sparkfun/3D_Models/production_parts/modules/Teensy-3_2/Renderings/Teensy_3_1 v12.png

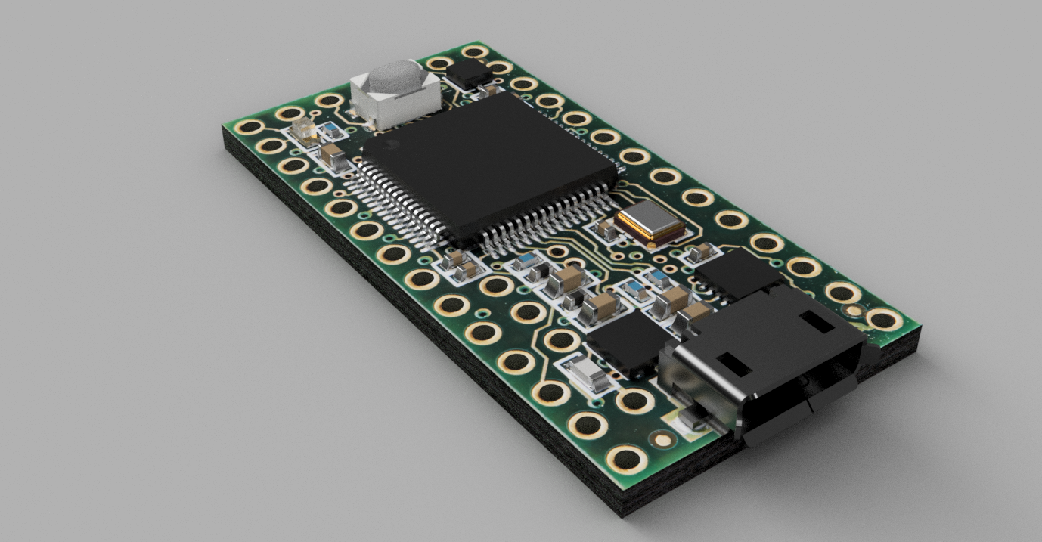
production_parts/modules/Teensy-3_2/Renderings/Teensy_3_1 v12.png
