sparkfun/3D_Models/production_parts/modules/Teensy-3_2/Teensy_3_1v13.png

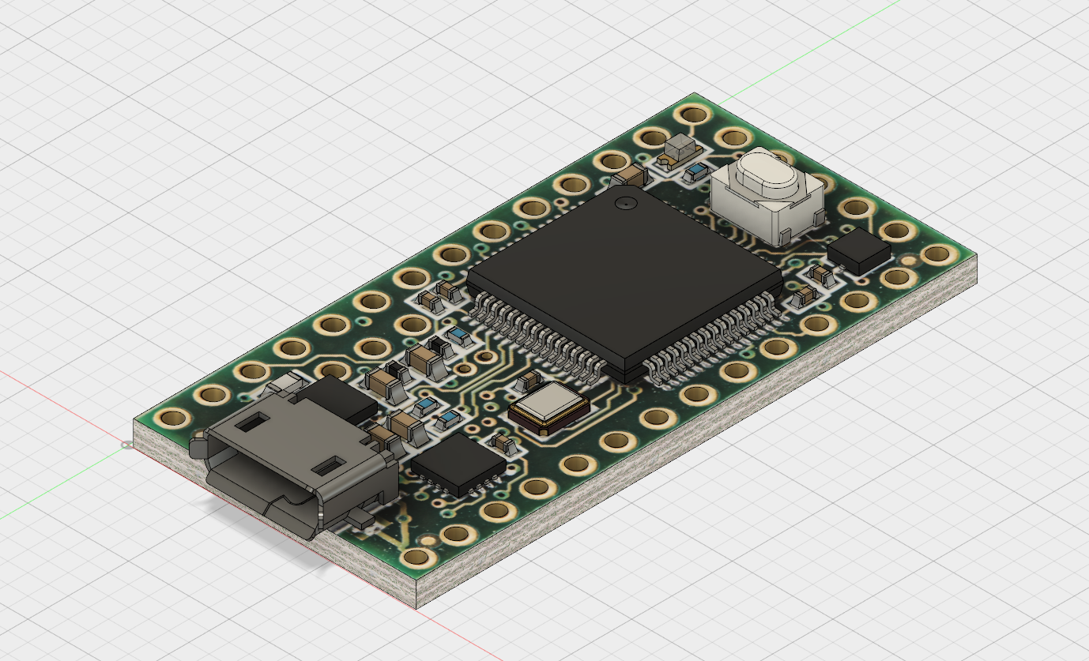
production_parts/modules/Teensy-3_2/Teensy_3_1v13.png
