sparkfun/3D_Models/products/8033/README.md

Models generated from [these file(s)](C:\Users\elizabeth.robert\Desktop\Button_Pad_Breakout-v05.brd) using EagleUp on 12/29/16 at 14:30:02 -07:00
