sparkfun/3D_Models/products/11231/README.md

Models generated from [these file(s)](C:\Users\elizabeth.robert\Documents\GitHub\3D_Models\products\11231\eagle_files\PowerCell-v13.brd) using EagleUp on 12/02/16 at 16:47:00 -07:00
