sparkfun/3D_Models/products/13907/README.md

Models generated from [these file(s)](https://raw.github.com/sparkfun/ESP32_Thing/ded18b5e48e4201424eeb1da74f5ced2d29fef45/Hardware/esp32-thing.brd) using EagleUp on 11/17/16 at 10:15:21 -07:00
