sparkfun/3D_Models/products/10217/README.md

Models generated from [these file(s)](https://raw.github.com/sparkfun/Lipo_Charger_Basic-microUSB/73710c1269a31963b9878e43a2877c6df5e5454a/Hardware/SparkFun_Lipo_Charger_Basic-microUSB.brd) using EagleUp on 03/23/16 at 19:31:33 -06:00
