sparkfun/3D_Models/products/10401/README.md

Models generated from [these file(s)](https://raw.github.com/sparkfun/Lipo_Charger_Basic-miniUSB/V_1.0/Hardware/SparkFun_LiPo-Charger-Basic-MiniUSB.brd) using EagleUp on 03/23/16 at 19:32:41 -06:00
