sparkfun/3D_Models/products/11113/README.md

Models generated from [these file(s)](http://raw.github.com/sparkfun/Arduino_Pro_Mini_328/365f073db730b88cd42f1180813b5a66018635e8/Hardware/Arduino-Pro-Mini.brd) using EagleUp on 03/23/16 at 19:43:11 -06:00
