sparkfun/3D_Models/products/11509/README.md

Models generated from [these file(s)](https://raw.github.com/sparkfun/Papilio_Button_LED_Wing/80d31db698f399345eacad574836a059138af1e3/Hardware/Papilio-Button_LED_Wing.brd) using EagleUp on 03/23/16 at 19:50:39 -06:00
