sparkfun/3D_Models/products/11520/README.md

Models generated from [these file(s)](https://raw.github.com/sparkfun/Fio_v3/9f33b3c5928f0053ad4ca1d304a4b5d24965248e/Hardware/Arduino-Fio.brd) using EagleUp on 03/23/16 at 19:52:38 -06:00
