sparkfun/3D_Models/products/12070/README.md

Models generated from [these file(s)](https://raw.github.com/sparkfun/Solder-able_Breadboard/30bd45b921a28740db06ccb94c362a1a8d5850fb/hardware/SIK-DIP-board.brd) using EagleUp on 03/23/16 at 20:11:49 -06:00
