sparkfun/3D_Models/products/13032/README.md

Models generated from [these file(s)](https://raw.github.com/sparkfun/Breadboard_Power_Supply_Stick_5V-3.3V/61db9993900f6341ecfdf4ad78172a0a0ff155b8/Hardware/SparkFun_Breadboard_Power_Supply-5v_3V_SMD.br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) using EagleUp on 03/23/16 at 20:48:52 -06:00
