sparkfun/3D_Models/products/13037/README.md

Models generated from [these file(s)](https://raw.github.com/sparkfun/Edison_Battery_Block/26c2c37ad96e5be5450ffc2b88f108fb3bff9484/Hardware/Battery_Block.brd) using EagleUp on 03/23/16 at 21:05:25 -06:00
