sparkfun/3D_Models/products/13157/README.md

Models generated from [these file(s)](https://raw.github.com/sparkfun/Breadboard_Power_Supply_Stick_3.3V-1.8V/e20de092731a95e48035bd819808cd0199bded37/Hardware/SparkFun_Breadboard_Power_Supply-3.3-1.8SMD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) using EagleUp on 03/23/16 at 21:53:40 -06:00
