sparkfun/3D_Models/products/258/geometry_edit_blender/Serial_20LCD_20Backpack_20v28_top_board.png

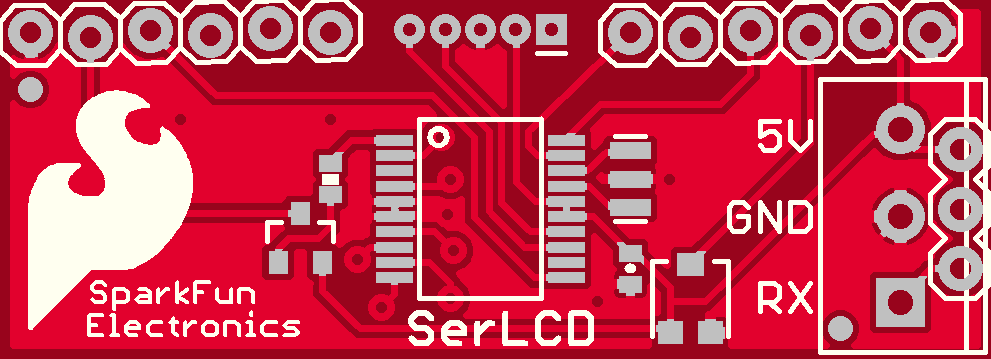
products/258/geometry_edit_blender/Serial_20LCD_20Backpack_20v28_top_board.png
