sparkfun/3D_Models/products/338/renderings/top2.png

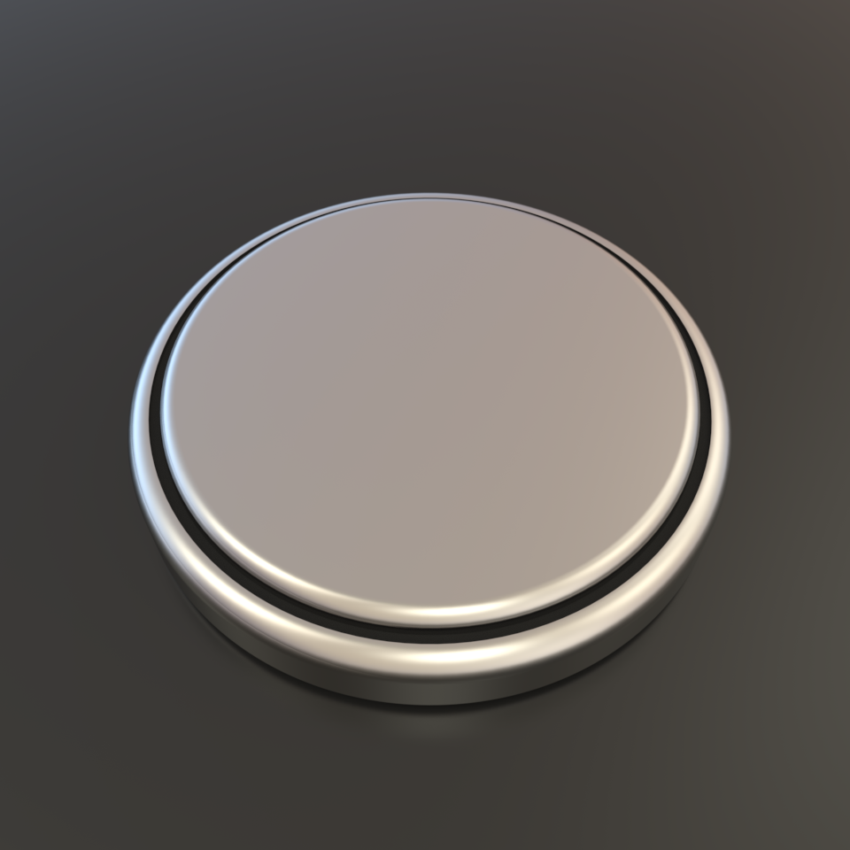
products/338/renderings/top2.png
