sparkfun/3D_Models/products/449/display/449_top.png

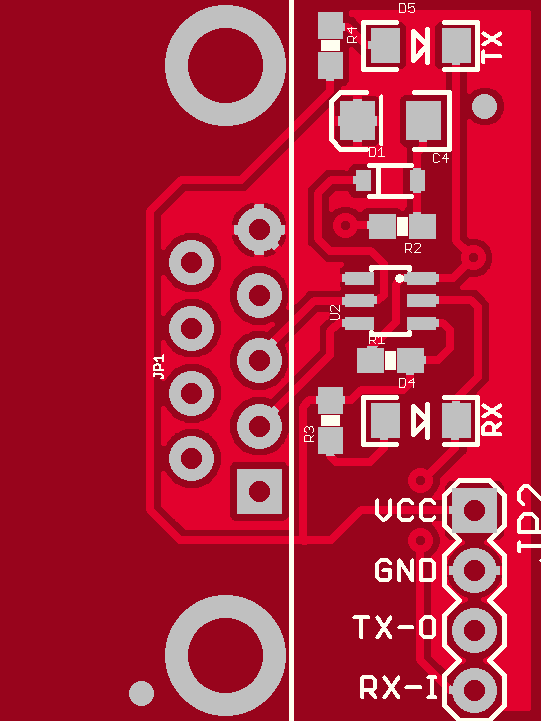
products/449/display/449_top.png
