sparkfun/3D_Models/products/449/display/Sparkfun_RS232_bottom_board.png

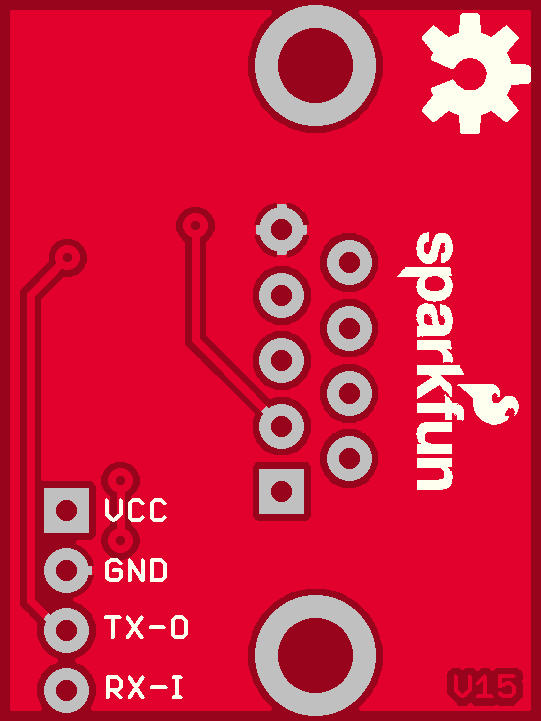
products/449/display/Sparkfun_RS232_bottom_board.png
