sparkfun/3D_Models/products/494/display/bottom.png

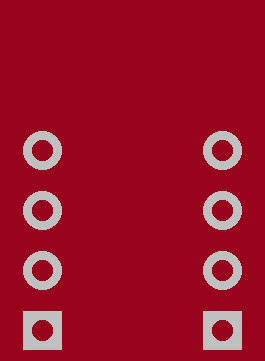
products/494/display/bottom.png
