sparkfun/3D_Models/products/494/display/top.png

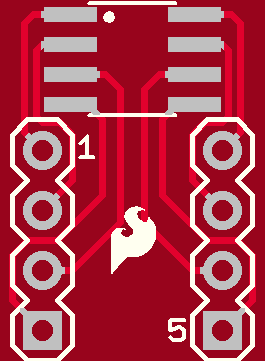
products/494/display/top.png
