sparkfun/3D_Models/products/495/display/top.png

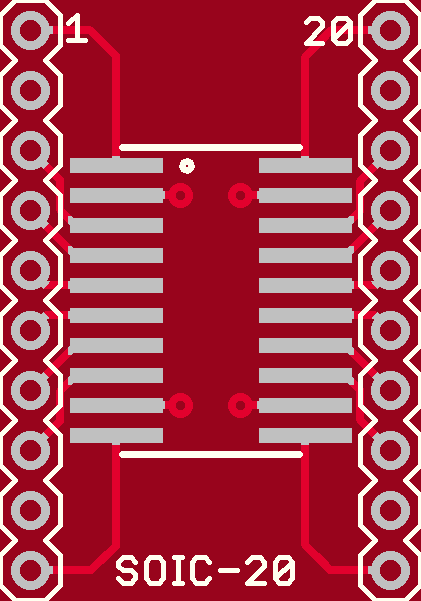
products/495/display/top.png
