sparkfun/3D_Models/products/496/geometry_edit_blender/bottom.png

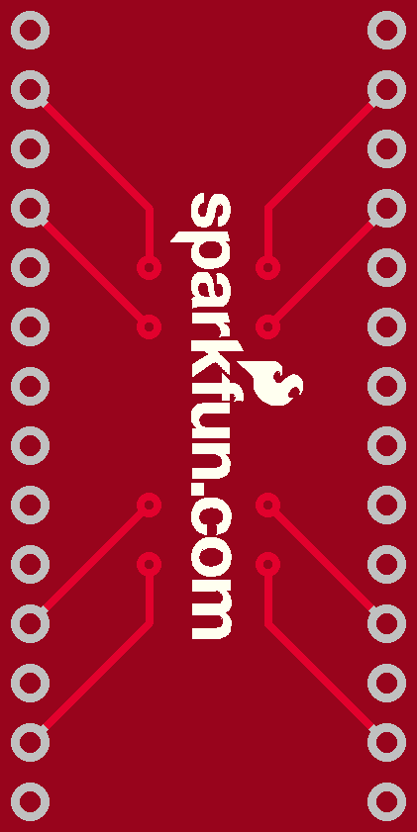
products/496/geometry_edit_blender/bottom.png
