sparkfun/3D_Models/products/497/display/bottom.png

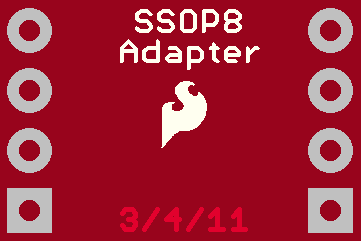
products/497/display/bottom.png
