sparkfun/3D_Models/products/497/display/top.png

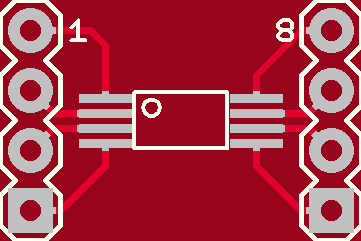
products/497/display/top.png
