sparkfun/3D_Models/products/498/display/SparkFun_SSOP16_Breakout_v10_top_board.png

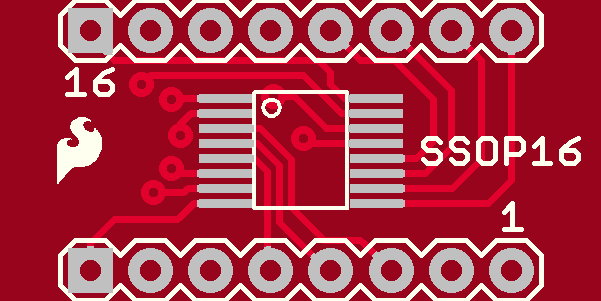
products/498/display/SparkFun_SSOP16_Breakout_v10_top_board.png
