sparkfun/3D_Models/products/498/geometry_edit_blender/SparkFun_SSOP16_Breakout_v10_bottom_board.png

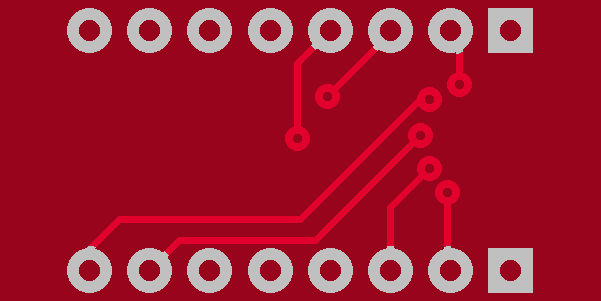
products/498/geometry_edit_blender/SparkFun_SSOP16_Breakout_v10_bottom_board.png
