sparkfun/3D_Models/products/499/display/SparkFun_Adapter_SSOP20_v10_bottom_board.png

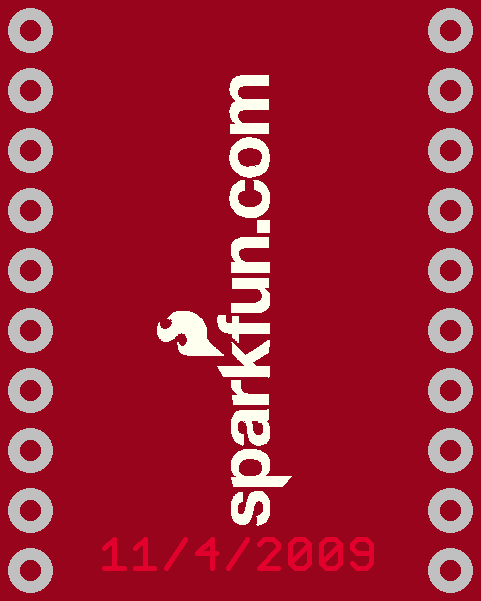
products/499/display/SparkFun_Adapter_SSOP20_v10_bottom_board.png
