sparkfun/3D_Models/products/500/display/SparkFun_SSOP28_DIP_Adapter_v12_bottom_board.png

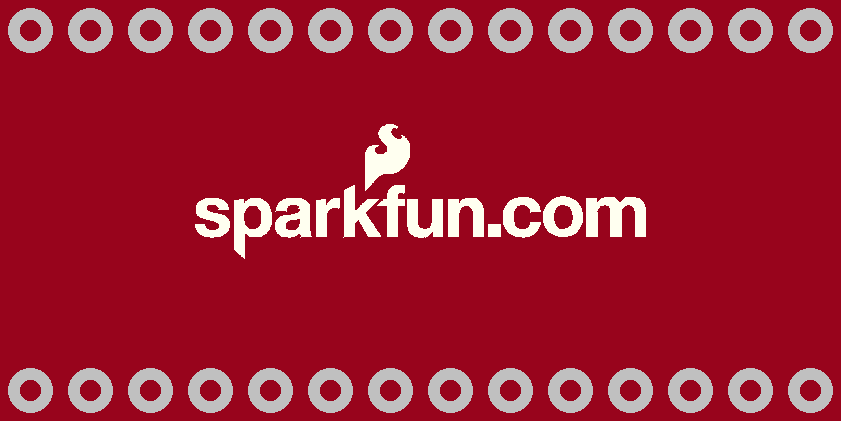
products/500/display/SparkFun_SSOP28_DIP_Adapter_v12_bottom_board.png
