sparkfun/3D_Models/products/544/display/SparkFun_microSD_Breakout_top_board.png

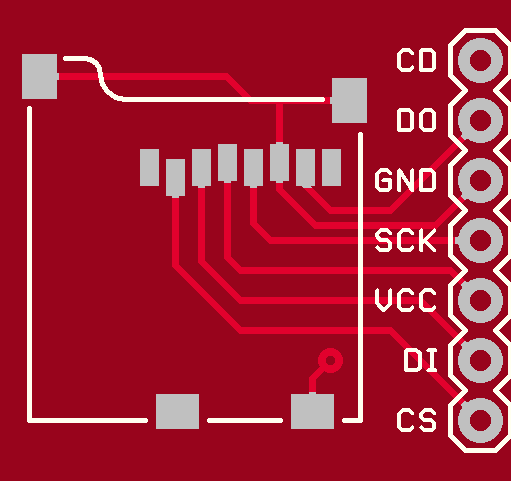
products/544/display/SparkFun_microSD_Breakout_top_board.png
