sparkfun/3D_Models/products/573/display/Sim_Breakout_bottom_board.png

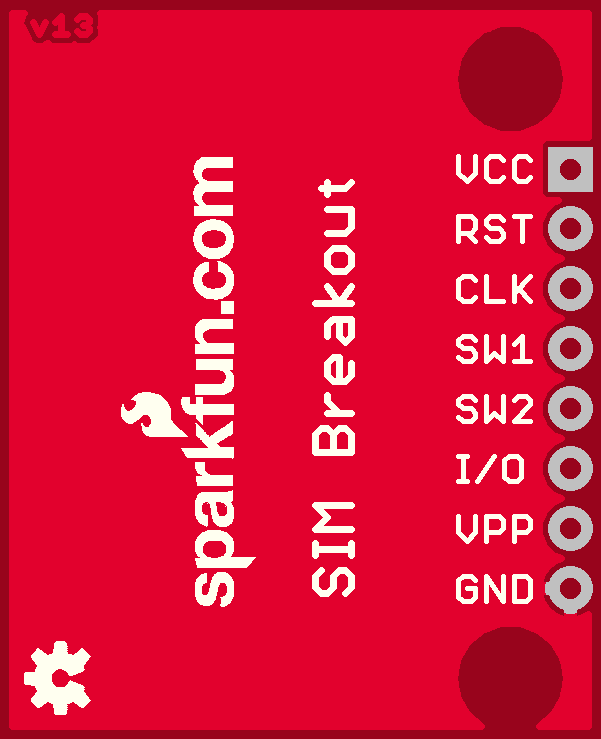
products/573/display/Sim_Breakout_bottom_board.png
