sparkfun/3D_Models/products/691/display/SparkFun_Tranceiver_Breakout_nRF24L01_bottom_board.png

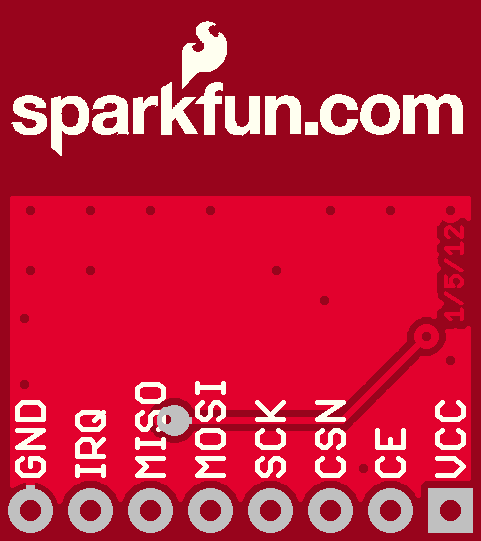
products/691/display/SparkFun_Tranceiver_Breakout_nRF24L01_bottom_board.png
