sparkfun/3D_Models/products/716/display/bottom.png

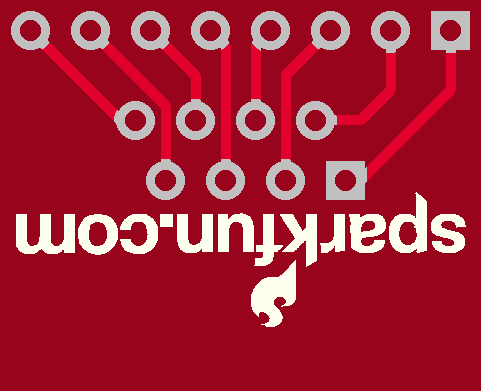
products/716/display/bottom.png
