sparkfun/3D_Models/products/717/display/SparkFun_SOT23_DIP_Adapter_v10_bottom_board.png

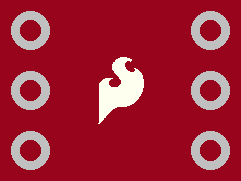
products/717/display/SparkFun_SOT23_DIP_Adapter_v10_bottom_board.png
