sparkfun/3D_Models/products/762/display/USB_Bit_Whacker_18F2553_top_board.png

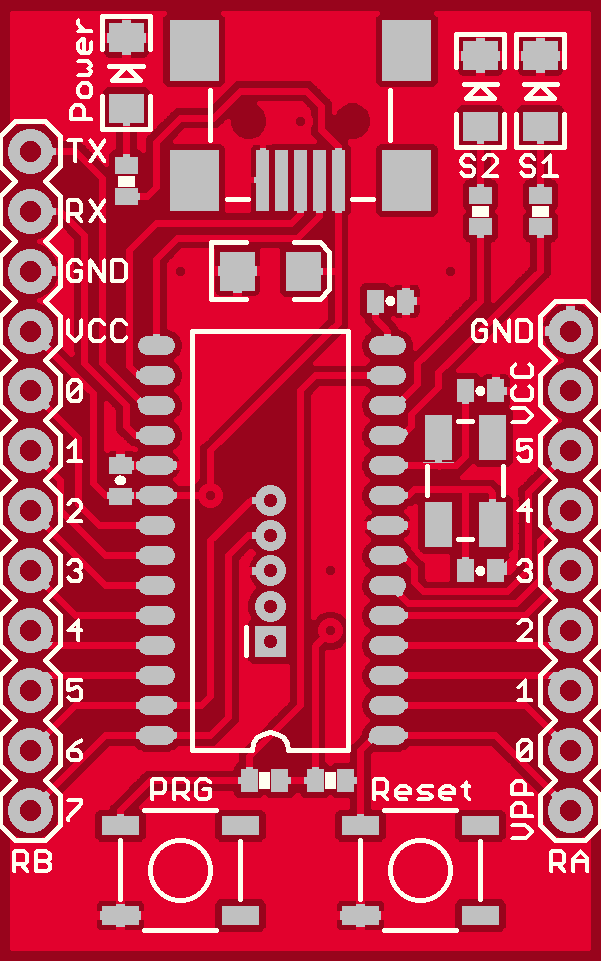
products/762/display/USB_Bit_Whacker_18F2553_top_board.png
