sparkfun/3D_Models/products/8467/display/SparkFun_LilyPad_Tricolor_LED_top_board.png

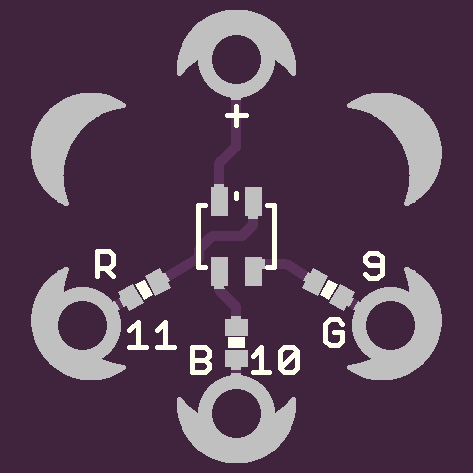
products/8467/display/SparkFun_LilyPad_Tricolor_LED_top_board.png
