sparkfun/3D_Models/products/8552/display/SparkFun_Serial_DB9_Breakout_v13_top_board.png

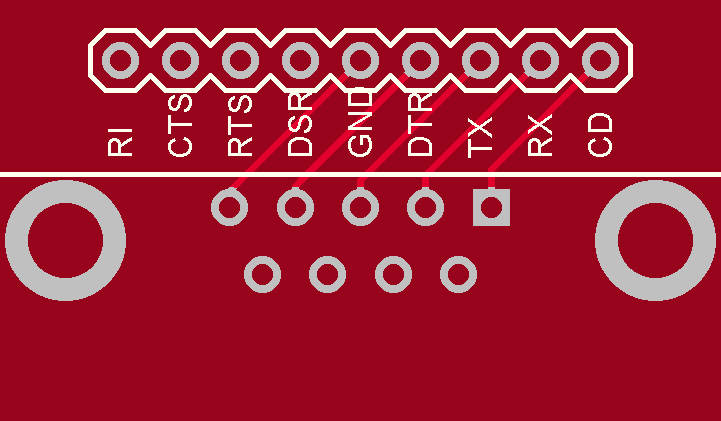
products/8552/display/SparkFun_Serial_DB9_Breakout_v13_top_board.png
