sparkfun/3D_Models/products/8552/geometry_edit_blender/SparkFun_Serial_DB9_Breakout_v13_bottom_board.png

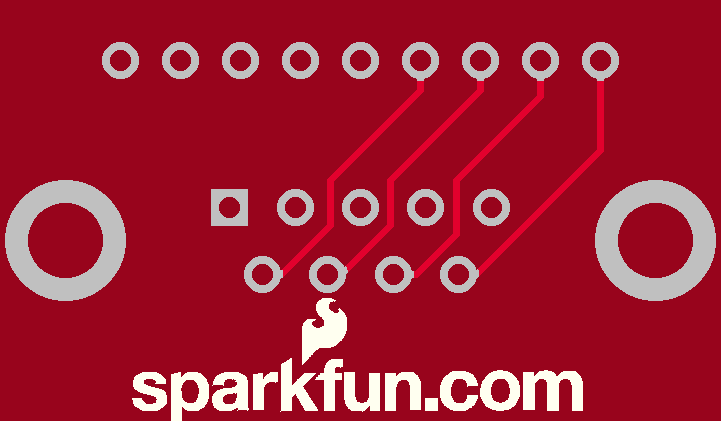
products/8552/geometry_edit_blender/SparkFun_Serial_DB9_Breakout_v13_bottom_board.png
