sparkfun/3D_Models/products/8688/display/SparkFun_TEMT6000_Breakout_v12_top_board.png

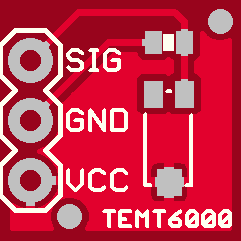
products/8688/display/SparkFun_TEMT6000_Breakout_v12_top_board.png
