sparkfun/3D_Models/products/8776/geometry_edit_blender/SparkFun_LilyPad_Button_bottom_board.png

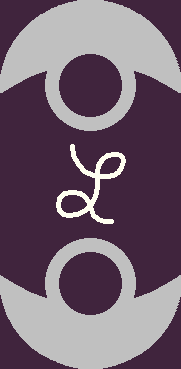
products/8776/geometry_edit_blender/SparkFun_LilyPad_Button_bottom_board.png
