sparkfun/3D_Models/products/8883/display/SparkFun_ACS712LowCurrentSensorBoard_bottom_board.png

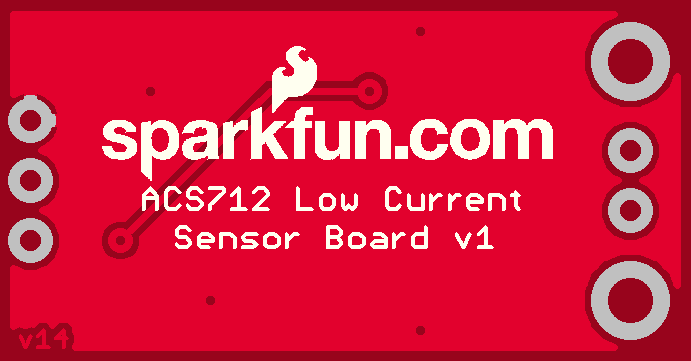
products/8883/display/SparkFun_ACS712LowCurrentSensorBoard_bottom_board.png
