sparkfun/3D_Models/products/8891/display/Gas_Sensor_Breakout_v12_top_board.png

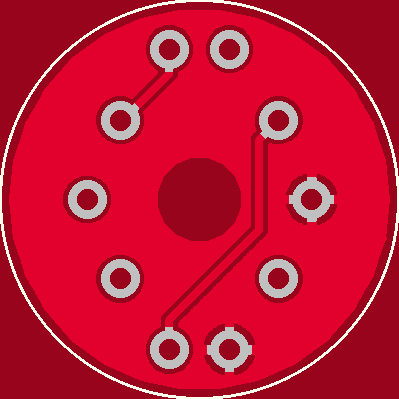
products/8891/display/Gas_Sensor_Breakout_v12_top_board.png
