sparkfun/3D_Models/products/8891/geometry_edit_blender/Gas_Sensor_Breakout_v12_bottom_board.png

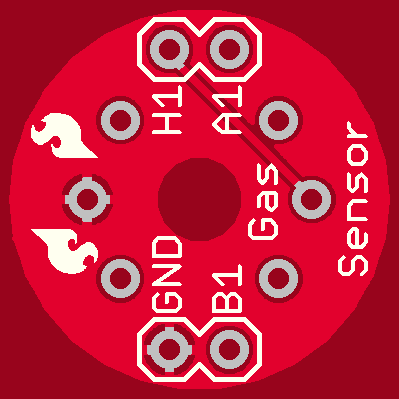
products/8891/geometry_edit_blender/Gas_Sensor_Breakout_v12_bottom_board.png
