sparkfun/3D_Models/products/9109/geometry_edit_blender/bottom.png

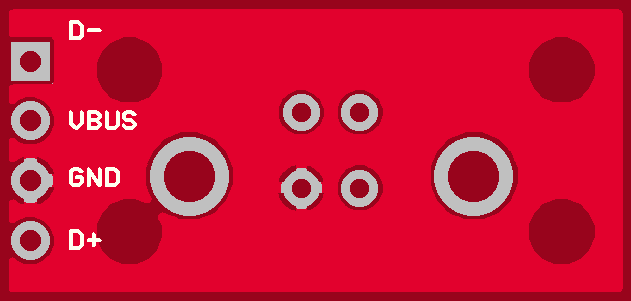
products/9109/geometry_edit_blender/bottom.png
