sparkfun/3D_Models/products/9118/geometry_edit_blender/top.png

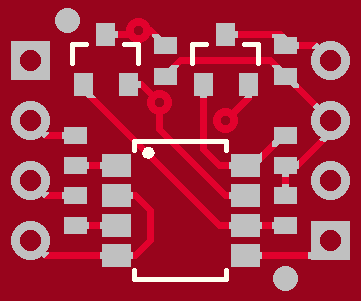
products/9118/geometry_edit_blender/top.png
