sparkfun/3D_Models/products/9269/display/board_bottom.png

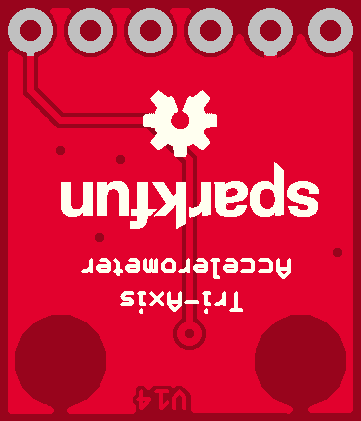
products/9269/display/board_bottom.png
