sparkfun/3D_Models/products/9269/geometry_edit_blender/board_top.png

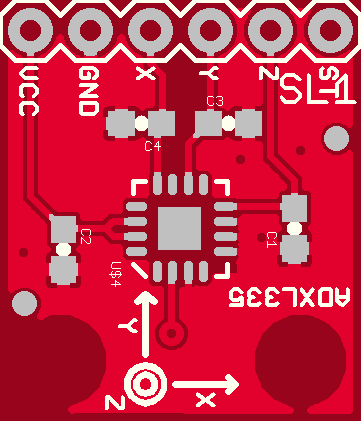
products/9269/geometry_edit_blender/board_top.png
