sparkfun/3D_Models/products/9277/geometry_edit_blender/M_2x2Button_Pad_Breakout_v01_bottom_board.png

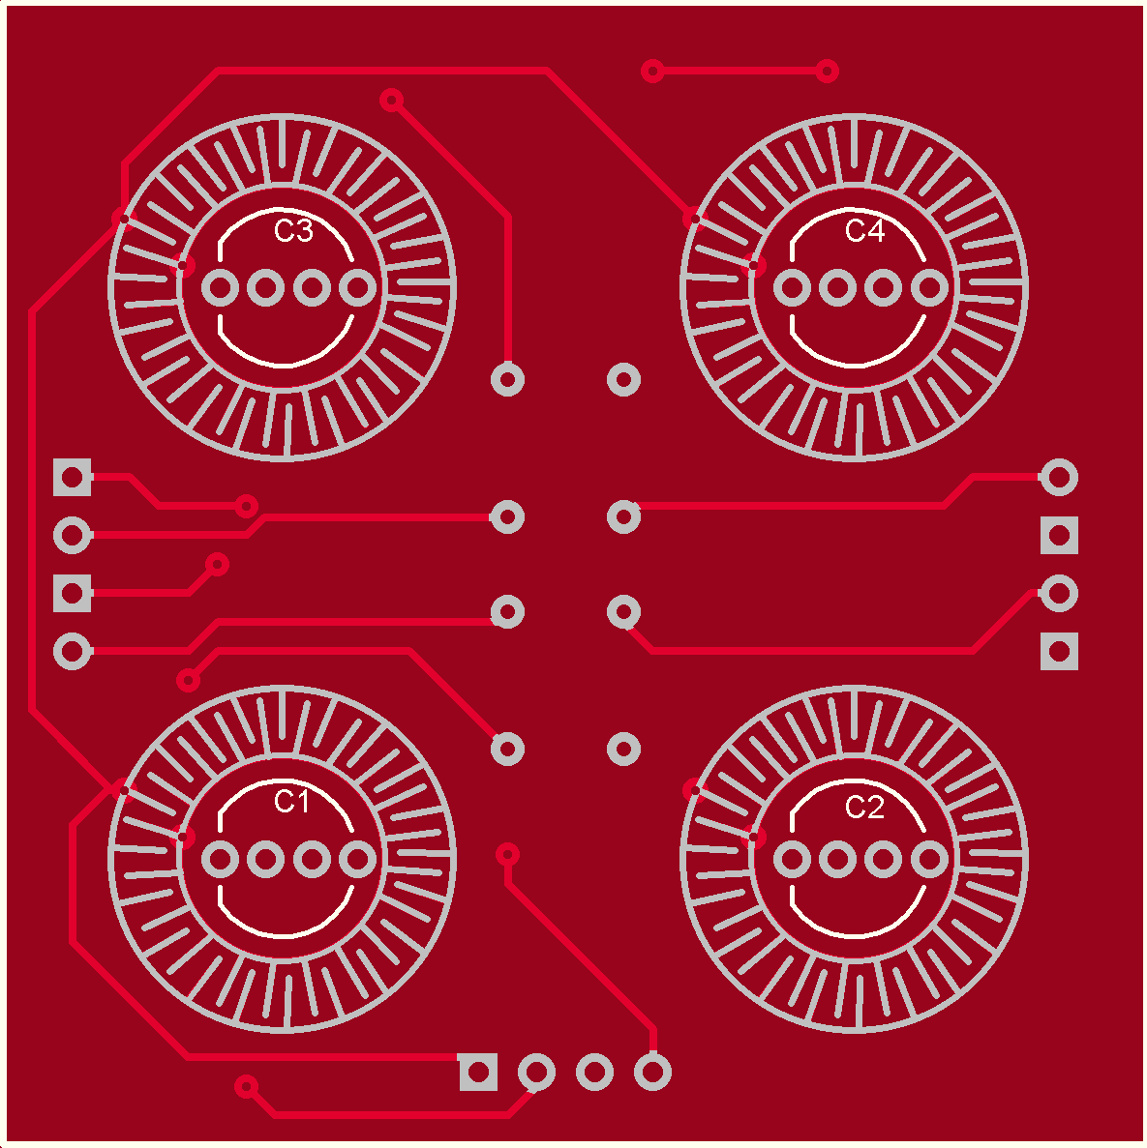
products/9277/geometry_edit_blender/M_2x2Button_Pad_Breakout_v01_bottom_board.png
