sparkfun/3D_Models/products/9322/display/PhotoInterrupter_Breakout_bottom_board.png

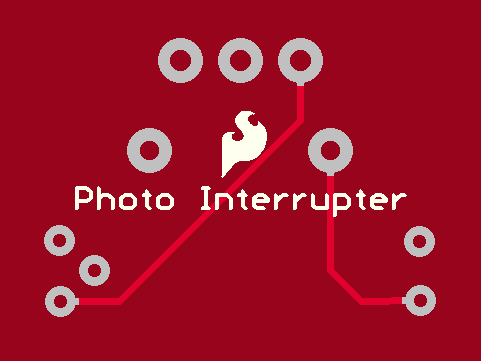
products/9322/display/PhotoInterrupter_Breakout_bottom_board.png
