sparkfun/3D_Models/products/9352/geometry_edit_blender/Graphic_20LCD_20Backpack_bottom_board.png

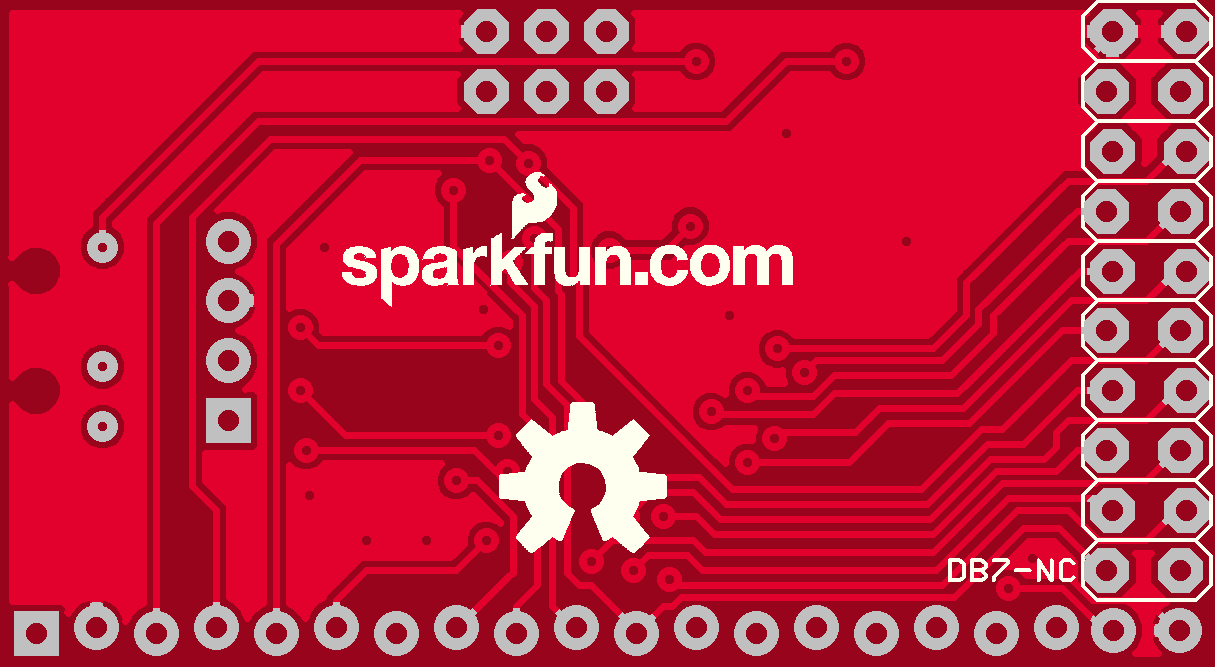
products/9352/geometry_edit_blender/Graphic_20LCD_20Backpack_bottom_board.png
