sparkfun/3D_Models/products/9457/geometry_edit_blender/SparkFun_Motor_Driver_TB6612FNG_top_board.png

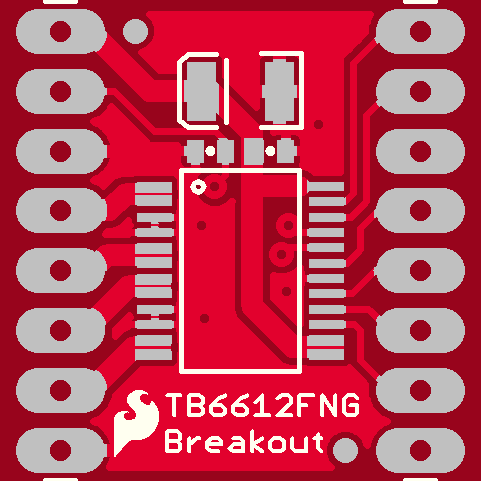
products/9457/geometry_edit_blender/SparkFun_Motor_Driver_TB6612FNG_top_board.png
