sparkfun/3D_Models/products/9530/display/OpenLog_bottom_board.png

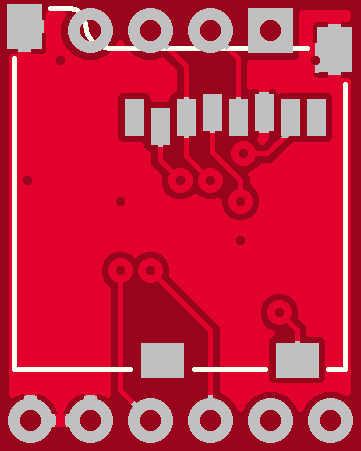
products/9530/display/OpenLog_bottom_board.png
