sparkfun/3D_Models/products/9530/display/OpenLog_top_board.png

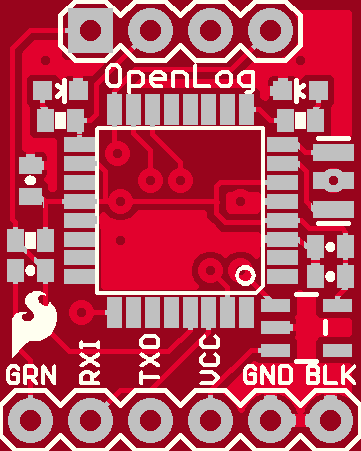
products/9530/display/OpenLog_top_board.png
