sparkfun/3D_Models/products/9540/display/bottom.png

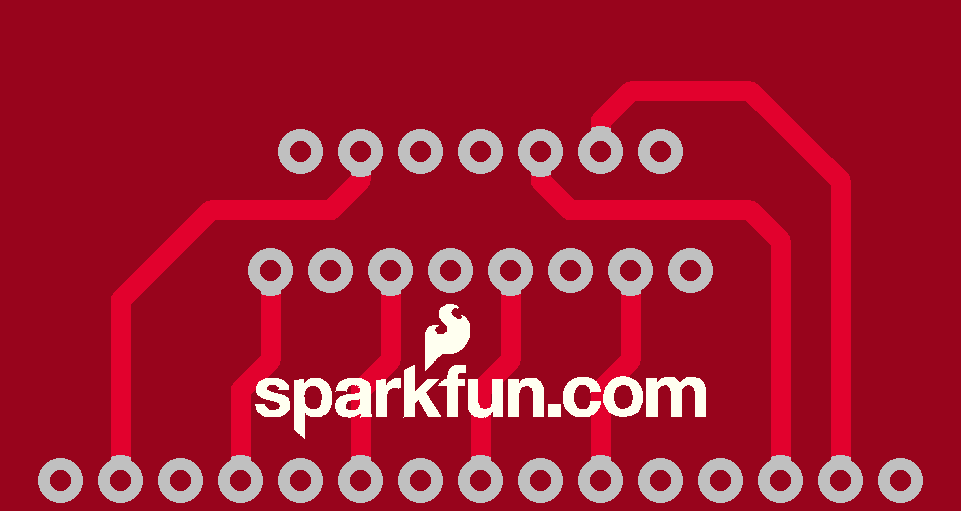
products/9540/display/bottom.png
