sparkfun/3D_Models/products/9544/display/BusPirate_v36_top_board.png

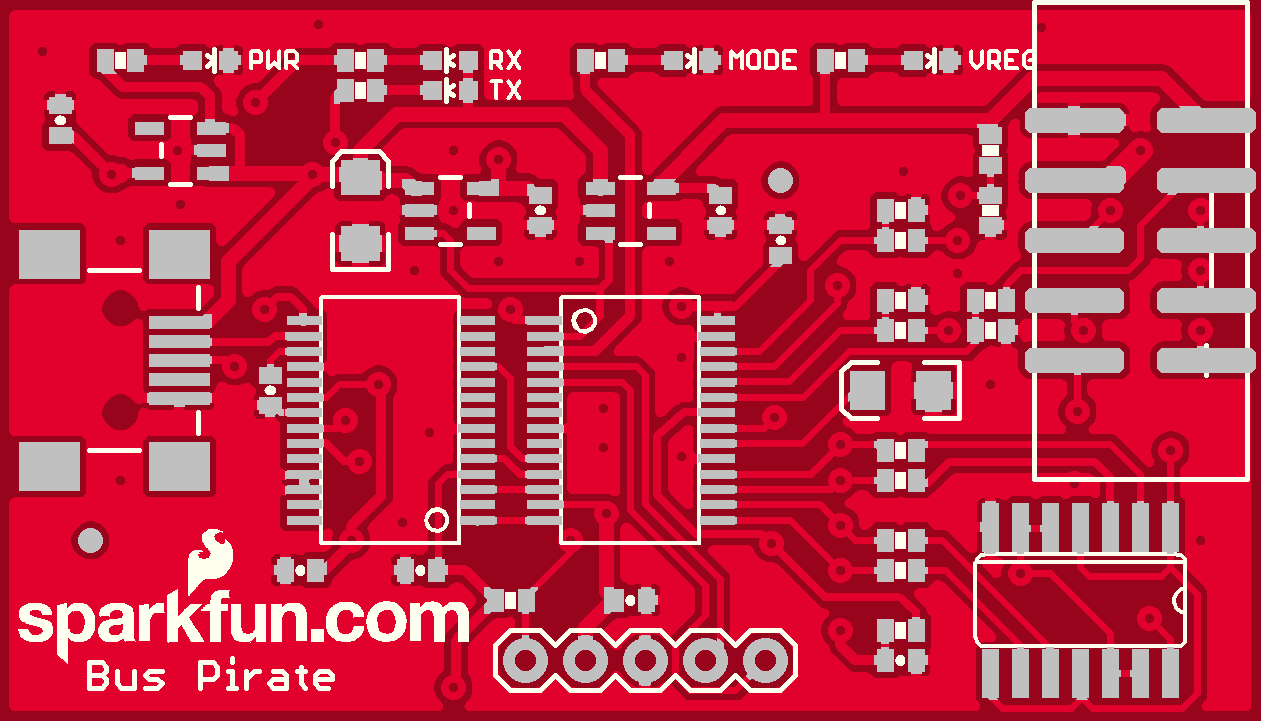
products/9544/display/BusPirate_v36_top_board.png
