sparkfun/3D_Models/products/9565/display/MPR121_Breakout_v13_bottom_board.png

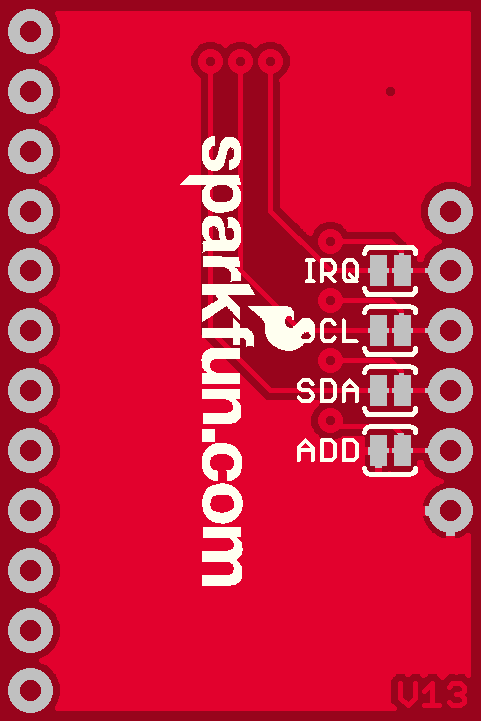
products/9565/display/MPR121_Breakout_v13_bottom_board.png
