sparkfun/3D_Models/products/9565/geometry_edit_blender/MPR121_Breakout_v13_top_board.png

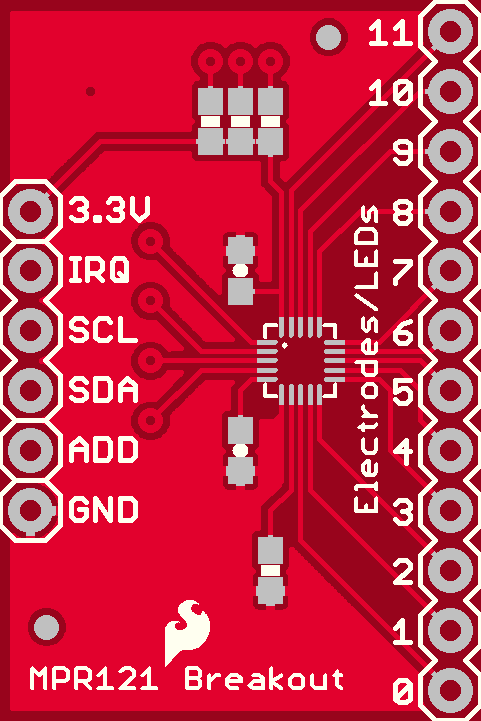
products/9565/geometry_edit_blender/MPR121_Breakout_v13_top_board.png
