sparkfun/3D_Models/products/9716/display/FTDI_20Basic_5V_bottom_board.png

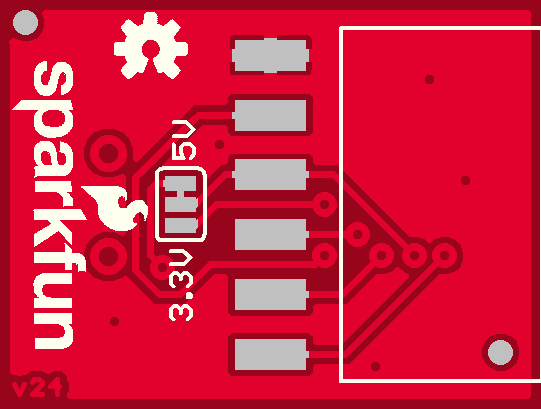
products/9716/display/FTDI_20Basic_5V_bottom_board.png
