sparkfun/3D_Models/products/9716/geometry_edit_blender/FTDI_20Basic_5V_top_board.png

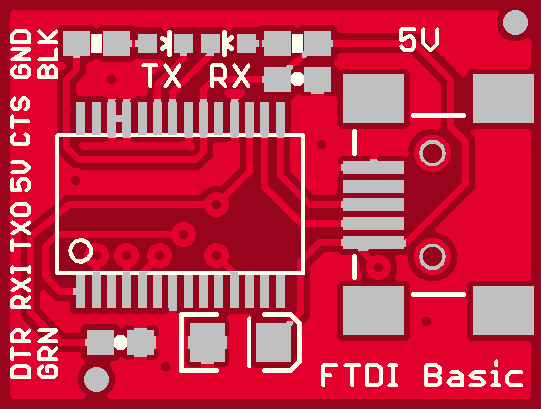
products/9716/geometry_edit_blender/FTDI_20Basic_5V_top_board.png
