sparkfun/3D_Models/products/9816/geometry_edit_blender/eagleUp_SparkFun_OpAmp_Breakout_LMV358_bottom_board.png

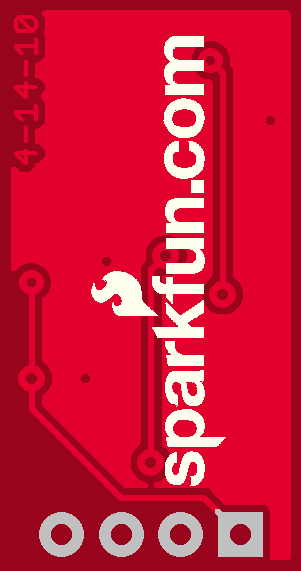
products/9816/geometry_edit_blender/eagleUp_SparkFun_OpAmp_Breakout_LMV358_bottom_board.png
