sparkfun/3D_Models/products/9825/display/AVR_Pocket_Programmer_bottom_board.png

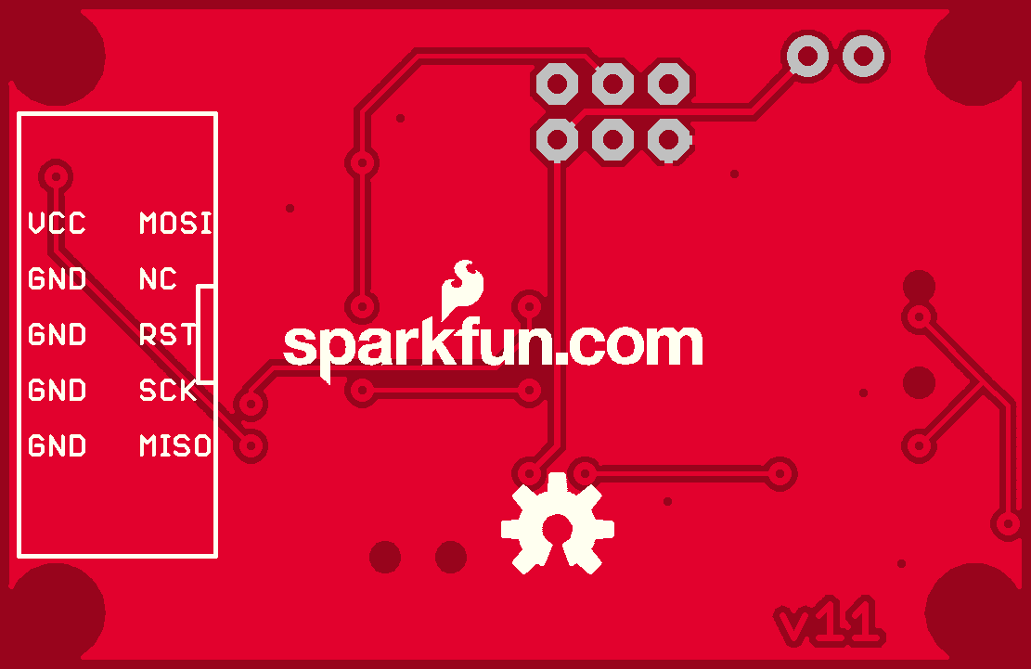
products/9825/display/AVR_Pocket_Programmer_bottom_board.png
