sparkfun/3D_Models/products/9966/display/SparkFun_miniUSB_Breakout_v13_top_board.png

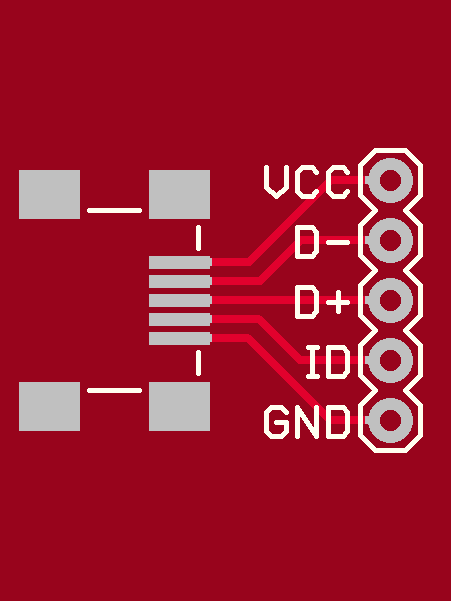
products/9966/display/SparkFun_miniUSB_Breakout_v13_top_board.png
