sparkfun/3D_Models/products/9966/geometry_edit_blender/SparkFun_miniUSB_Breakout_v13_bottom_board.png

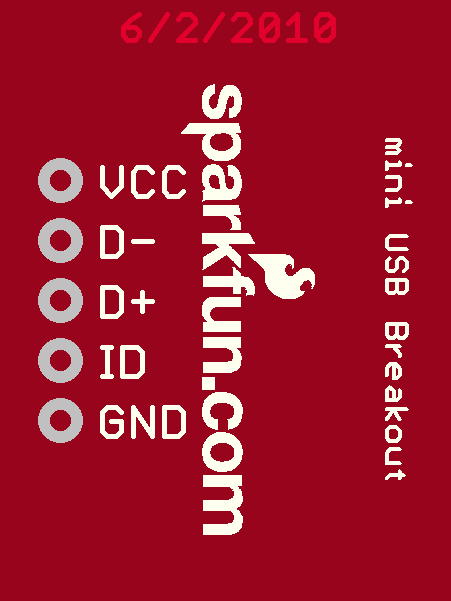
products/9966/geometry_edit_blender/SparkFun_miniUSB_Breakout_v13_bottom_board.png
