sparkfun/3D_Models/products/10124/display/RS485_Breakout_top_board.png

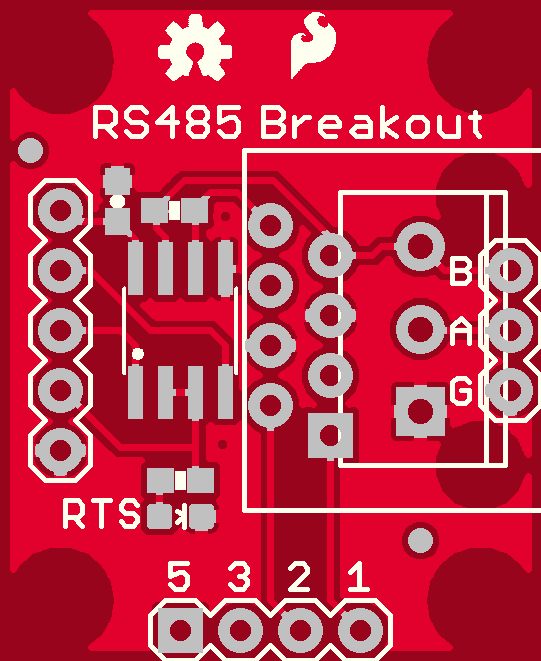
products/10124/display/RS485_Breakout_top_board.png
