sparkfun/3D_Models/products/10217/display/SparkFun_Lipo_Charger_Basic_microUSB_bottom_board.png

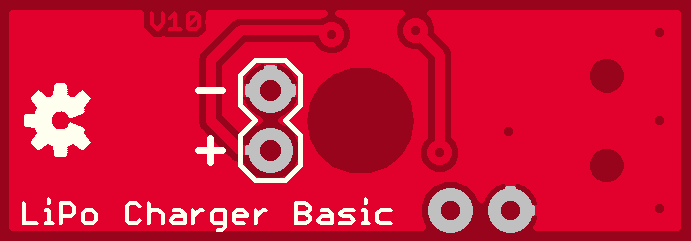
products/10217/display/SparkFun_Lipo_Charger_Basic_microUSB_bottom_board.png
