sparkfun/3D_Models/products/10401/display/SparkFun_LiPo_Charger_Basic_MiniUSB_top_board.png

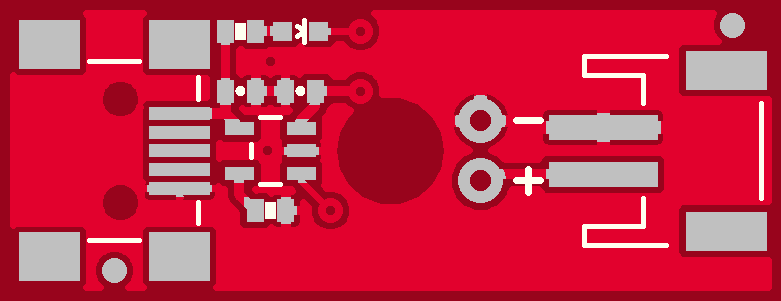
products/10401/display/SparkFun_LiPo_Charger_Basic_MiniUSB_top_board.png
