sparkfun/3D_Models/products/10419/display/xbee.jpg

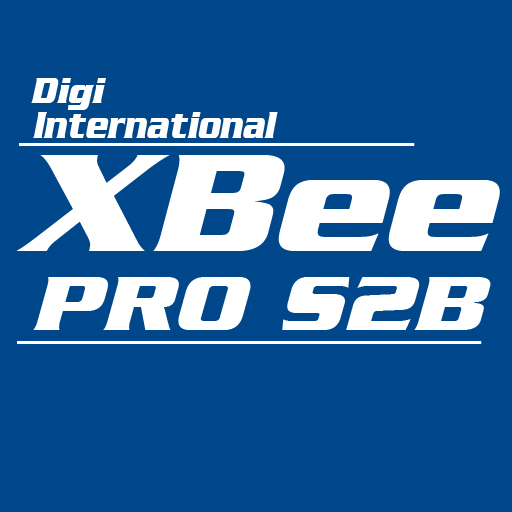
products/10419/display/xbee.jpg
