sparkfun/3D_Models/products/10467/display/bottom.png

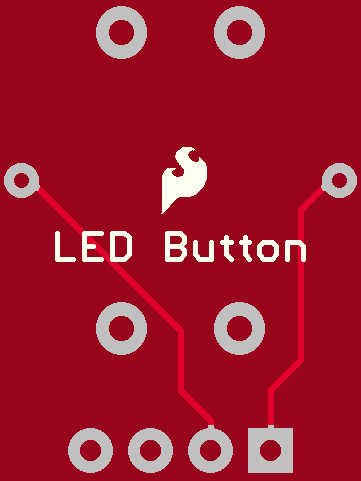
products/10467/display/bottom.png
