sparkfun/3D_Models/products/10467/geometry_edit_blender/top.png

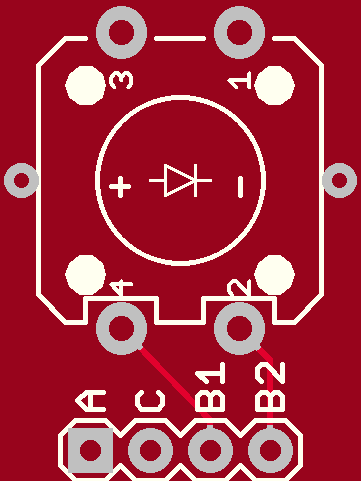
products/10467/geometry_edit_blender/top.png
