sparkfun/3D_Models/products/10495/geometry_edit_blender/top.png

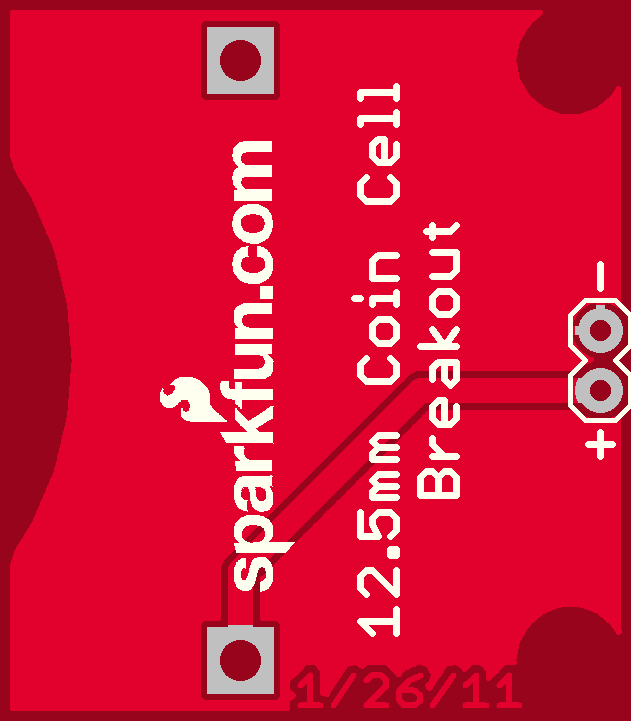
products/10495/geometry_edit_blender/top.png
