sparkfun/3D_Models/products/10680/geometry_edit_blender/top.png

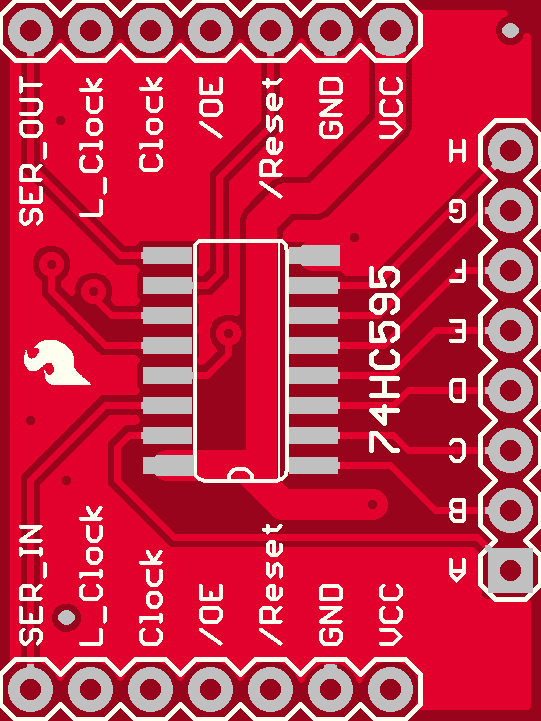
products/10680/geometry_edit_blender/top.png
