sparkfun/3D_Models/products/10736/geometry_edit_blender/M_9DOF_Razor_v23_top_board.png

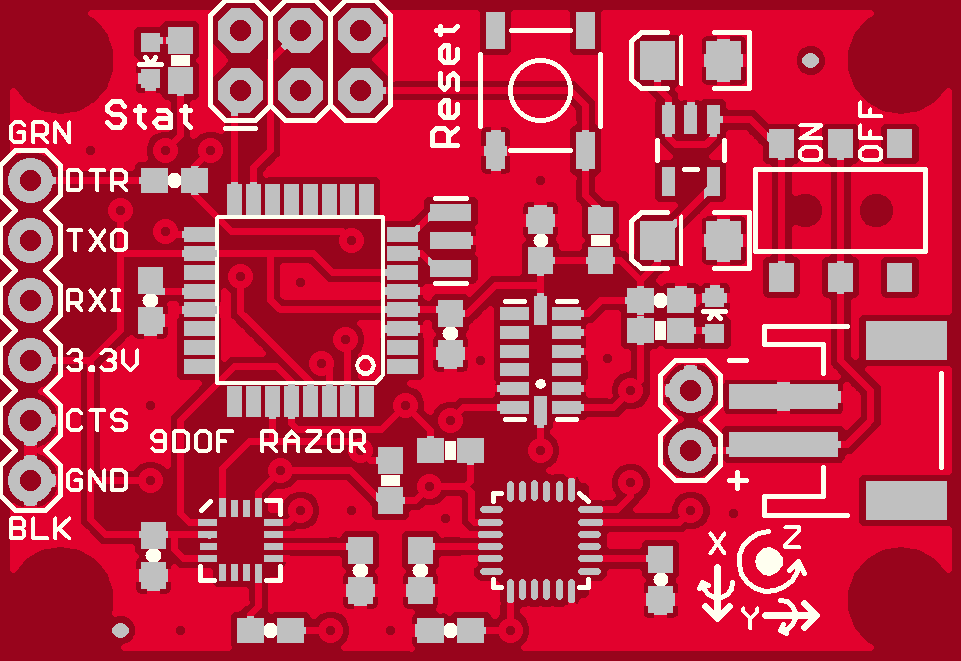
products/10736/geometry_edit_blender/M_9DOF_Razor_v23_top_board.png
