sparkfun/3D_Models/products/10804/geometry_edit_blender/BreadboardPowerSupply_SMDv13_top_board.png

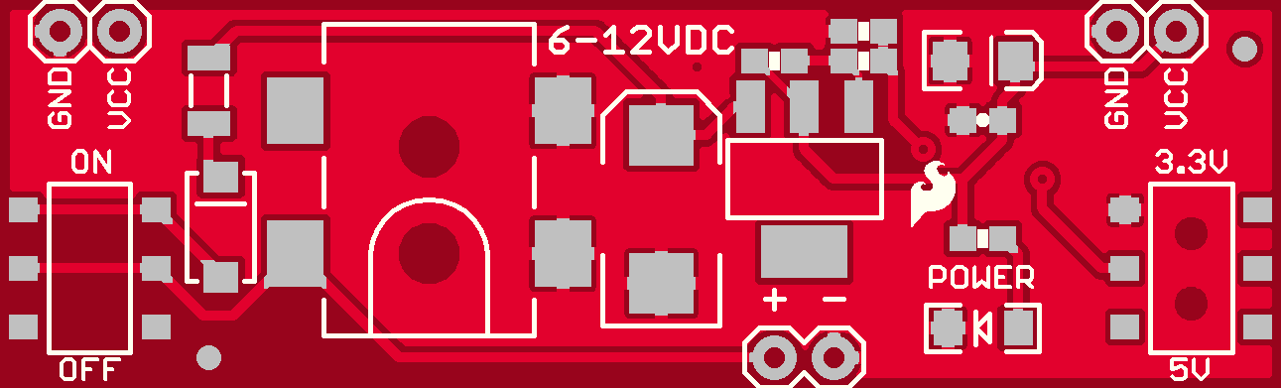
products/10804/geometry_edit_blender/BreadboardPowerSupply_SMDv13_top_board.png
