sparkfun/3D_Models/products/10899/geometry_edit_blender/LilyTiny_bottom_board.png

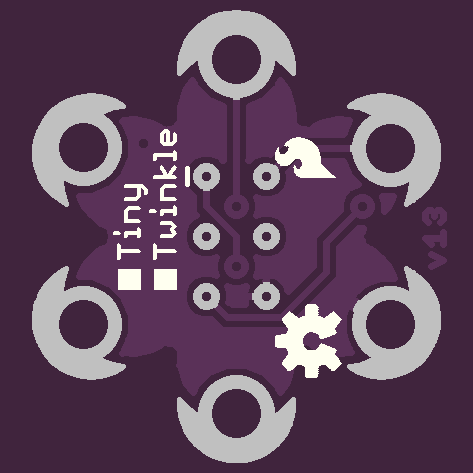
products/10899/geometry_edit_blender/LilyTiny_bottom_board.png
