sparkfun/3D_Models/products/10934/display/BreadboardPowerSupplyStick1_8V_v10ass_top_board.png

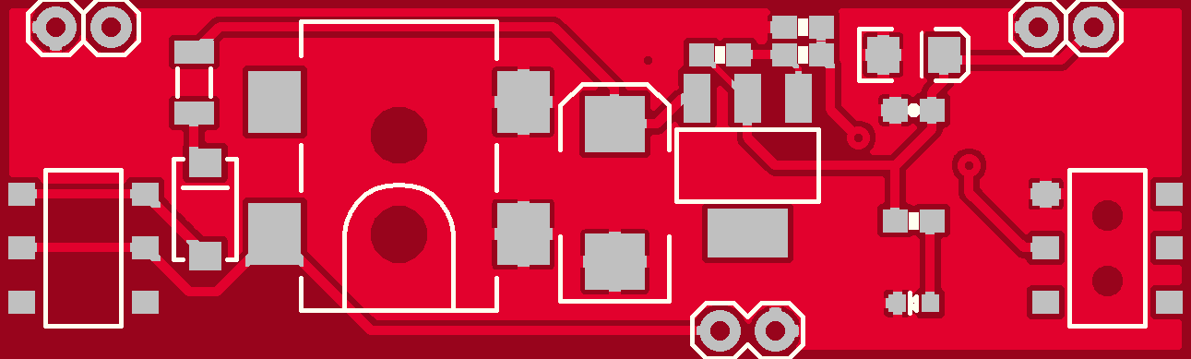
products/10934/display/BreadboardPowerSupplyStick1_8V_v10ass_top_board.png
