sparkfun/3D_Models/products/10934/geometry_edit_blender/BreadboardPowerSupplyStick1_8V_v10ass_bottom_board.png

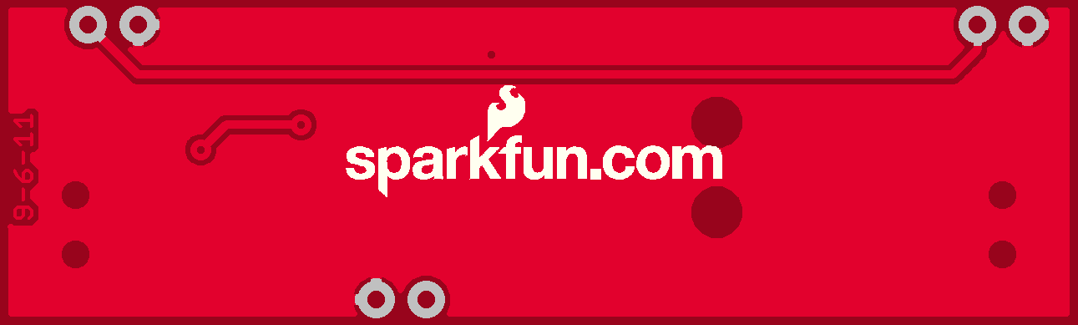
products/10934/geometry_edit_blender/BreadboardPowerSupplyStick1_8V_v10ass_bottom_board.png
