sparkfun/3D_Models/products/10938/geometry_edit_blender/BlueSMiRF_ChipAnt_top_board.png

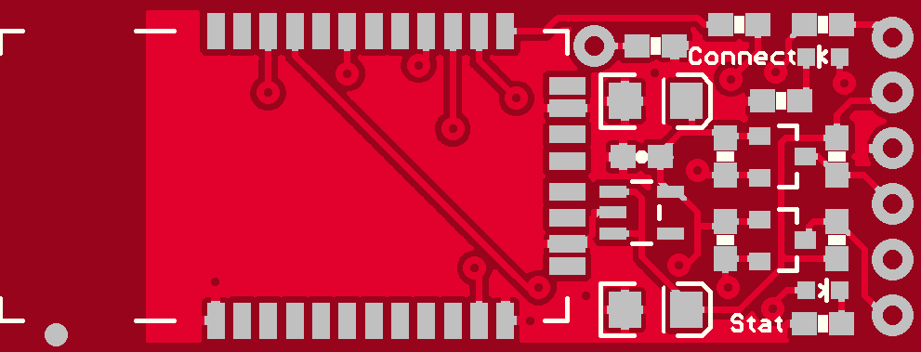
products/10938/geometry_edit_blender/BlueSMiRF_ChipAnt_top_board.png
