sparkfun/3D_Models/products/11028/display/Triple_Axis_Accelerometer___Gyro_Breakout___MPU_6050_top_board.png

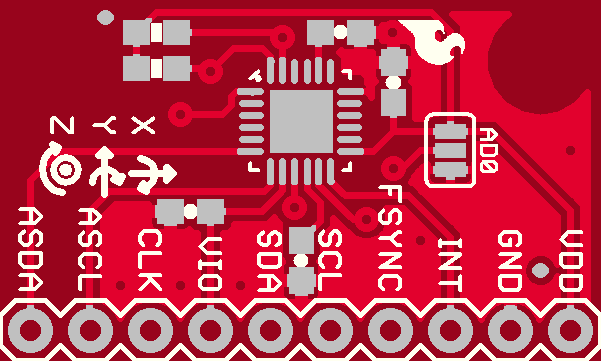
products/11028/display/Triple_Axis_Accelerometer___Gyro_Breakout___MPU_6050_top_board.png
