sparkfun/3D_Models/products/11028/geometry_edit_blender/Triple_Axis_Accelerometer___Gyro_Breakout___MPU_6050_bottom_board.png

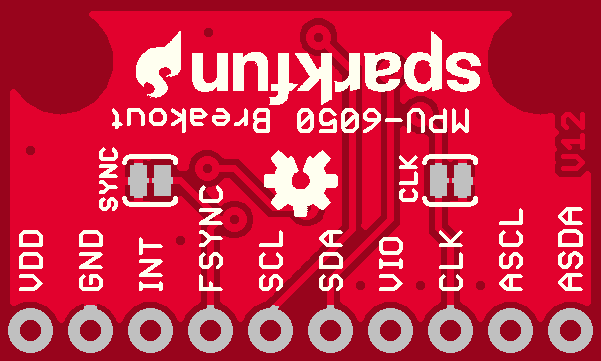
products/11028/geometry_edit_blender/Triple_Axis_Accelerometer___Gyro_Breakout___MPU_6050_bottom_board.png
