sparkfun/3D_Models/products/11114/geometry_edit_blender/Arduino_Pro_Mini_bottom_board.png

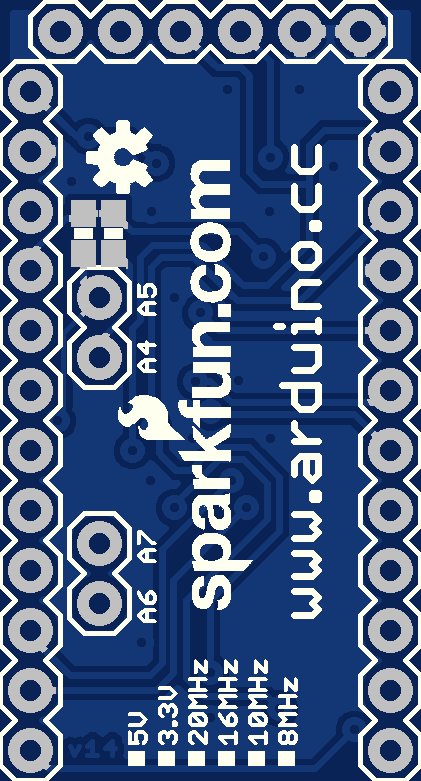
products/11114/geometry_edit_blender/Arduino_Pro_Mini_bottom_board.png
