sparkfun/3D_Models/products/11189/geometry_edit_blender/SparkFun_MAX3232_Breakout_bottom_board.png

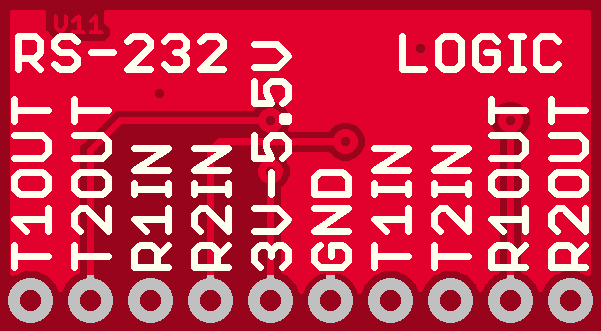
products/11189/geometry_edit_blender/SparkFun_MAX3232_Breakout_bottom_board.png
