sparkfun/3D_Models/products/11373/display/XBee_Regulated_bottom_board.png

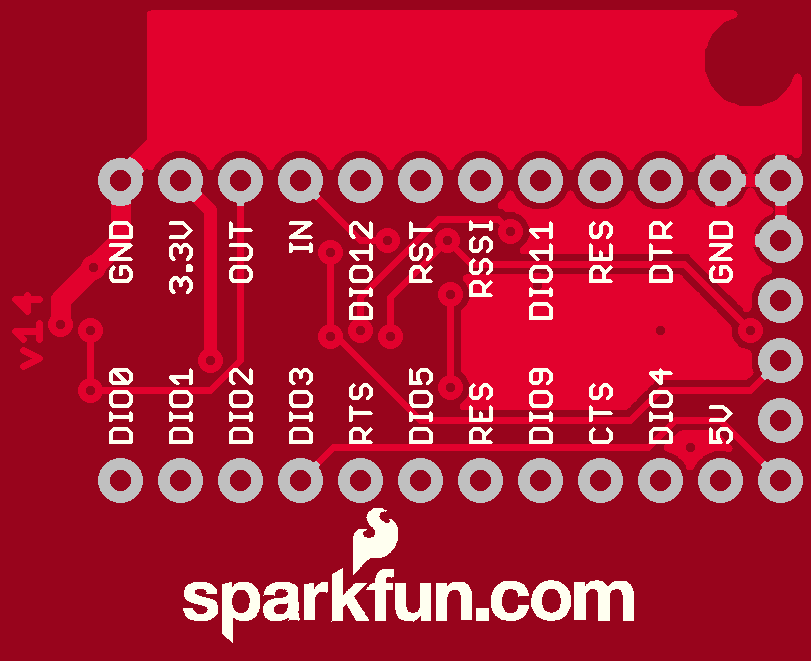
products/11373/display/XBee_Regulated_bottom_board.png
