sparkfun/3D_Models/products/11373/geometry_edit_blender/XBee_Regulated_top_board.png

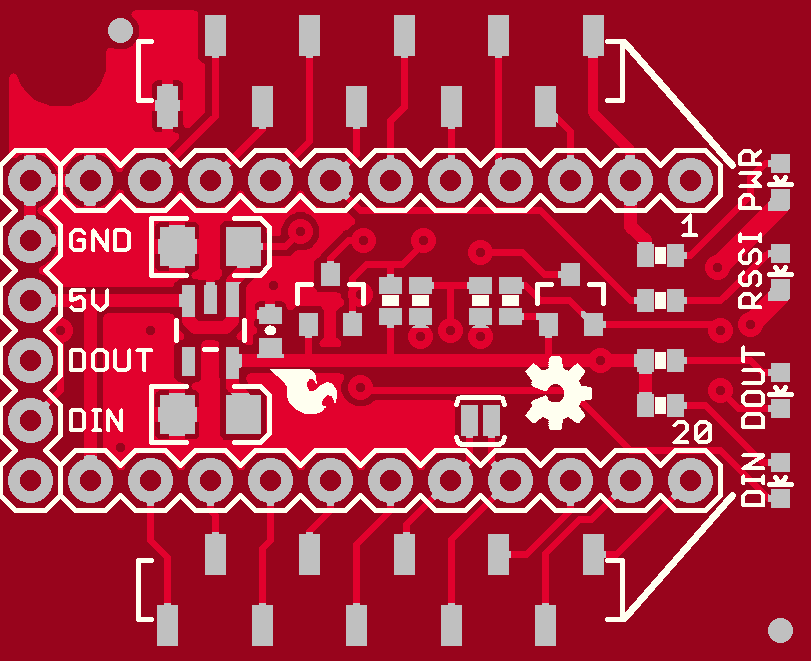
products/11373/geometry_edit_blender/XBee_Regulated_top_board.png
