sparkfun/3D_Models/products/11378/geometry_edit_blender/BT_Mate_MaKey_bottom_board.png

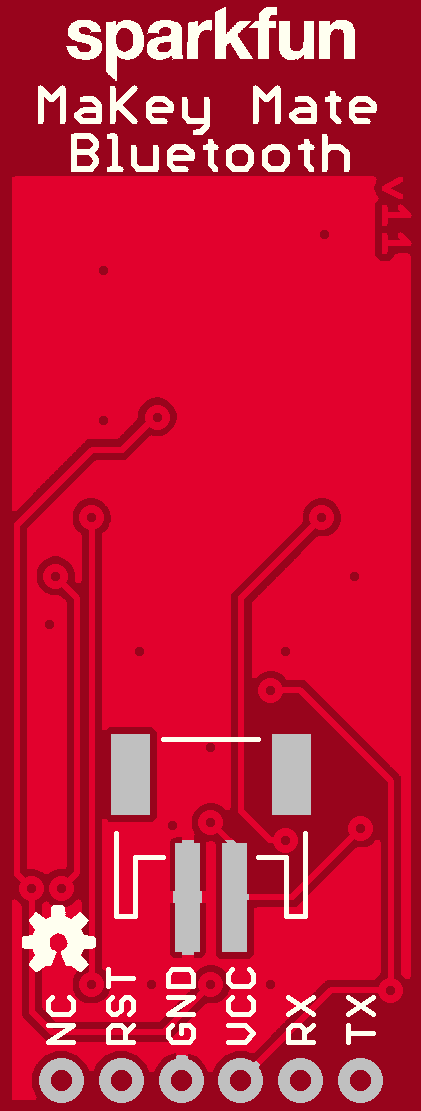
products/11378/geometry_edit_blender/BT_Mate_MaKey_bottom_board.png
