sparkfun/3D_Models/products/11440/display/Serial_7_Segment_Display_top_board.png

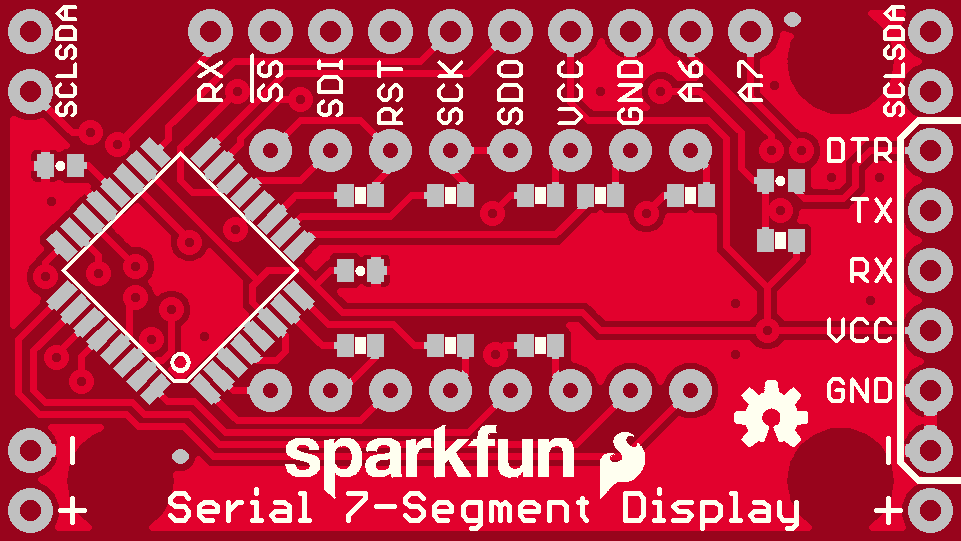
products/11440/display/Serial_7_Segment_Display_top_board.png
