sparkfun/3D_Models/products/11736/display/ft231x_breakout_bottom_board.png

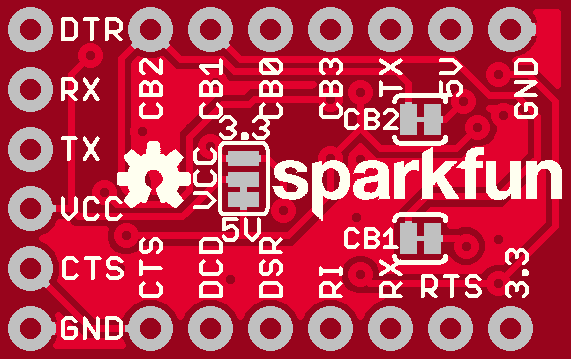
products/11736/display/ft231x_breakout_bottom_board.png
