sparkfun/3D_Models/products/11736/display/ft231x_breakout_top_board.png

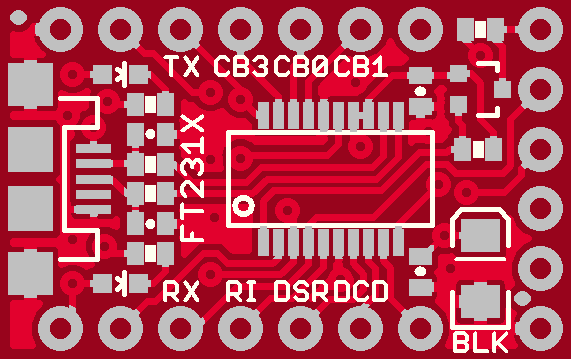
products/11736/display/ft231x_breakout_top_board.png
