sparkfun/3D_Models/products/11812/display/XBee_Explorer_bottom_board.png

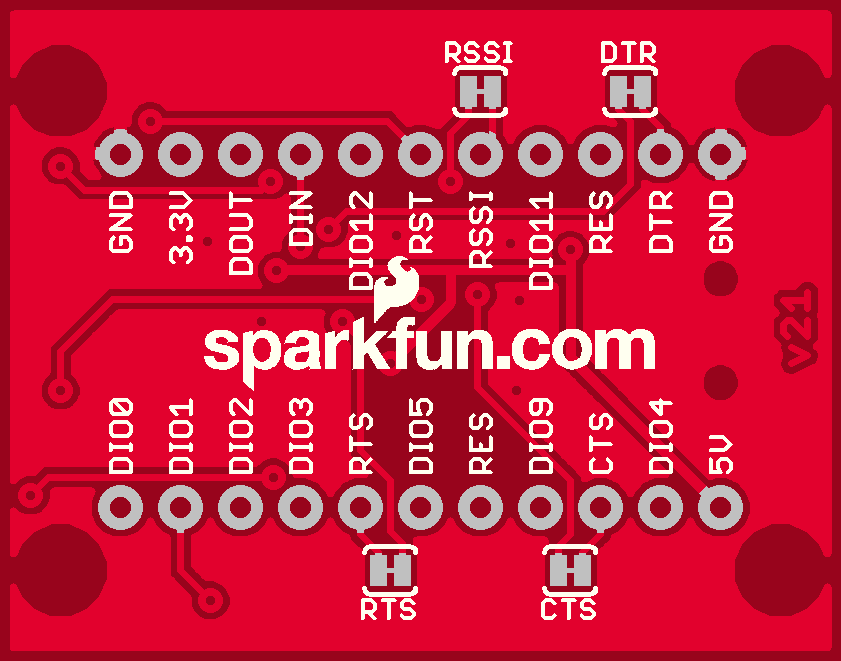
products/11812/display/XBee_Explorer_bottom_board.png
