sparkfun/3D_Models/products/11812/geometry_edit_blender/XBee_Explorer_top_board.png

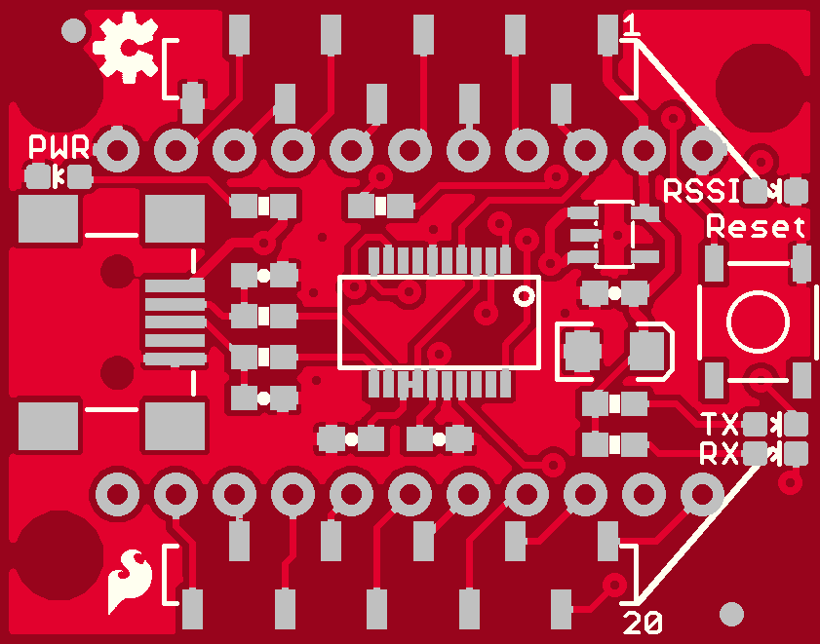
products/11812/geometry_edit_blender/XBee_Explorer_top_board.png
