sparkfun/3D_Models/products/11820/display/ws2812_Breakout_top_board.png

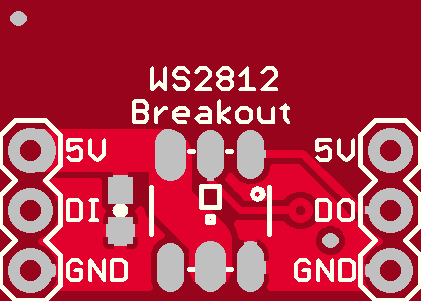
products/11820/display/ws2812_Breakout_top_board.png
