sparkfun/3D_Models/products/11824/display/BMP180breakout_bottom_board.png

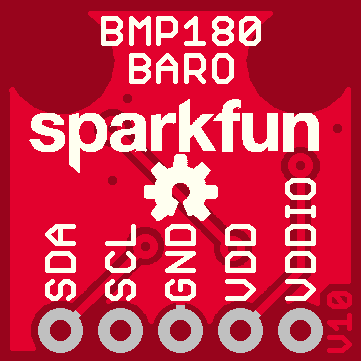
products/11824/display/BMP180breakout_bottom_board.png
