sparkfun/3D_Models/products/11824/geometry_edit_blender/BMP180_breakout_top_board.png

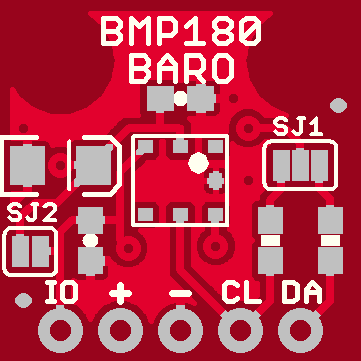
products/11824/geometry_edit_blender/BMP180_breakout_top_board.png
