sparkfun/3D_Models/products/11891/display/LilyPixel_top_board.png

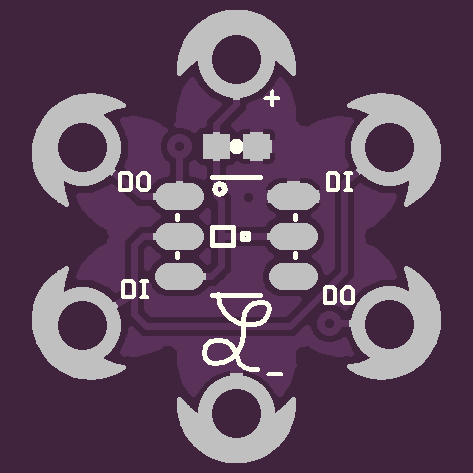
products/11891/display/LilyPixel_top_board.png
