sparkfun/3D_Models/products/11893/display/LilyPad_SimplePower_top_board.png

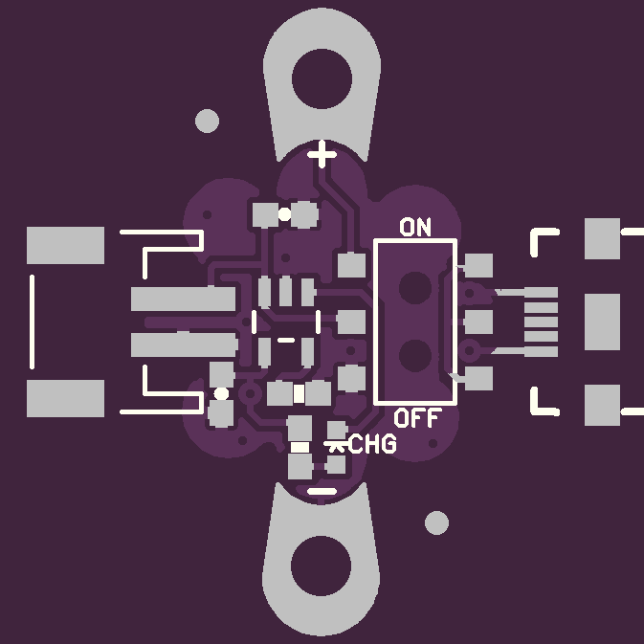
products/11893/display/LilyPad_SimplePower_top_board.png
