sparkfun/3D_Models/products/11893/display/LilyPadSimplePower_bottom_board.png

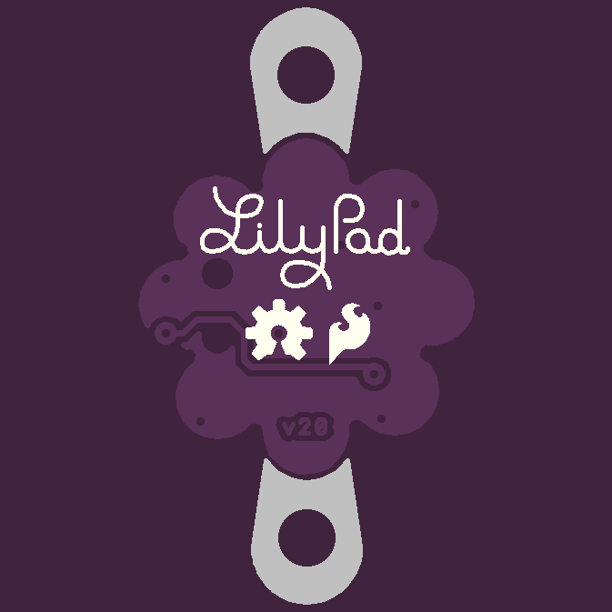
products/11893/display/LilyPadSimplePower_bottom_board.png
