sparkfun/3D_Models/products/11927/geometry_edit_blender/BC127_Breakout_top_board.png

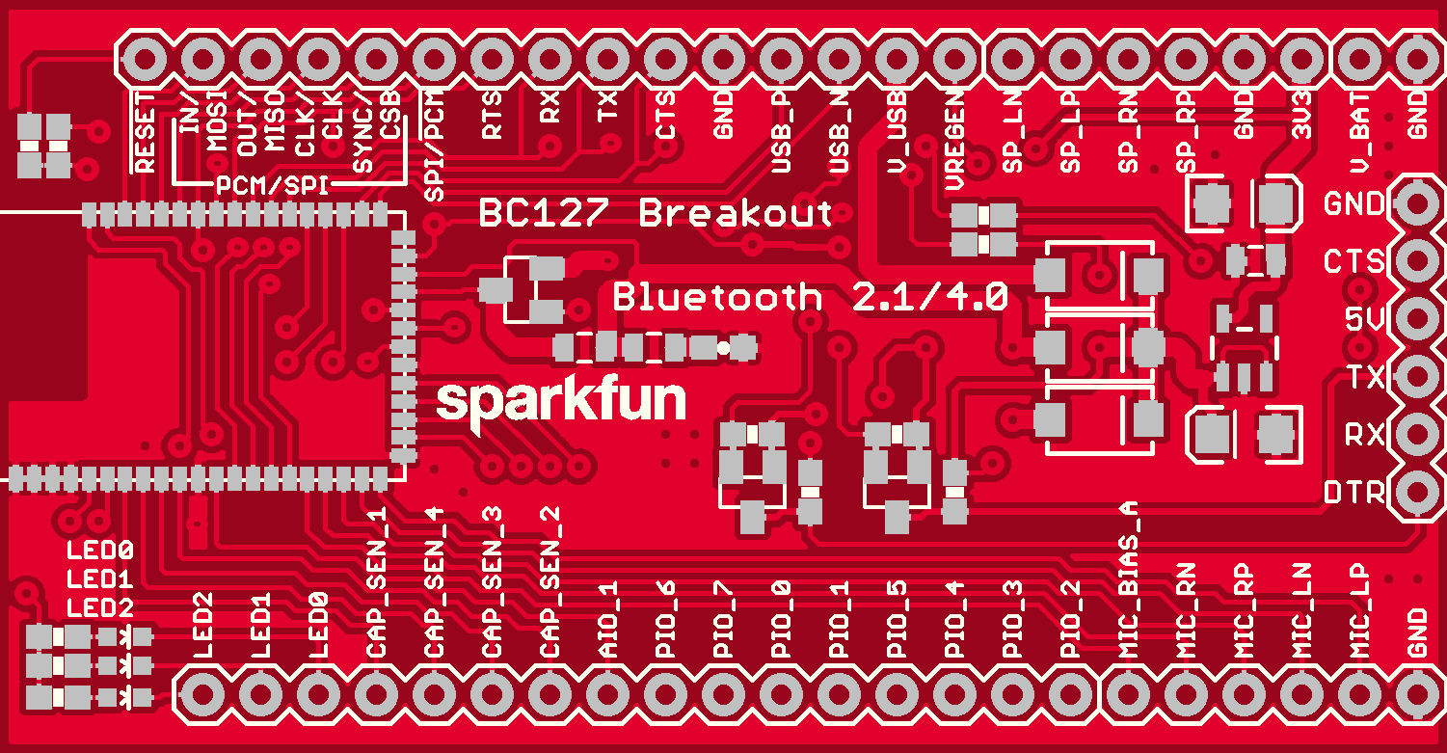
products/11927/geometry_edit_blender/BC127_Breakout_top_board.png
