sparkfun/3D_Models/products/11931/display/Digital_Temperature_Sensor_Breakout___TMP102_bottom_board.png

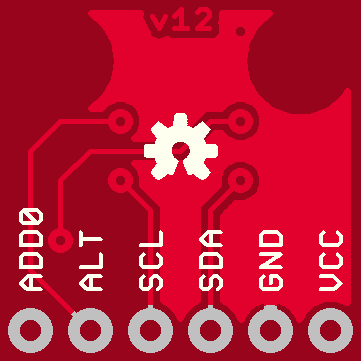
products/11931/display/Digital_Temperature_Sensor_Breakout___TMP102_bottom_board.png
