sparkfun/3D_Models/products/11977/display/Triple_axis_digital___output_gyro_ITG_3200_Breakout_bottom_board.png

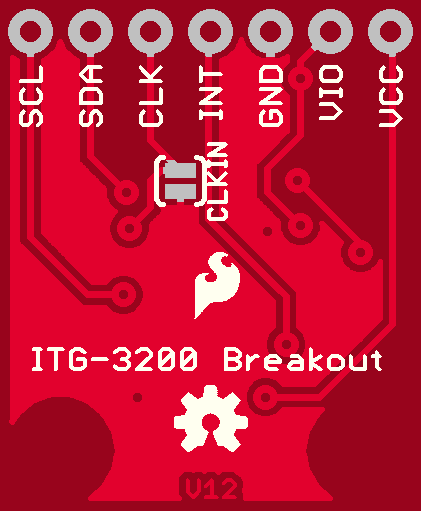
products/11977/display/Triple_axis_digital___output_gyro_ITG_3200_Breakout_bottom_board.png
