sparkfun/3D_Models/products/11977/geometry_edit_blender/Triple_axis_digital___output_gyro_ITG_3200_Breakout_top_board.png

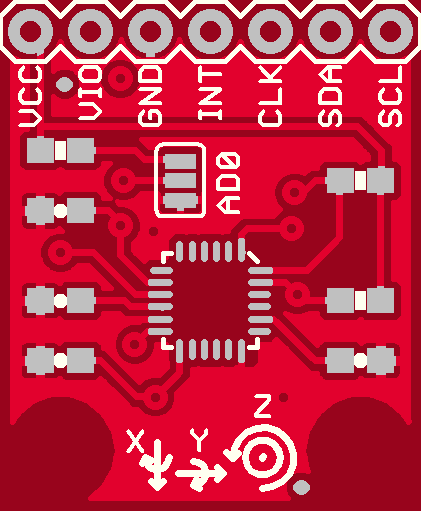
products/11977/geometry_edit_blender/Triple_axis_digital___output_gyro_ITG_3200_Breakout_top_board.png
