sparkfun/3D_Models/products/12009/display/Logic_Level_Bidirectional_bottom_board.png

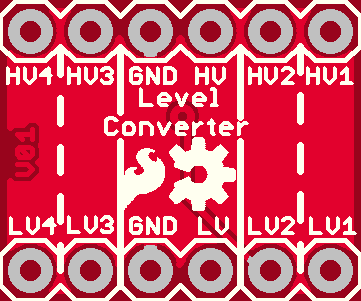
products/12009/display/Logic_Level_Bidirectional_bottom_board.png
