sparkfun/3D_Models/products/12035/display/Breakout_20Board_20for_20USB_20microB_bottom_board.png

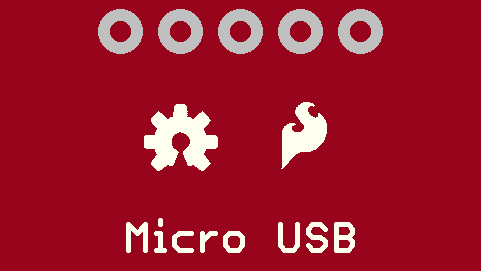
products/12035/display/Breakout_20Board_20for_20USB_20microB_bottom_board.png
