sparkfun/3D_Models/products/12055/display/TSL2561_Luminosity_Sensor_BOB_bottom_board.png

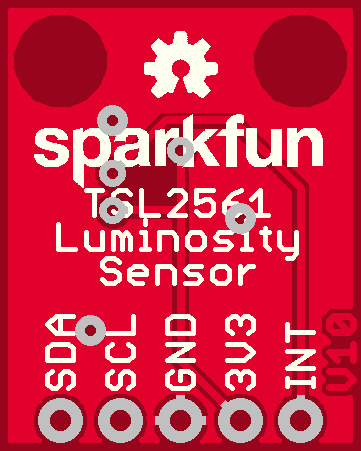
products/12055/display/TSL2561_Luminosity_Sensor_BOB_bottom_board.png
