sparkfun/3D_Models/products/12055/geometry_edit_blender/TSL2561LuminositySensorBOB_top_board.png

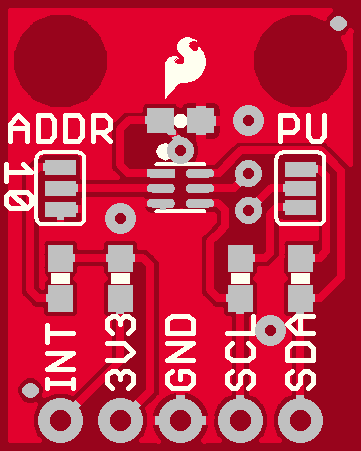
products/12055/geometry_edit_blender/TSL2561LuminositySensorBOB_top_board.png
