sparkfun/3D_Models/products/12125/images/exploded.jpg

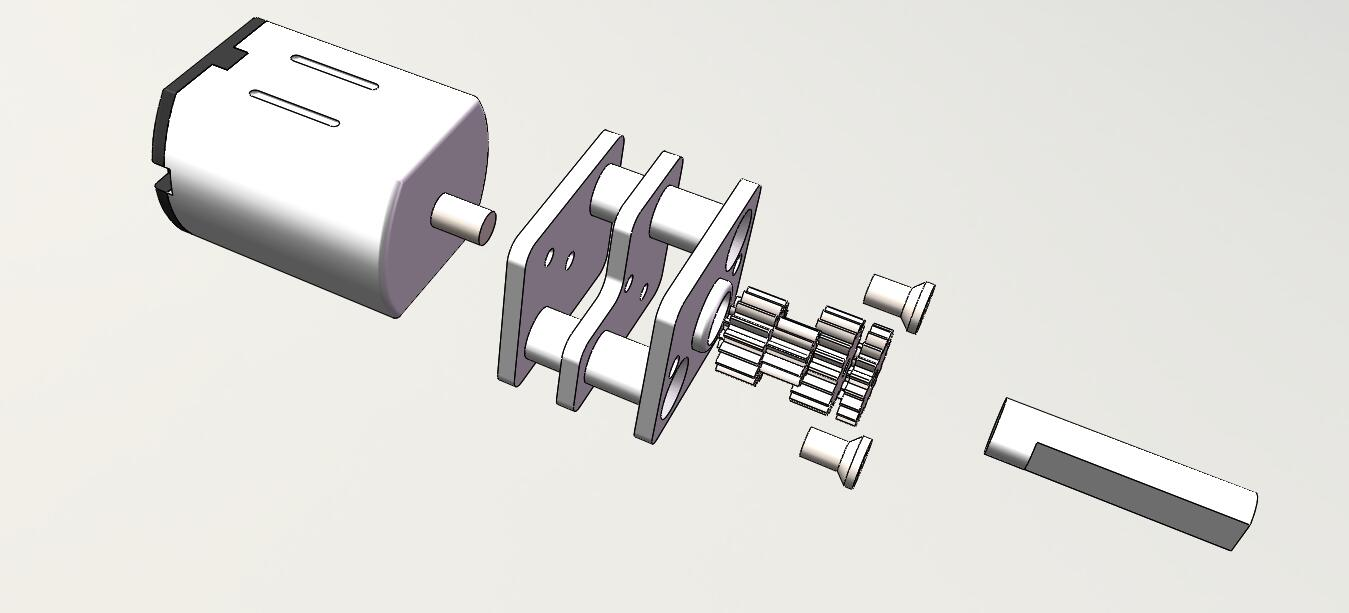
products/12125/images/exploded.jpg
