sparkfun/3D_Models/products/12576/geometry_edit_blender/BluetoothMate_top_board.png

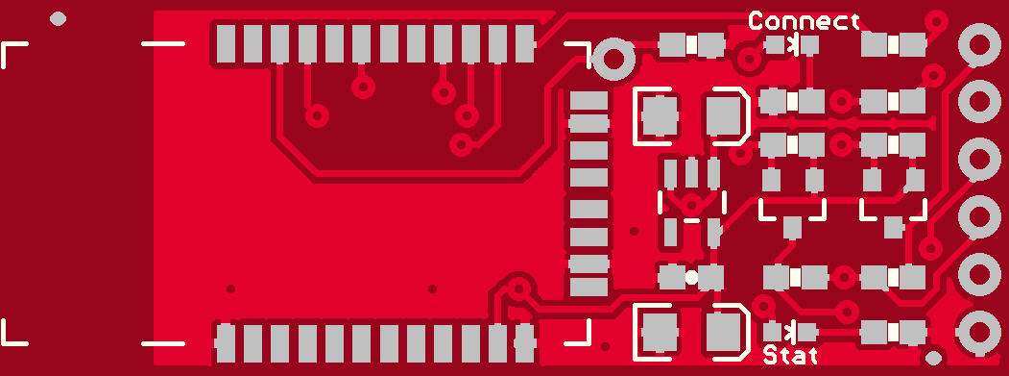
products/12576/geometry_edit_blender/BluetoothMate_top_board.png
