sparkfun/3D_Models/products/12579/display/RN41_v14_top_board.png

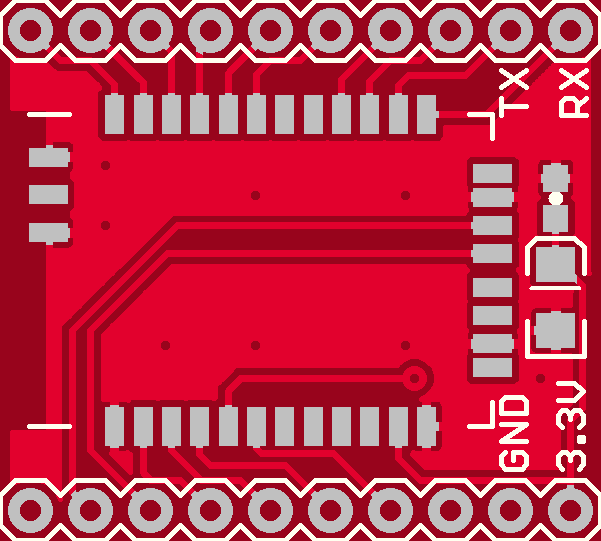
products/12579/display/RN41_v14_top_board.png
