sparkfun/3D_Models/products/12587/display/Pro_Micro_bottom_board.png

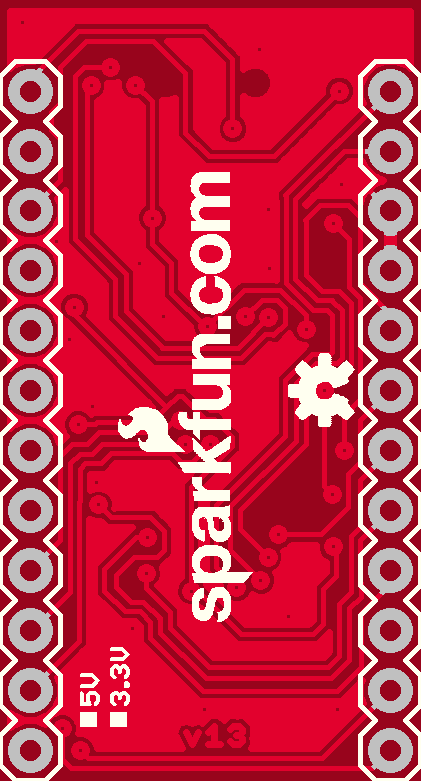
products/12587/display/Pro_Micro_bottom_board.png
