sparkfun/3D_Models/products/12633/display/IOIO_OTG_top_board.png

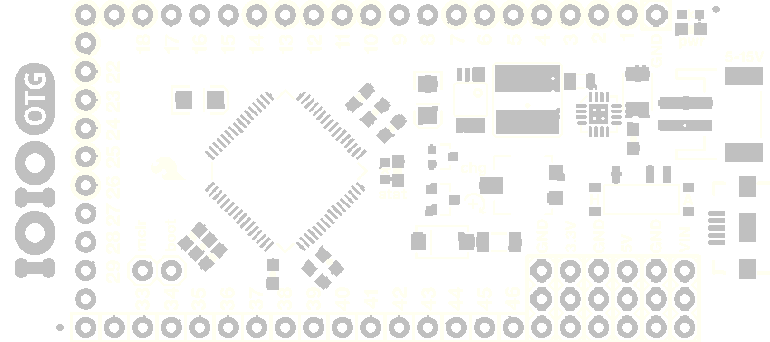
products/12633/display/IOIO_OTG_top_board.png
