sparkfun/3D_Models/products/12640/geometry_edit_blender/Pro_Micro_top_board.png

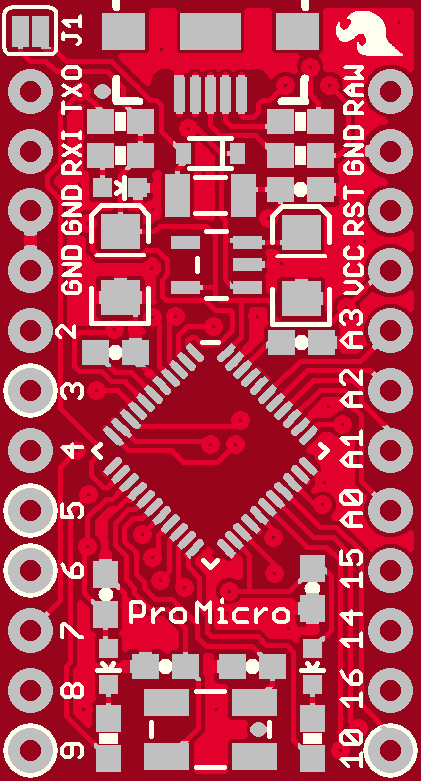
products/12640/geometry_edit_blender/Pro_Micro_top_board.png
