sparkfun/3D_Models/products/12642/geometry_edit_blender/sound_detector_top_board.png

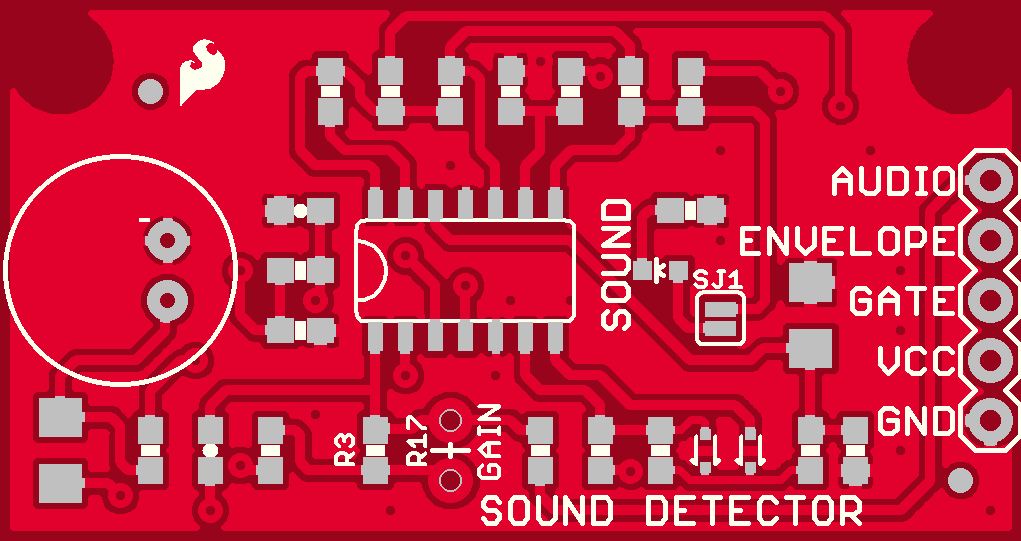
products/12642/geometry_edit_blender/sound_detector_top_board.png
