sparkfun/3D_Models/products/12699/geometry_edit_blender/top.png

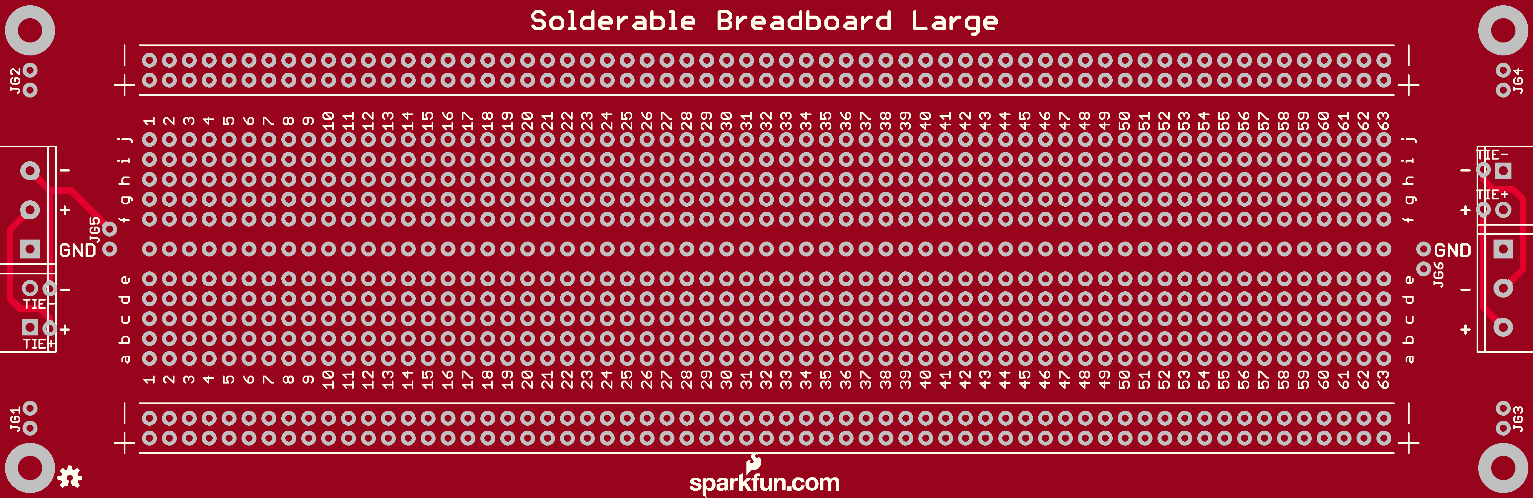
products/12699/geometry_edit_blender/top.png
