sparkfun/3D_Models/products/12705/geometry_edit_blender/ML8511_Breakout_top_board.png

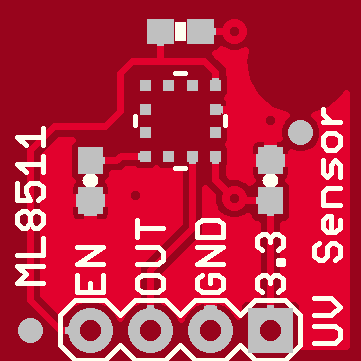
products/12705/geometry_edit_blender/ML8511_Breakout_top_board.png
