sparkfun/3D_Models/products/12711/display/SparkFun_USB_LiPolyCharger_SingleCell_bottom_board.png

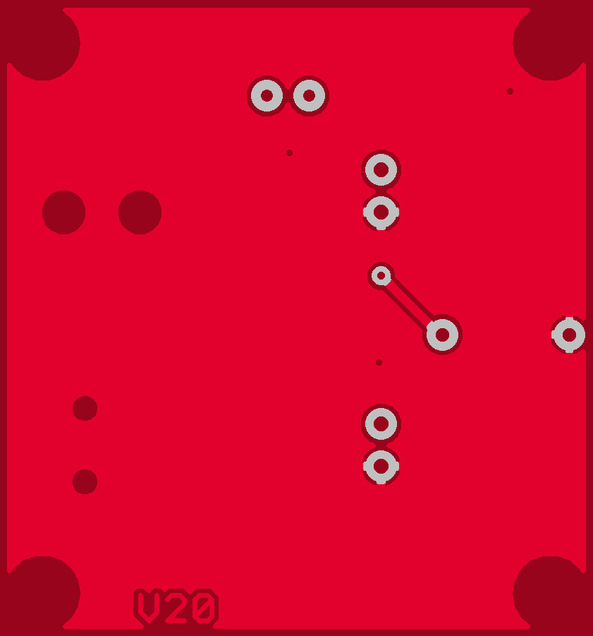
products/12711/display/SparkFun_USB_LiPolyCharger_SingleCell_bottom_board.png
