sparkfun/3D_Models/products/12711/geometry_edit_blender/SparkFun_USB_LiPolyCharger_SingleCell_top_board.png

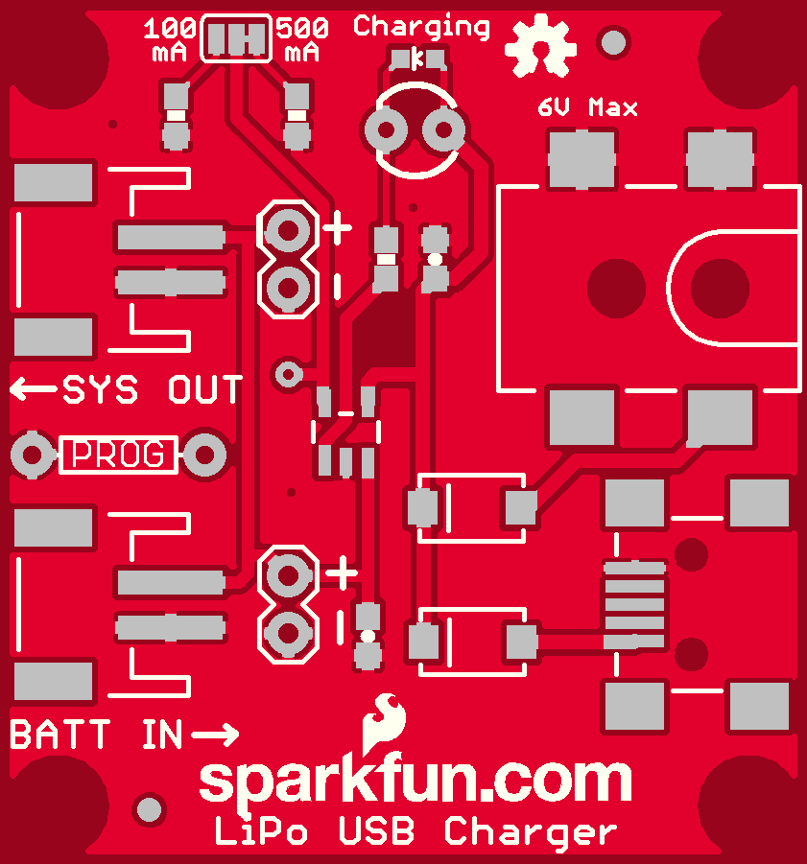
products/12711/geometry_edit_blender/SparkFun_USB_LiPolyCharger_SingleCell_top_board.png
