sparkfun/3D_Models/products/12731/geometry_edit_blender/FT232R_Breakout_bottom_board.png

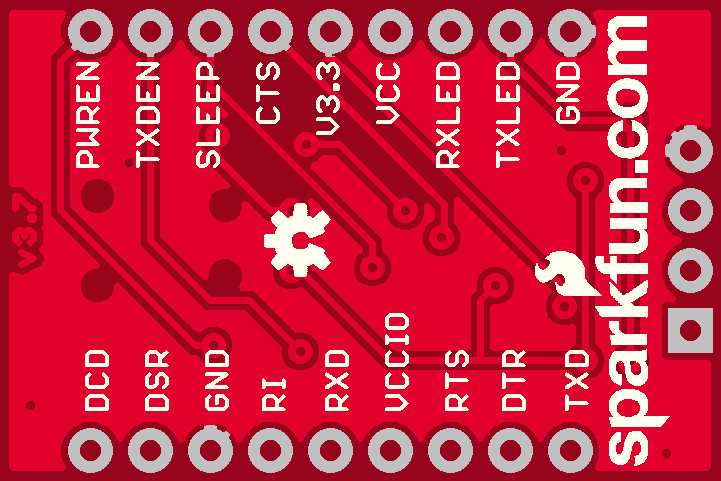
products/12731/geometry_edit_blender/FT232R_Breakout_bottom_board.png
