sparkfun/3D_Models/products/12757/geometry_edit_blender/RedBoard_bottom_board.png

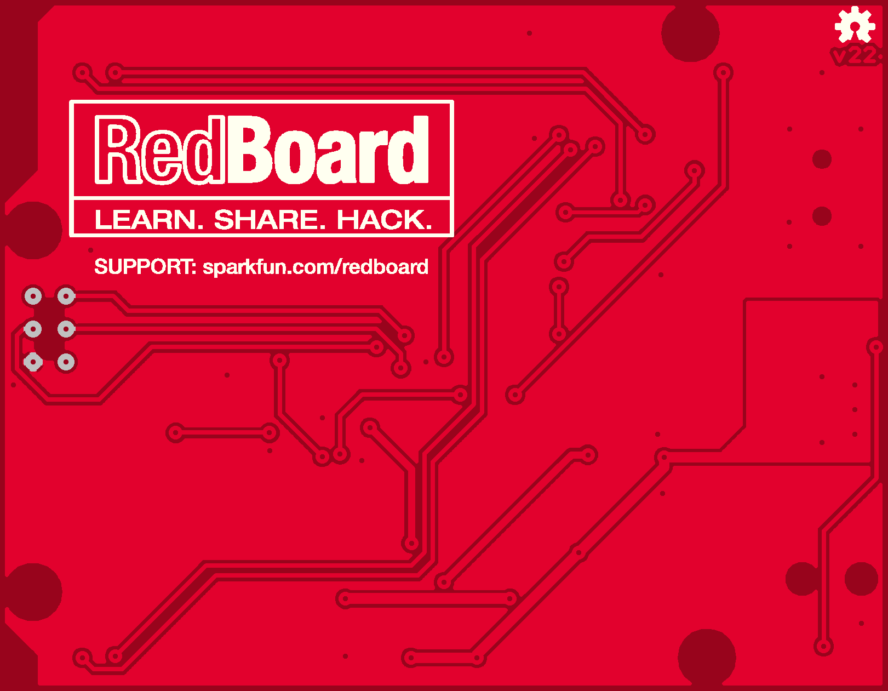
products/12757/geometry_edit_blender/RedBoard_bottom_board.png
