sparkfun/3D_Models/products/12758/geometry_edit_blender/Electret_Microphone_Breakout_bottom_board.png

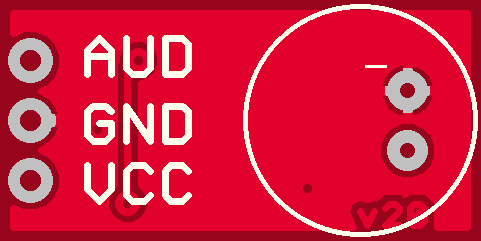
products/12758/geometry_edit_blender/Electret_Microphone_Breakout_bottom_board.png
