sparkfun/3D_Models/products/12758/geometry_edit_blender/Electret_Microphone_Breakout_top_board.png

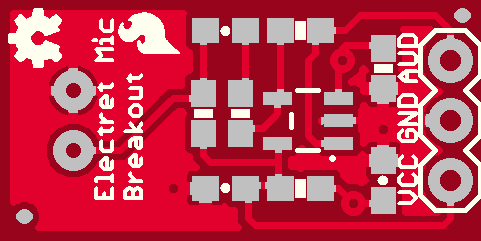
products/12758/geometry_edit_blender/Electret_Microphone_Breakout_top_board.png
