sparkfun/3D_Models/products/12779/display/EasyDriver_v45_bottom_board.png

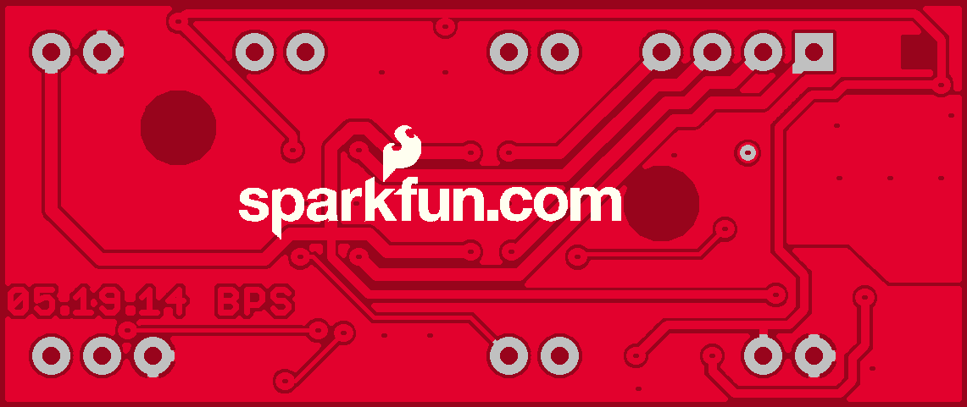
products/12779/display/EasyDriver_v45_bottom_board.png
