sparkfun/3D_Models/products/12779/geometry_edit_blender/EasyDriver_v45_top_board.png

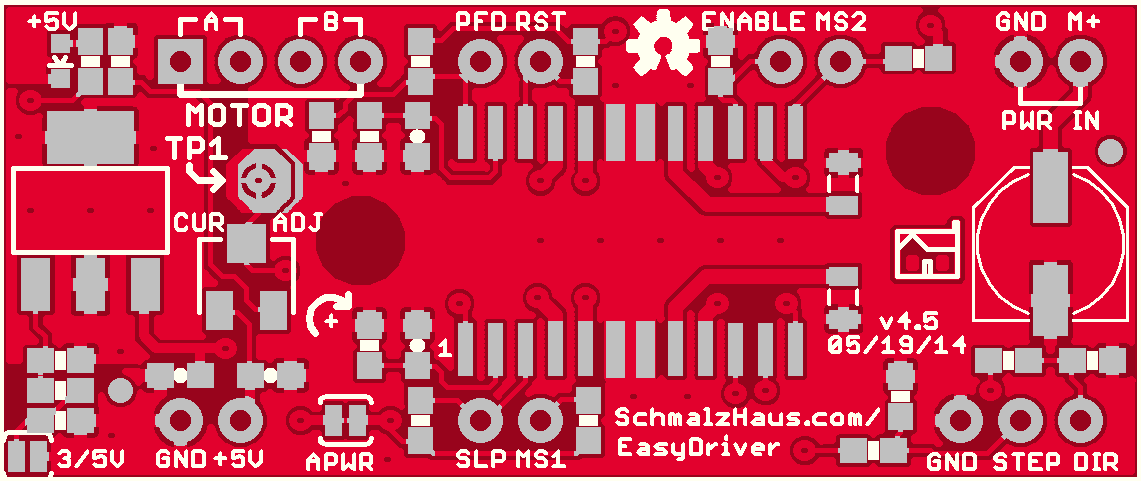
products/12779/geometry_edit_blender/EasyDriver_v45_top_board.png
