sparkfun/3D_Models/products/12781/display/EL_Sequencer_bottom_board.png

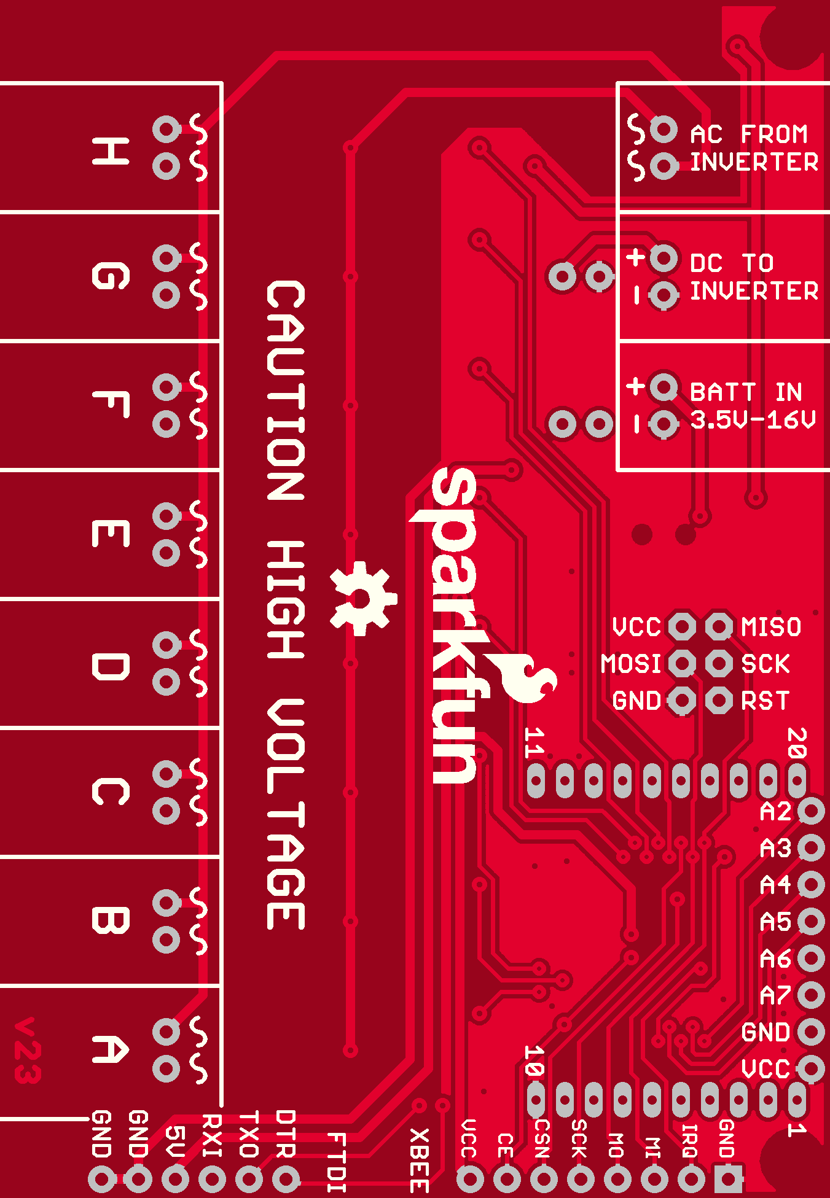
products/12781/display/EL_Sequencer_bottom_board.png
