sparkfun/3D_Models/products/12785/display/SparkFun_VL6180_Sensor_top_board.png

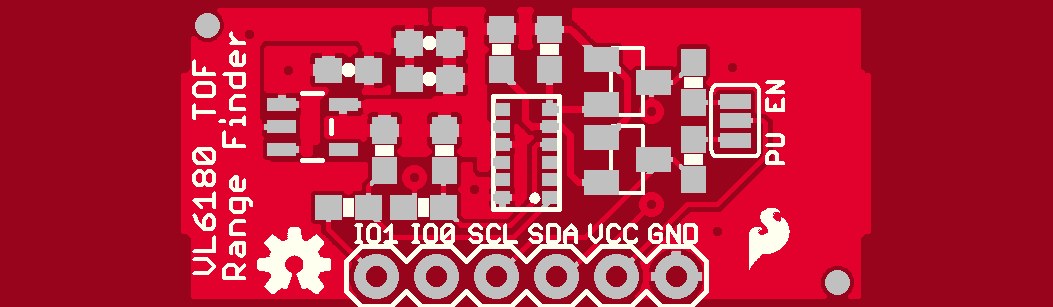
products/12785/display/SparkFun_VL6180_Sensor_top_board.png
