sparkfun/3D_Models/products/12785/geometry_edit_blender/SparkFun_VL6180_Sensor_bottom_board.png

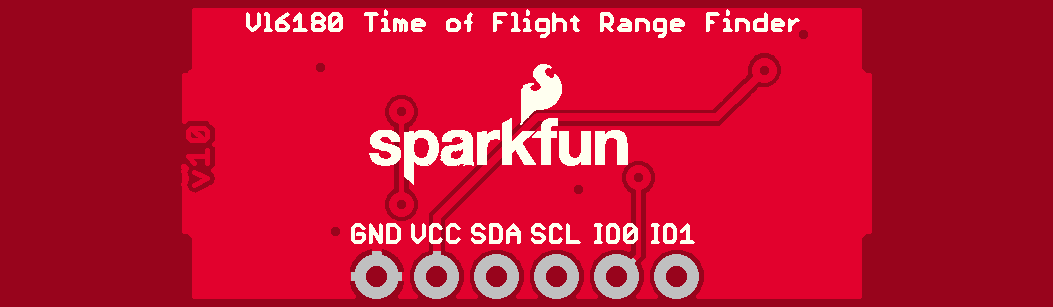
products/12785/geometry_edit_blender/SparkFun_VL6180_Sensor_bottom_board.png
