sparkfun/3D_Models/products/12787/display/SparkFun_APDS_9960_RGB_and_Gesture_Sensor_bottom_board.png

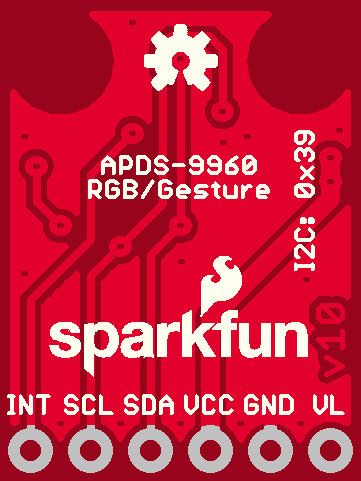
products/12787/display/SparkFun_APDS_9960_RGB_and_Gesture_Sensor_bottom_board.png
