sparkfun/3D_Models/products/12849/display/RN_52_20Breakout_bottom_board.png

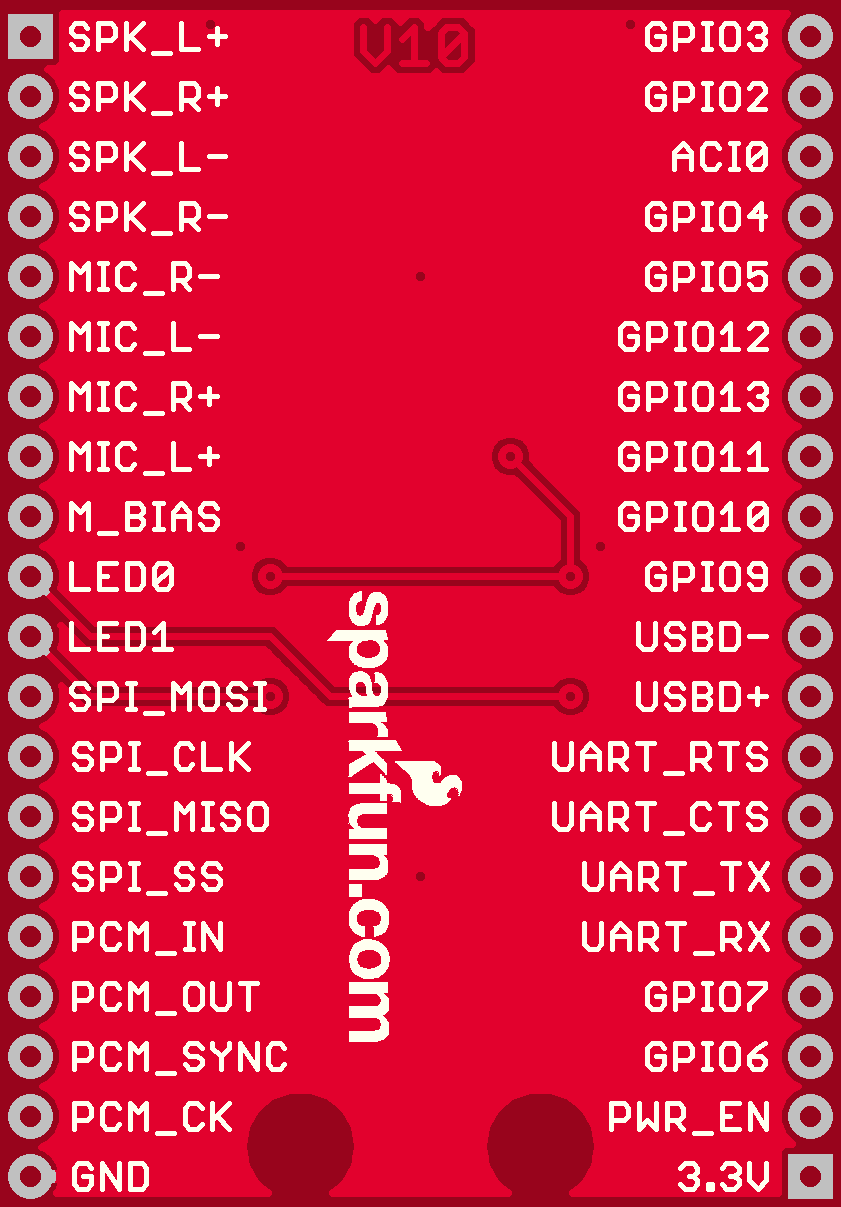
products/12849/display/RN_52_20Breakout_bottom_board.png
