sparkfun/3D_Models/products/12859/display/BigEasyDriver_top_board.png

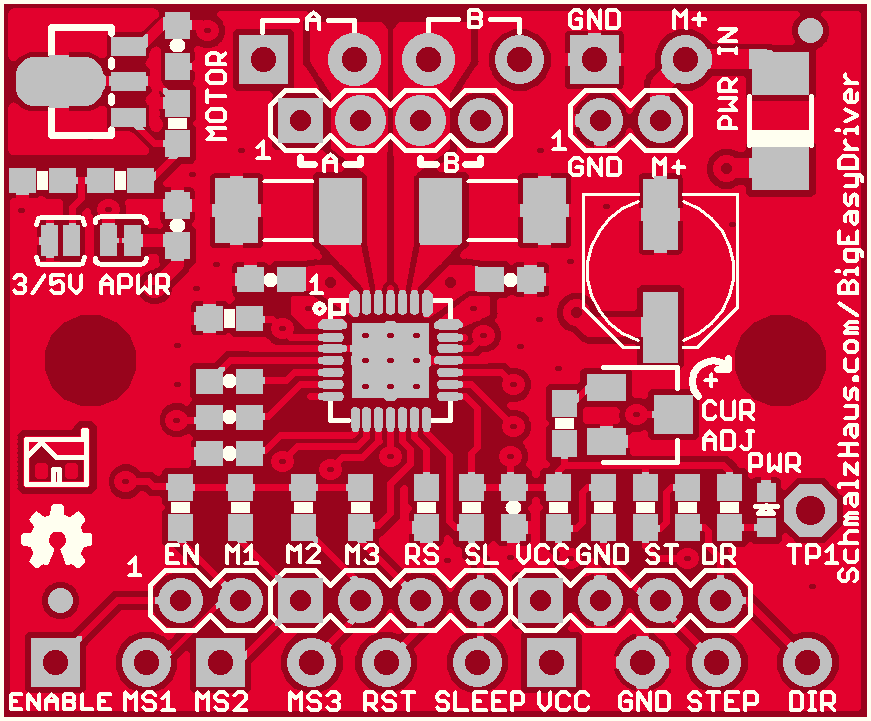
products/12859/display/BigEasyDriver_top_board.png
