sparkfun/3D_Models/products/12918/geometry_edit_blender/MCP4725_Breakout_top_board.png

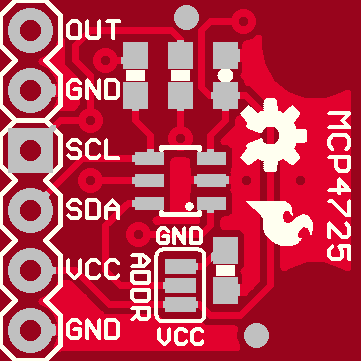
products/12918/geometry_edit_blender/MCP4725_Breakout_top_board.png
