sparkfun/3D_Models/products/12938/display/SparkFun_Si4703_Eval_bottom_board.png

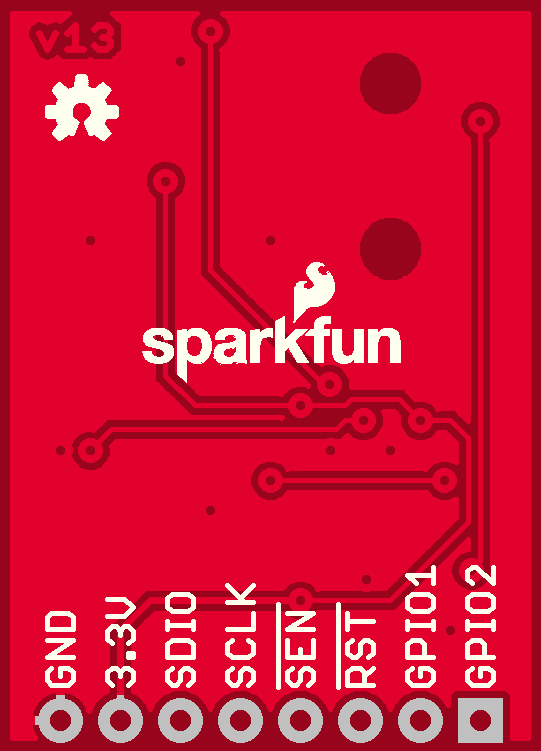
products/12938/display/SparkFun_Si4703_Eval_bottom_board.png
