sparkfun/3D_Models/products/12938/geometry_edit_blender/SparkFun_Si4703_Eval_top_board.png

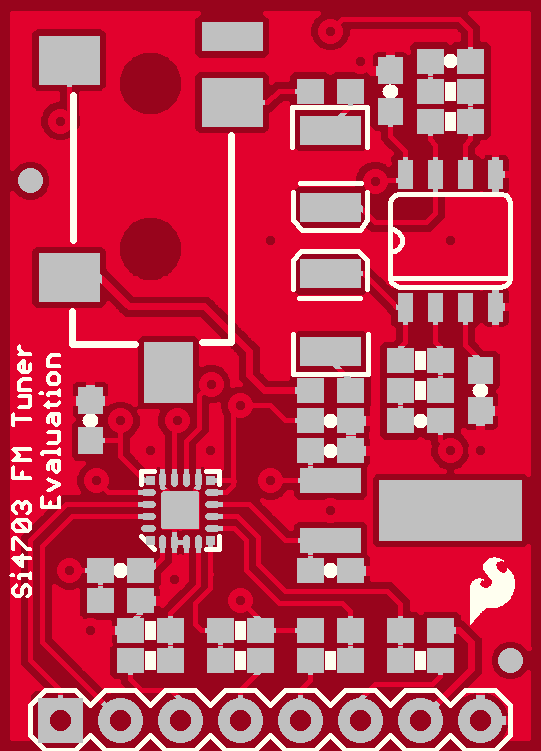
products/12938/geometry_edit_blender/SparkFun_Si4703_Eval_top_board.png
