sparkfun/3D_Models/products/12958/display/Electric_Imp_imp002_Breakout_top_board.png

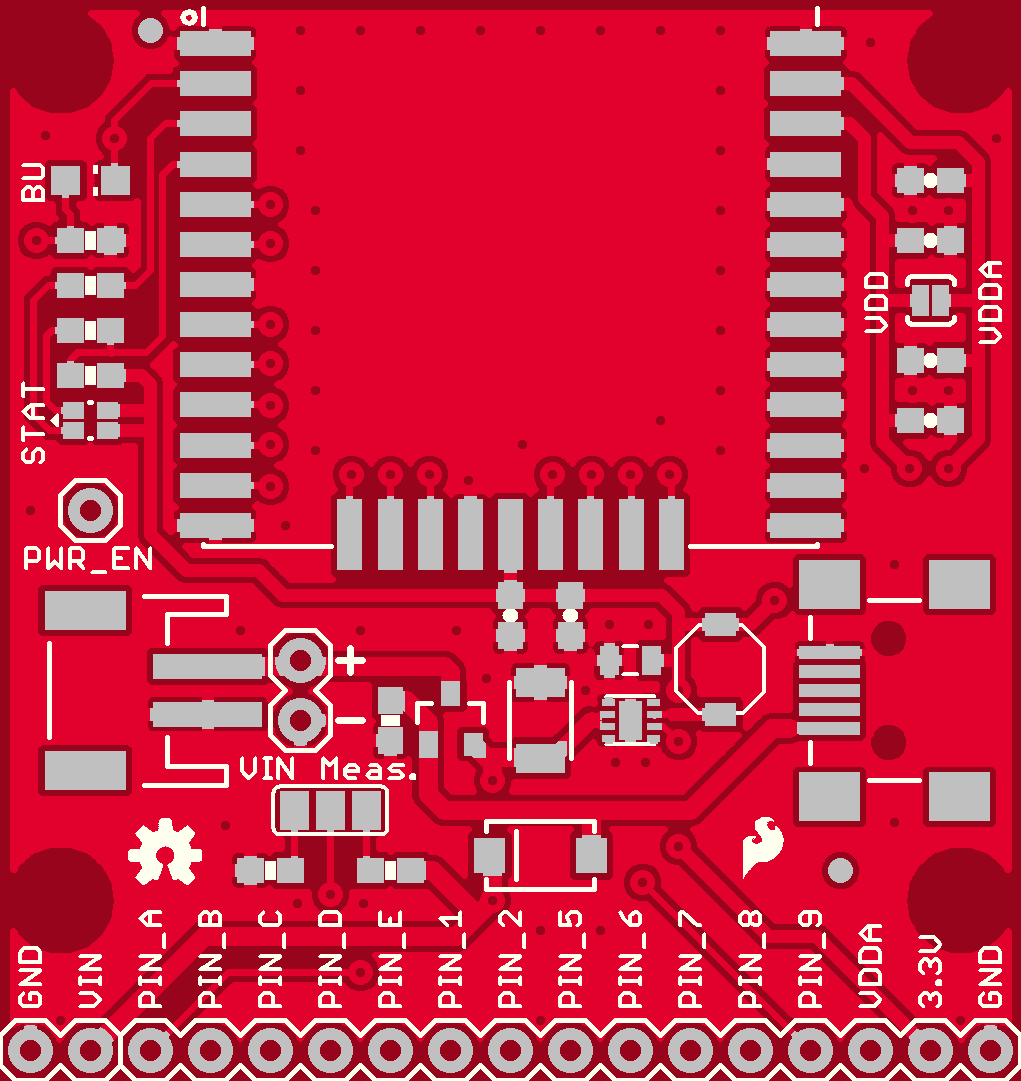
products/12958/display/Electric_Imp_imp002_Breakout_top_board.png
