sparkfun/3D_Models/products/12959/display/SparkFun_MOSFET_Power_Control_Kit_top_board.png

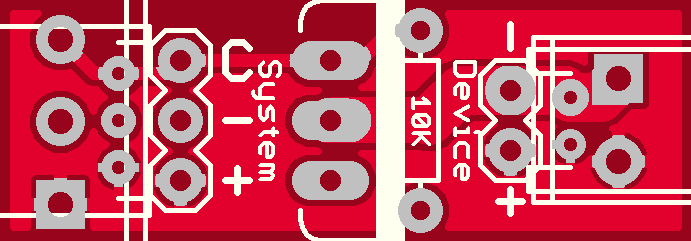
products/12959/display/SparkFun_MOSFET_Power_Control_Kit_top_board.png
