sparkfun/3D_Models/products/13019/geometry_edit_blender/SparkFun_BLEMate2_top_board.png

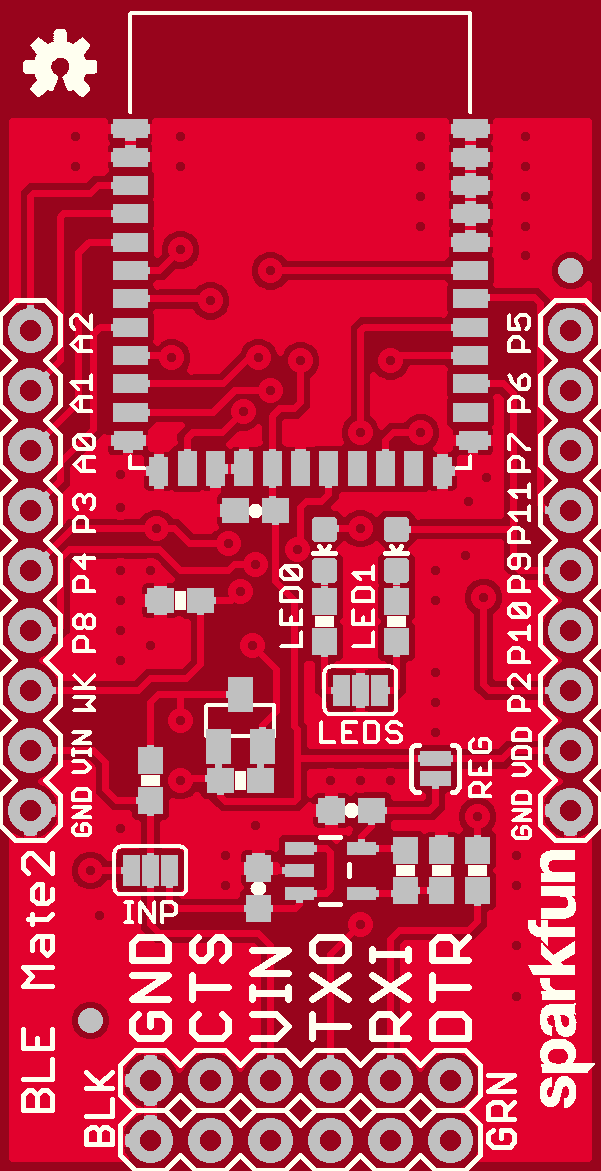
products/13019/geometry_edit_blender/SparkFun_BLEMate2_top_board.png
