sparkfun/3D_Models/products/13032/geometry_edit_blender/SparkFun_Breadboard_Power_Supply_5v_3V_SMD_top_board.png

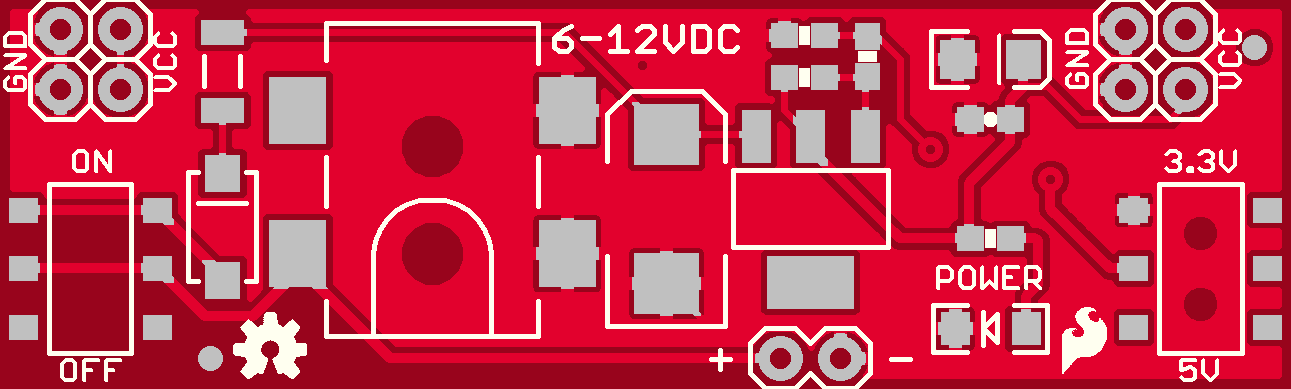
products/13032/geometry_edit_blender/SparkFun_Breadboard_Power_Supply_5v_3V_SMD_top_board.png
