sparkfun/3D_Models/products/13033/display/M_9dof_block_bottom_board.png

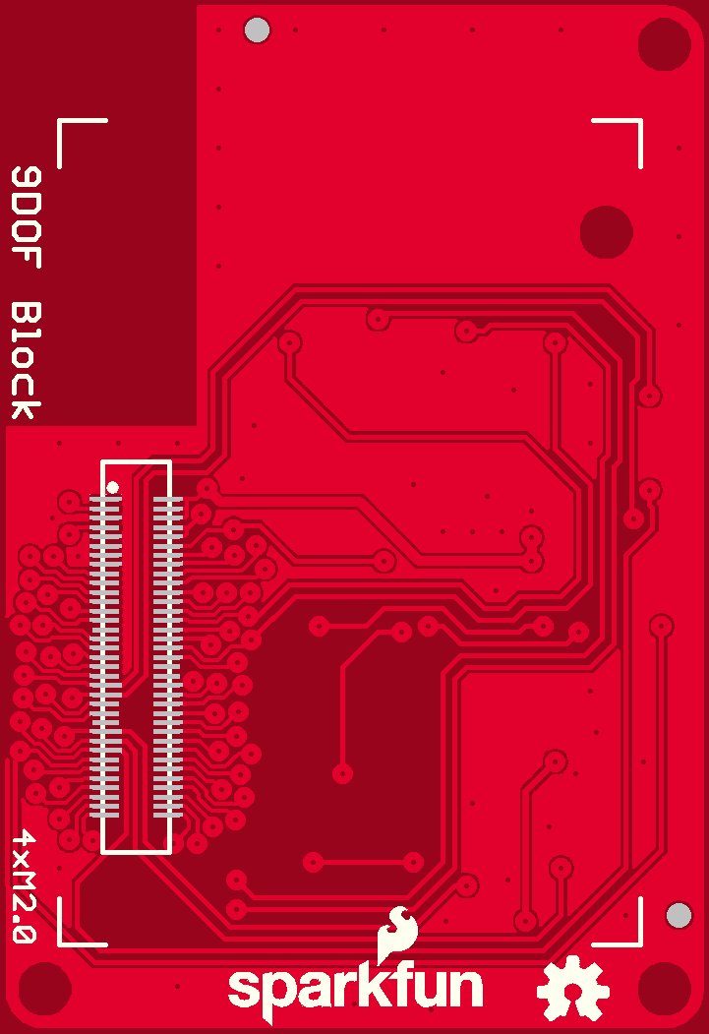
products/13033/display/M_9dof_block_bottom_board.png
