sparkfun/3D_Models/products/13037/display/Battery_Block_top_board.png

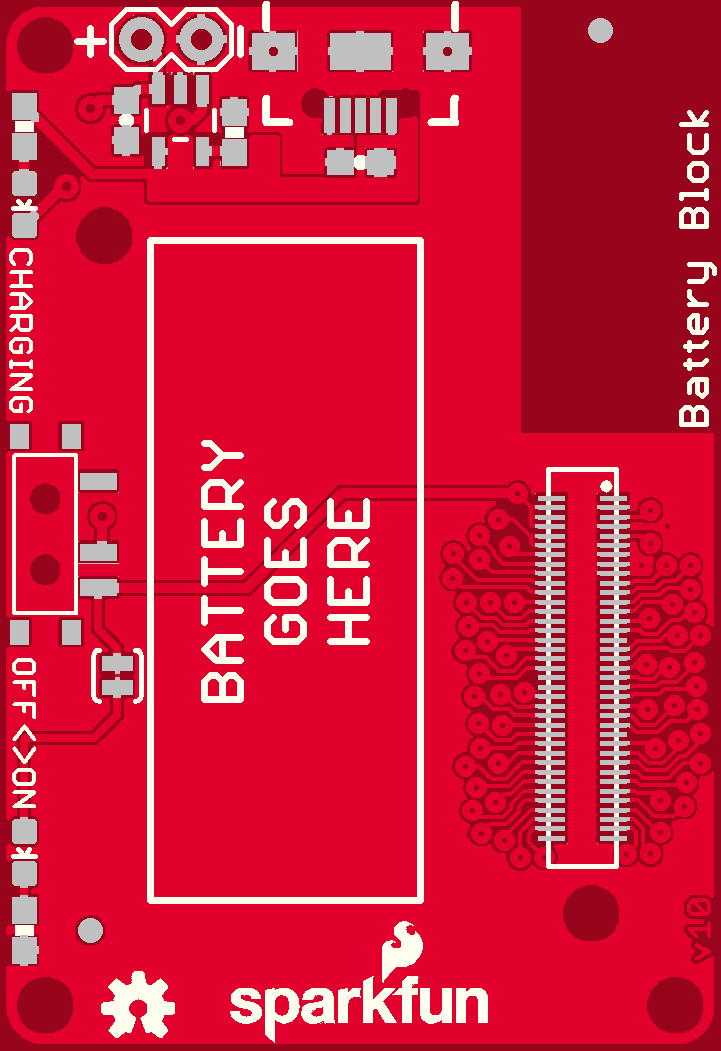
products/13037/display/Battery_Block_top_board.png
