sparkfun/3D_Models/products/13038/geometry_edit_blender/GPIO_Block_bottom_board.png

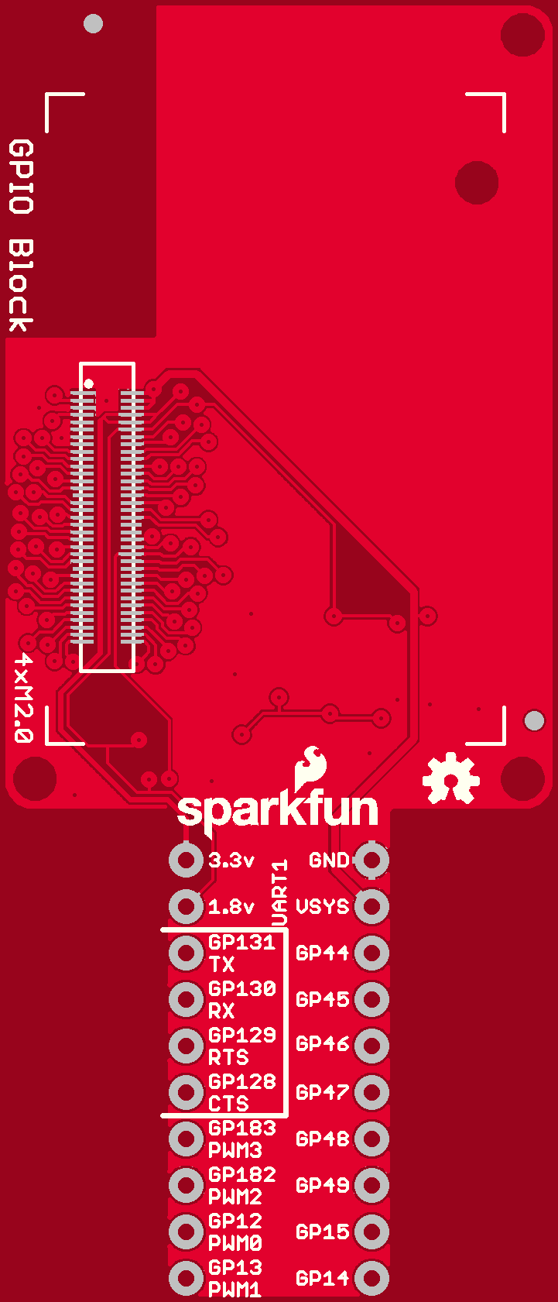
products/13038/geometry_edit_blender/GPIO_Block_bottom_board.png
