sparkfun/3D_Models/products/13058/geometry_edit_blender/Sparkfun_MiP_ProMini_Pack_top_board.png

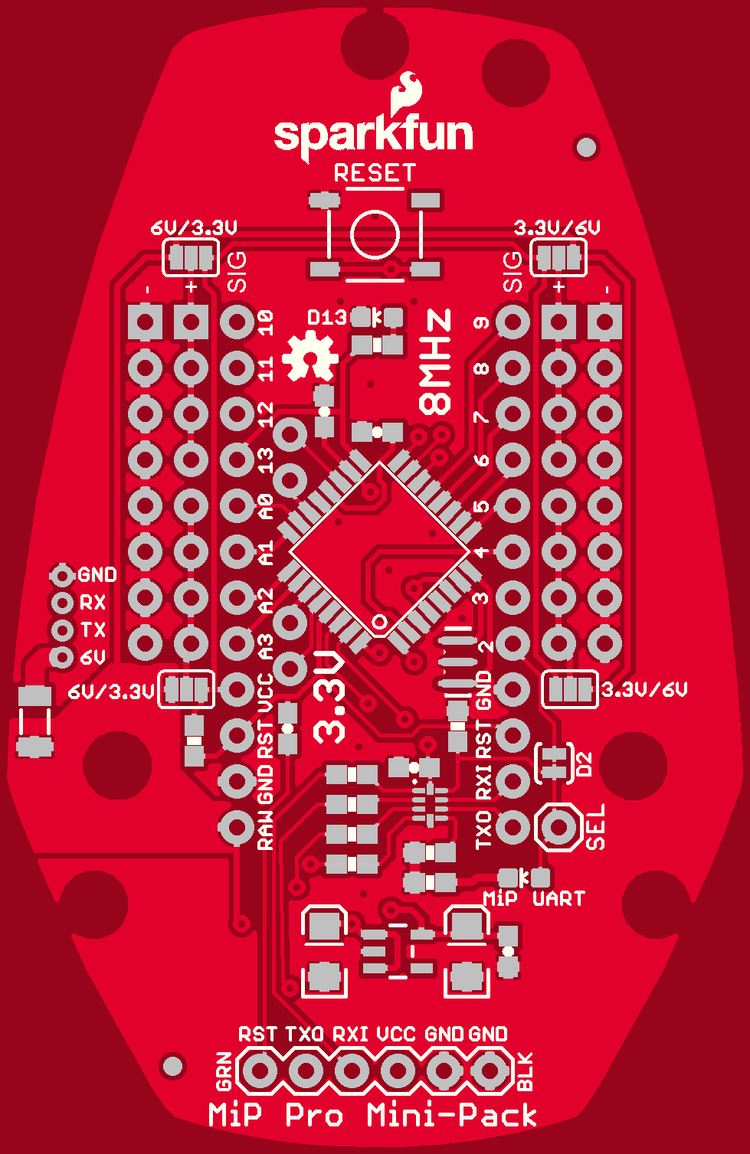
products/13058/geometry_edit_blender/Sparkfun_MiP_ProMini_Pack_top_board.png
