sparkfun/3D_Models/products/13066/display/MiP_Proto_Back_top_board.png

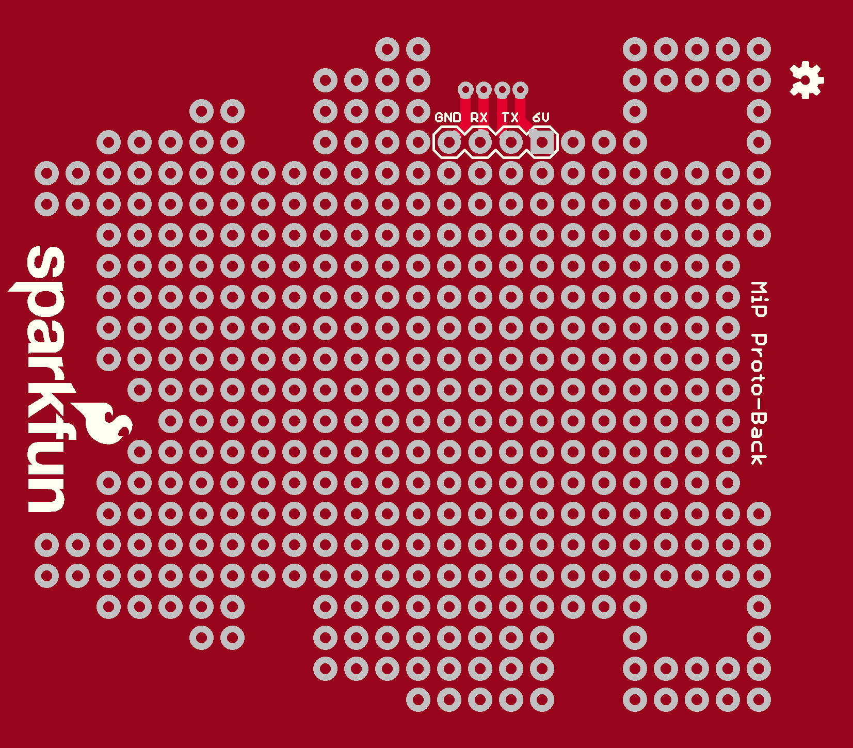
products/13066/display/MiP_Proto_Back_top_board.png
