sparkfun/3D_Models/products/13098/display/bottom.png

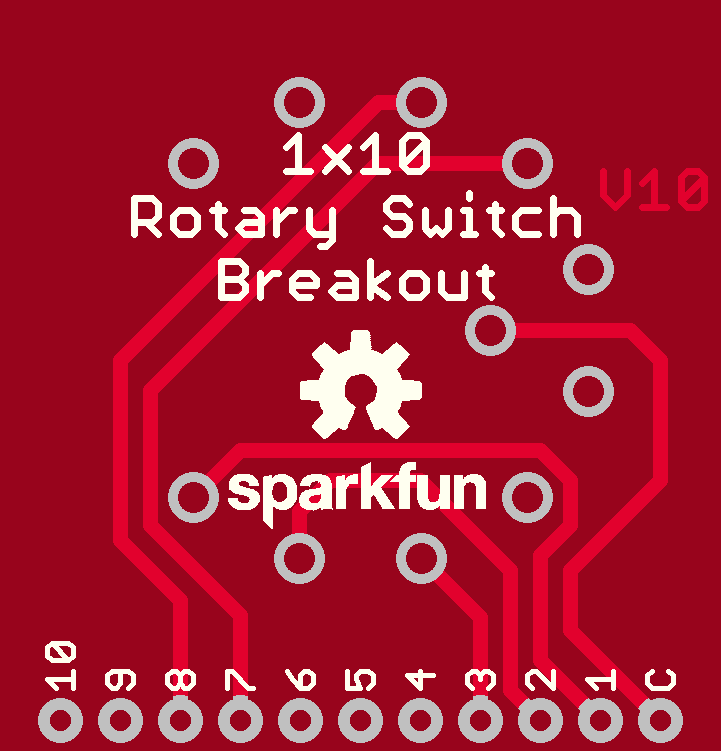
products/13098/display/bottom.png
