sparkfun/3D_Models/products/13098/geometry_edit_blender/top.png

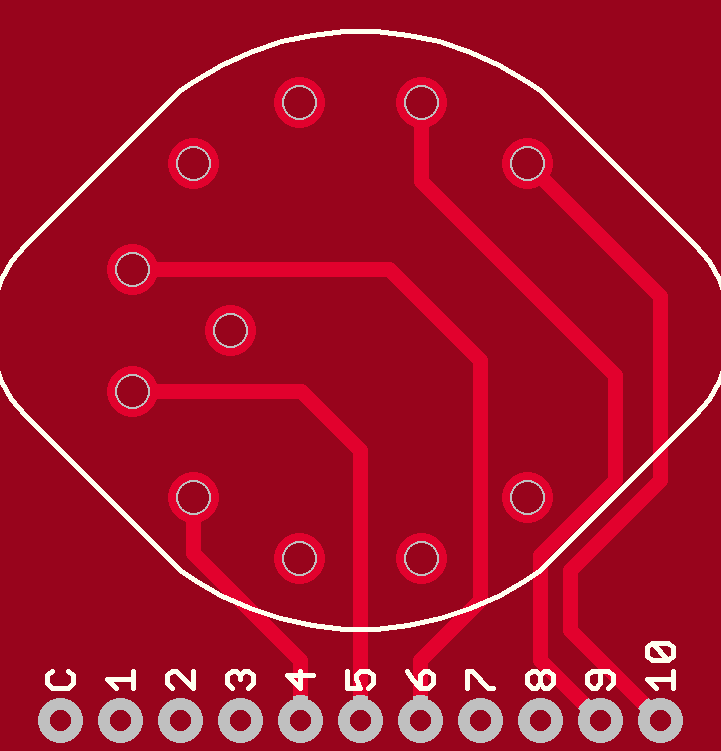
products/13098/geometry_edit_blender/top.png
