sparkfun/3D_Models/products/13099/display/Rotary_Switch_Potentiometer_bottom_board.png

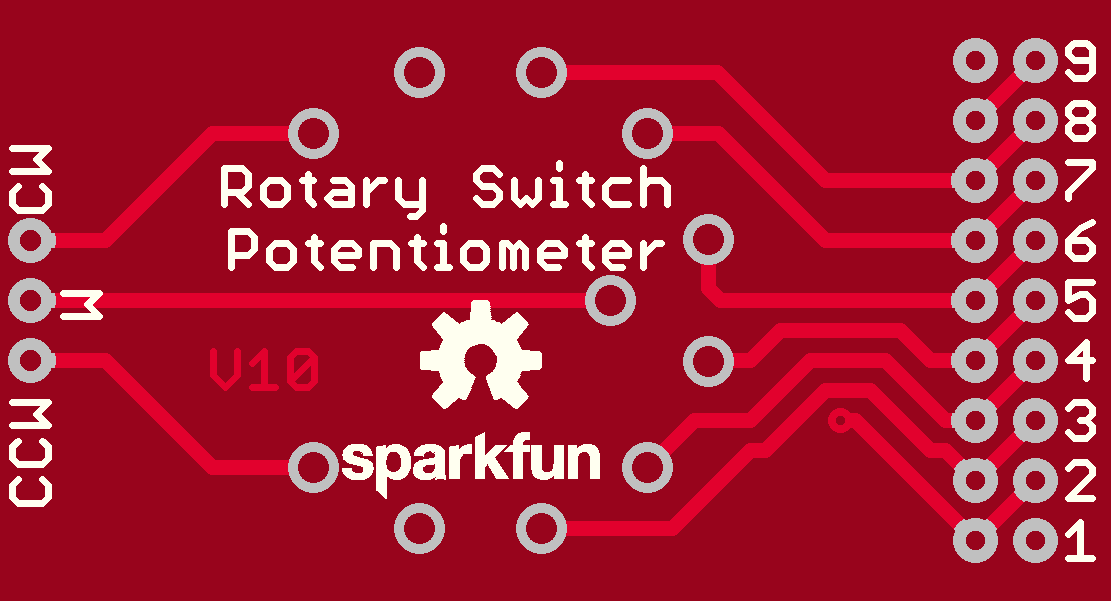
products/13099/display/Rotary_Switch_Potentiometer_bottom_board.png
