sparkfun/3D_Models/products/13099/geometry_edit_blender/Rotary_Switch_Potentiometer_top_board.png

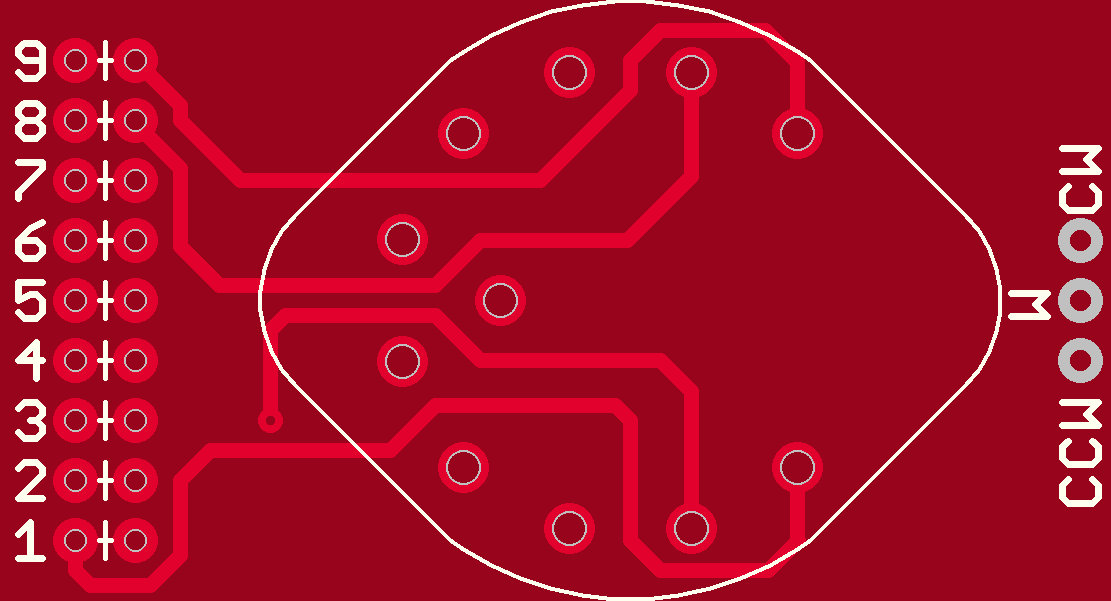
products/13099/geometry_edit_blender/Rotary_Switch_Potentiometer_top_board.png
