sparkfun/3D_Models/products/13116/display/Spectrum_Shield_bottom_board.png

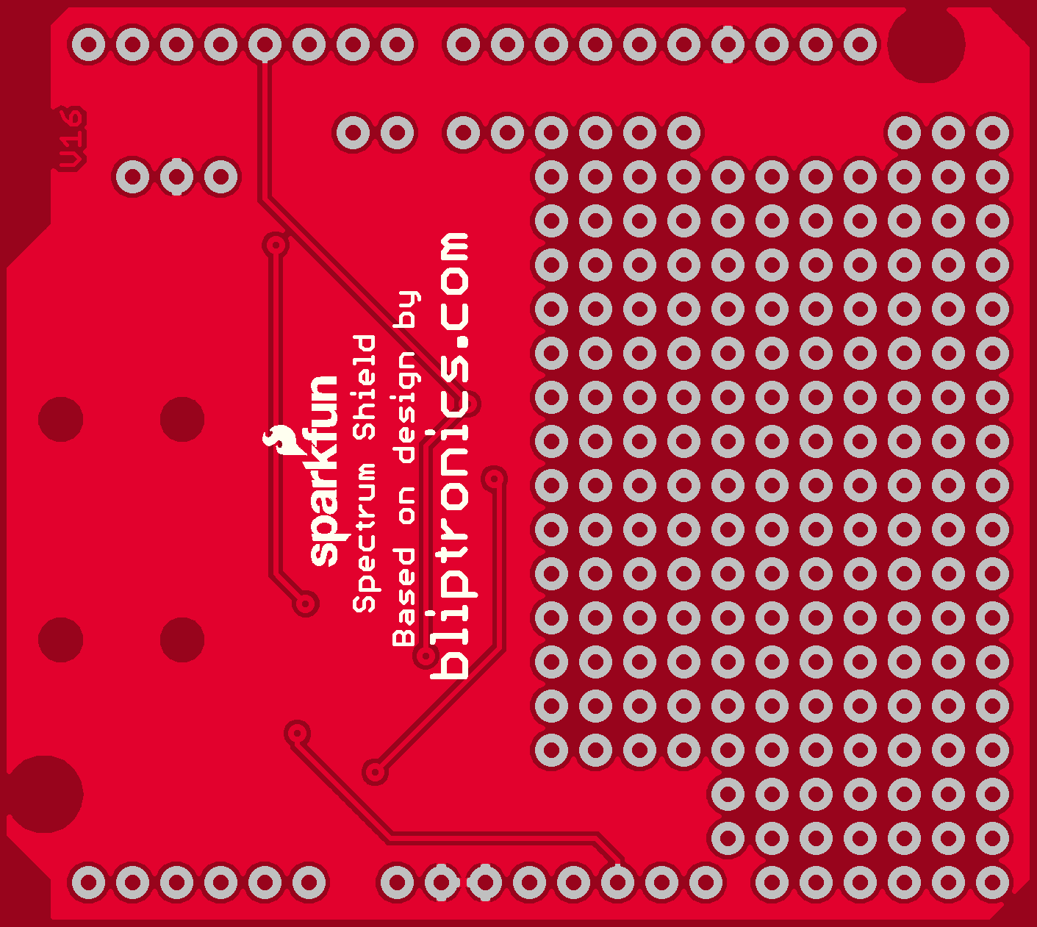
products/13116/display/Spectrum_Shield_bottom_board.png
