sparkfun/3D_Models/products/13120/geometry_edit_blender/MG2639_20Cellular_20Shield_top_board.png

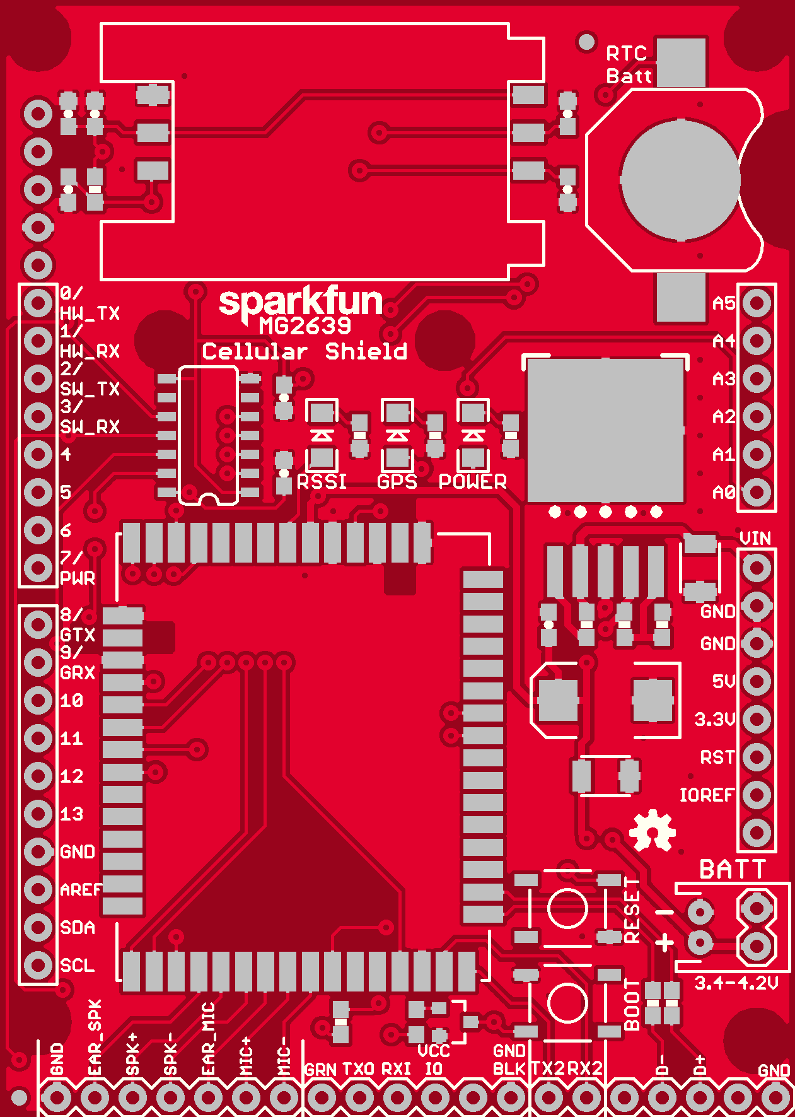
products/13120/geometry_edit_blender/MG2639_20Cellular_20Shield_top_board.png
