sparkfun/3D_Models/products/13124/geometry_edit_blender/Proto_Pedal_bottom_board.png

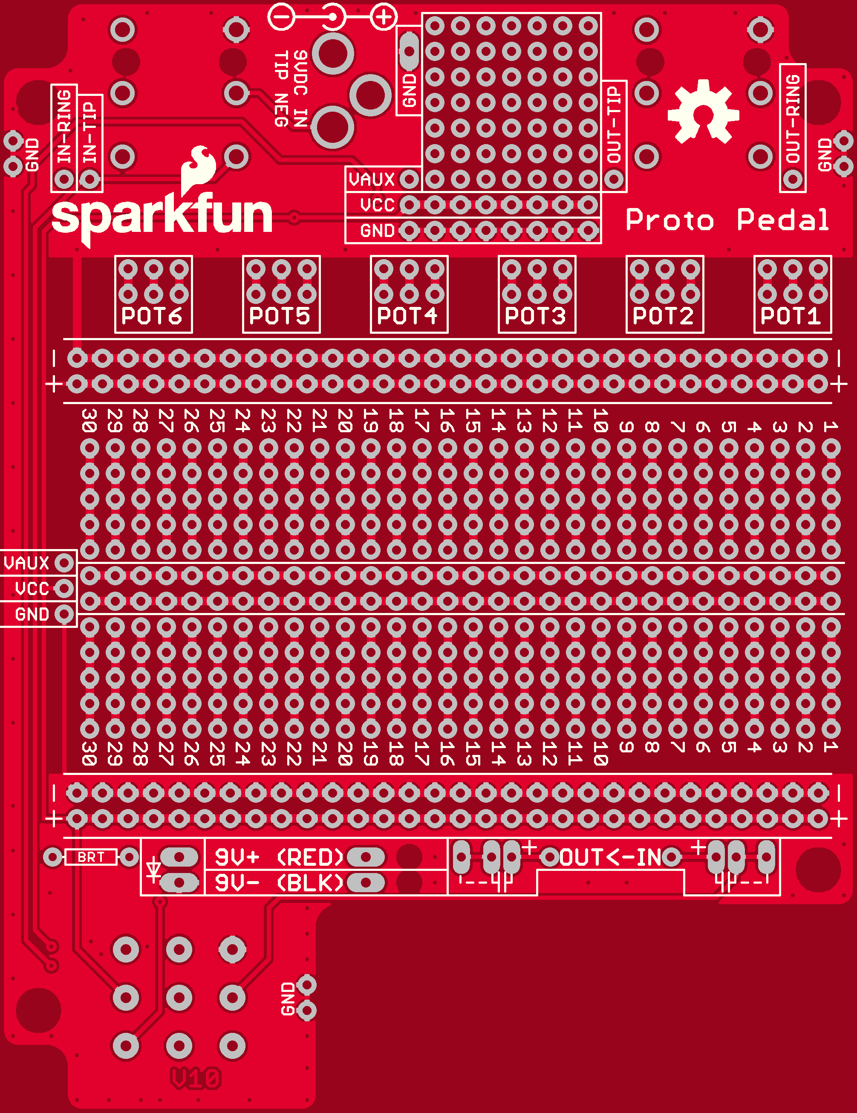
products/13124/geometry_edit_blender/Proto_Pedal_bottom_board.png
