sparkfun/3D_Models/products/13155/display/SparkFun_Stepoko_bottom_board.png

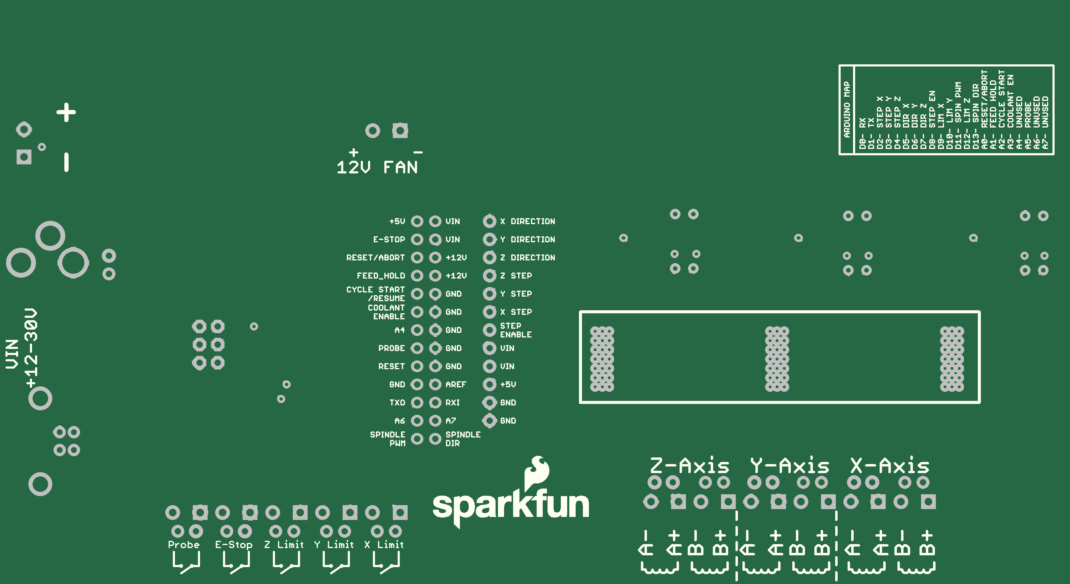
products/13155/display/SparkFun_Stepoko_bottom_board.png
