sparkfun/3D_Models/products/13157/geometry_edit_blender/SparkFun_Breadboard_Power_Supply_3_3_1_8SMD_bottom_board.png

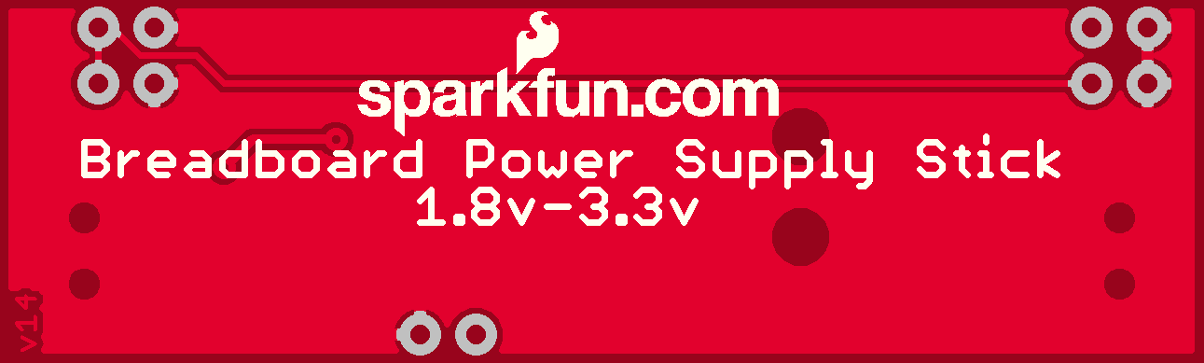
products/13157/geometry_edit_blender/SparkFun_Breadboard_Power_Supply_3_3_1_8SMD_bottom_board.png
