sparkfun/3D_Models/products/13190/display/Serial_7_Segment_Shield_top_board.png

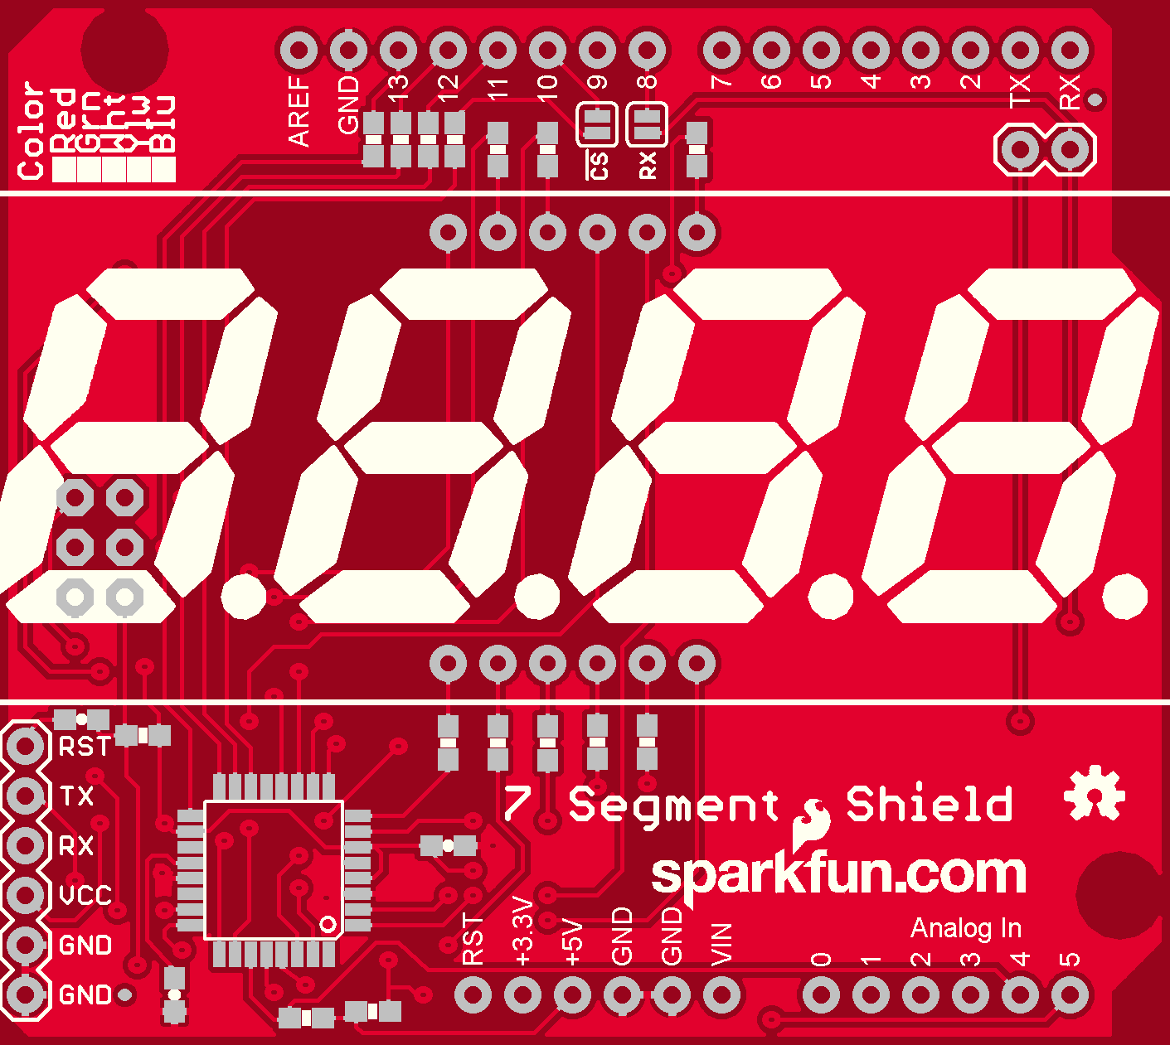
products/13190/display/Serial_7_Segment_Shield_top_board.png
