sparkfun/3D_Models/products/13229/geometry_edit_blender/SparkFun_FreeSoC2_top_board.png

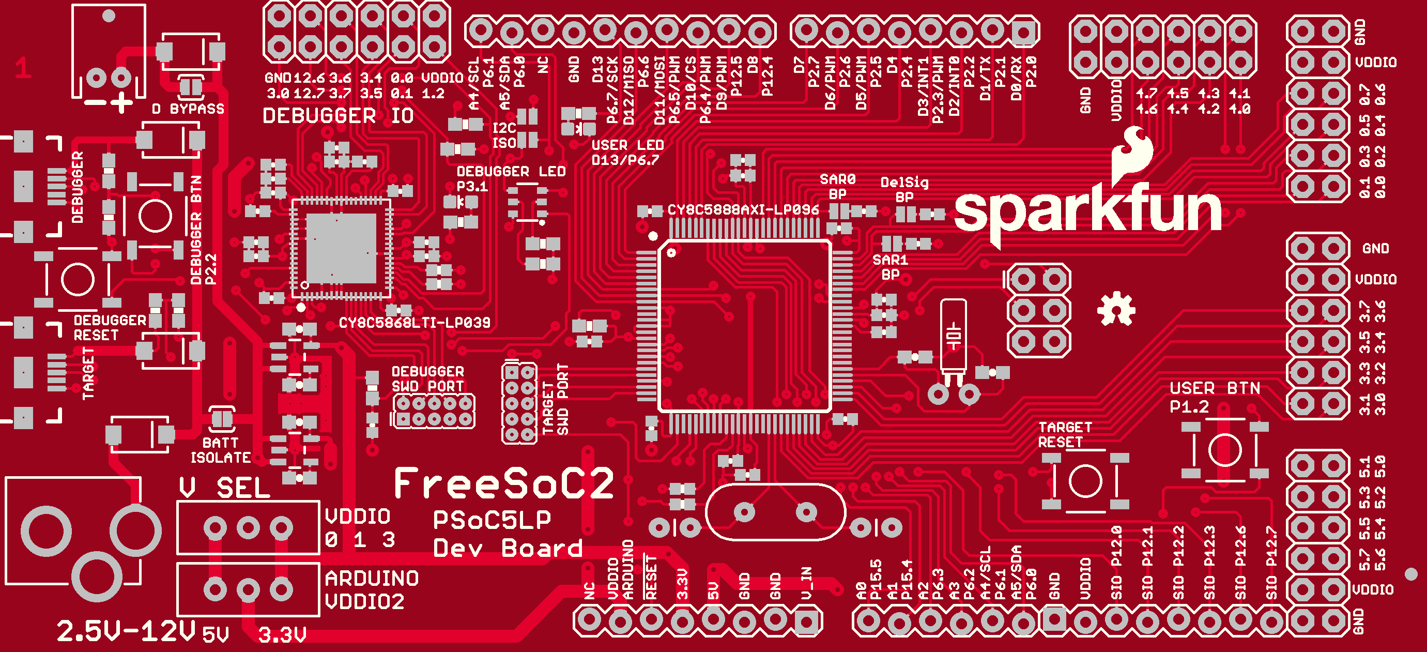
products/13229/geometry_edit_blender/SparkFun_FreeSoC2_top_board.png
