sparkfun/3D_Models/products/13230/display/SparkFun_20HX711_20Load_20Cell_bottom_board.png

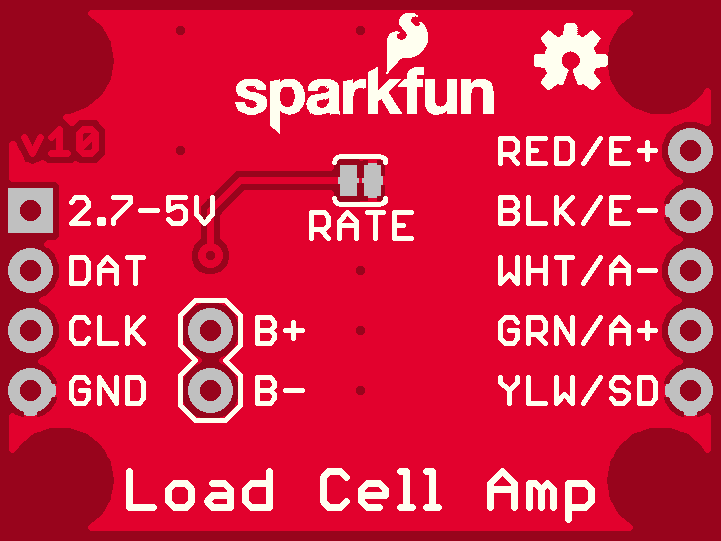
products/13230/display/SparkFun_20HX711_20Load_20Cell_bottom_board.png
