sparkfun/3D_Models/products/13231/display/SparkFun_ESP8266_Thing_top_board.png

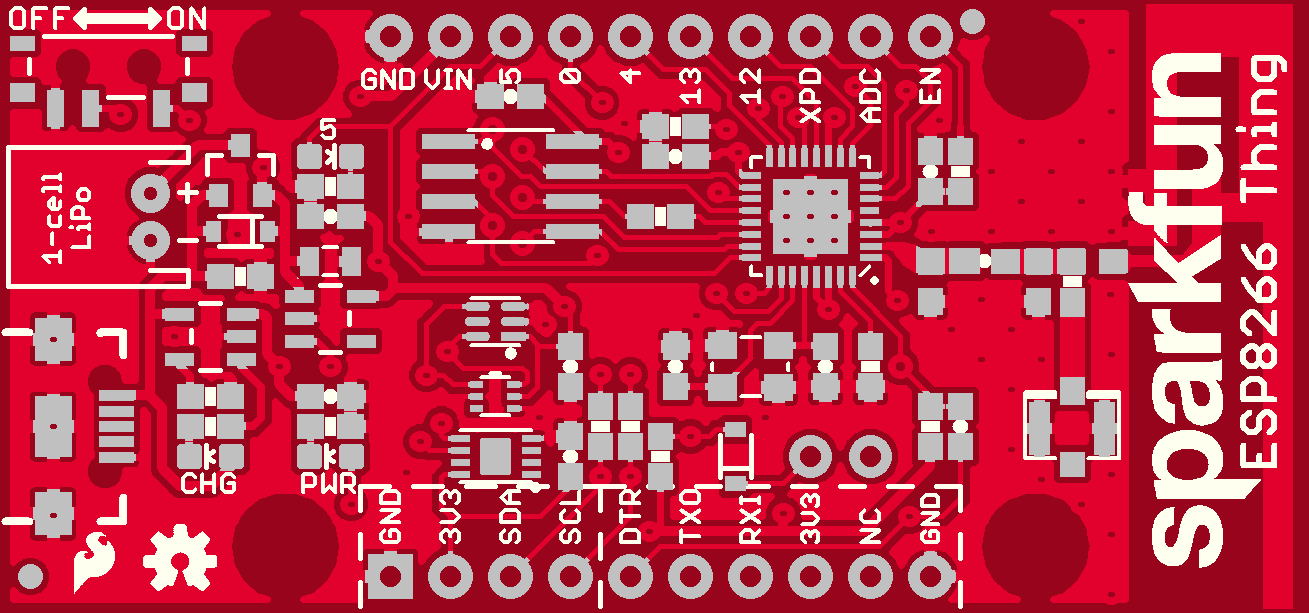
products/13231/display/SparkFun_ESP8266_Thing_top_board.png
