sparkfun/3D_Models/products/13266/display/SparkFun_Thermocouple_Breakout_bottom_board.png

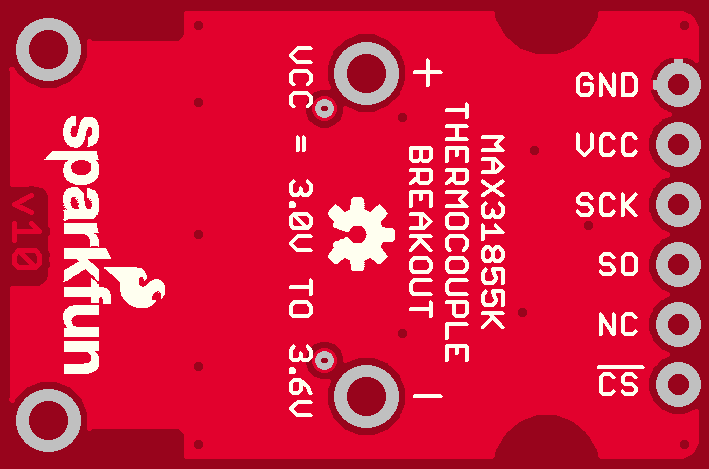
products/13266/display/SparkFun_Thermocouple_Breakout_bottom_board.png
