sparkfun/3D_Models/products/13266/geometry_edit_blender/SparkFun_Thermocouple_Breakout_top_board.png

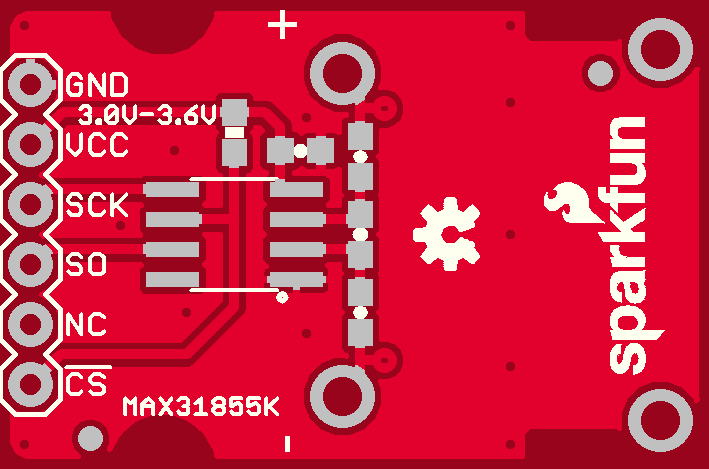
products/13266/geometry_edit_blender/SparkFun_Thermocouple_Breakout_top_board.png
