sparkfun/3D_Models/products/13284/display/SparkFun_LSM9DS1_Breakout_top_board.png

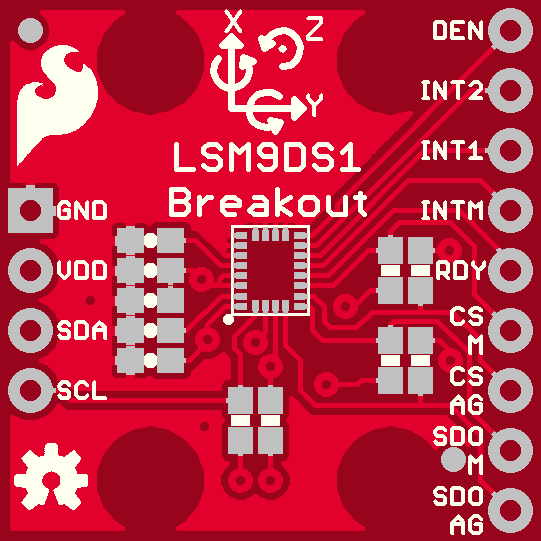
products/13284/display/SparkFun_LSM9DS1_Breakout_top_board.png
