sparkfun/3D_Models/products/13288/display/SparkFun_Teensy_Adapter_top_board.png

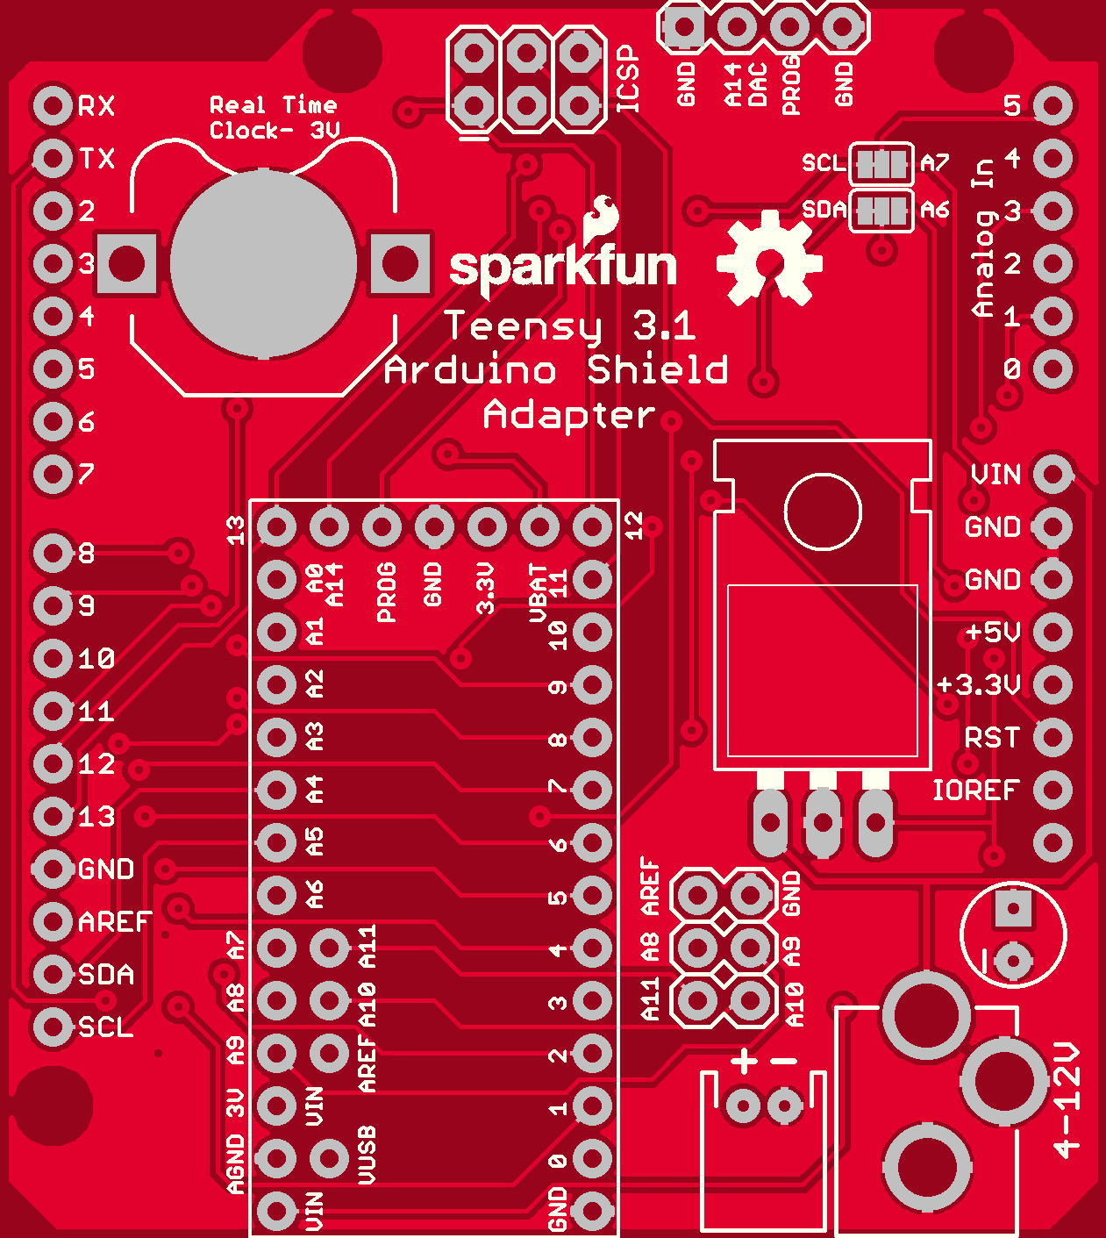
products/13288/display/SparkFun_Teensy_Adapter_top_board.png
