sparkfun/3D_Models/products/13321/display/sparkfun_photon_p1_top_board.png

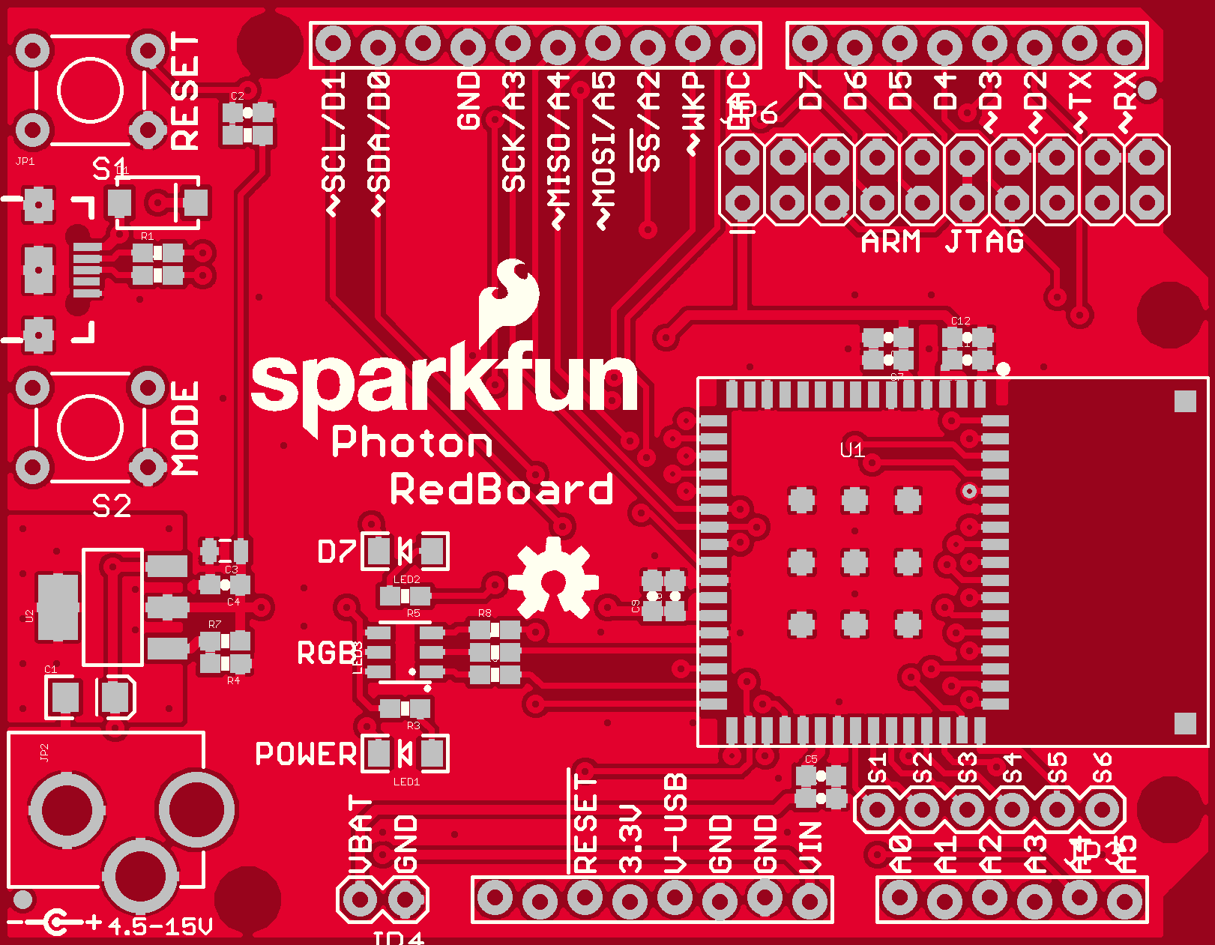
products/13321/display/sparkfun_photon_p1_top_board.png
