sparkfun/3D_Models/products/13321/display/sparkfun_photon_redboard_top_board.png

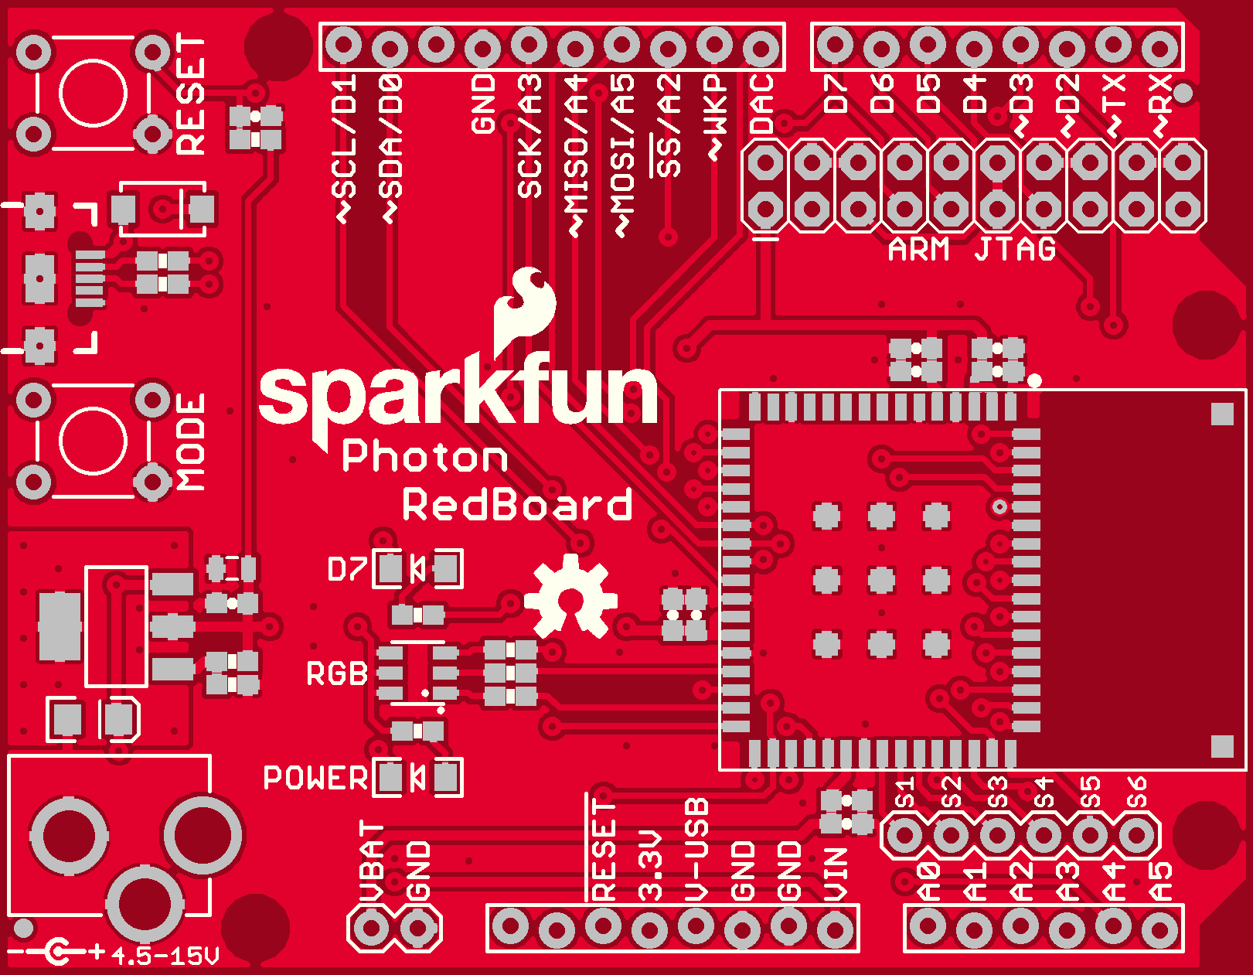
products/13321/display/sparkfun_photon_redboard_top_board.png
