sparkfun/3D_Models/products/13321/geometry_edit_blender/sparkfun_photon_p1_bottom_board.png

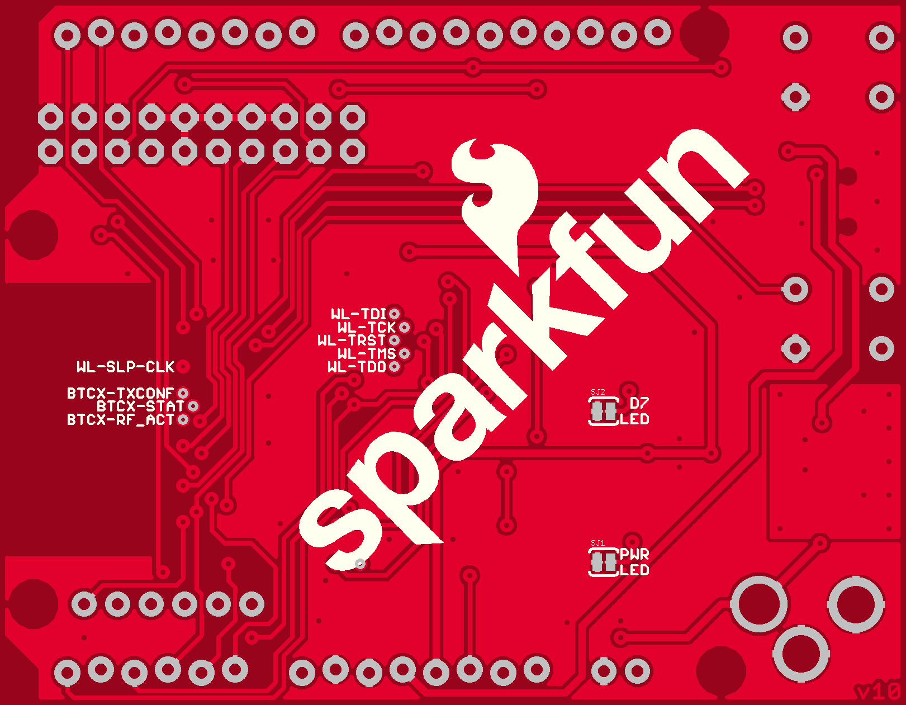
products/13321/geometry_edit_blender/sparkfun_photon_p1_bottom_board.png
