sparkfun/3D_Models/products/13328/display/SparkFun_Photon_Wearable_Shield_bottom_board.png

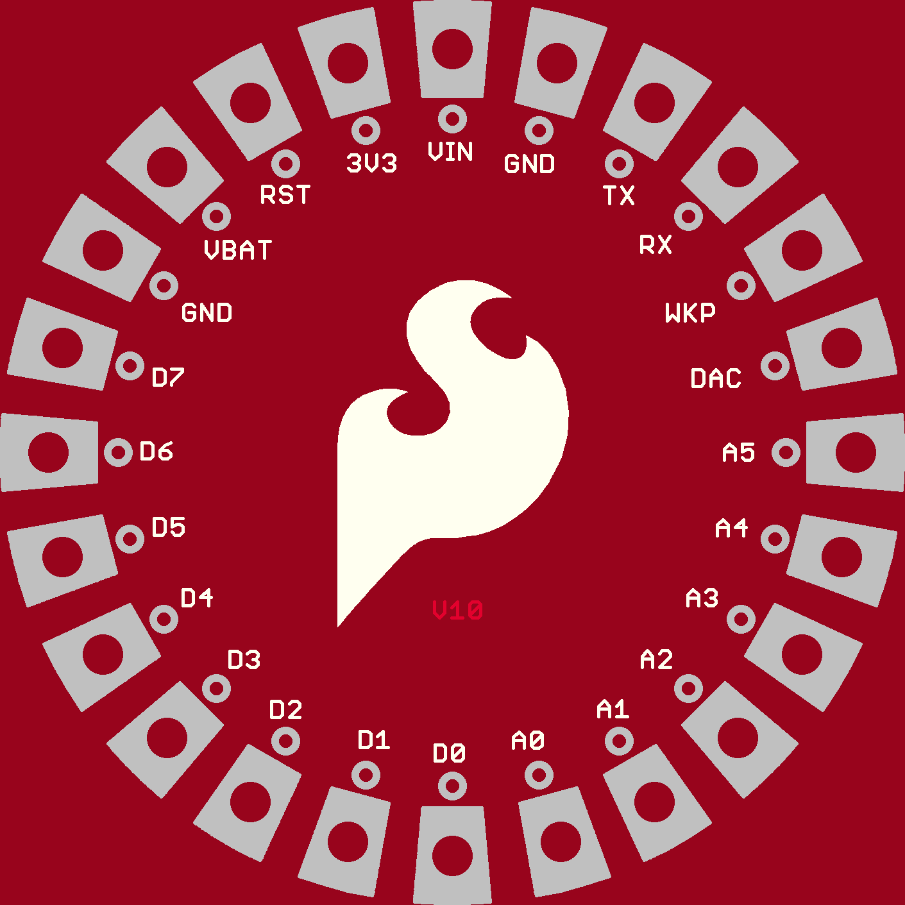
products/13328/display/SparkFun_Photon_Wearable_Shield_bottom_board.png
