sparkfun/3D_Models/products/13339/display/LSM6DS3_Breakout_bottom_board.png

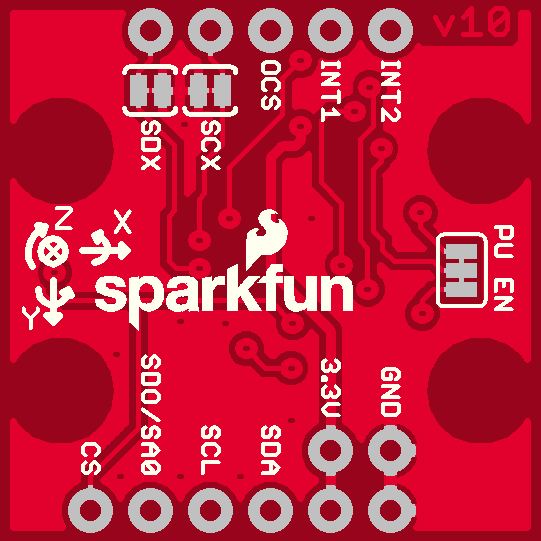
products/13339/display/LSM6DS3_Breakout_bottom_board.png
