sparkfun/3D_Models/products/13339/display/LSM6DS3_Breakout_top_board.png

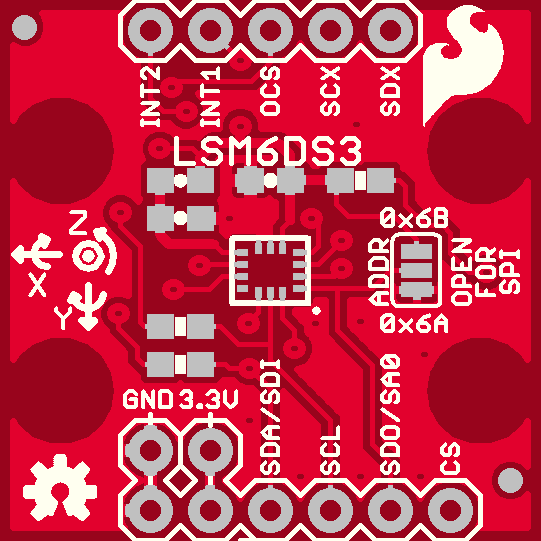
products/13339/display/LSM6DS3_Breakout_top_board.png
