sparkfun/3D_Models/products/13345/renderings/13345.png

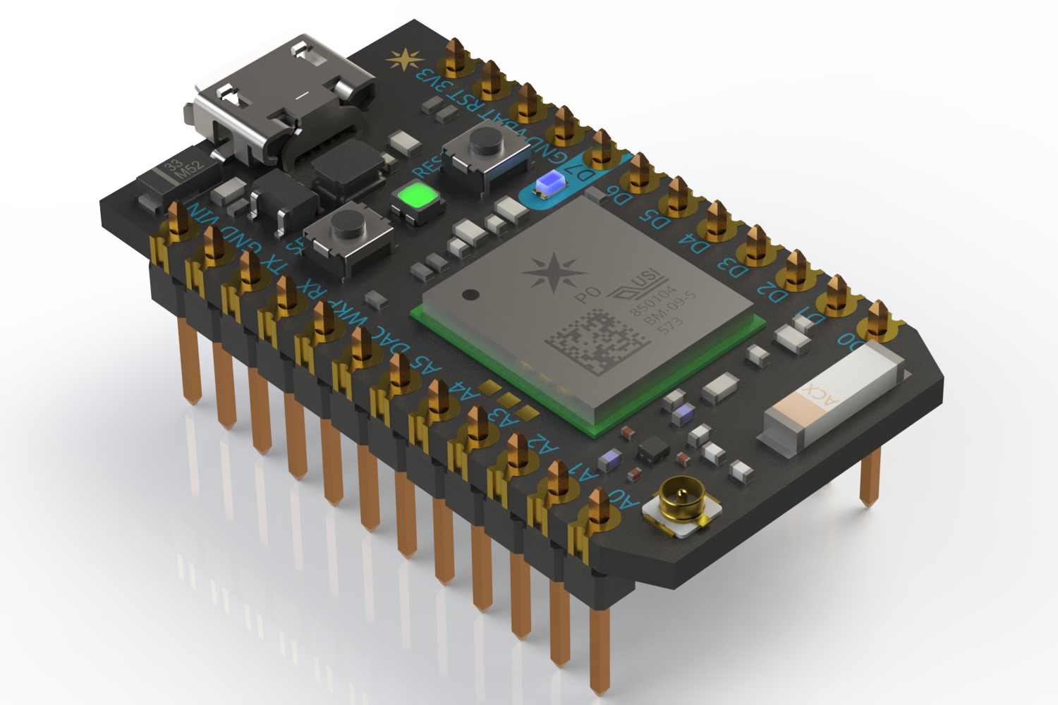
products/13345/renderings/13345.png
