sparkfun/3D_Models/products/13598/display/Photon_Proto_Shield_top_board.png

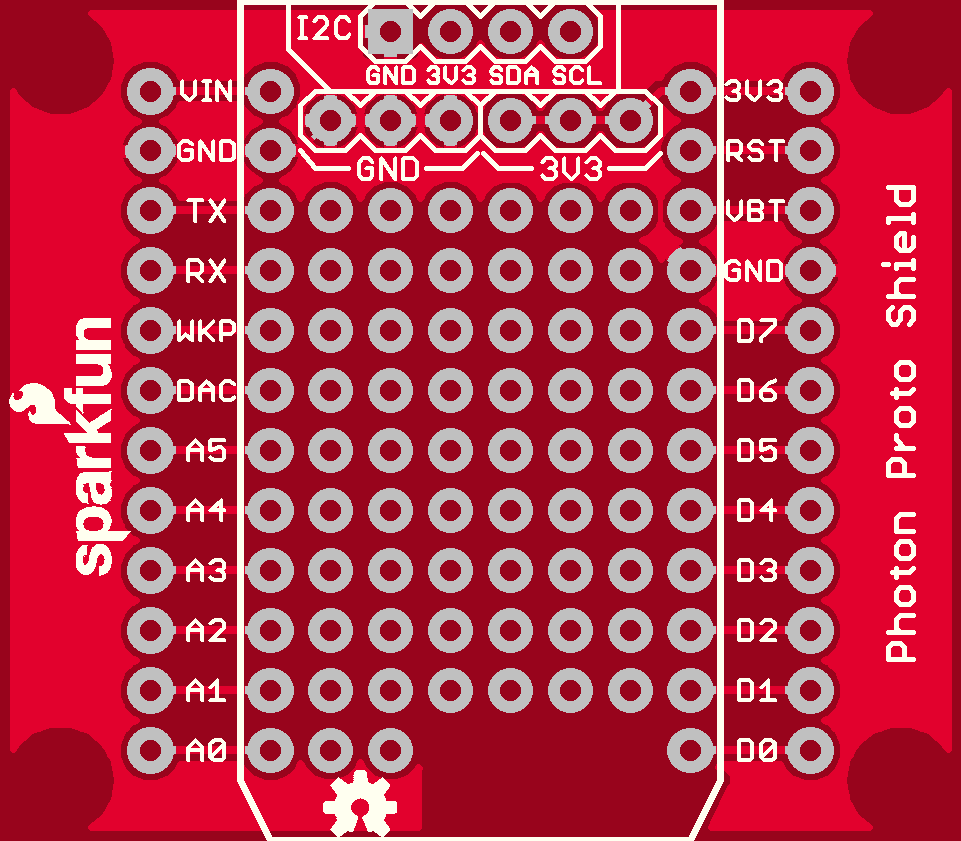
products/13598/display/Photon_Proto_Shield_top_board.png
