sparkfun/3D_Models/products/13598/geometry_edit_blender/Photon_Proto_Shield_bottom_board.png

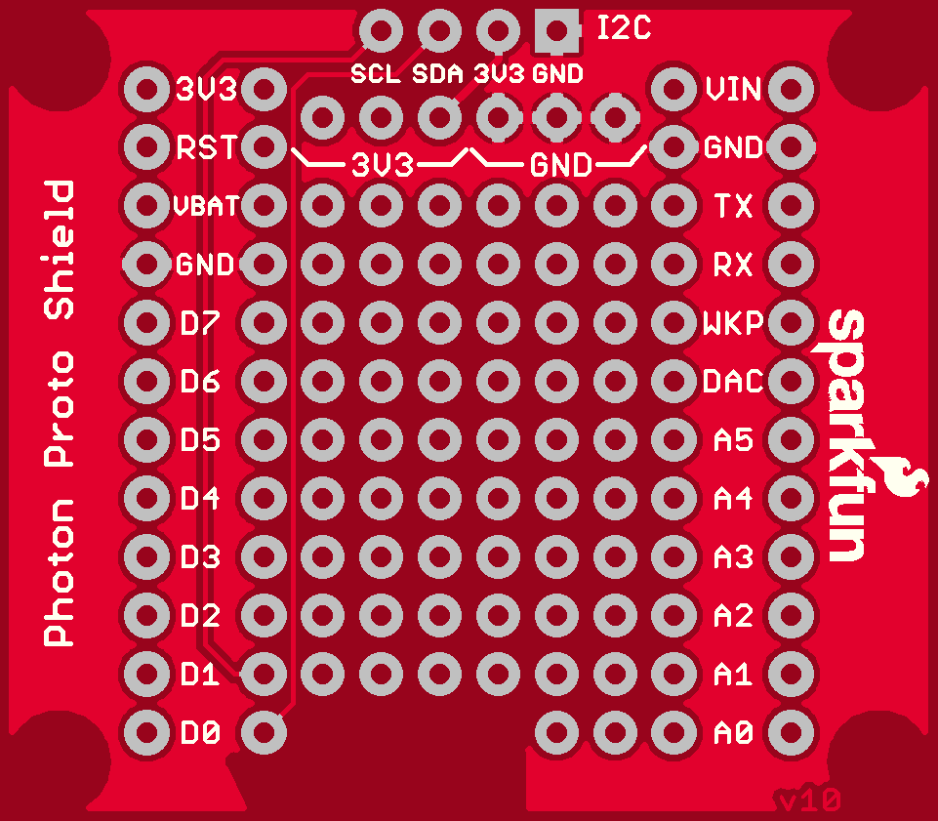
products/13598/geometry_edit_blender/Photon_Proto_Shield_bottom_board.png
