sparkfun/3D_Models/products/13601/display/SparkFun_SX1509_Breakout_top_board.png

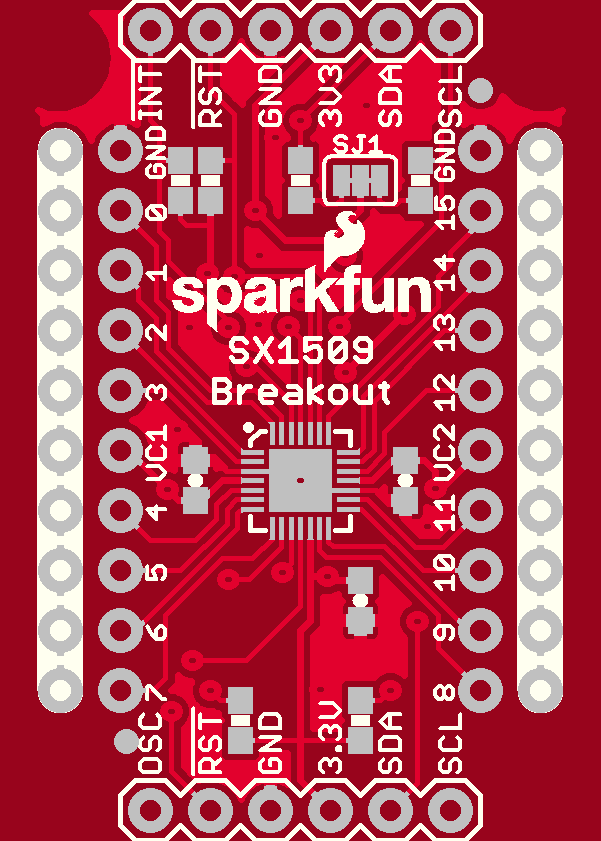
products/13601/display/SparkFun_SX1509_Breakout_top_board.png
