sparkfun/3D_Models/products/13628/display/Photon_Micro_OLED_Shield_top_board.png

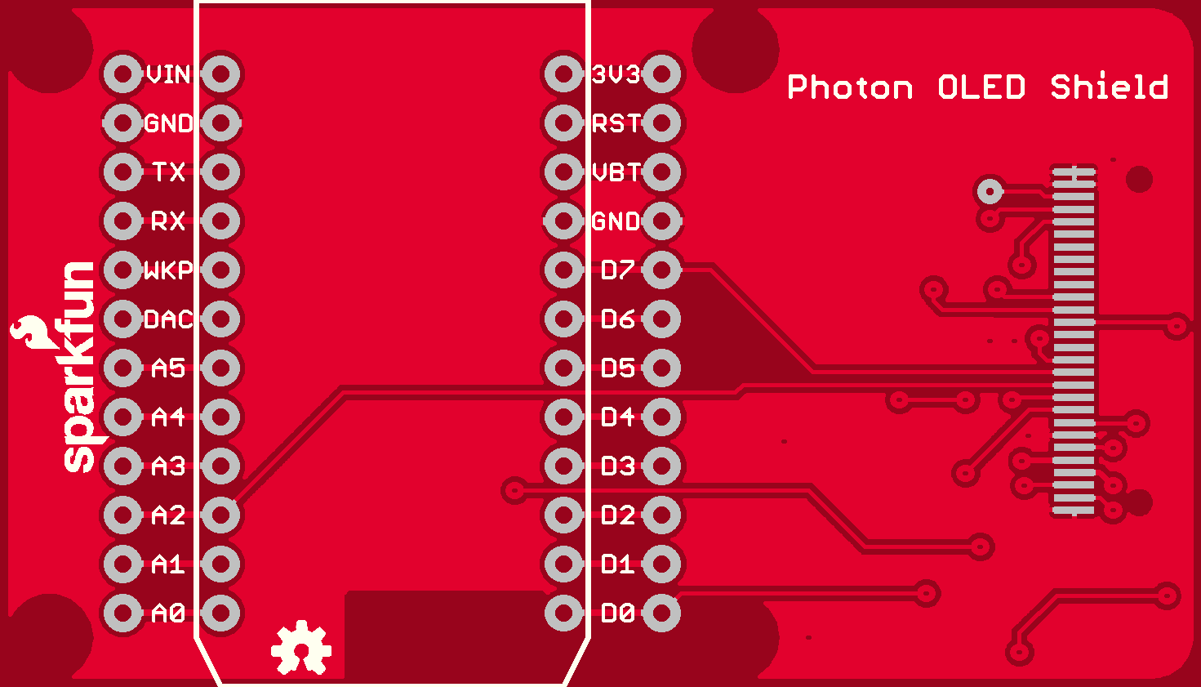
products/13628/display/Photon_Micro_OLED_Shield_top_board.png
