sparkfun/3D_Models/products/13630/display/SparkFun_Photon_Weather_Shield_bottom_board.png

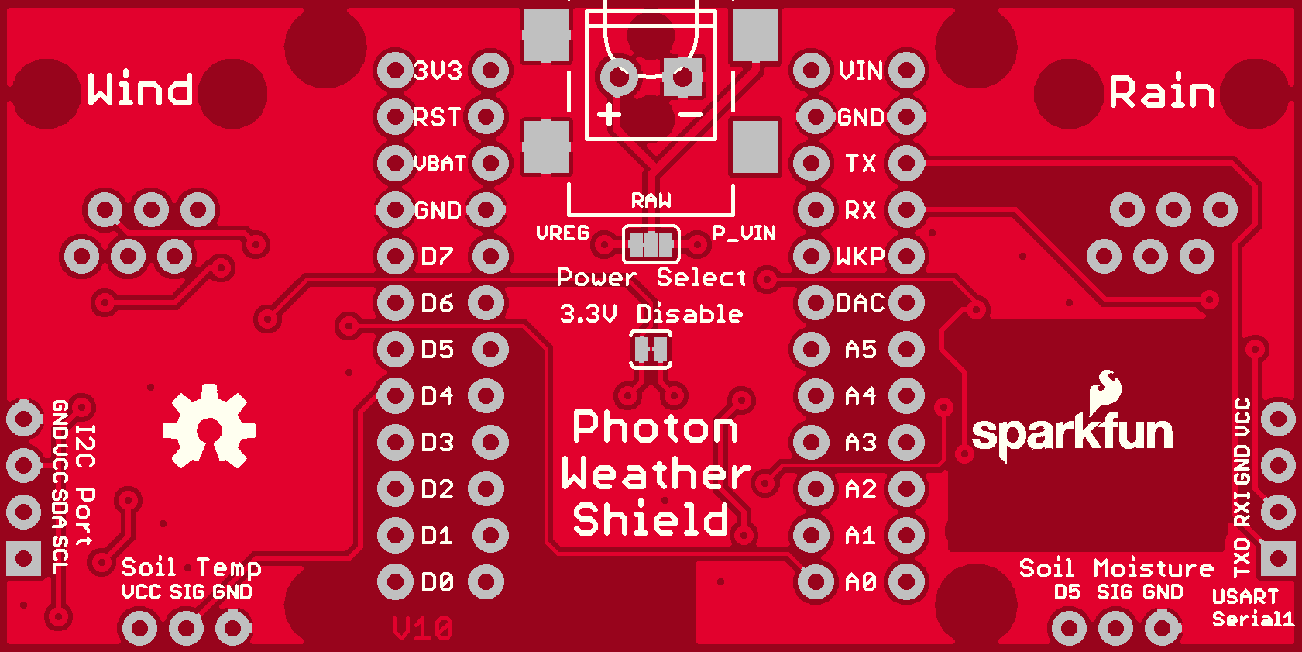
products/13630/display/SparkFun_Photon_Weather_Shield_bottom_board.png
