sparkfun/3D_Models/products/13630/display/SparkFun_Photon_Weather_Shield_top_board.png

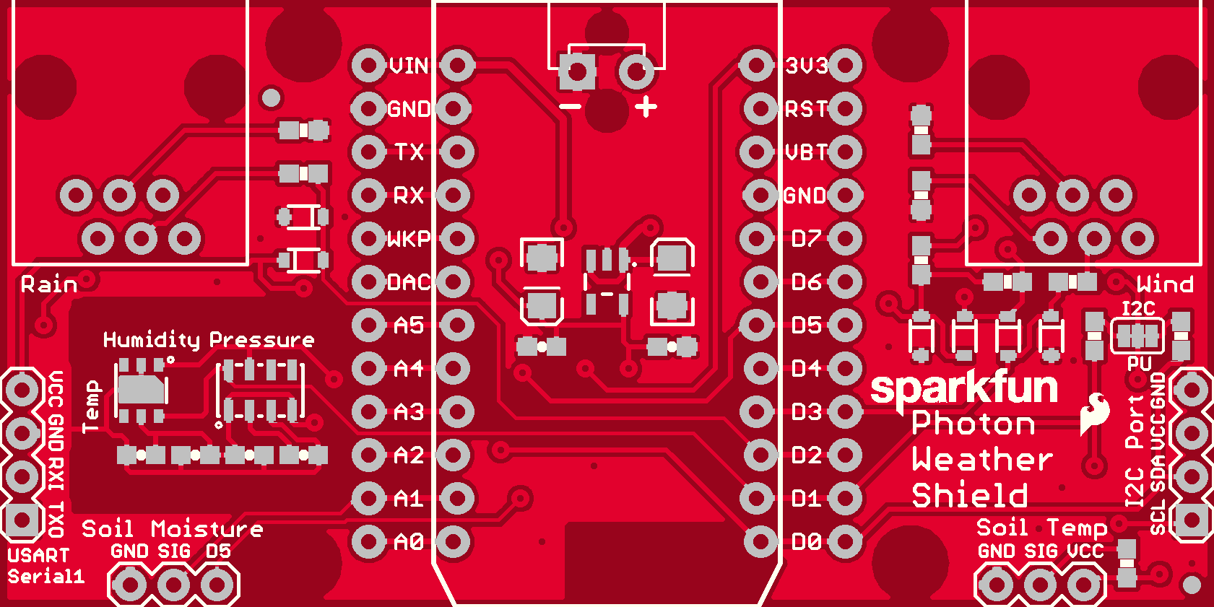
products/13630/display/SparkFun_Photon_Weather_Shield_top_board.png
