sparkfun/3D_Models/products/13655/display/SparkFun_SOIC8_DIP_Adapter_bottom_board.png

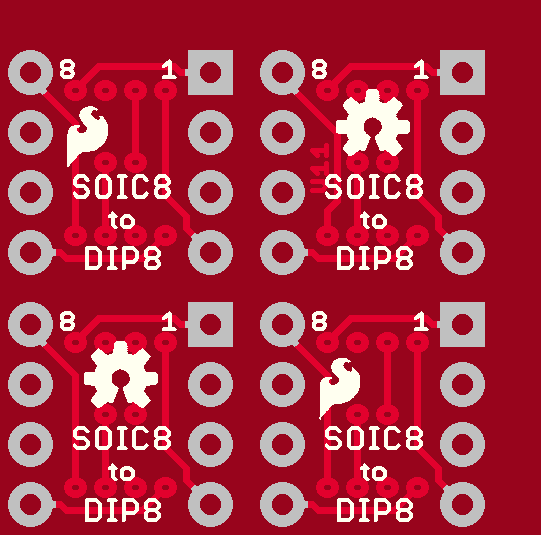
products/13655/display/SparkFun_SOIC8_DIP_Adapter_bottom_board.png
