sparkfun/3D_Models/products/13655/geometry_edit_blender/SparkFun_SOIC8_DIP_Adapter_top_board.png

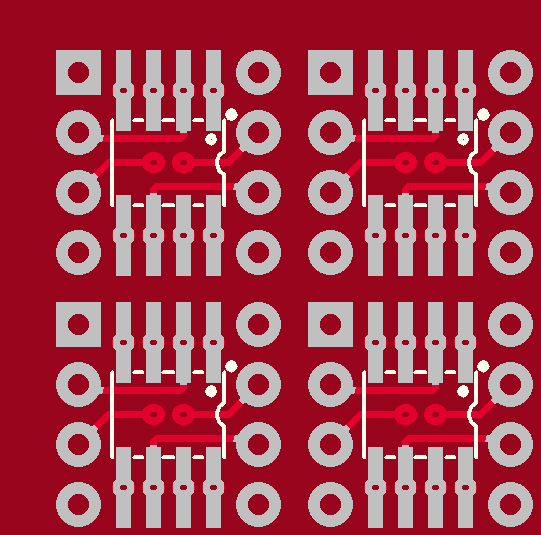
products/13655/geometry_edit_blender/SparkFun_SOIC8_DIP_Adapter_top_board.png
