sparkfun/3D_Models/products/13664/geometry_edit_blender/sparkfun_samd21_mini_breakout_top_board.png

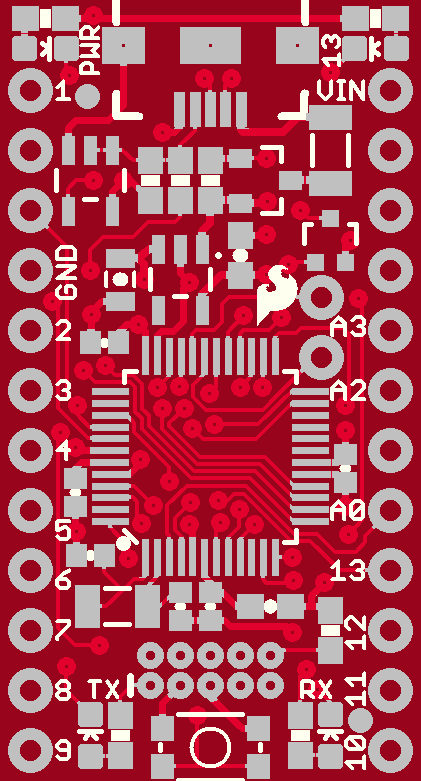
products/13664/geometry_edit_blender/sparkfun_samd21_mini_breakout_top_board.png
