sparkfun/3D_Models/products/13672/display/sparkfun_samd21_pro_breakout_bottom_board.png

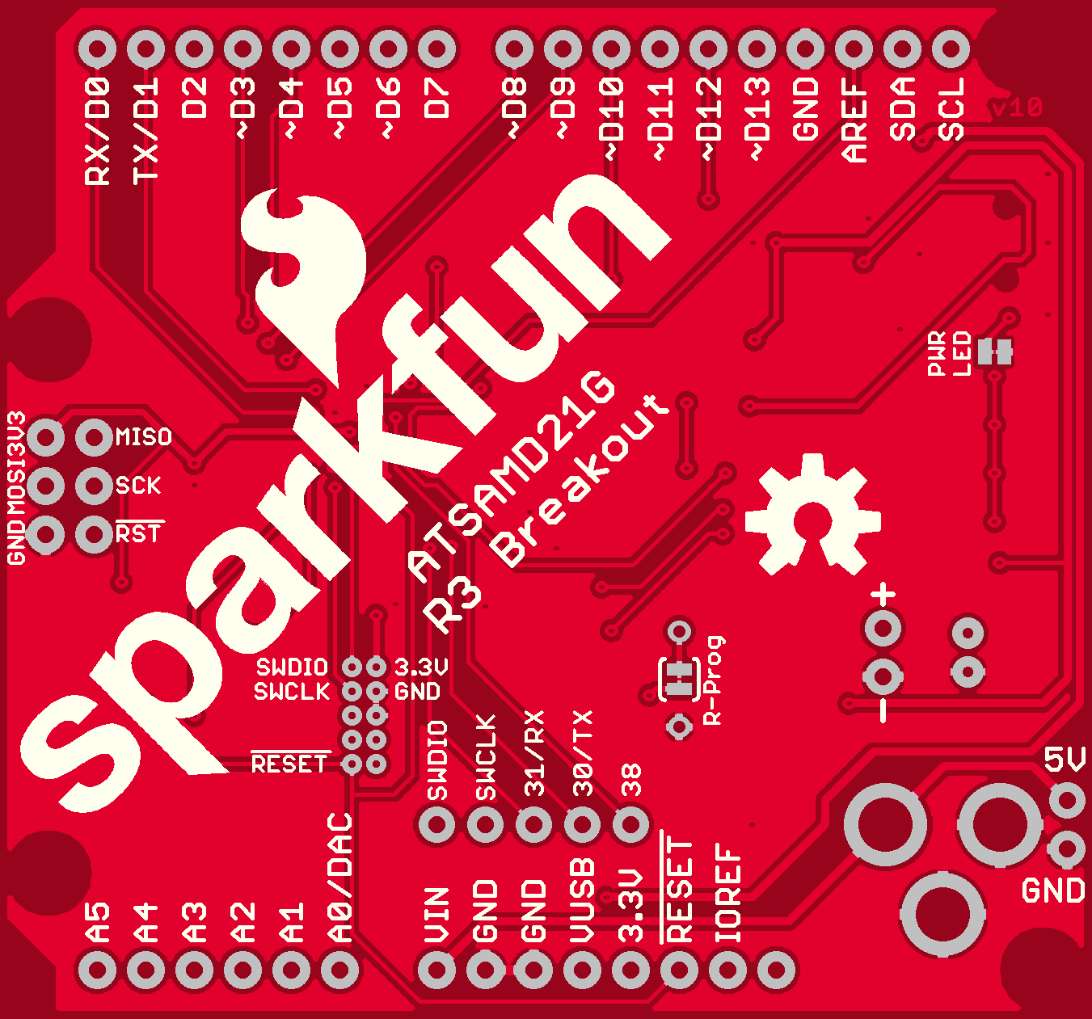
products/13672/display/sparkfun_samd21_pro_breakout_bottom_board.png
