sparkfun/3D_Models/products/13683/display/SHT1x_Breakout_bottom_board.png

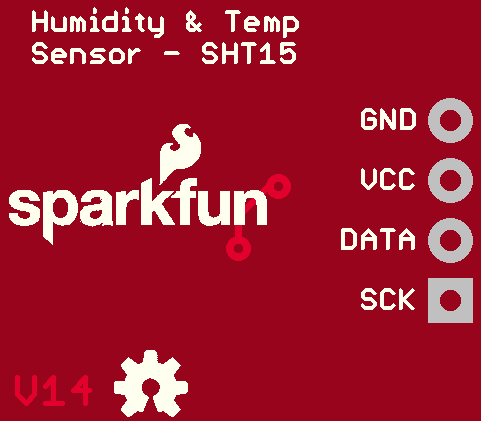
products/13683/display/SHT1x_Breakout_bottom_board.png
