sparkfun/3D_Models/products/13683/display/SHT1x_Breakout_top_board.png

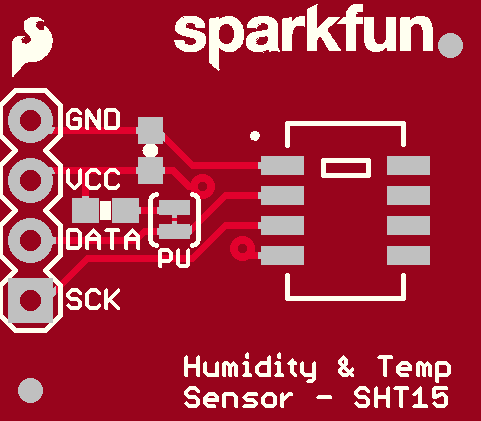
products/13683/display/SHT1x_Breakout_top_board.png
