sparkfun/3D_Models/products/13684/display/MyoWare_Power_Shield_bottom_board.png

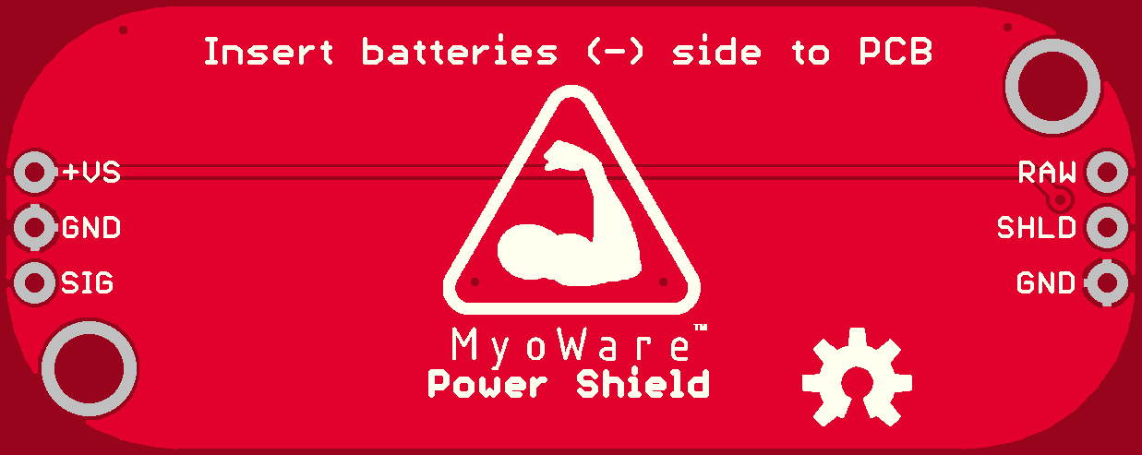
products/13684/display/MyoWare_Power_Shield_bottom_board.png
