sparkfun/3D_Models/products/13688/geometry_edit_blender/MyoWare_LED_Shield_bottom_board.png

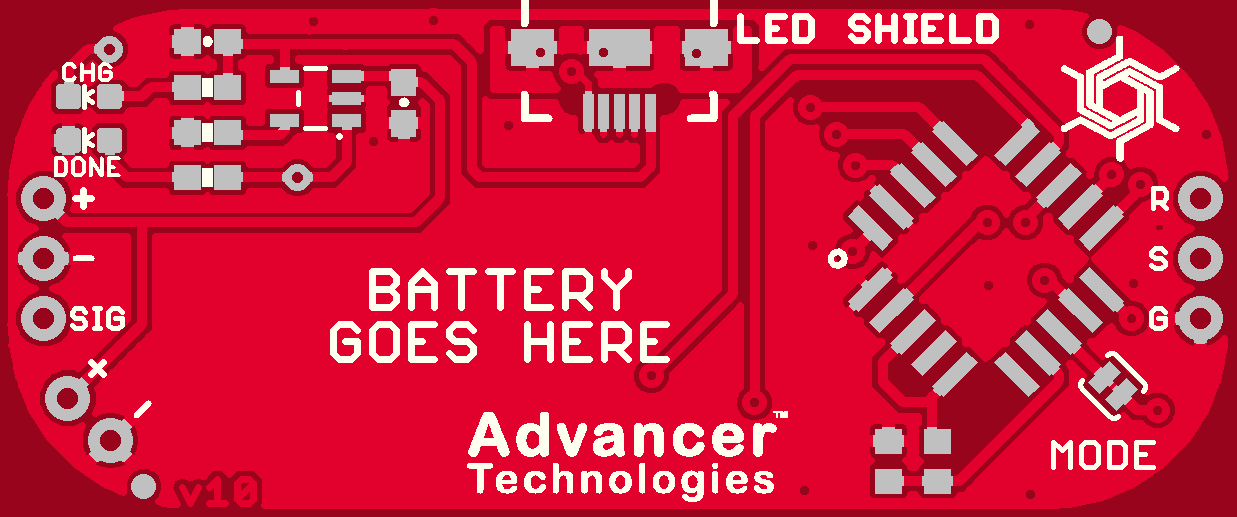
products/13688/geometry_edit_blender/MyoWare_LED_Shield_bottom_board.png
