sparkfun/3D_Models/products/13709/display/MyoWare_Proto_Shield_top_board.png

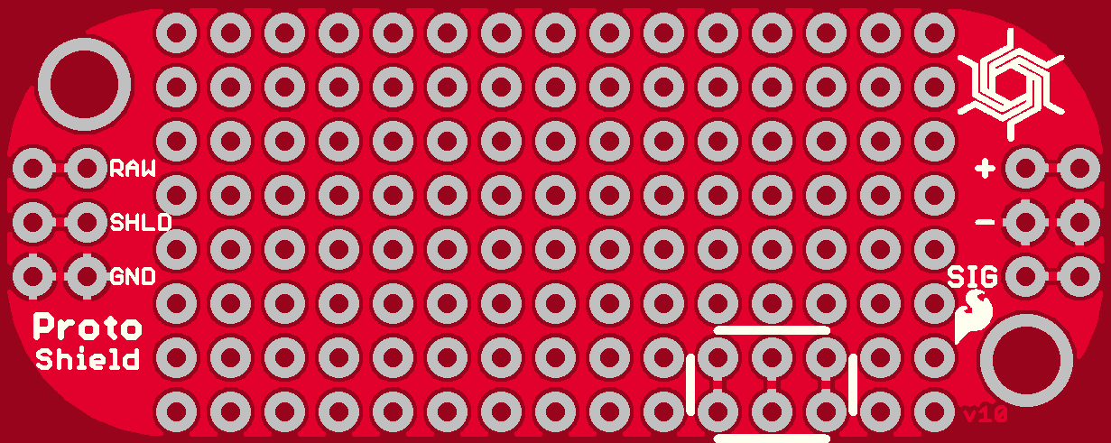
products/13709/display/MyoWare_Proto_Shield_top_board.png
