sparkfun/3D_Models/products/13711/display/ESP8266_Thing_Dev_bottom_board.png

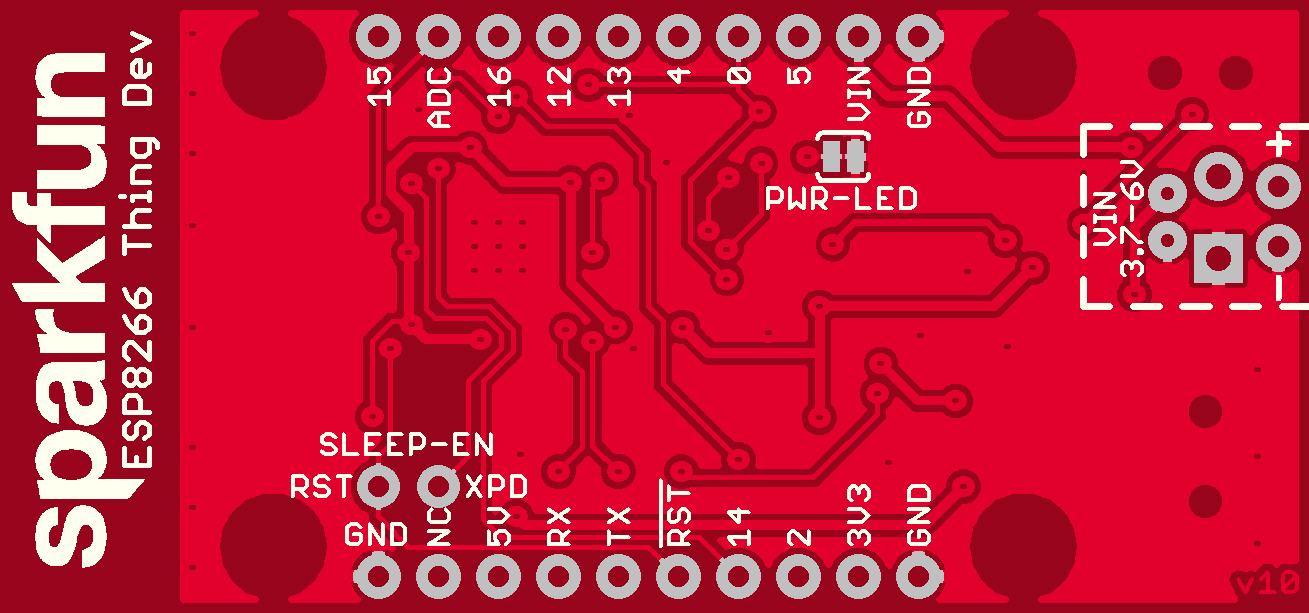
products/13711/display/ESP8266_Thing_Dev_bottom_board.png
