sparkfun/3D_Models/products/13711/display/ESP8266_Thing_Dev_top_board.png

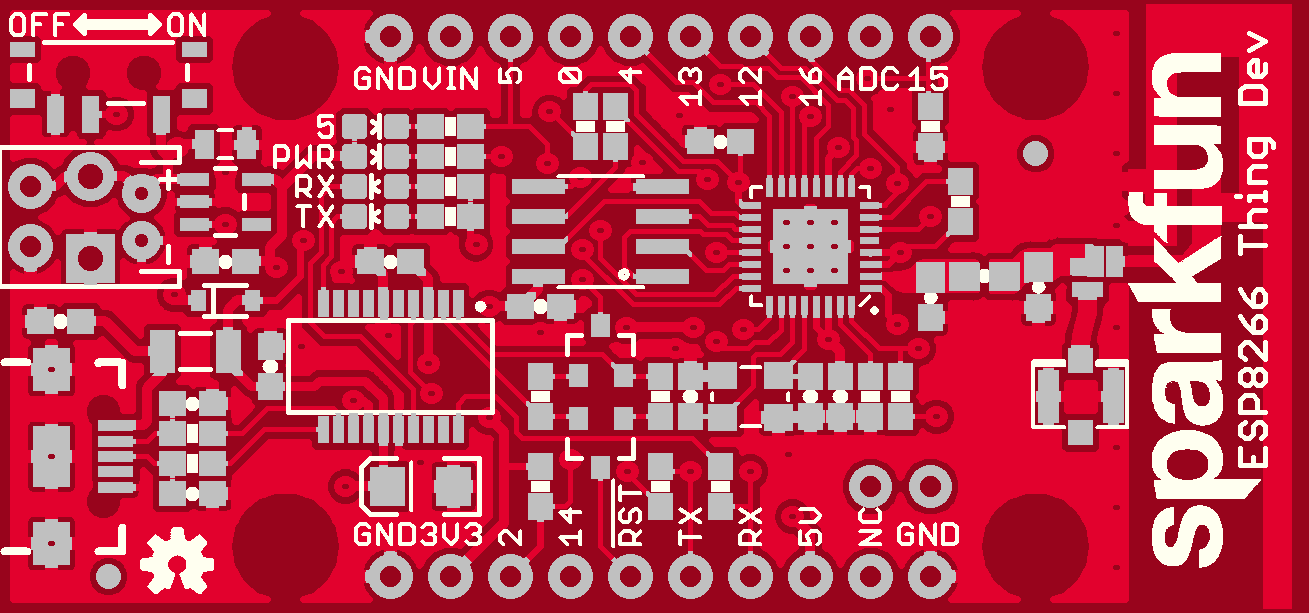
products/13711/display/ESP8266_Thing_Dev_top_board.png
