sparkfun/3D_Models/products/13762/display/SparkFun_MPU_9250_Breakout_top_board.png

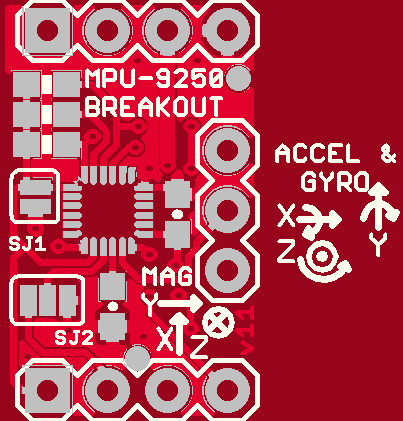
products/13762/display/SparkFun_MPU_9250_Breakout_top_board.png
