sparkfun/3D_Models/products/13762/geometry_edit_blender/SparkFun_MPU_9250_Breakout_bottom_board.png

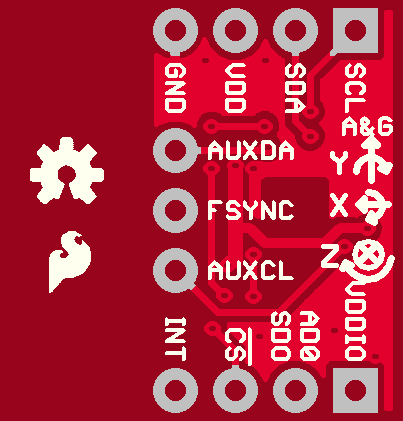
products/13762/geometry_edit_blender/SparkFun_MPU_9250_Breakout_bottom_board.png
