sparkfun/3D_Models/products/13794/display/SparkFun_Blynk_Board_ESP8266_bottom_board.png

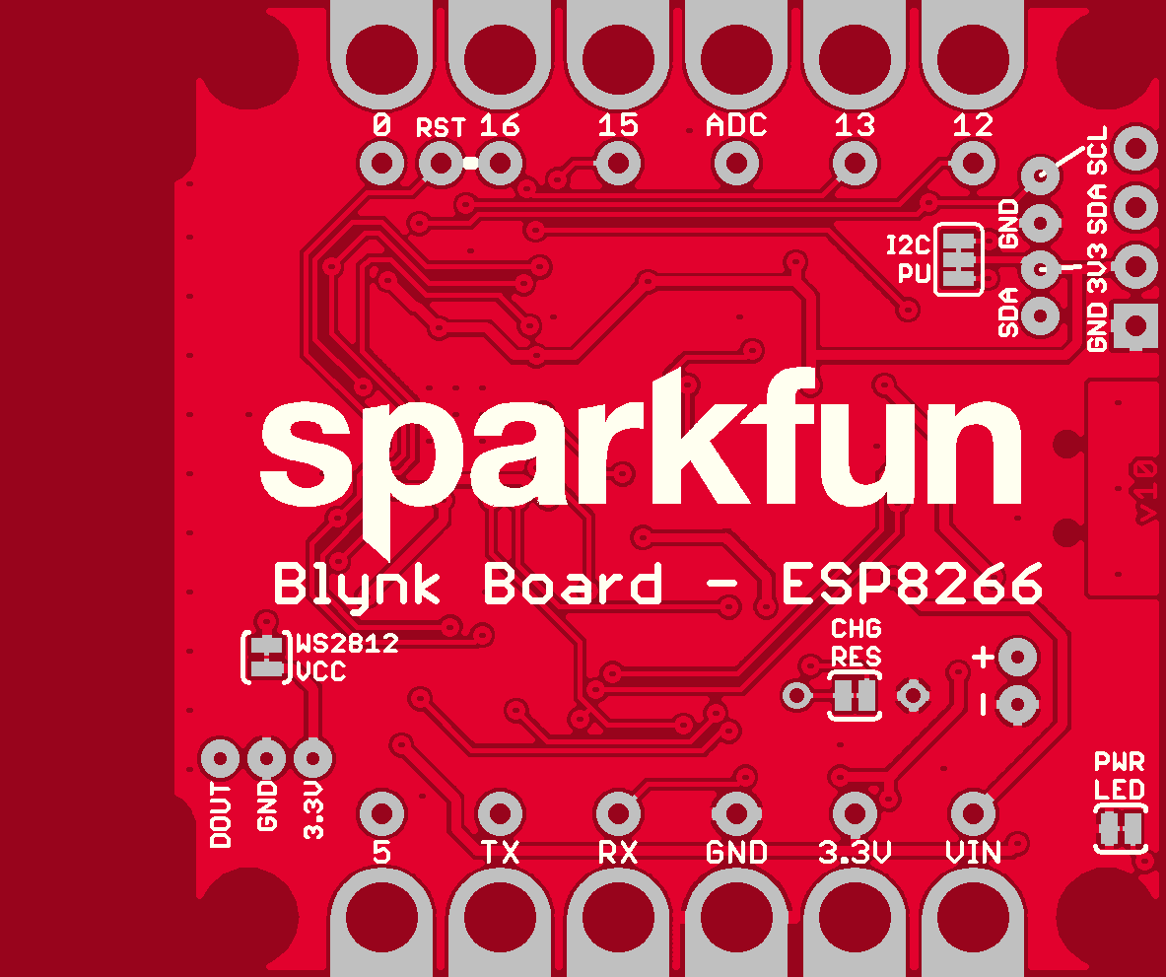
products/13794/display/SparkFun_Blynk_Board_ESP8266_bottom_board.png
