sparkfun/3D_Models/products/13872/geometry_edit_blender/SparkFun_Servo_Trigger_bottom_board.png

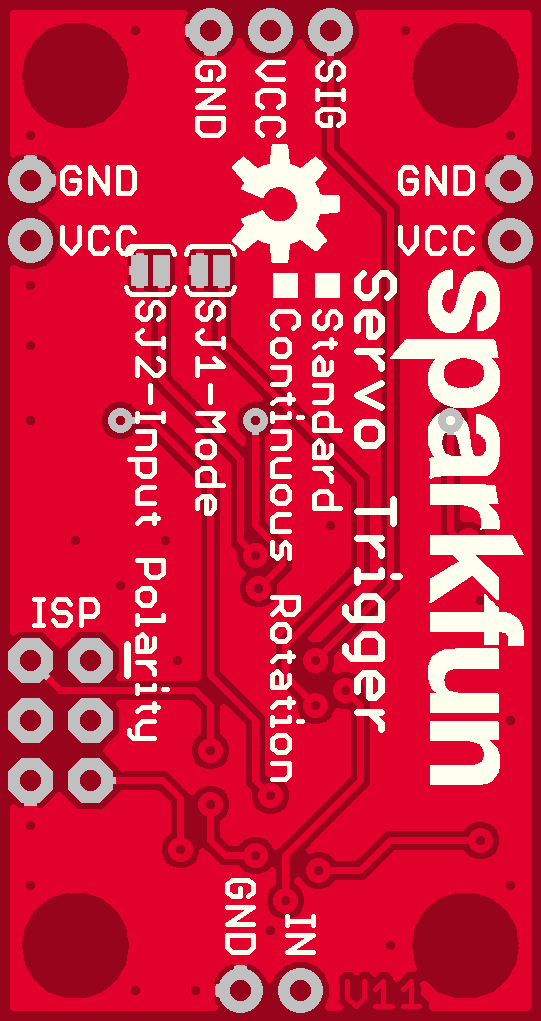
products/13872/geometry_edit_blender/SparkFun_Servo_Trigger_bottom_board.png
