sparkfun/3D_Models/products/13878/display/SparkFun_20Load_20Sensor_20Combinator_bottom_board.png

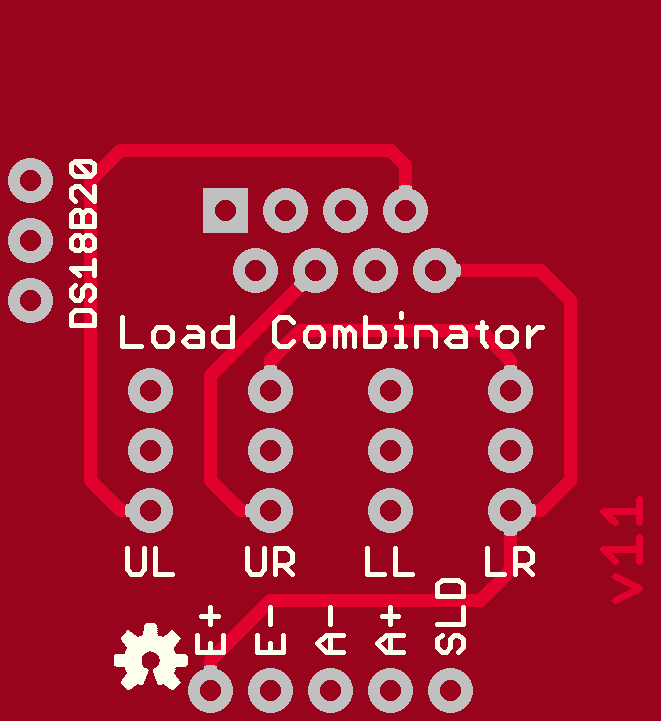
products/13878/display/SparkFun_20Load_20Sensor_20Combinator_bottom_board.png
