sparkfun/3D_Models/products/13879/display/SparkFun_HX711_Load_Cell_bottom_board.png

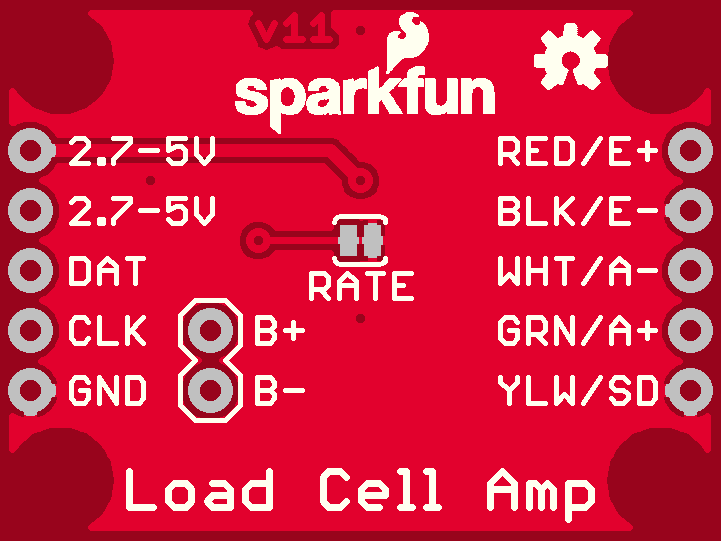
products/13879/display/SparkFun_HX711_Load_Cell_bottom_board.png
