sparkfun/3D_Models/products/13879/display/SparkFun_HX711_Load_Cell_top_board.png

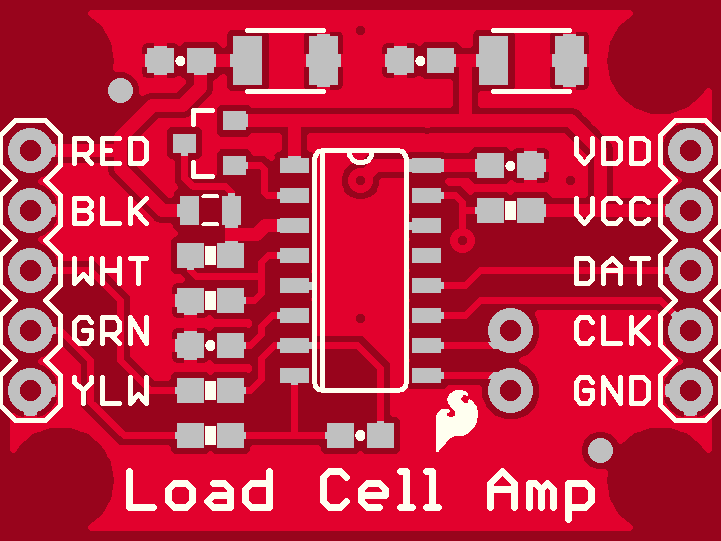
products/13879/display/SparkFun_HX711_Load_Cell_top_board.png
