sparkfun/3D_Models/products/13884/geometry_edit_blender/LP55231_breakout_bottom_board.png

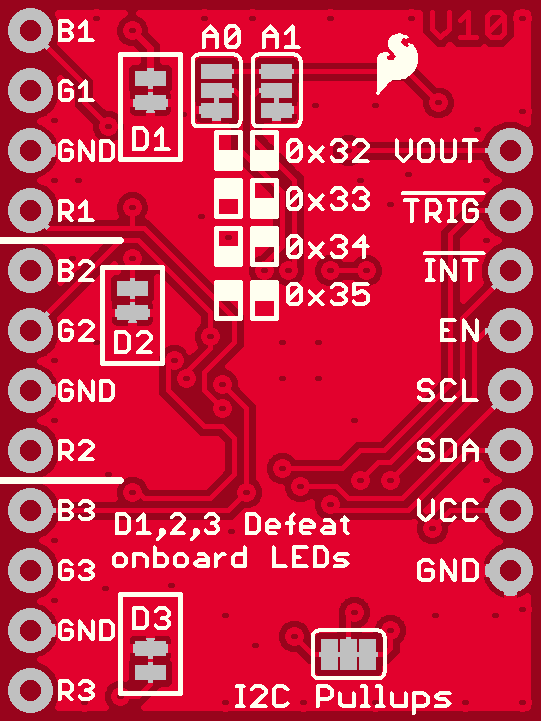
products/13884/geometry_edit_blender/LP55231_breakout_bottom_board.png
