sparkfun/3D_Models/products/13906/geometry_edit_blender/SparkFun_74HC4051_8_Channel_Mux_Breakout_bottom_board.png

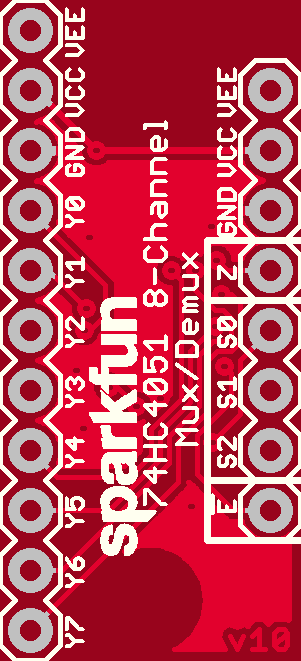
products/13906/geometry_edit_blender/SparkFun_74HC4051_8_Channel_Mux_Breakout_bottom_board.png
