sparkfun/3D_Models/products/13907/geometry_edit_blender/esp32_thing_top_board.png

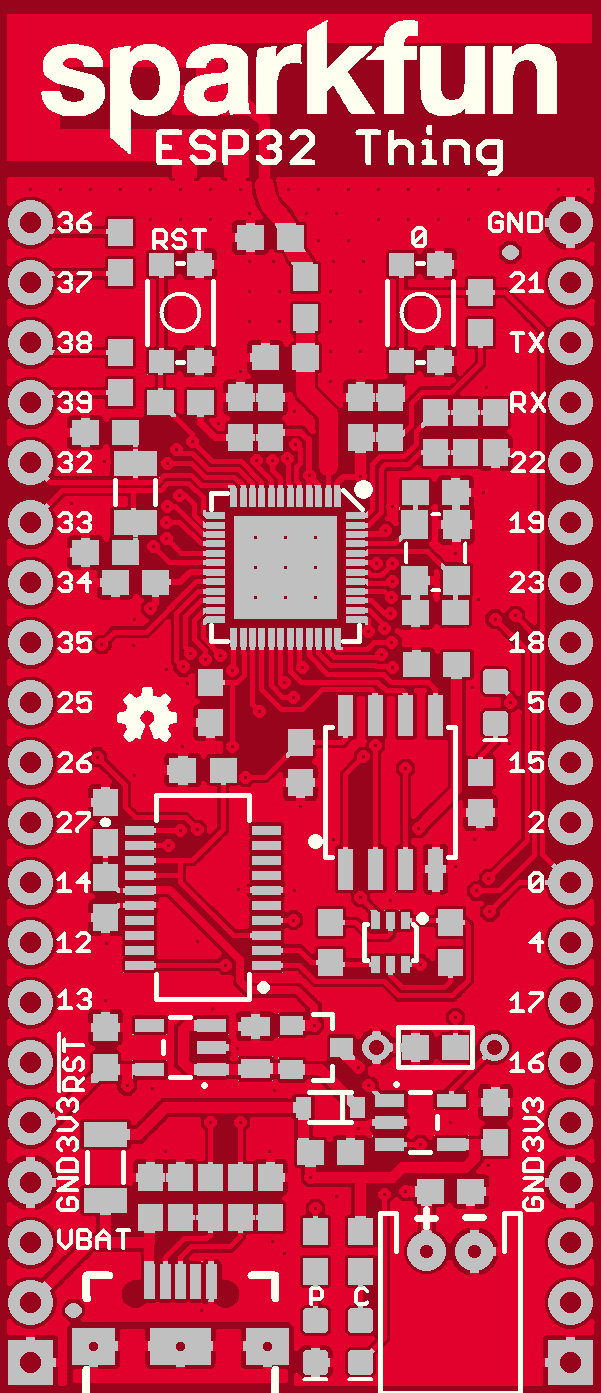
products/13907/geometry_edit_blender/esp32_thing_top_board.png
