sparkfun/3D_Models/products/13911/geometry_edit_blender/Serial_20Controlled_20Motor_20Driver_bottom_board.png

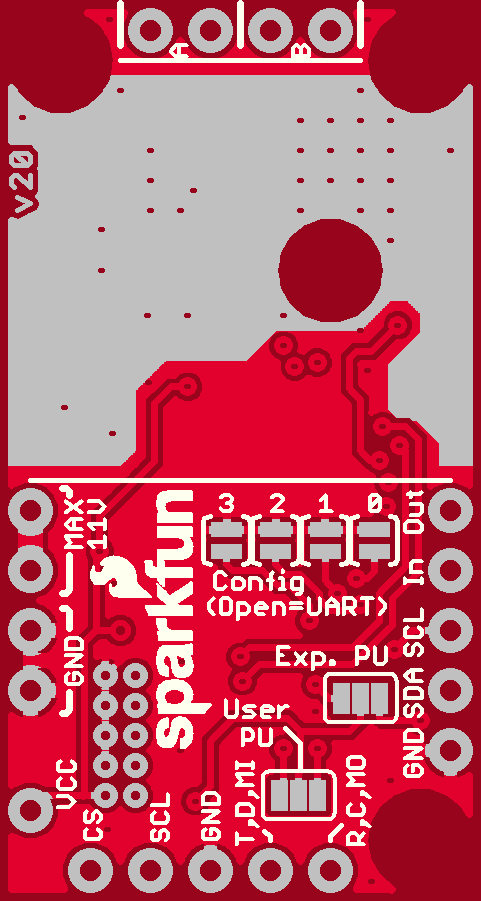
products/13911/geometry_edit_blender/Serial_20Controlled_20Motor_20Driver_bottom_board.png
