sparkfun/3D_Models/products/13912/display/Spectacle_Director_Board_bottom_board.png

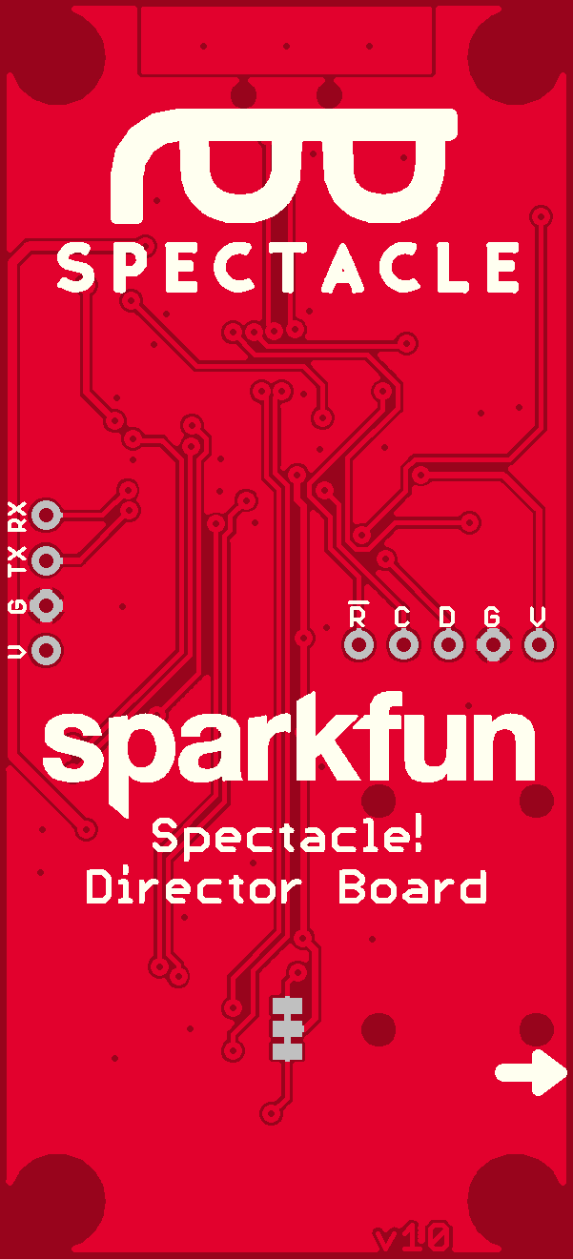
products/13912/display/Spectacle_Director_Board_bottom_board.png
