sparkfun/3D_Models/products/13926/display/SparkFun_MMA8452Q_Breakout_top_board.png

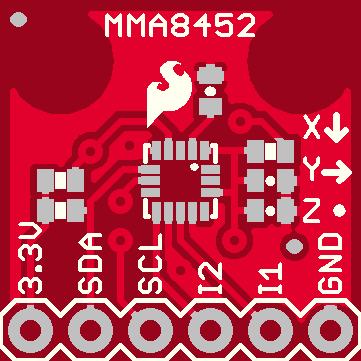
products/13926/display/SparkFun_MMA8452Q_Breakout_top_board.png
