sparkfun/3D_Models/products/13944/display/SparkFun_9DoF_Sensor_Stick_top_board.png

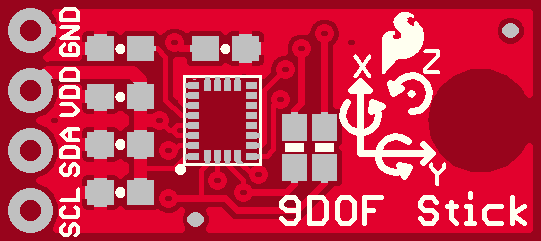
products/13944/display/SparkFun_9DoF_Sensor_Stick_top_board.png
