sparkfun/3D_Models/products/13975/display/RedBoard_top_board.png

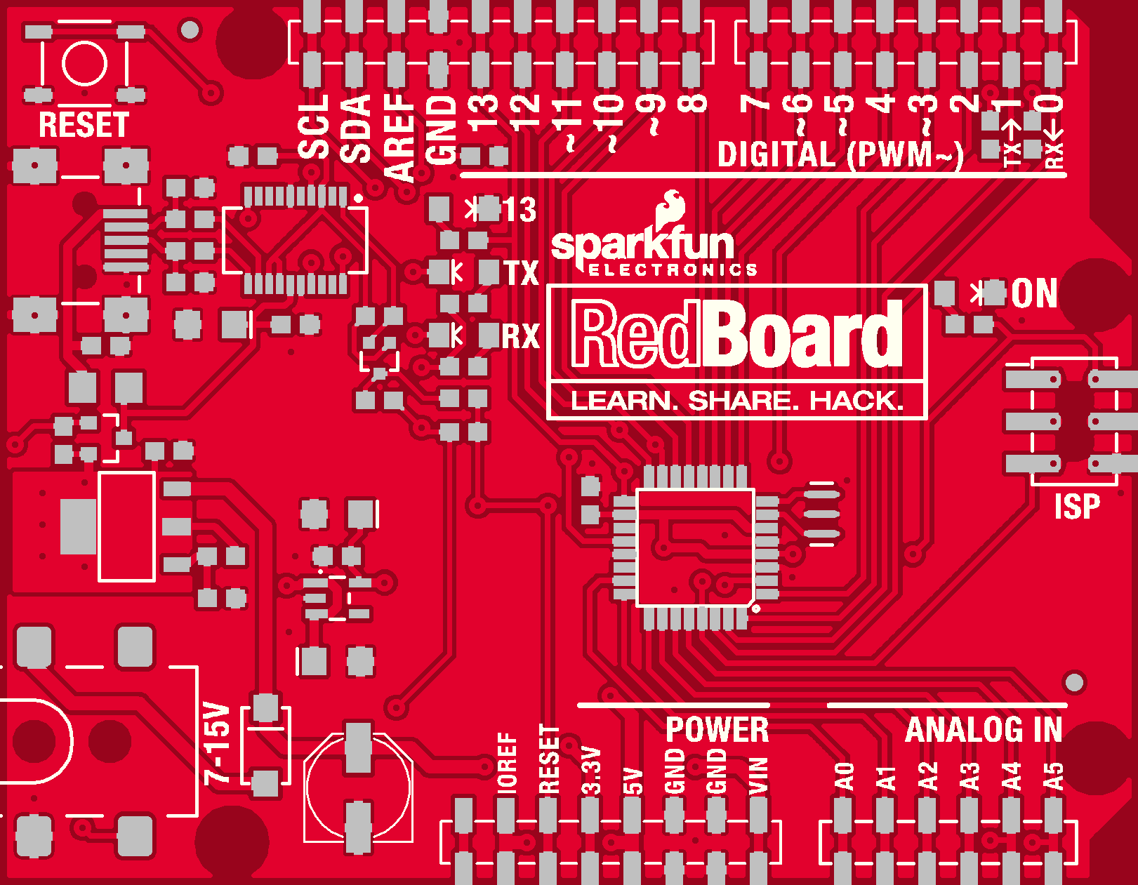
products/13975/display/RedBoard_top_board.png
