sparkfun/3D_Models/products/13992/display/Spectacle_Accelerometer_Input_Board_top_board.png

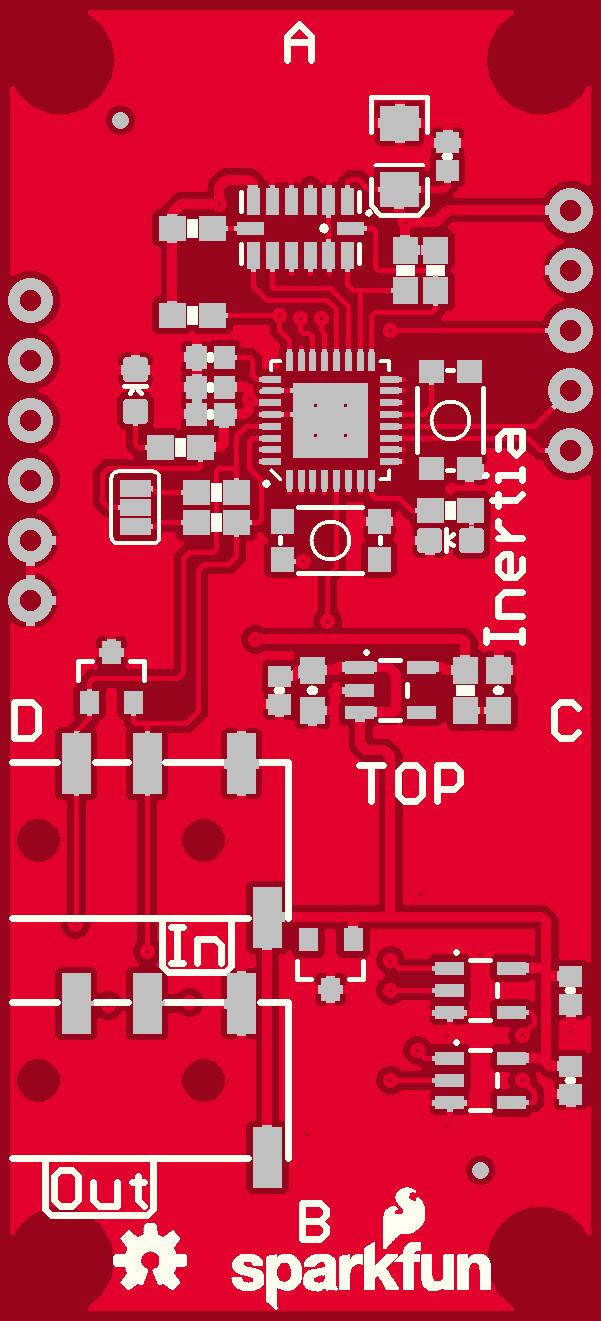
products/13992/display/Spectacle_Accelerometer_Input_Board_top_board.png
