sparkfun/3D_Models/products/13993/display/Spectacle_Motion_Board_bottom_board.png

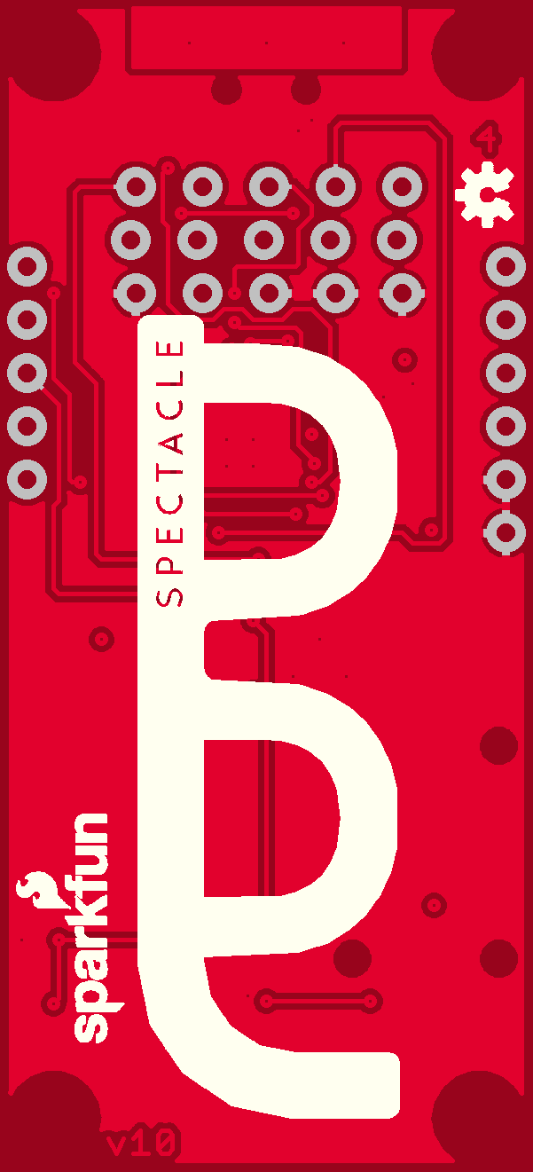
products/13993/display/Spectacle_Motion_Board_bottom_board.png
