sparkfun/3D_Models/products/14001/display/sparkfun_9dof_razor_imu_bottom_board.png

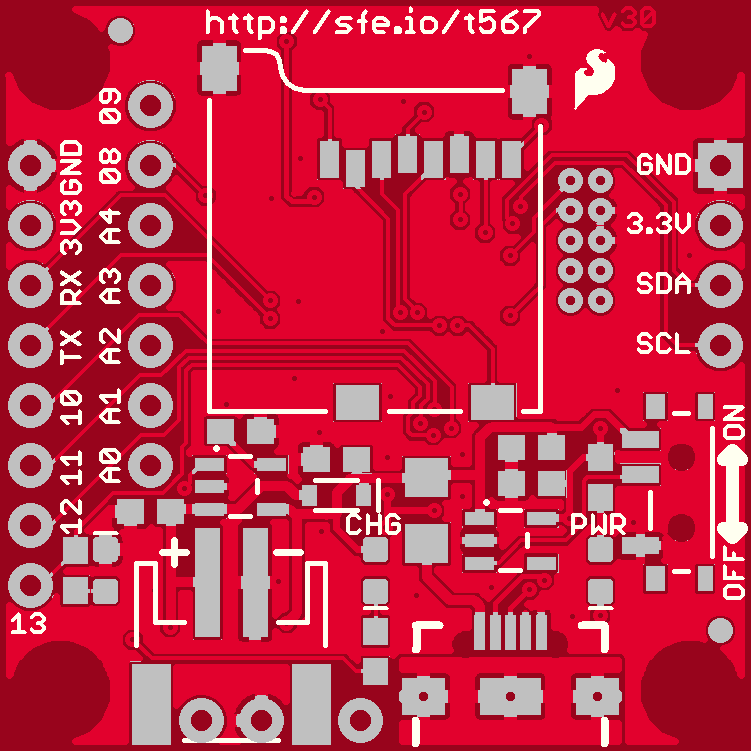
products/14001/display/sparkfun_9dof_razor_imu_bottom_board.png
