sparkfun/3D_Models/products/14001/geometry_edit_blender/sparkfun_9dof_razor_imu_top_board.png

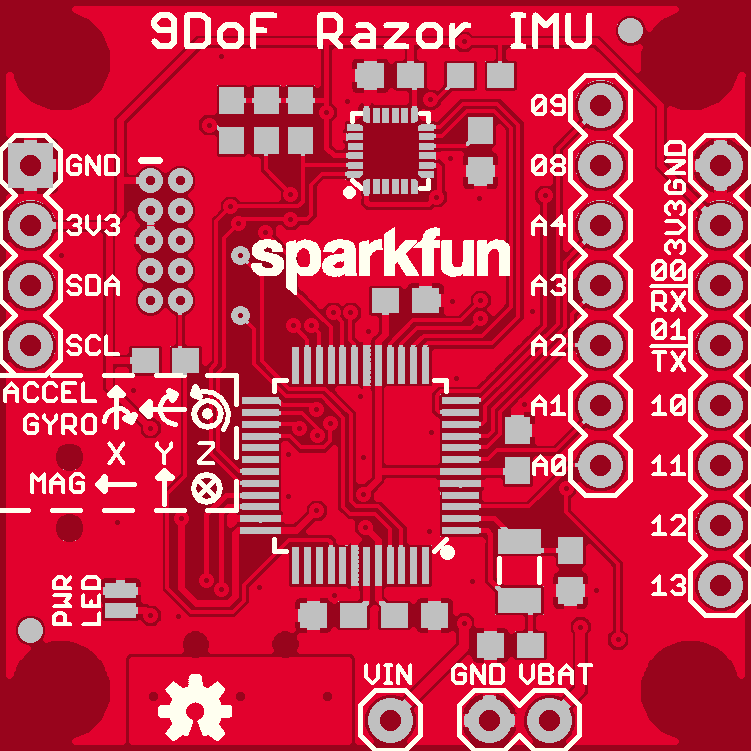
products/14001/geometry_edit_blender/sparkfun_9dof_razor_imu_top_board.png
