sparkfun/3D_Models/products/14021/dae/RJ11-Breakout/RJ11-Breakout_top_board.png

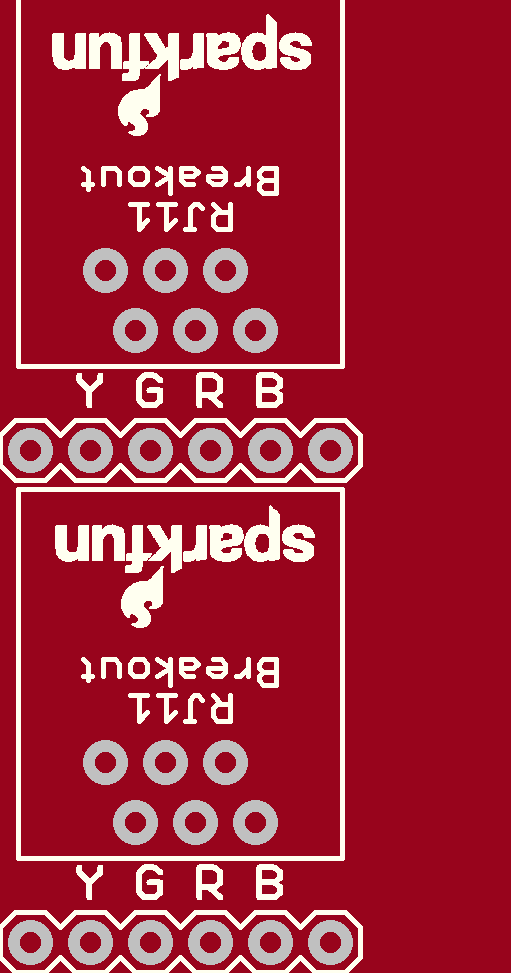
products/14021/dae/RJ11-Breakout/RJ11-Breakout_top_board.png
