sparkfun/3D_Models/products/14034/display/Spectacle_Audio_Output_Board_bottom_board.png

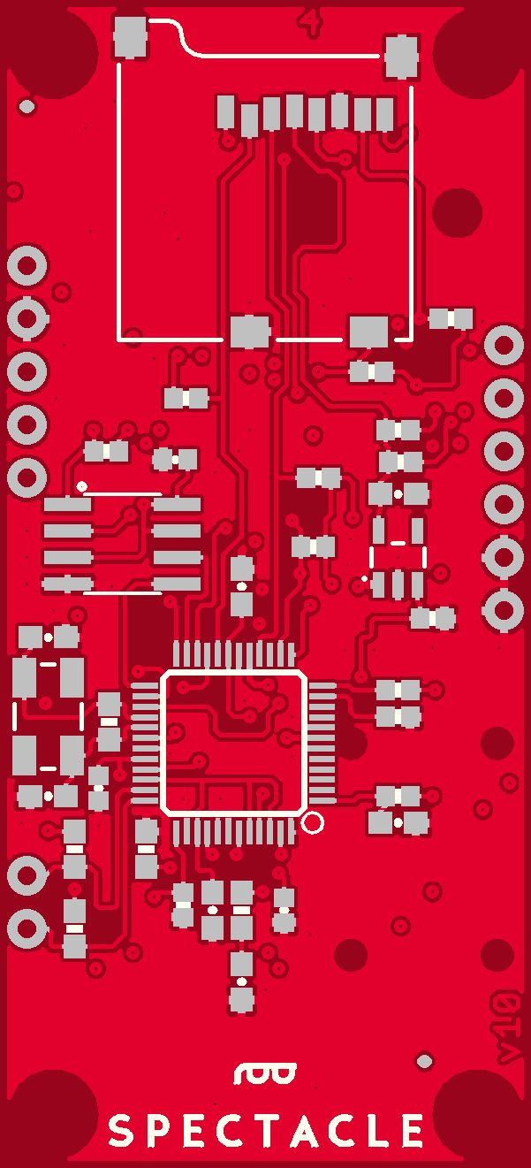
products/14034/display/Spectacle_Audio_Output_Board_bottom_board.png
