sparkfun/3D_Models/products/14034/display/Spectacle_Audio_Output_Board_top_board.png

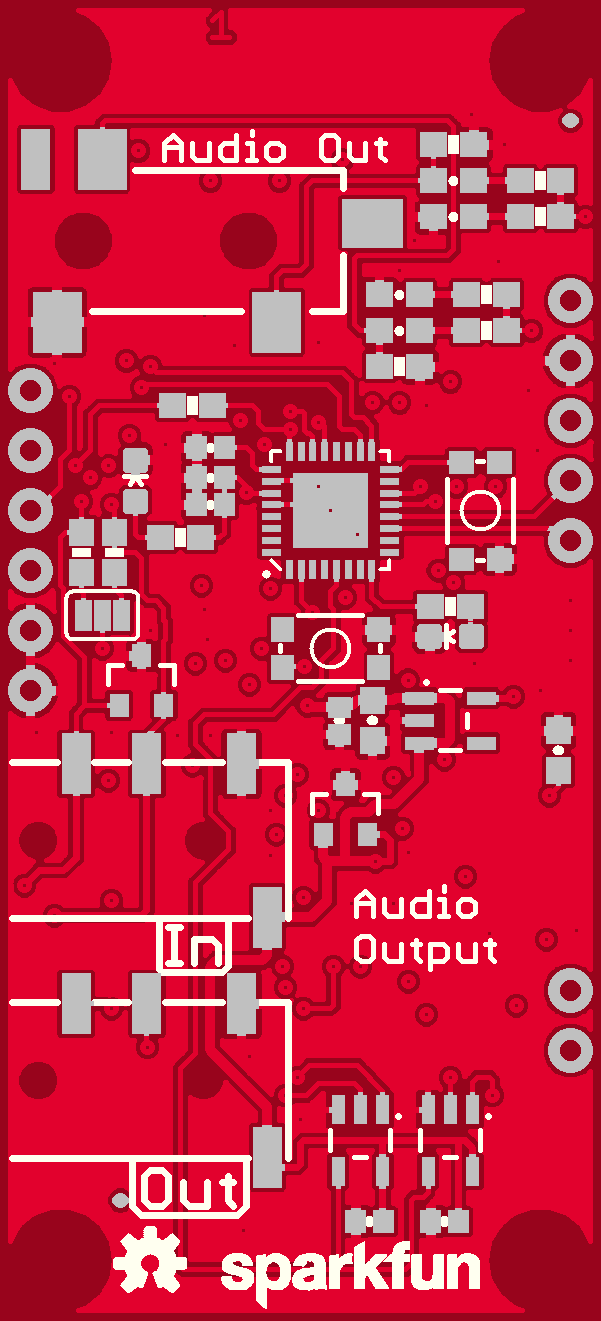
products/14034/display/Spectacle_Audio_Output_Board_top_board.png
