sparkfun/3D_Models/products/14044/display/Spectacle_Button_Board_bottom_board.png

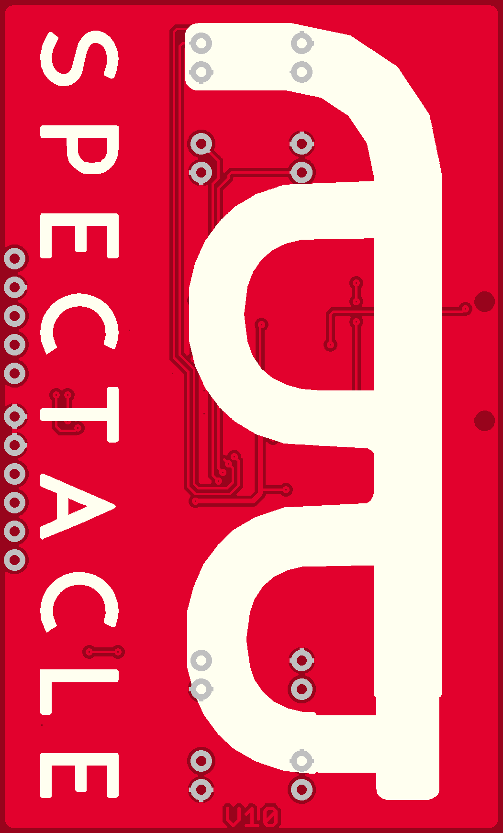
products/14044/display/Spectacle_Button_Board_bottom_board.png
