sparkfun/3D_Models/products/14052/display/Spectacle_LED_Control_Board_bottom_board.png

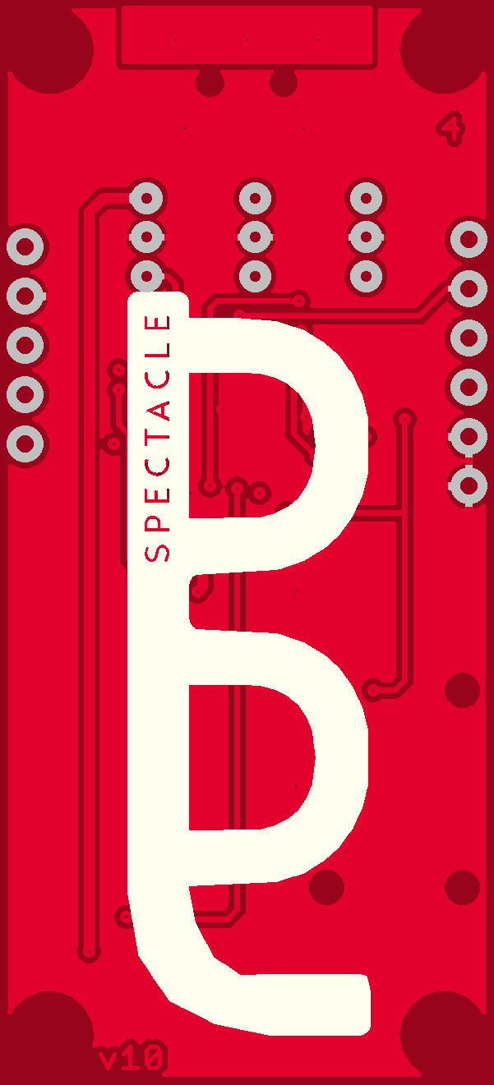
products/14052/display/Spectacle_LED_Control_Board_bottom_board.png
