sparkfun/3D_Models/production_parts/semiconductors/IC_SMD/WSON/WSON-8/source_solidworks/UserLibrary_SDC08B.sldasm

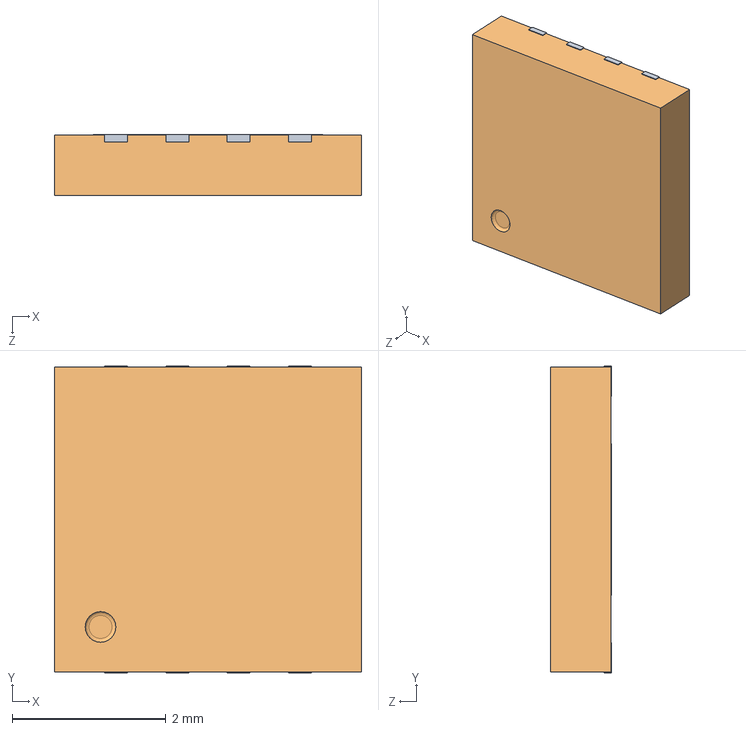
[picture p222: CAD file, 2016-06-01]
production_parts/semiconductors/IC_SMD/WSON/WSON-8/source_solidworks/UserLibrary_SDC08B.sldasm
4.00 x 4.00 x 0.8 mm
User Library-SDC08B_Fusion
User Library-SDC08B_Fillet
