sparkfun/3D_Models/products/102/source_solidworks/102_switch_spdt_lock.SLDASM

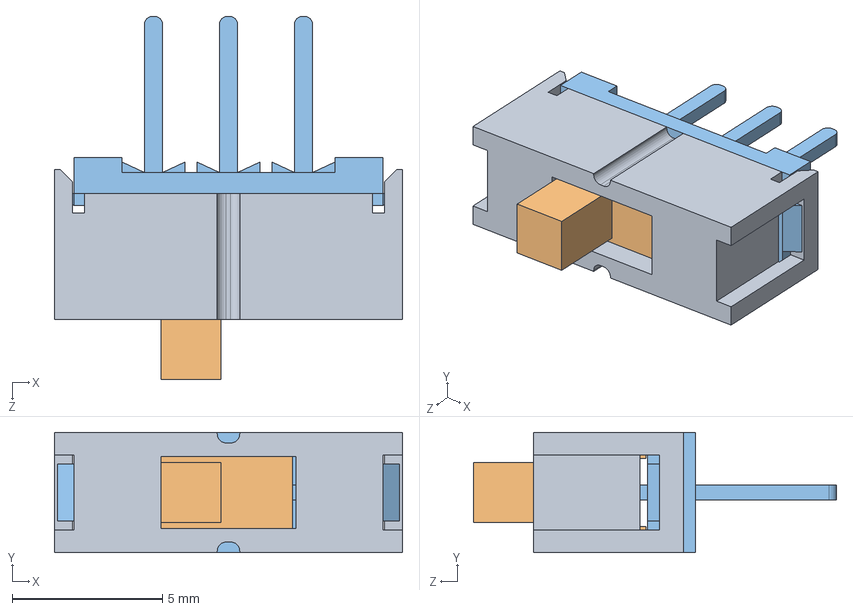
[picture p223: CAD file, 2015-06-05]
products/102/source_solidworks/102_switch_spdt_lock.SLDASM
11.6 x 4.00 x 12.1 mm
EG1218 Housing
EG1218 Actuator
EG1218A Terminals
