sparkfun/3D_Models/products/12125/source_solidworks/n20 motor.SLDASM

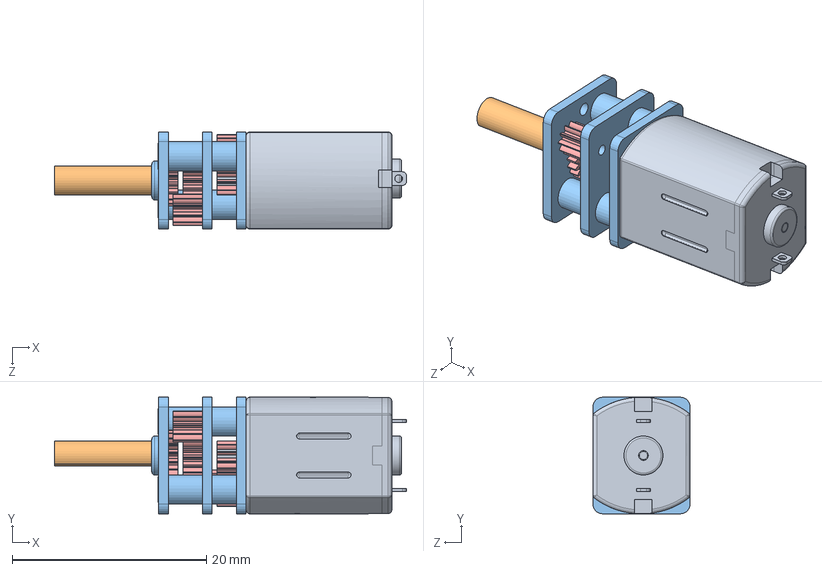
[picture p224: CAD file, 2017-02-22]
products/12125/source_solidworks/n20 motor.SLDASM
36.2 x 12.0 x 10.0 mm
motor
n20_shaft
n20_gearbox
cross recessed countersunk head screws gb1 x 2
spur gear_gb x 6
