sparkfun/3D_Models/products/12245/step/ROB-12245_assy.STEP

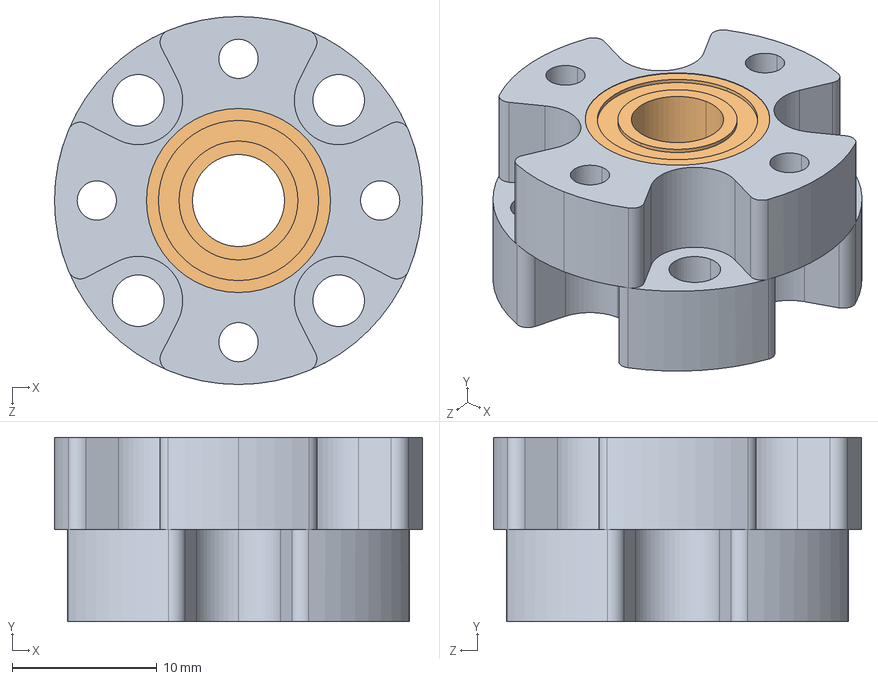
[picture p225: CAD file, 2014-12-22]
products/12245/step/ROB-12245_assy.STEP
25.4 x 12.7 x 25.4 mm
ROB-12245a
ROB-12245b x 2
