sparkfun/3D_Models/products/13024/stl/Intel_Edison_(assembly)_-_Intel_Edison_(assembled_antenna_connector)-1_Intel_Edison_(antenna_connector_3)-2.STL

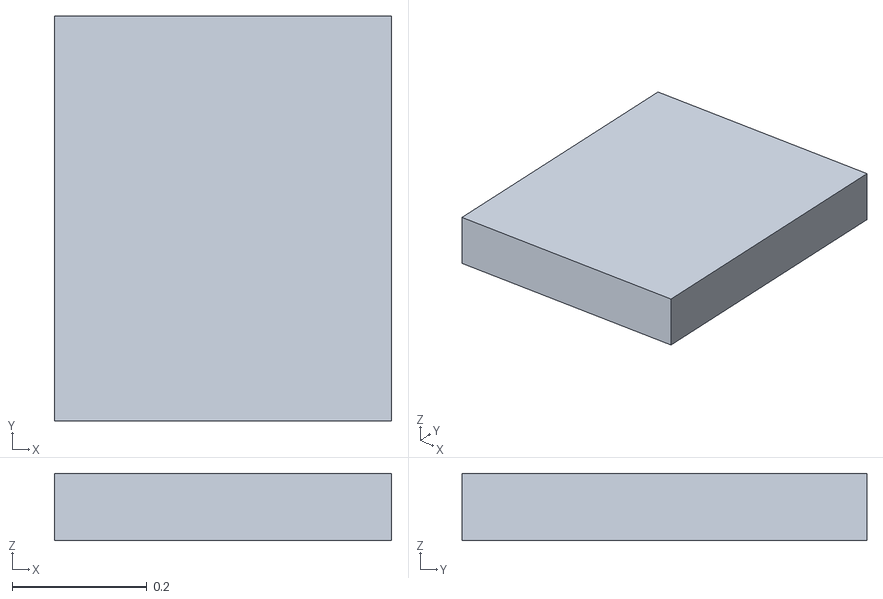
[picture p226: CAD file, 2016-03-09]
products/13024/stl/Intel_Edison_(assembly)_-_Intel_Edison_(assembled_antenna_connector)-1_Intel_Edison_(antenna_connector_3)-2.STL
0.5 x 0.6 x 0.1
