sparkfun/3D_Models/products/8632/step/wig_08632_assy.STEP

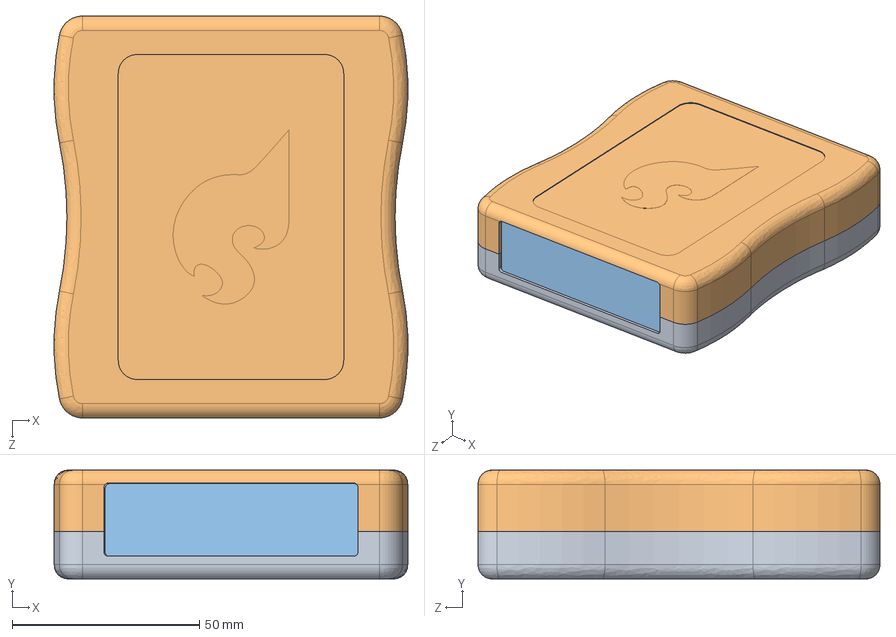
[picture p227: CAD file, 2014-12-22]
products/8632/step/wig_08632_assy.STEP
94.4 x 29.1 x 107.3 mm
WIG-08632_bottom
WIG-08632_top
WIG-08632_insert
