sparkfun/3D_Models/products/9347/source_solidworks/9347.SLDASM

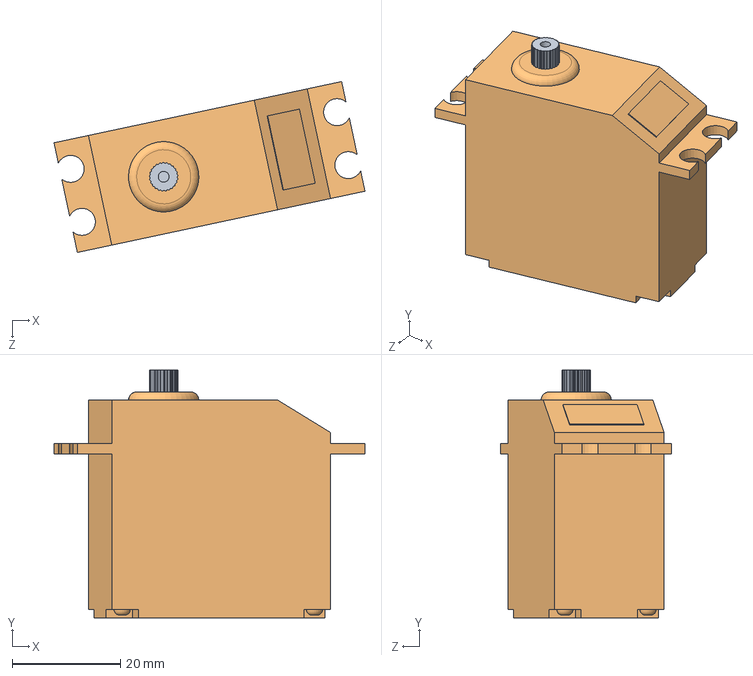
[picture p228: CAD file, 2017-08-08]
products/9347/source_solidworks/9347.SLDASM
57.4 x 45.7 x 31.6 mm
Embout
Servomoteur
