sparkfun/3D_Models/products/9536/source_solidworks/9536.SLDASM

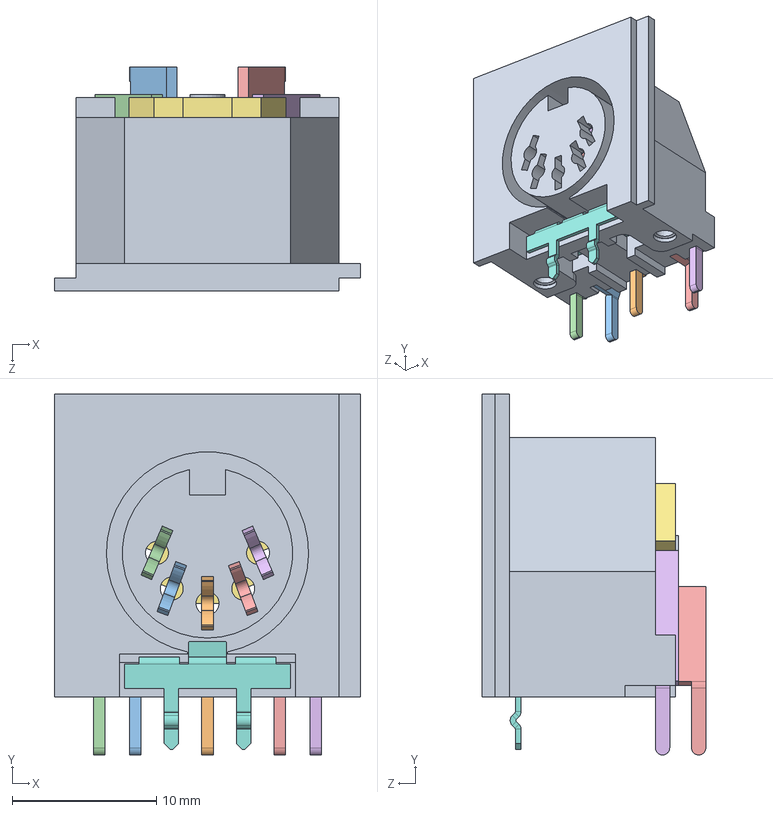
[picture p229: CAD file, 2016-03-01]
products/9536/source_solidworks/9536.SLDASM
21.2 x 25.0 x 15.5 mm
DIN5_PCB_DELTRON_BODY
DIN5_PCB_DELTRON_PIN2
DIN5_PCB_DELTRON_PIN5
DIN5_PCB_DELTRON_PIN3
DIN5_PCB_DELTRON_PIN4
DIN5_PCB_DELTRON_PIN1
DIN5_PCB_DELTRON_FIX
DIN5_PCB_DELTRON_SHIELD
