sparkfun/3D_Models/production_parts/modules/ELECTRIC_IMP_IMP002/imp002.SLDASM

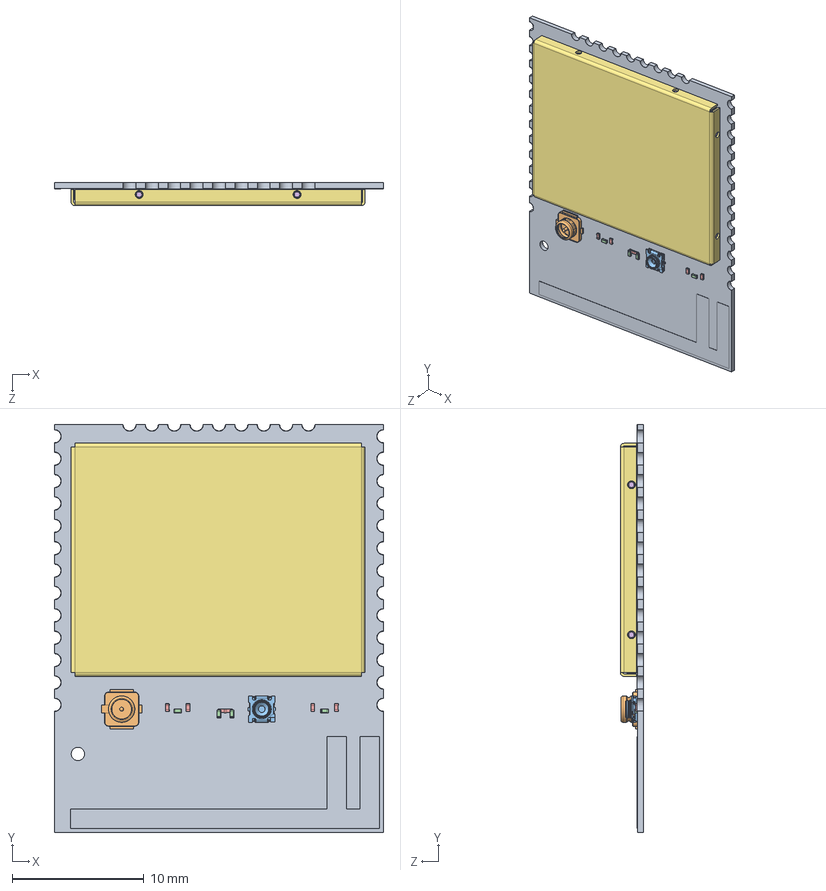
[picture p230: CAD file, 2016-06-01]
production_parts/modules/ELECTRIC_IMP_IMP002/imp002.SLDASM
25.0 x 31.0 x 1.78 mm
shadow_pcb
U_FL_CONN
SWG-VE
RES0603___ _________ x 4
CAPC0603 x 6
shadow_shield_frame
shadow_shield_lid
