sparkfun/3D_Models/products/13024/source_solidworks/Intel_Edison_(assembly).SLDASM

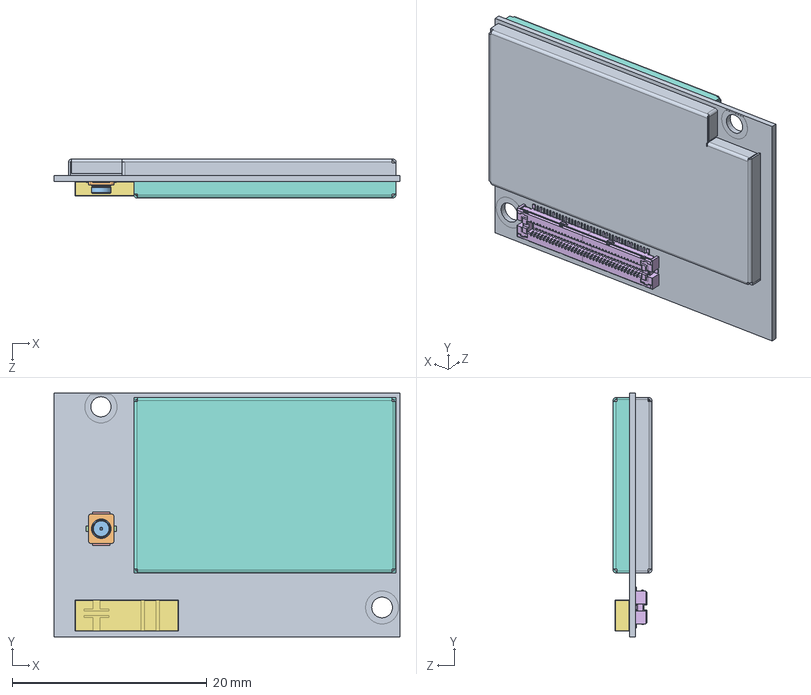
[picture p231: CAD file, 2016-03-09]
products/13024/source_solidworks/Intel_Edison_(assembly).SLDASM
35.5 x 25.0 x 4.00 mm
Intel_Edison_(CI_board)
Intel_Edison_(antenna_connector_1)
Intel_Edison_(antenna_connector_2)
Intel_Edison_(antenna_connector_3) x 2
Intel_Edison_(antenna_connector_4) x 2
Intel_Edison_(Hirose_connector) x 2
Intel_Edison_(antenna)
Intel_Edison_(front_box)
Intel_Edison_(back_box)
