sparkfun/3D_Models/products/13024/stl/Intel_Edison_(assembly)_-_Intel_Edison_(antenna)-1.STL

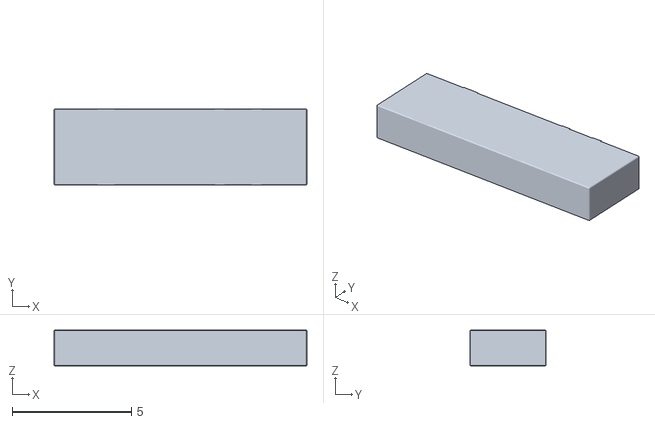
[picture p232: CAD file, 2016-03-09]
products/13024/stl/Intel_Edison_(assembly)_-_Intel_Edison_(antenna)-1.STL
10.6 x 3.20 x 1.50
