sparkfun/3D_Models/products/13024/stl/Intel_Edison_(assembly)_-_Intel_Edison_(assembled_antenna_connector)-1_Intel_Edison_(antenna_connector_1)-1.STL

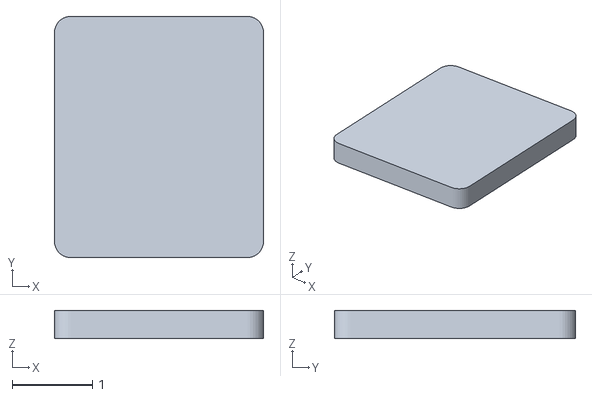
[picture p234: CAD file, 2016-03-09]
products/13024/stl/Intel_Edison_(assembly)_-_Intel_Edison_(assembled_antenna_connector)-1_Intel_Edison_(antenna_connector_1)-1.STL
2.60 x 3.00 x 0.35
