sparkfun/3D_Models/products/13024/stl/Intel_Edison_(assembly)_-_Intel_Edison_(assembled_hirose_connector)-1_Intel_Edison_(Hirose_connector)-2.STL

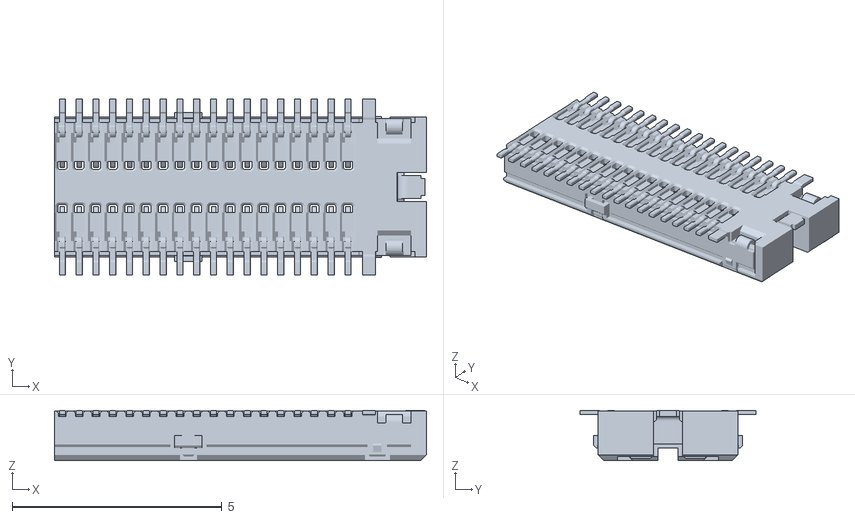
[picture p237: CAD file, 2016-03-09]
products/13024/stl/Intel_Edison_(assembly)_-_Intel_Edison_(assembled_hirose_connector)-1_Intel_Edison_(Hirose_connector)-2.STL
8.86 x 4.20 x 1.20
