sparkfun/3D_Models/products/790/source_solidworks/1602_LCD_metalcasing.SLDASM

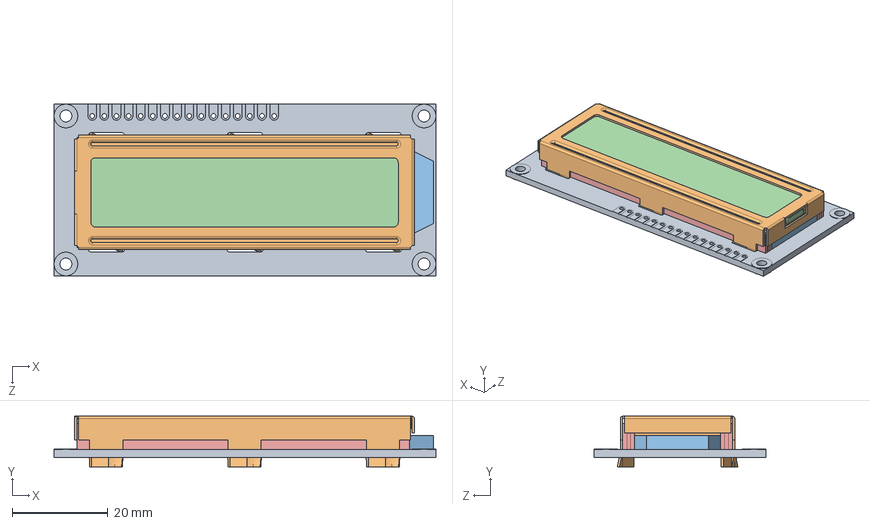
[picture p238: CAD file, 2017-01-16]
products/790/source_solidworks/1602_LCD_metalcasing.SLDASM
80.0 x 10.6 x 36.0 mm
LCD_PCB
metal_casing
LCDbacklight
LCD
conductors x 2
