sparkfun/3D_Models/products/13024/stl/Intel_Edison_(assembly)_-_Intel_Edison_(CI_board)-1.STL

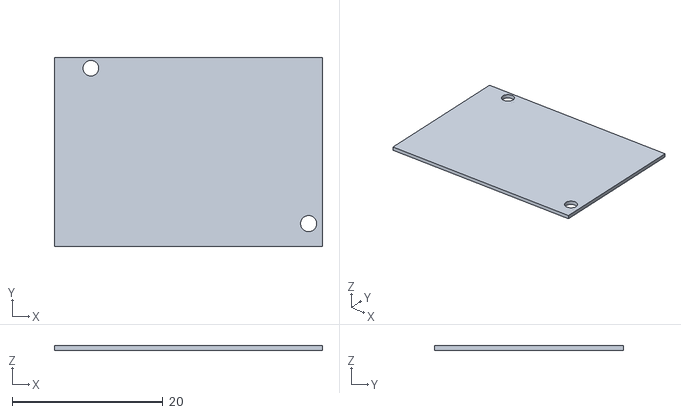
[picture p240: CAD file, 2016-03-09]
products/13024/stl/Intel_Edison_(assembly)_-_Intel_Edison_(CI_board)-1.STL
35.5 x 25.0 x 0.62
