sparkfun/3D_Models/products/13024/stl/Intel_Edison_(assembly)_-_Intel_Edison_(front_box)-1.STL

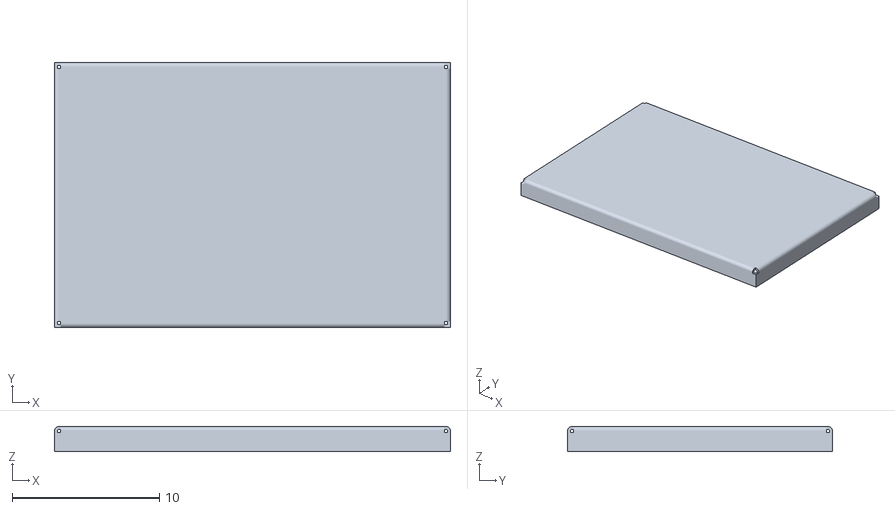
[picture p241: CAD file, 2016-03-09]
products/13024/stl/Intel_Edison_(assembly)_-_Intel_Edison_(front_box)-1.STL
26.9 x 18.0 x 1.70
