sparkfun/3D_Models/production_parts/antennas/ANTENNA-CHIP5/source_solidworks/ANTENNA-CHIP5.SLDPRT

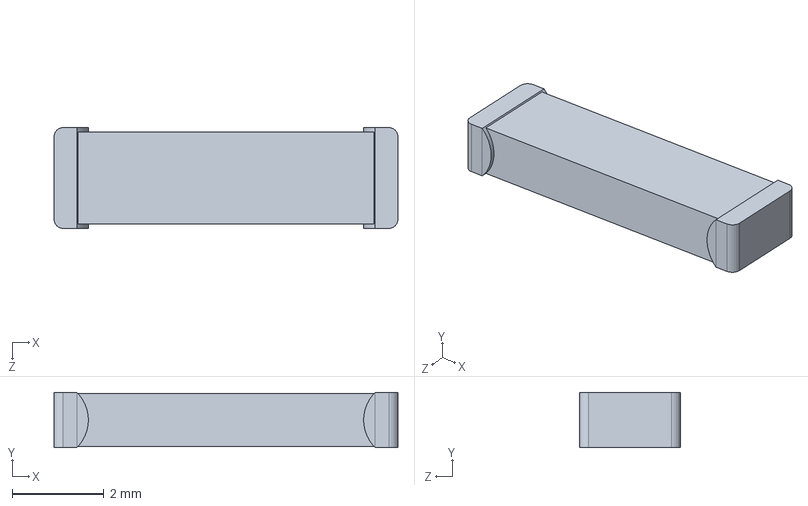
[picture p242: CAD file, 2016-12-27]
production_parts/antennas/ANTENNA-CHIP5/source_solidworks/ANTENNA-CHIP5.SLDPRT
7.50 x 1.20 x 2.20 mm
