sparkfun/3D_Models/production_parts/audio/BUZZER-CCV.stl

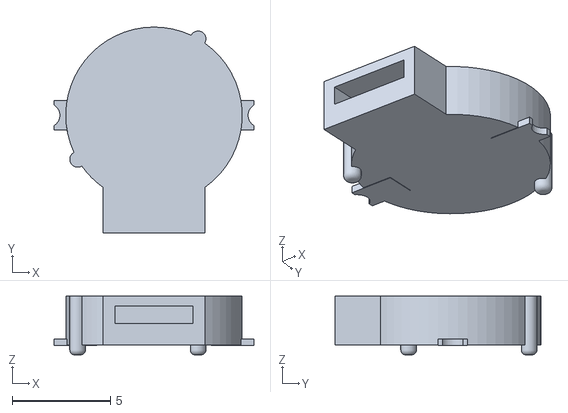
[picture p243: CAD file, 2017-06-15]
production_parts/audio/BUZZER-CCV.stl
10.2 x 10.5 x 3.00
