sparkfun/3D_Models/production_parts/connectors/audio/AUDIO-JACK-3.5MM-SMD/stl/AUDIO-JACK.stl

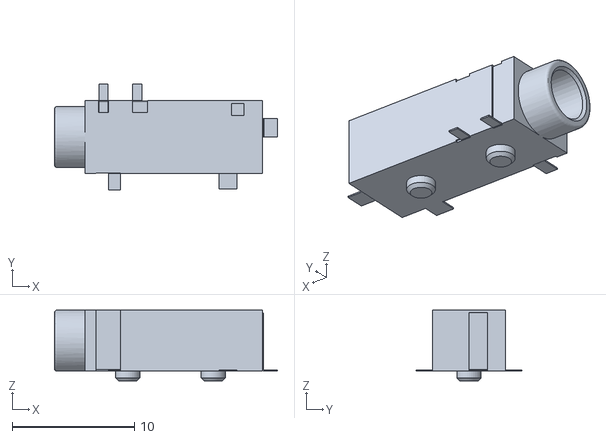
[picture p244: CAD file, 2017-06-15]
production_parts/connectors/audio/AUDIO-JACK-3.5MM-SMD/stl/AUDIO-JACK.stl
18.2 x 8.70 x 5.80
