sparkfun/3D_Models/production_parts/connectors/audio/AUDIO-JACK-_25-INCH-HORIZ-PTH/step/AUDIO-JACK-_25-INCH-HORIZ-PTH.STEP

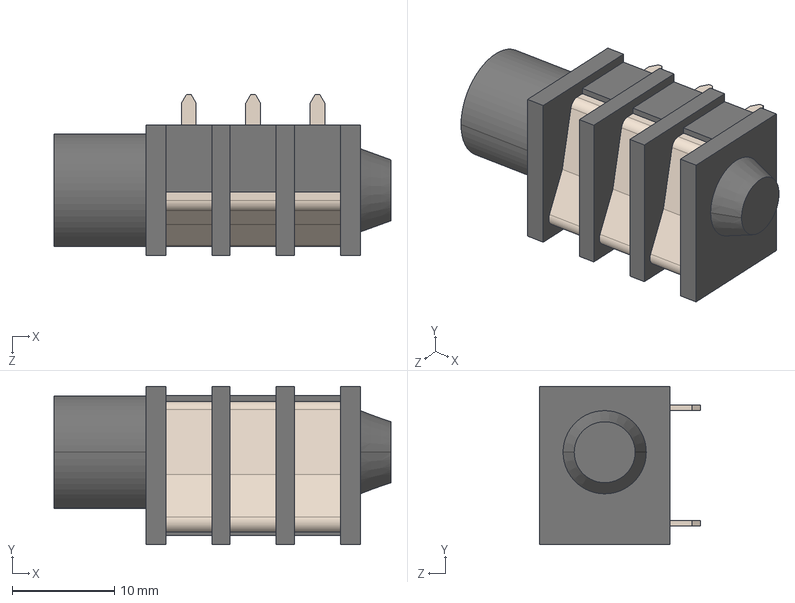
[picture p245: CAD file, 2015-08-19]
production_parts/connectors/audio/AUDIO-JACK-_25-INCH-HORIZ-PTH/step/AUDIO-JACK-_25-INCH-HORIZ-PTH.STEP
33.0 x 15.5 x 15.8 mm
