sparkfun/3D_Models/production_parts/connectors/audio/AUDIO_JACK_3_5MM_TRRS_SMD_RA/source_solidworks/AUDIO_JACK_3_5MM_TRRS_SMD_RA.SLDPRT

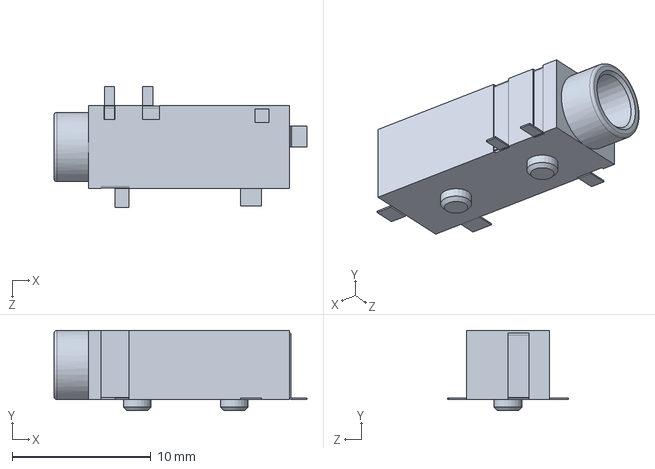
[picture p246: CAD file, 2015-02-02]
production_parts/connectors/audio/AUDIO_JACK_3_5MM_TRRS_SMD_RA/source_solidworks/AUDIO_JACK_3_5MM_TRRS_SMD_RA.SLDPRT
18.2 x 5.80 x 8.70 mm
