sparkfun/3D_Models/production_parts/connectors/coin_cell/BATTCON_12MM/step/BATTCON_12MM.STEP

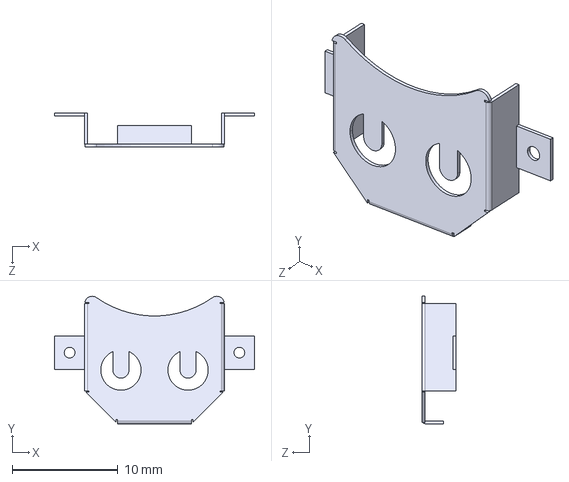
[picture p247: CAD file, 2015-04-03]
production_parts/connectors/coin_cell/BATTCON_12MM/step/BATTCON_12MM.STEP
18.9 x 12.1 x 3.18 mm
