sparkfun/3D_Models/production_parts/connectors/coin_cell/BATTCON_20MM_4LEGS/geometry_edit_blender/BATTCON_20MM_4LEGS.SLDPRT

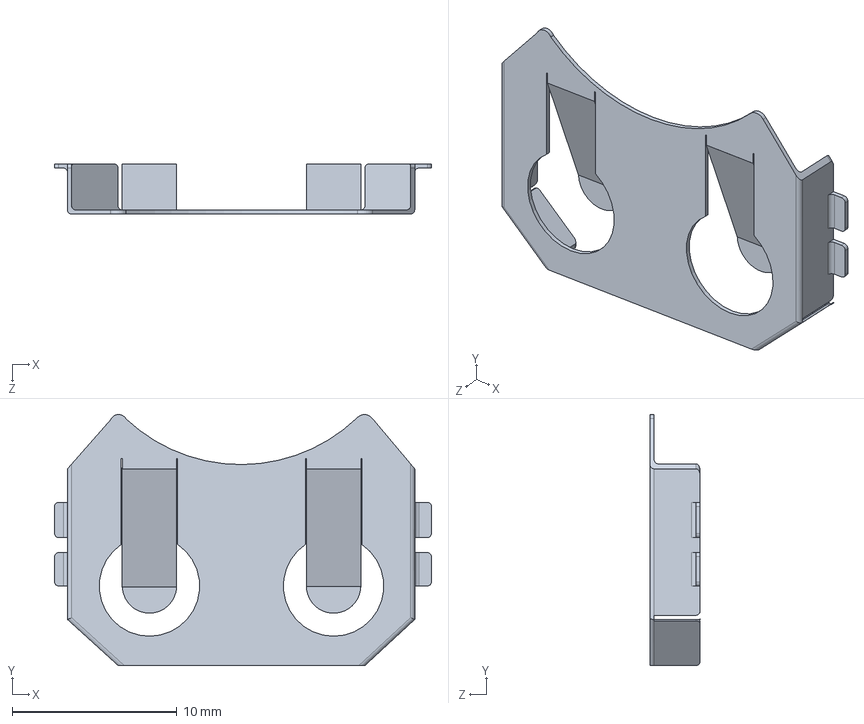
[picture p248: CAD file, 2016-08-23]
production_parts/connectors/coin_cell/BATTCON_20MM_4LEGS/geometry_edit_blender/BATTCON_20MM_4LEGS.SLDPRT
22.9 x 15.2 x 3.05 mm
