sparkfun/3D_Models/production_parts/connectors/DB9/stl/DB9.STL

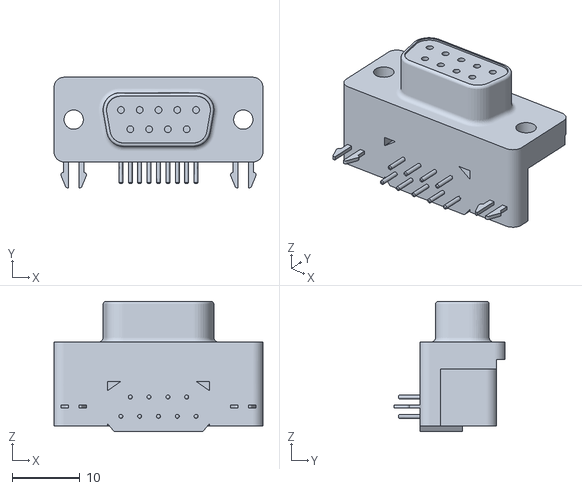
[picture p249: CAD file, 2015-06-05]
production_parts/connectors/DB9/stl/DB9.STL
30.8 x 16.3 x 19.2
