sparkfun/3D_Models/production_parts/connectors/headers/1X05/1X05_SMD.stl

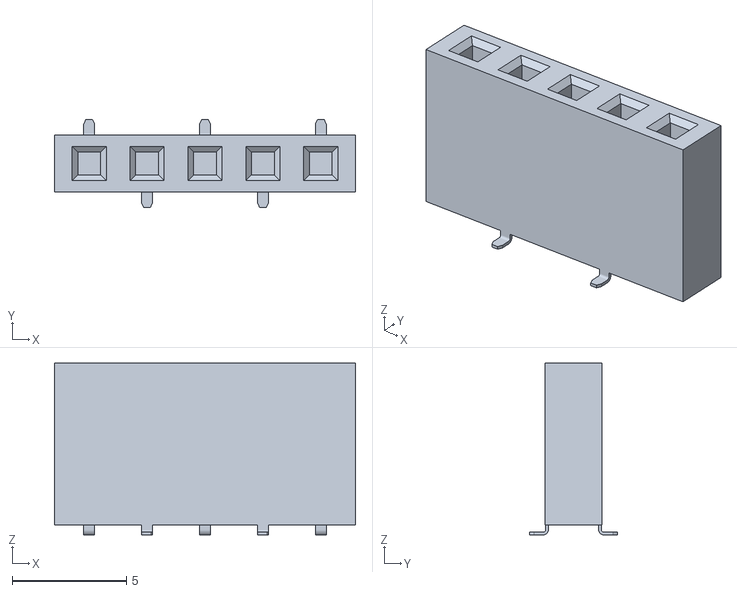
[picture p250: CAD file, 2017-06-15]
production_parts/connectors/headers/1X05/1X05_SMD.stl
13.2 x 3.86 x 7.53
