sparkfun/3D_Models/production_parts/connectors/headers/1X06/1X06_SMD_STRAIGHT_COMBO.stl

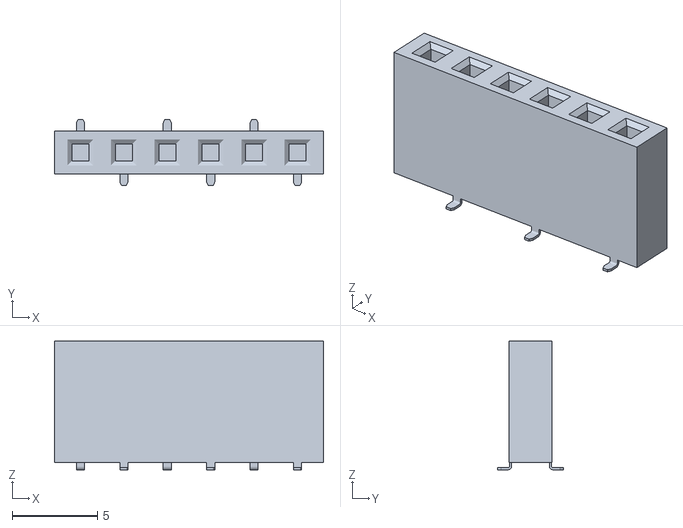
[picture p251: CAD file, 2017-06-15]
production_parts/connectors/headers/1X06/1X06_SMD_STRAIGHT_COMBO.stl
15.7 x 3.86 x 7.53
