sparkfun/3D_Models/production_parts/connectors/headers/1X06_PTH/step/1X06-SIP_LOCK.STEP

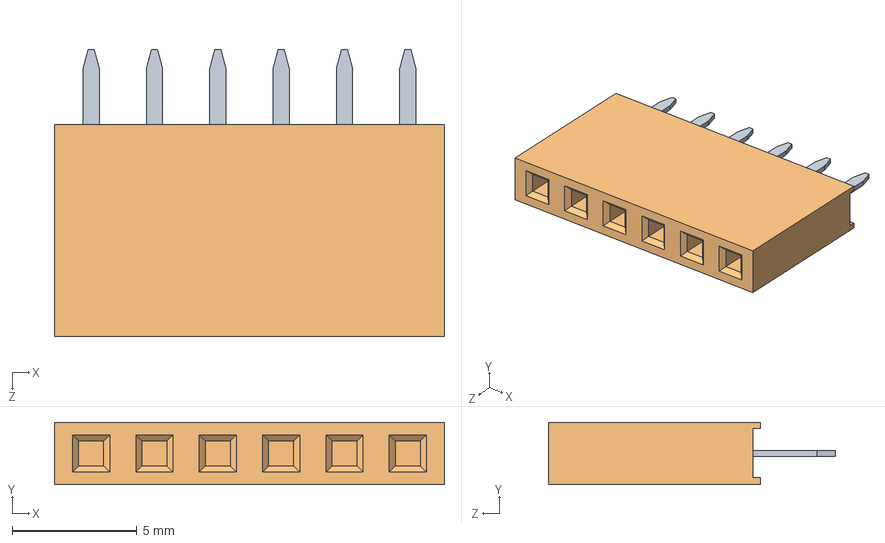
[picture p252: CAD file, 2015-06-05]
production_parts/connectors/headers/1X06_PTH/step/1X06-SIP_LOCK.STEP
15.6 x 2.50 x 11.5 mm
