sparkfun/3D_Models/production_parts/connectors/headers/1X07/1X07_SMD.stl

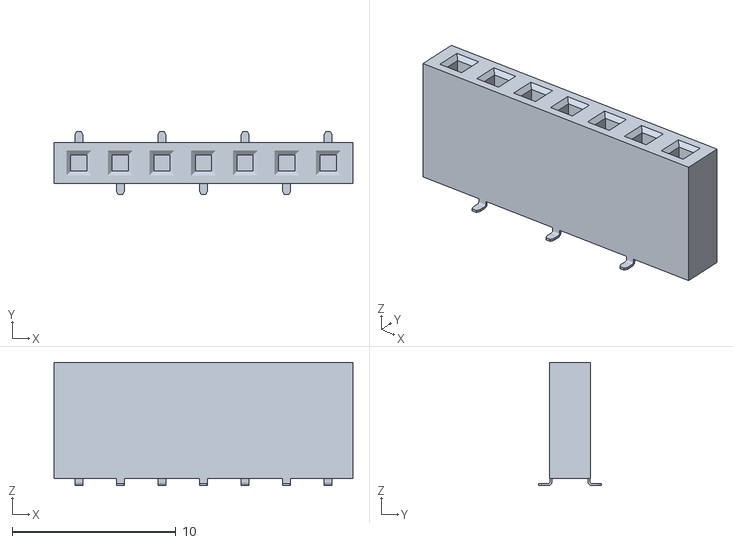
[picture p253: CAD file, 2017-06-15]
production_parts/connectors/headers/1X07/1X07_SMD.stl
18.3 x 3.86 x 7.53
