sparkfun/3D_Models/production_parts/connectors/headers/1X08/1X08_PTH/stl/1X08_LOCK.stl

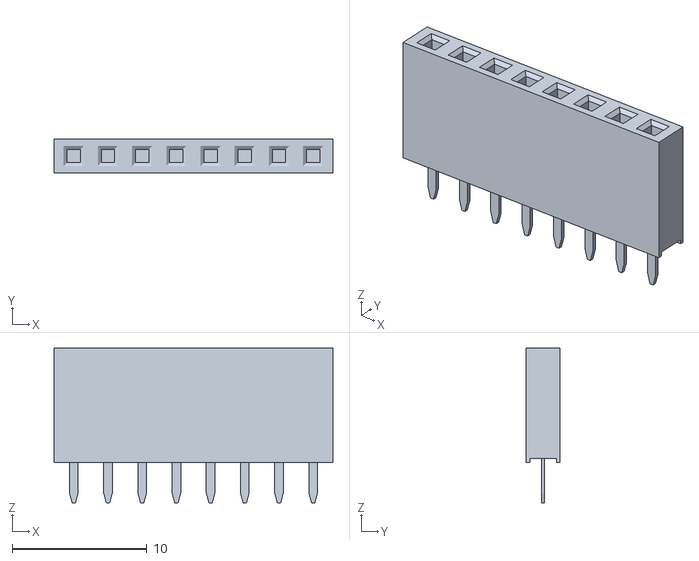
[picture p254: CAD file, 2017-06-15]
production_parts/connectors/headers/1X08/1X08_PTH/stl/1X08_LOCK.stl
20.7 x 2.50 x 11.5
