sparkfun/3D_Models/production_parts/connectors/headers/1X08/1X08_SMD_COMBINED.stl

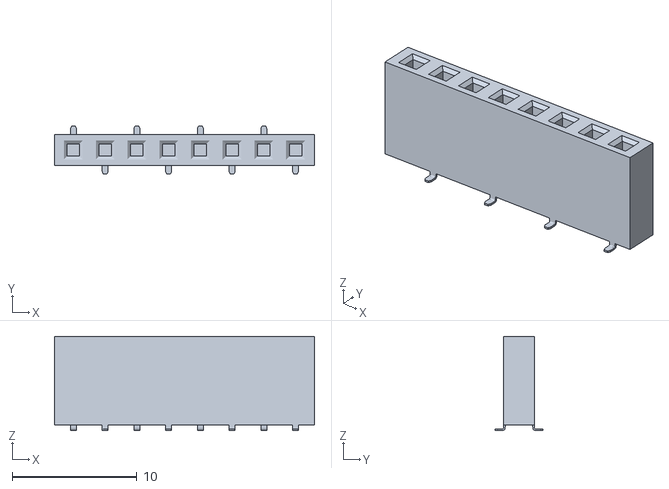
[picture p255: CAD file, 2017-06-15]
production_parts/connectors/headers/1X08/1X08_SMD_COMBINED.stl
20.8 x 3.86 x 7.53
