sparkfun/3D_Models/production_parts/connectors/headers/1X10/1X10_PTH/stl/1X10_LOCK.stl

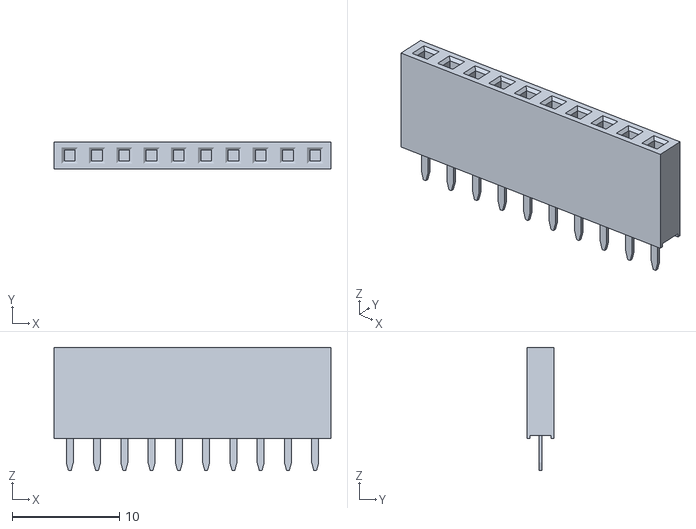
[picture p256: CAD file, 2017-06-15]
production_parts/connectors/headers/1X10/1X10_PTH/stl/1X10_LOCK.stl
25.8 x 2.50 x 11.5
