sparkfun/3D_Models/production_parts/connectors/headers/1X10/1X10_SMD_COMBINED/1X10_SMD_COMBINED.stl

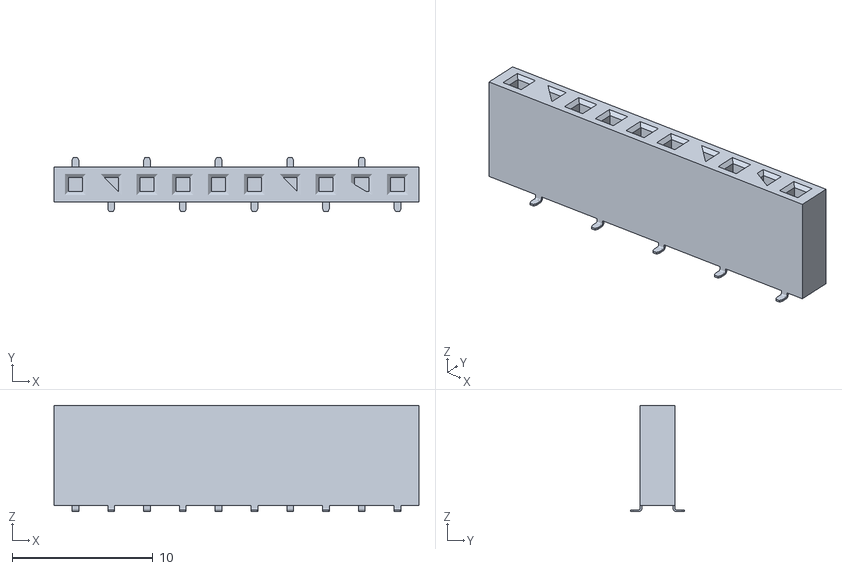
[picture p257: CAD file, 2017-06-15]
production_parts/connectors/headers/1X10/1X10_SMD_COMBINED/1X10_SMD_COMBINED.stl
25.9 x 3.86 x 7.53
