sparkfun/3D_Models/production_parts/connectors/headers/1X12_PTH/step/SPARK_PHOTON_TEMPLATE_WIDE_LOCKING.STEP

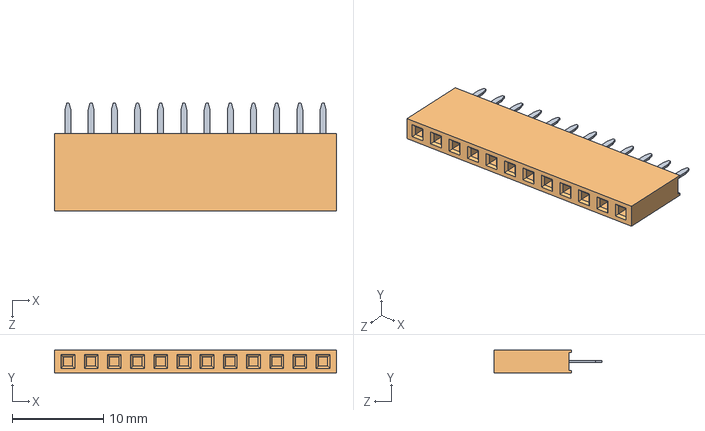
[picture p258: CAD file, 2015-08-26]
production_parts/connectors/headers/1X12_PTH/step/SPARK_PHOTON_TEMPLATE_WIDE_LOCKING.STEP
30.9 x 2.50 x 11.9 mm
