sparkfun/3D_Models/production_parts/connectors/headers/1X12_SMD_COMBINED/stl/1X12_SMD_COMBINED.STL

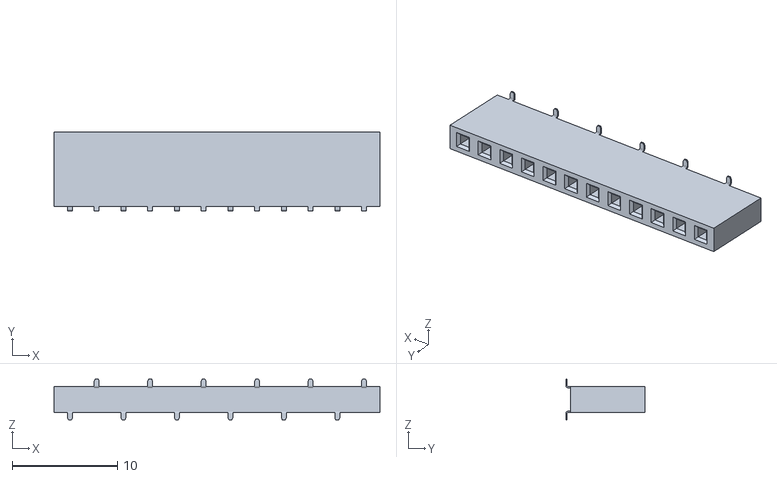
[picture p259: CAD file, 2015-08-26]
production_parts/connectors/headers/1X12_SMD_COMBINED/stl/1X12_SMD_COMBINED.STL
31.0 x 7.53 x 3.86
