sparkfun/3D_Models/production_parts/connectors/headers/1X12_STACKABLE/step/1X12_STACKABLE.STEP

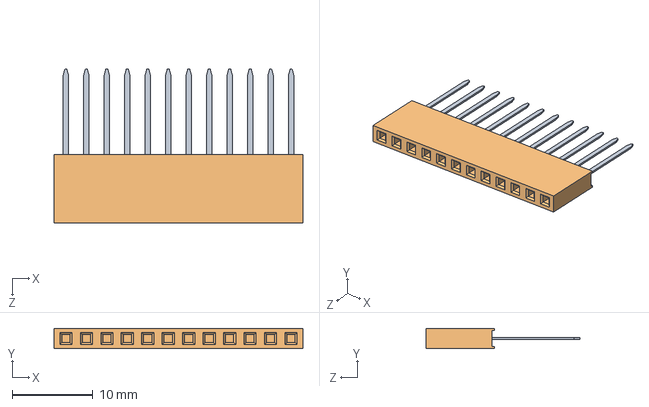
[picture p260: CAD file, 2015-08-19]
production_parts/connectors/headers/1X12_STACKABLE/step/1X12_STACKABLE.STEP
30.9 x 2.50 x 19.1 mm
