sparkfun/3D_Models/production_parts/connectors/headers/1X6/1x6.SLDPRT

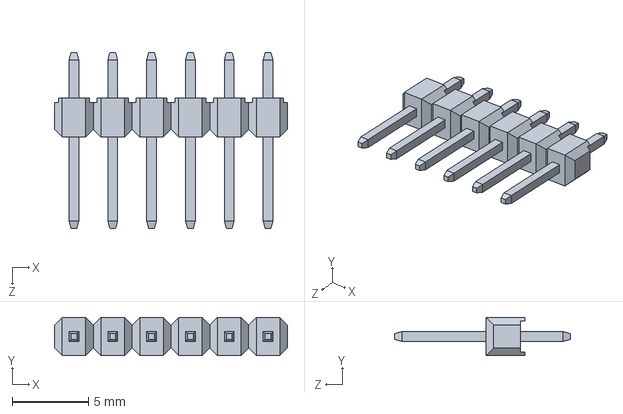
[picture p261: CAD file, 2016-07-11]
production_parts/connectors/headers/1X6/1x6.SLDPRT
15.2 x 2.50 x 11.5 mm
