sparkfun/3D_Models/production_parts/connectors/headers/2X06_PTH/step/2X06_PTH.STEP

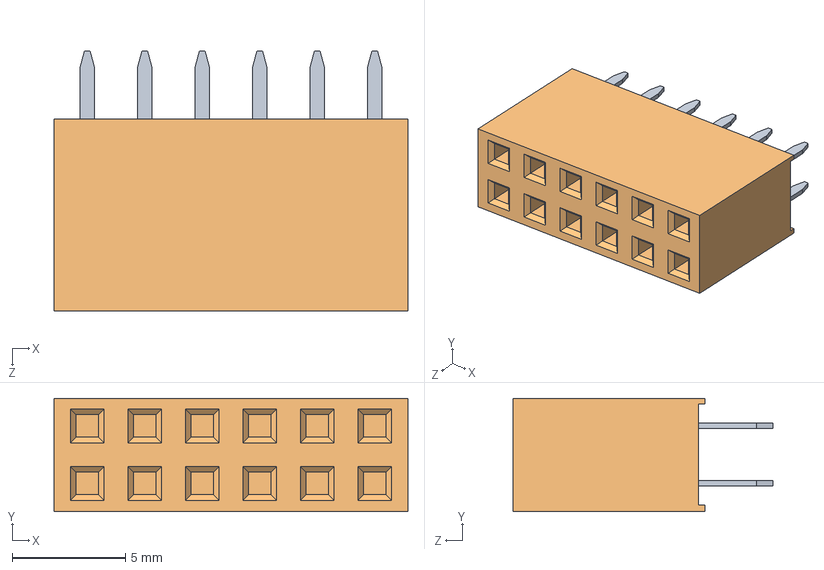
[picture p262: CAD file, 2015-06-05]
production_parts/connectors/headers/2X06_PTH/step/2X06_PTH.STEP
15.6 x 5.00 x 11.5 mm
