sparkfun/3D_Models/production_parts/connectors/headers/2X06_PTH/stl/2X6.stl

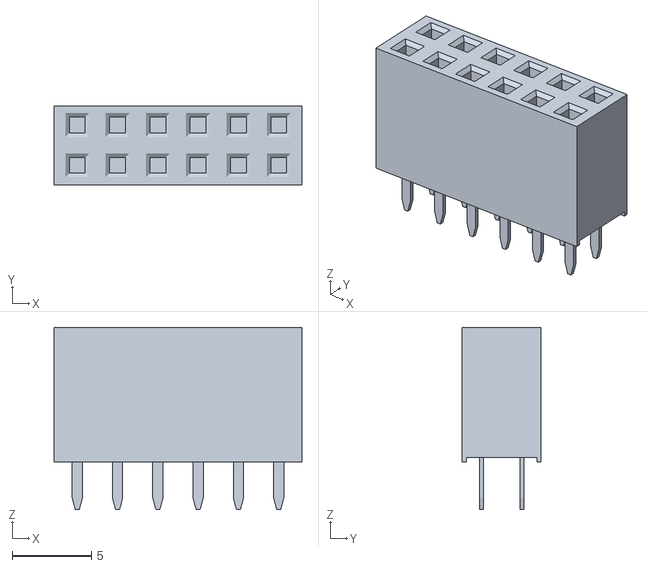
[picture p263: CAD file, 2017-06-15]
production_parts/connectors/headers/2X06_PTH/stl/2X6.stl
15.6 x 5.00 x 11.5
