sparkfun/3D_Models/production_parts/connectors/headers/2X3/2x3.SLDPRT

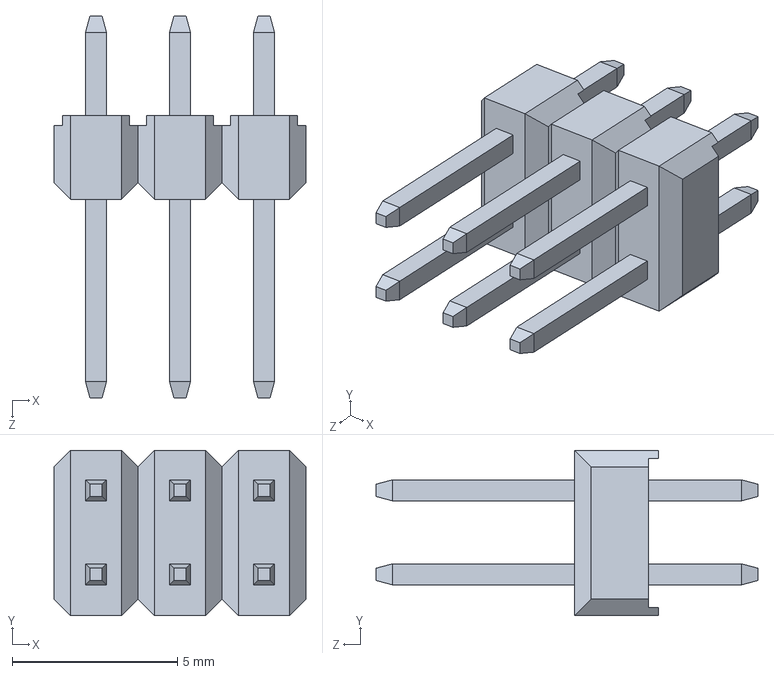
[picture p264: CAD file, 2015-06-05]
production_parts/connectors/headers/2X3/2x3.SLDPRT
7.62 x 5.00 x 11.5 mm
