sparkfun/3D_Models/production_parts/connectors/headers/2X3/2X3_SMT_POSTS/source_solidworks/2X3_SMT_POSTS.SLDPRT

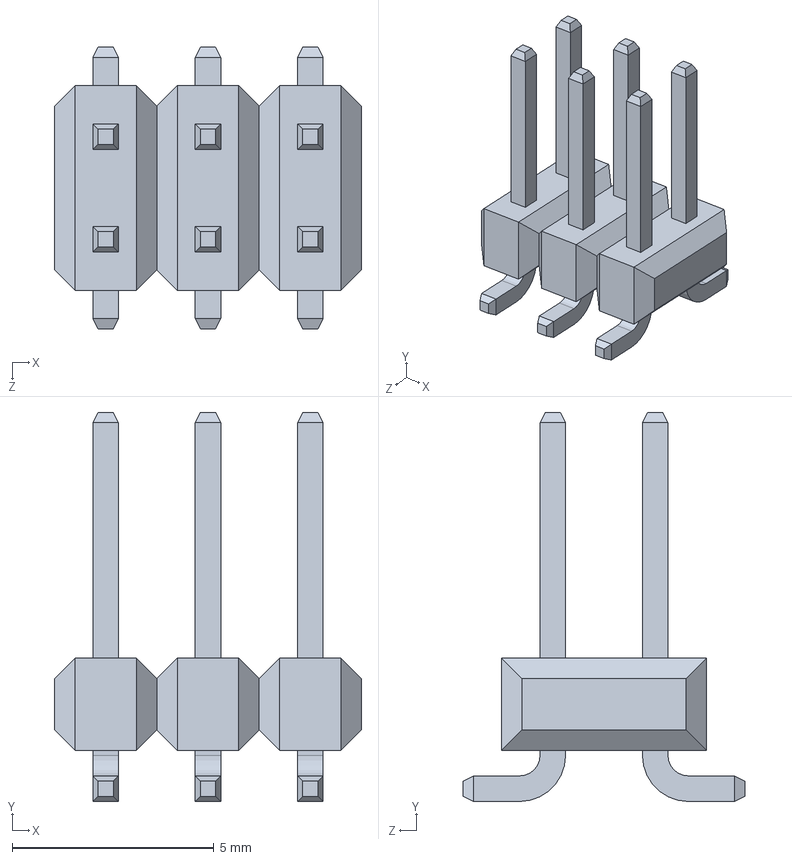
[picture p265: CAD file, 2015-02-02]
production_parts/connectors/headers/2X3/2X3_SMT_POSTS/source_solidworks/2X3_SMT_POSTS.SLDPRT
7.62 x 9.65 x 6.98 mm
