sparkfun/3D_Models/production_parts/connectors/headers/2X5-SHROUDED_SMD/source_solidworks/2X5-SHROUDED_SMD.SLDPRT

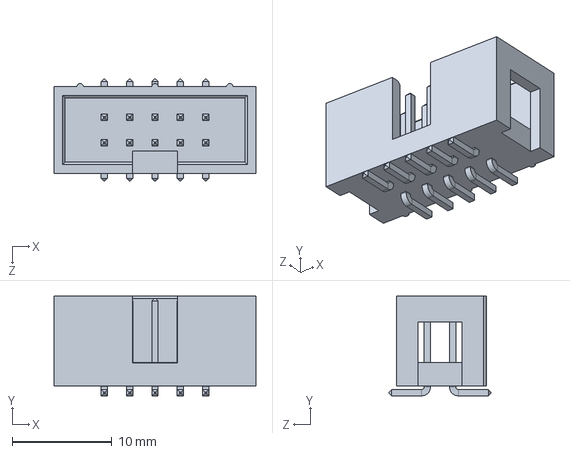
[picture p266: CAD file, 2015-02-02]
production_parts/connectors/headers/2X5-SHROUDED_SMD/source_solidworks/2X5-SHROUDED_SMD.SLDPRT
20.2 x 10.0 x 10.2 mm
