sparkfun/3D_Models/production_parts/connectors/headers/ID-12_SMD/source_solidworks/1X05.SLDPRT

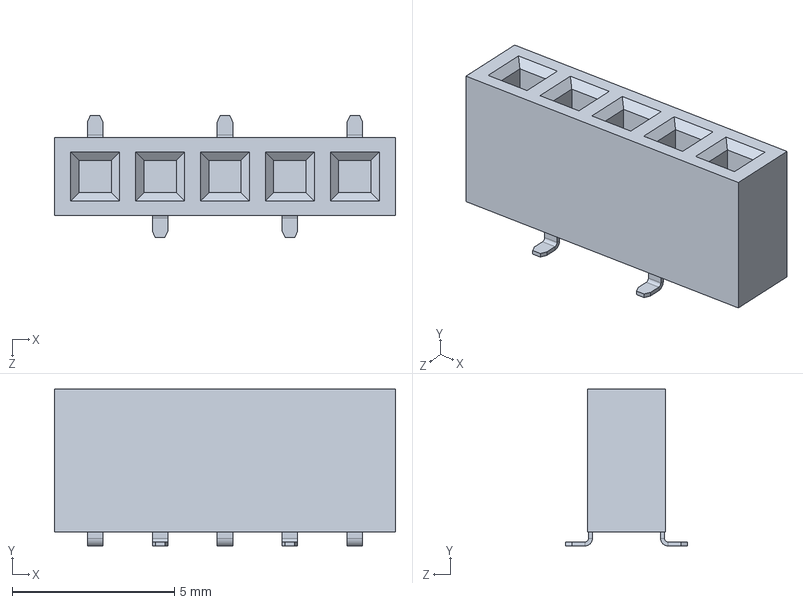
[picture p267: CAD file, 2015-04-03]
production_parts/connectors/headers/ID-12_SMD/source_solidworks/1X05.SLDPRT
10.5 x 4.83 x 3.76 mm
