sparkfun/3D_Models/production_parts/connectors/headers/ID-12_SMD/stl/ID-12_1X07.stl

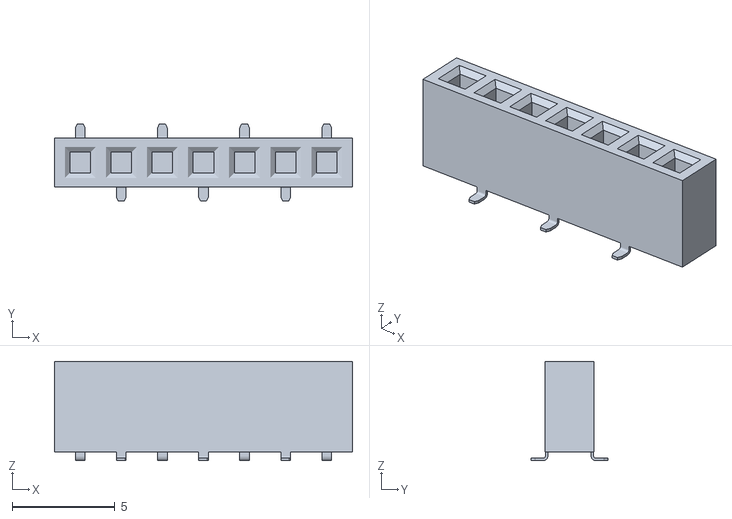
[picture p268: CAD file, 2017-06-15]
production_parts/connectors/headers/ID-12_SMD/stl/ID-12_1X07.stl
14.5 x 3.76 x 4.83
