sparkfun/3D_Models/production_parts/connectors/ID-12_SMD/stl/ID-12_SMD_base.stl

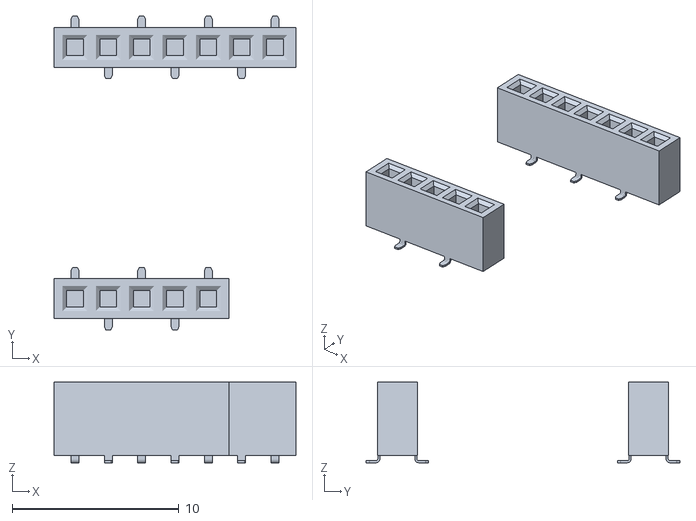
[picture p269: CAD file, 2017-06-15]
production_parts/connectors/ID-12_SMD/stl/ID-12_SMD_base.stl
14.5 x 18.8 x 4.83
