sparkfun/3D_Models/production_parts/connectors/JST/JST-2-SMD/MICRO-SD-SOCKET-PP.stl

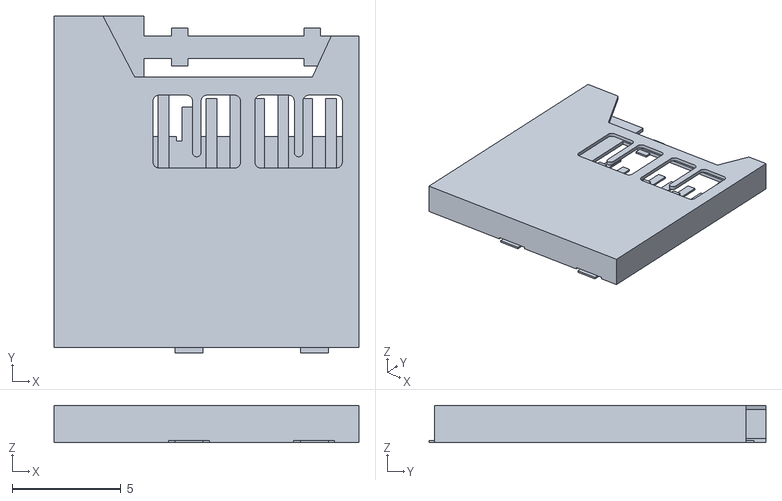
[picture p270: CAD file, 2017-06-15]
production_parts/connectors/JST/JST-2-SMD/MICRO-SD-SOCKET-PP.stl
14.0 x 15.4 x 1.72
