sparkfun/3D_Models/production_parts/connectors/JST/JST_2/JST-2-PTH/source_solidworks/JST-2-PTH.SLDPRT

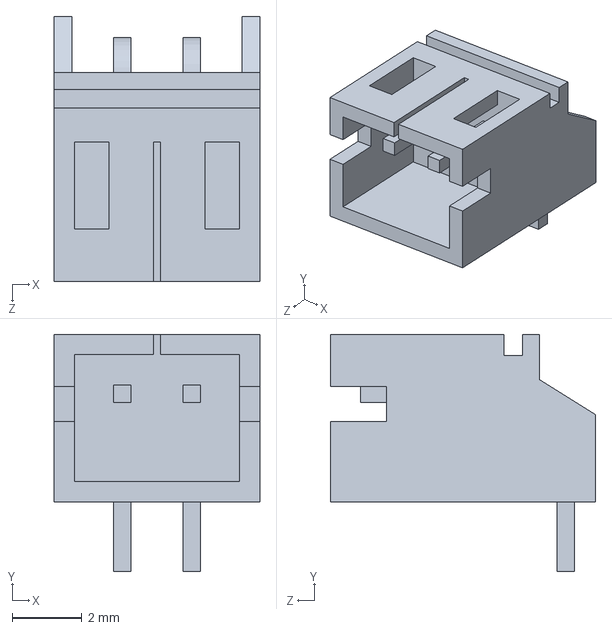
[picture p271: CAD file, 2016-03-30]
production_parts/connectors/JST/JST_2/JST-2-PTH/source_solidworks/JST-2-PTH.SLDPRT
5.90 x 6.80 x 7.60 mm
