sparkfun/3D_Models/production_parts/connectors/JST/JST_2/JST-2-SMD/source_solidworks/JST-2-SMD.SLDPRT

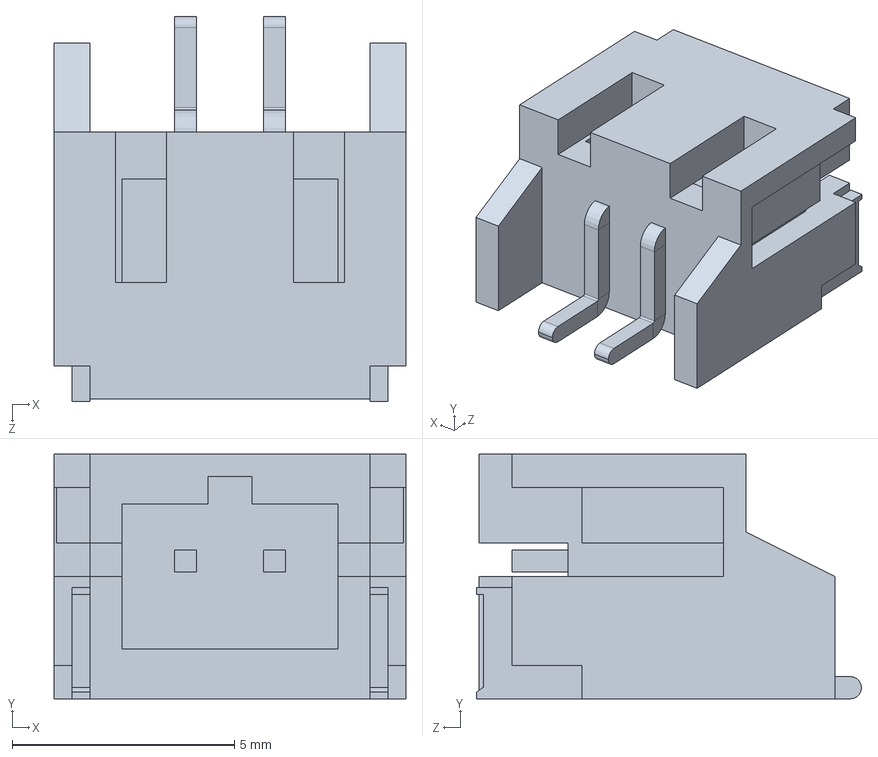
[picture p272: CAD file, 2015-02-02]
production_parts/connectors/JST/JST_2/JST-2-SMD/source_solidworks/JST-2-SMD.SLDPRT
7.90 x 5.50 x 8.65 mm
