sparkfun/3D_Models/production_parts/connectors/JST/JST_2/JST-2-SMD/stl/S2B-PH.stl

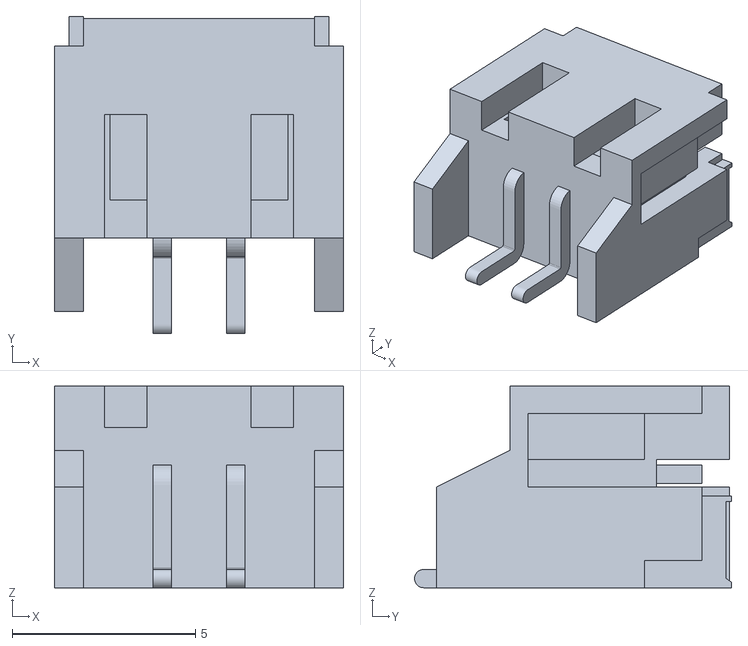
[picture p273: CAD file, 2017-06-15]
production_parts/connectors/JST/JST_2/JST-2-SMD/stl/S2B-PH.stl
7.90 x 8.65 x 5.50
