sparkfun/3D_Models/production_parts/connectors/JST/JST_3/JST-3-PTH-VERT/source_solidworks/JST-3-PTH-VERT.SLDPRT

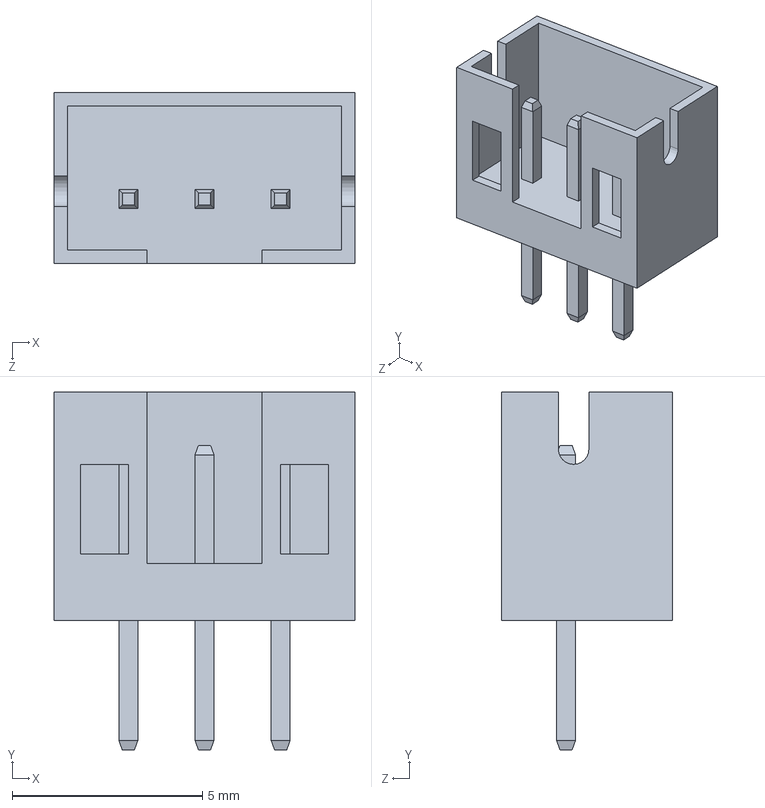
[picture p274: CAD file, 2016-03-30]
production_parts/connectors/JST/JST_3/JST-3-PTH-VERT/source_solidworks/JST-3-PTH-VERT.SLDPRT
7.90 x 9.40 x 4.50 mm
