sparkfun/3D_Models/production_parts/connectors/JST/JST_4/JST-4-PTH-VERT/source_solidworks/JST-4-PTH-VERT.SLDPRT

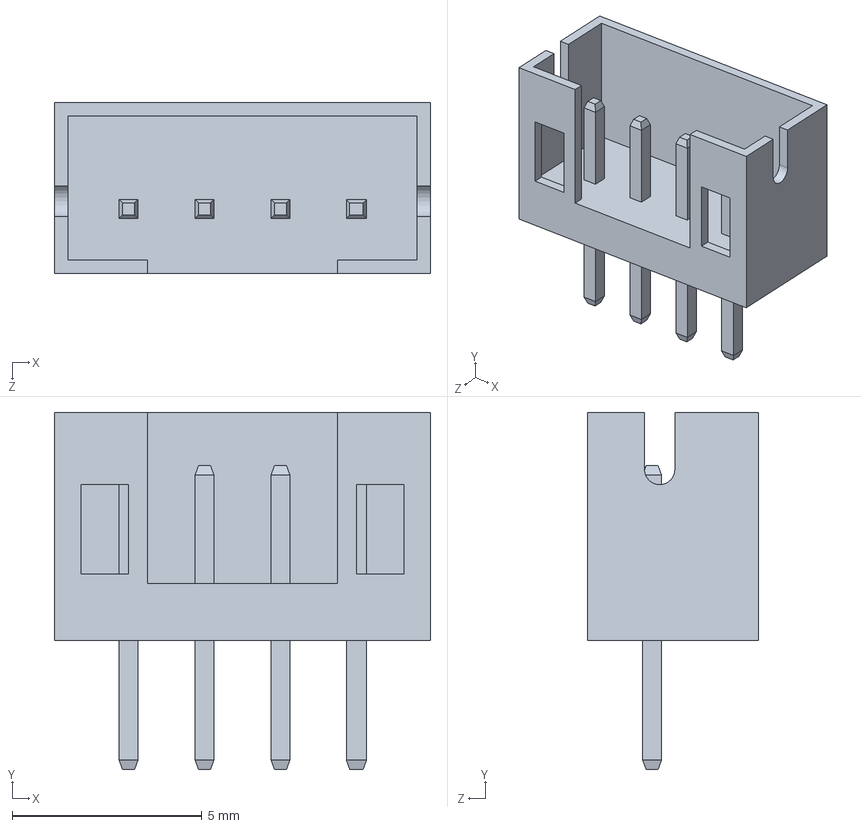
[picture p275: CAD file, 2016-03-30]
production_parts/connectors/JST/JST_4/JST-4-PTH-VERT/source_solidworks/JST-4-PTH-VERT.SLDPRT
9.90 x 9.40 x 4.50 mm
