sparkfun/3D_Models/production_parts/connectors/Photon/SPARK_PHOTON_TEMPLATE_WIDE.stl

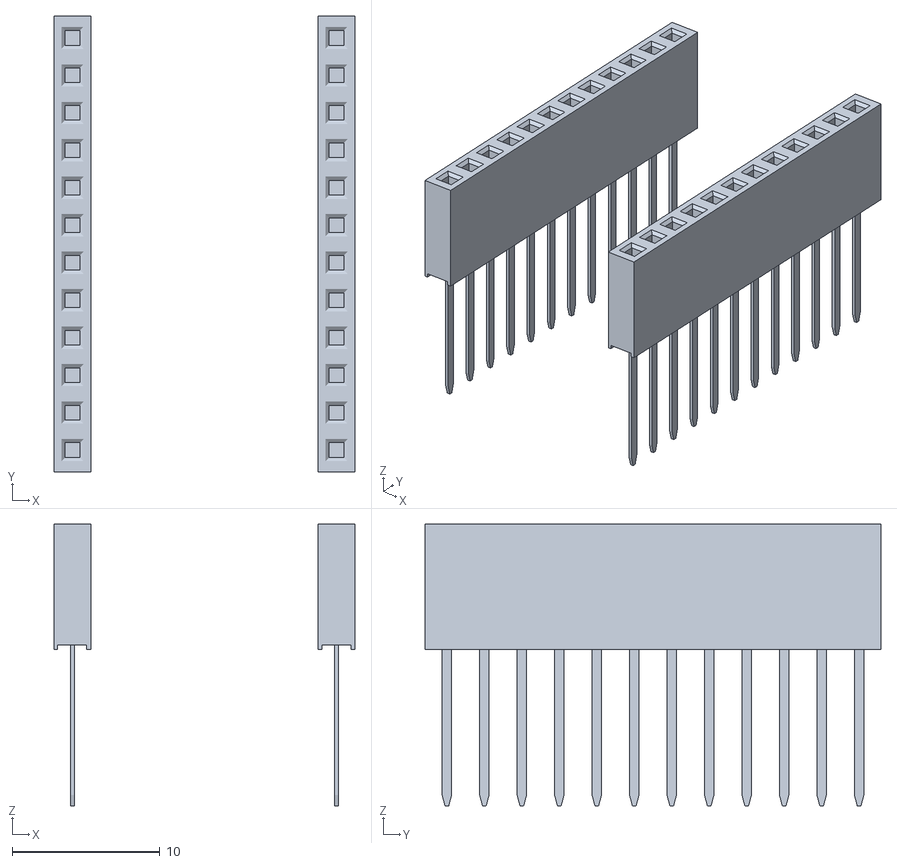
[picture p276: CAD file, 2017-06-15]
production_parts/connectors/Photon/SPARK_PHOTON_TEMPLATE_WIDE.stl
20.4 x 30.9 x 19.1
