sparkfun/3D_Models/production_parts/connectors/Power_Jack/POWER_JACK_SMD_OVERPASTE_TOE.stl

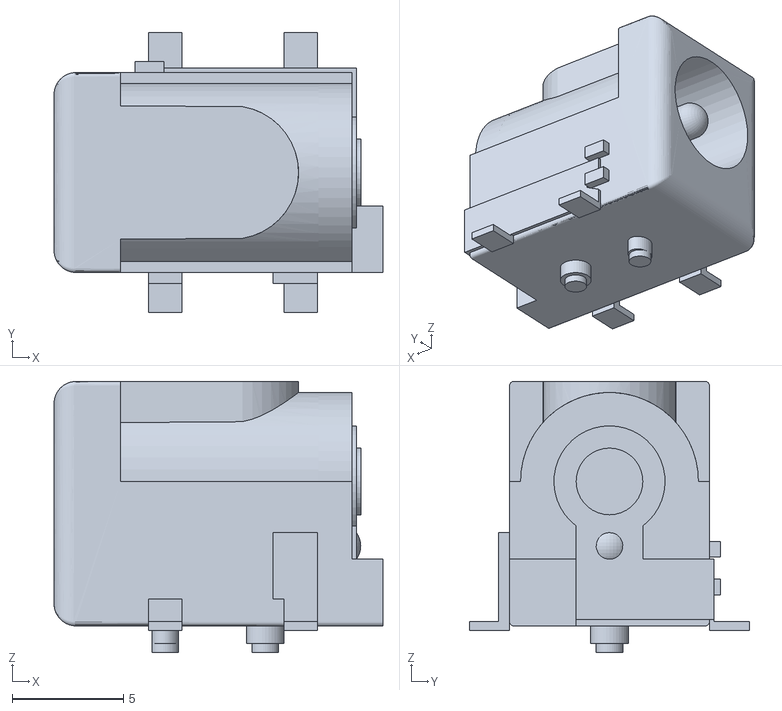
[picture p277: CAD file, 2017-06-15]
production_parts/connectors/Power_Jack/POWER_JACK_SMD_OVERPASTE_TOE.stl
14.8 x 12.6 x 12.2
