sparkfun/3D_Models/production_parts/connectors/Power_Jack/step/POWER_JACK_PTH.STEP

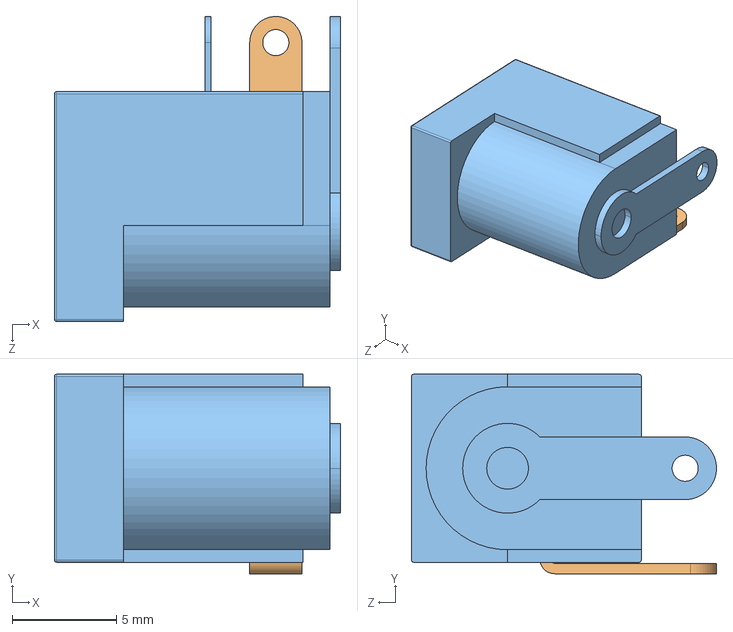
[picture p278: CAD file, 2015-06-05]
production_parts/connectors/Power_Jack/step/POWER_JACK_PTH.STEP
13.7 x 9.55 x 14.6 mm
