sparkfun/3D_Models/production_parts/connectors/RJ11/step/RJ11-6.STEP

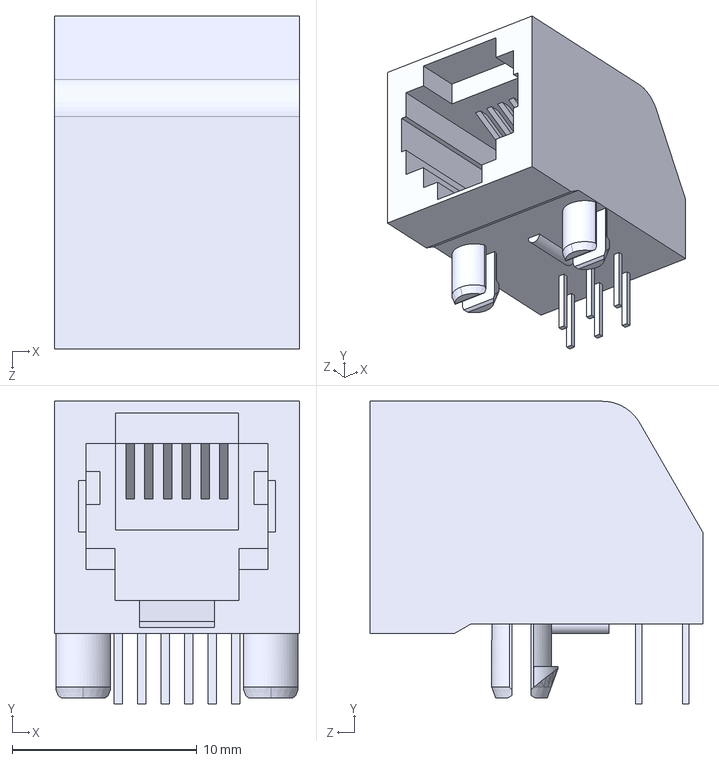
[picture p279: CAD file, 2015-08-26]
production_parts/connectors/RJ11/step/RJ11-6.STEP
13.3 x 16.4 x 18.0 mm
