sparkfun/3D_Models/production_parts/connectors/sim/SIMHOLDER/step/SIMHOLDER.STEP

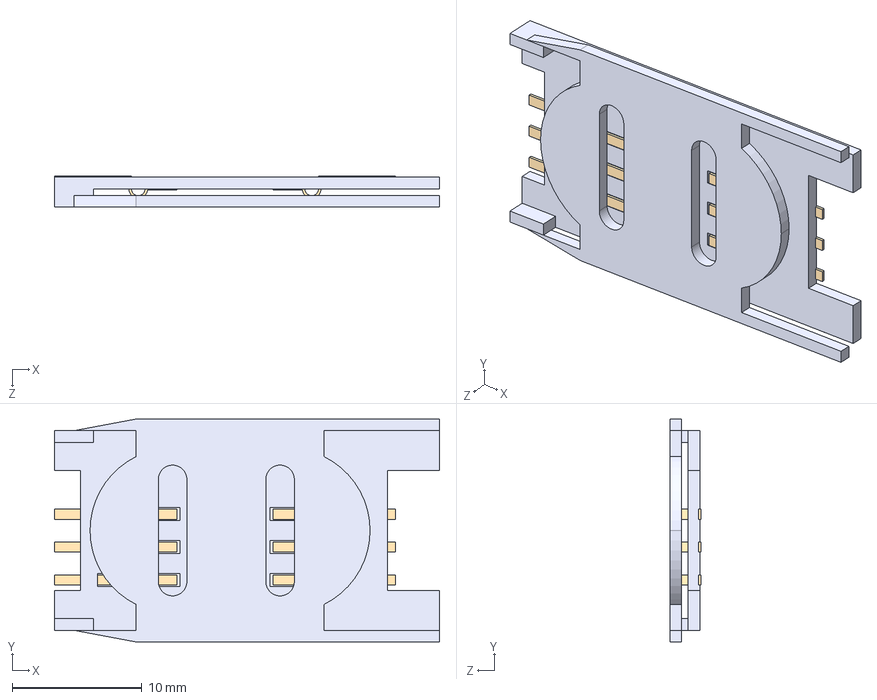
[picture p280: CAD file, 2015-04-03]
production_parts/connectors/sim/SIMHOLDER/step/SIMHOLDER.STEP
29.7 x 17.2 x 2.40 mm
