sparkfun/3D_Models/production_parts/connectors/specific_board_connectors/ARDUINO_R3_NOISP_LOCKING/ARDUINO_R3_NOISP_LOCKING.stl

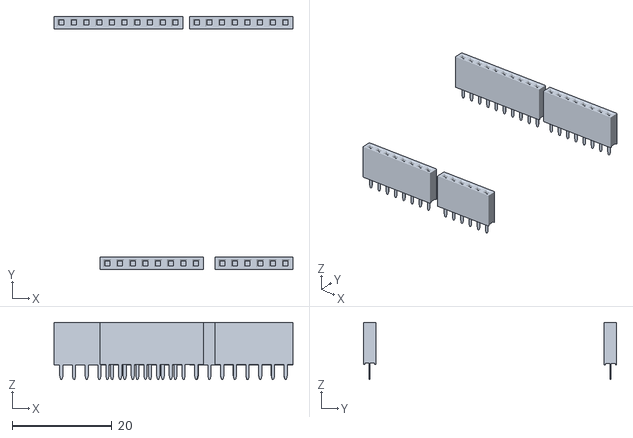
[picture p281: CAD file, 2017-06-15]
production_parts/connectors/specific_board_connectors/ARDUINO_R3_NOISP_LOCKING/ARDUINO_R3_NOISP_LOCKING.stl
47.9 x 50.7 x 11.5
