sparkfun/3D_Models/production_parts/connectors/specific_board_connectors/EDISON/step/DF40HC_3.0_-70DS.stp

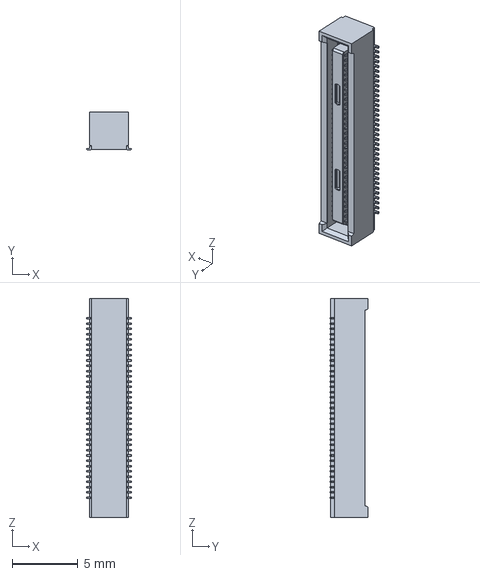
[picture p282: CAD file, 2015-02-02]
production_parts/connectors/specific_board_connectors/EDISON/step/DF40HC_3.0_-70DS.stp
3.38 x 2.90 x 16.6 mm
