sparkfun/3D_Models/production_parts/connectors/specific_board_connectors/MAGJACK.stl

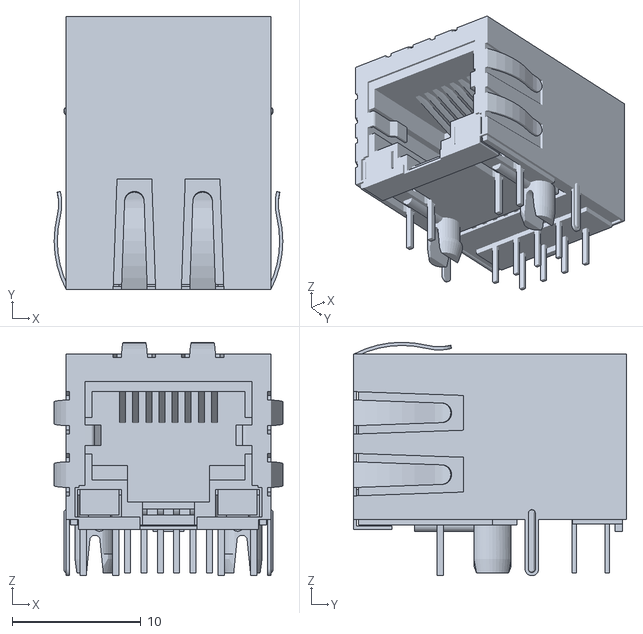
[picture p283: CAD file, 2017-06-15]
production_parts/connectors/specific_board_connectors/MAGJACK.stl
17.8 x 21.2 x 18.1
