sparkfun/3D_Models/production_parts/connectors/specific_board_connectors/U_FL/step/U_FL.STEP

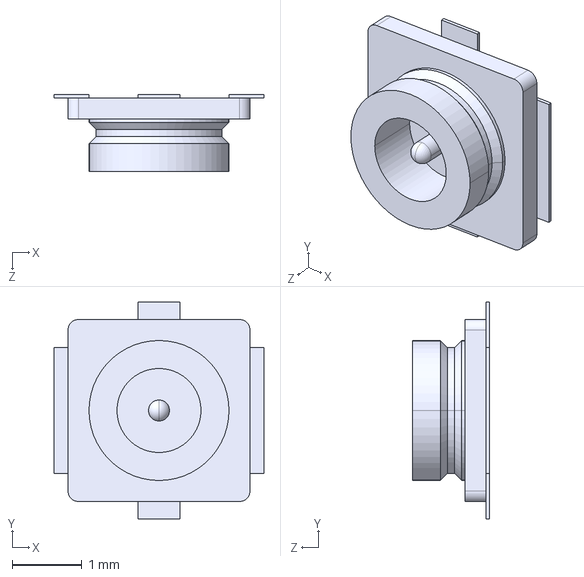
[picture p284: CAD file, 2016-01-20]
production_parts/connectors/specific_board_connectors/U_FL/step/U_FL.STEP
3.00 x 3.10 x 1.10 mm
