sparkfun/3D_Models/production_parts/connectors/usb/USB-MINIB-NOSTOP.stl

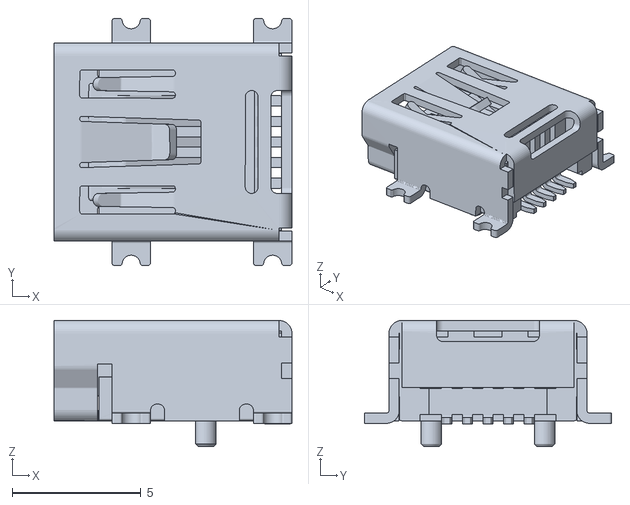
[picture p285: CAD file, 2017-06-15]
production_parts/connectors/usb/USB-MINIB-NOSTOP.stl
9.25 x 9.60 x 4.90
