sparkfun/3D_Models/production_parts/mechanical/stepoko_heatsink/step/HeatSink.STEP

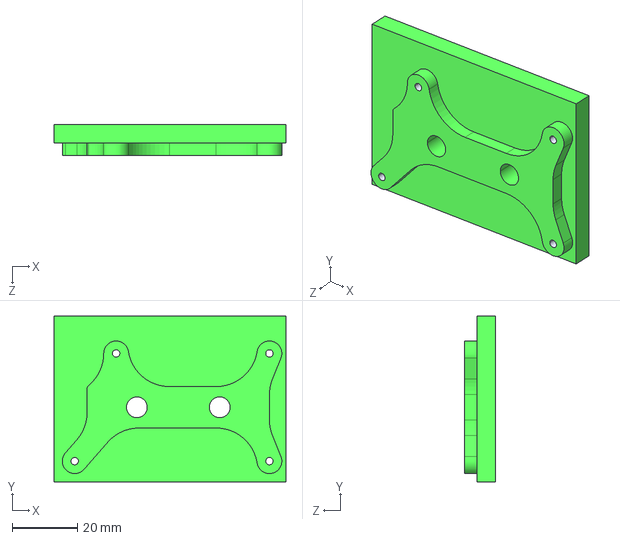
[picture p286: CAD file, 2016-01-20]
production_parts/mechanical/stepoko_heatsink/step/HeatSink.STEP
71.1 x 50.8 x 9.53 mm
