sparkfun/3D_Models/production_parts/modules/BC127_XTRA_PASTE/step/BC127_XTRA_PASTE.STEP

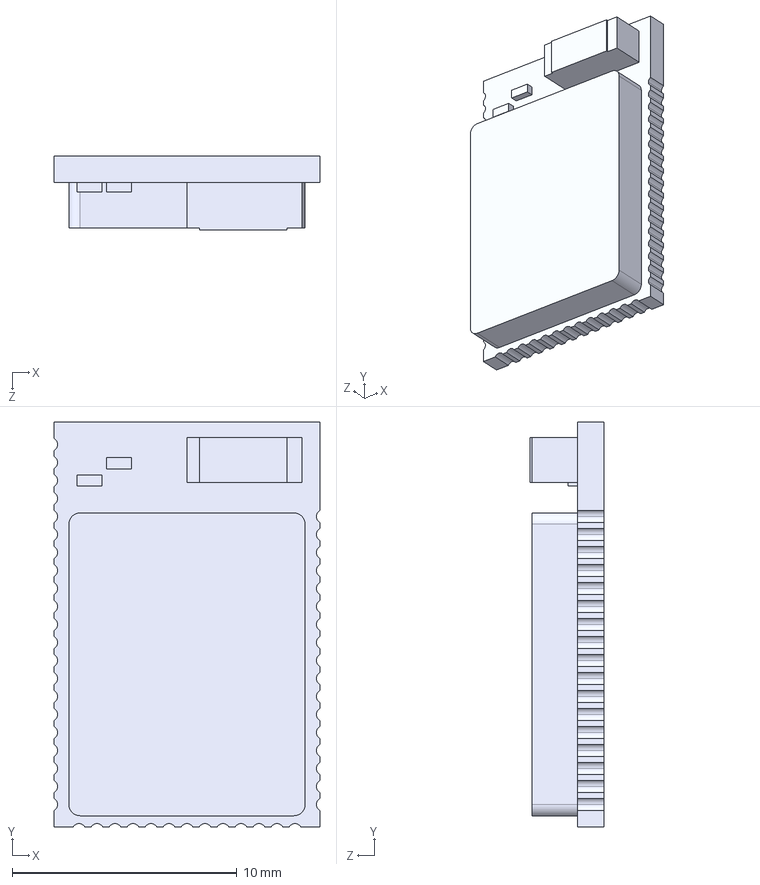
[picture p287: CAD file, 2016-02-03]
production_parts/modules/BC127_XTRA_PASTE/step/BC127_XTRA_PASTE.STEP
11.8 x 18.0 x 3.30 mm
