sparkfun/3D_Models/production_parts/modules/display/7-SEGMENT-4DIGIT-YOUNGSUN/step/7-SEGMENT-4DIGIT-YOUNGSUN.STEP

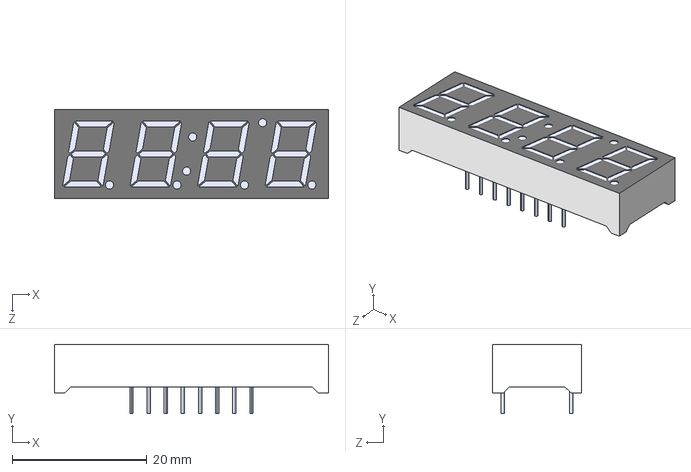
[picture p288: CAD file, 2016-03-14]
production_parts/modules/display/7-SEGMENT-4DIGIT-YOUNGSUN/step/7-SEGMENT-4DIGIT-YOUNGSUN.STEP
40.6 x 10.2 x 13.1 mm
