sparkfun/3D_Models/production_parts/modules/display/OLED/step/OLED-0_66-64X48.STEP

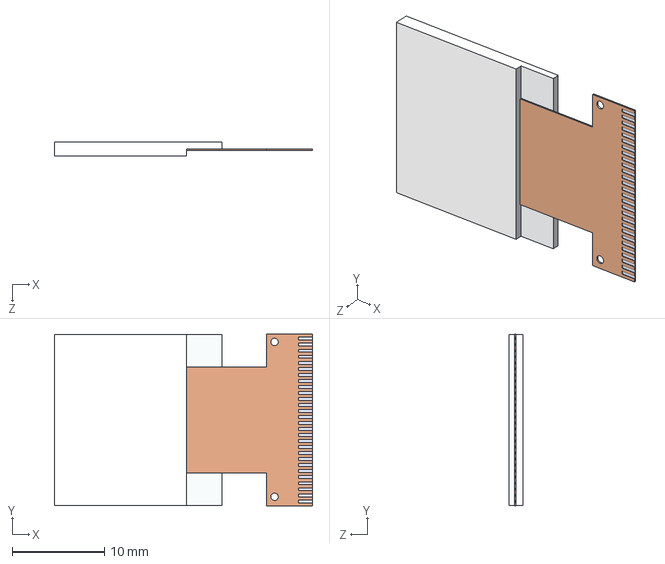
[picture p289: CAD file, 2015-08-19]
production_parts/modules/display/OLED/step/OLED-0_66-64X48.STEP
27.9 x 18.6 x 1.50 mm
