sparkfun/3D_Models/production_parts/modules/GPS/MG2639/step/MG2639.STEP

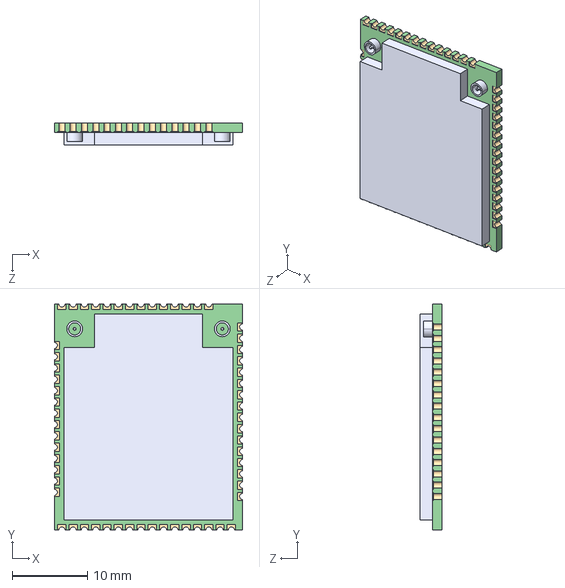
[picture p290: CAD file, 2015-04-03]
production_parts/modules/GPS/MG2639/step/MG2639.STEP
25.0 x 30.0 x 2.97 mm
