sparkfun/3D_Models/production_parts/modules/Teensy-3_2/Teensy_3_1.stp

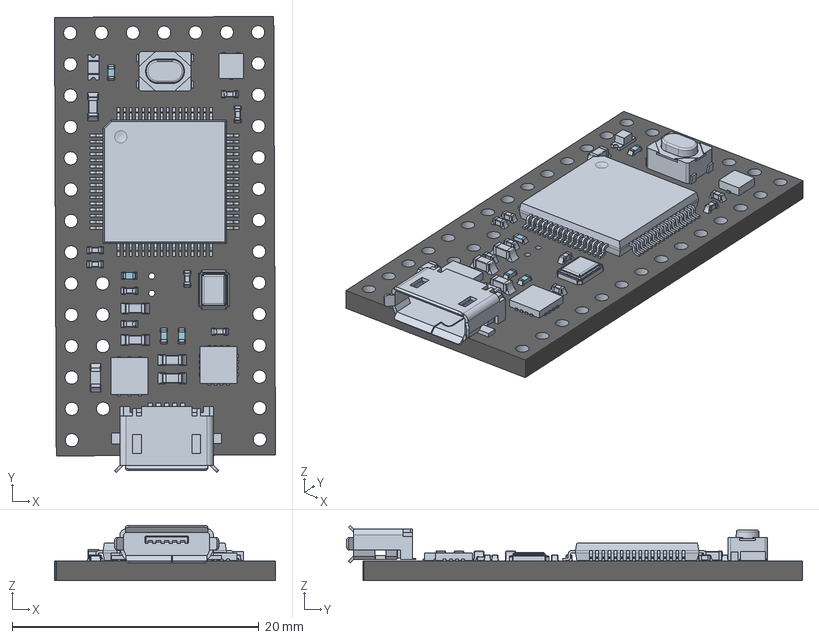
[picture p291: CAD file, 2017-08-09]
production_parts/modules/Teensy-3_2/Teensy_3_1.stp
17.9 x 37.0 x 4.49 mm
board
micro_usb_plastic (1)
micro_usb_shell (1)
lead
package (1)
lead (3) x 64
package
lead (1)
cap0402 v2 x 6
lead (2)
diode_0402 v1 x 4
cap0603_03 v3 x 5
cap0402 v2 (1) x 2
smt_led_0805 v2
resistor_0603 v3
