sparkfun/3D_Models/production_parts/modules/wireless/bluetooth/rn41/source_solidworks/RN41.SLDPRT

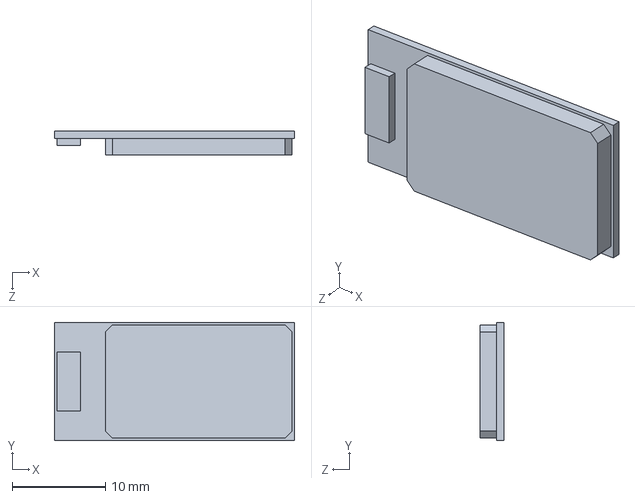
[picture p292: CAD file, 2015-01-30]
production_parts/modules/wireless/bluetooth/rn41/source_solidworks/RN41.SLDPRT
25.8 x 12.7 x 2.54 mm
