sparkfun/3D_Models/production_parts/modules/wireless/bluetooth/rn52/step/RN-52.STEP

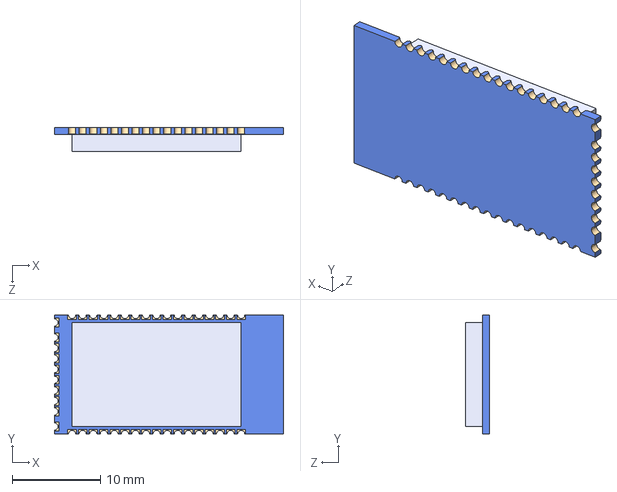
[picture p293: CAD file, 2015-04-09]
production_parts/modules/wireless/bluetooth/rn52/step/RN-52.STEP
26.0 x 13.5 x 2.70 mm
