sparkfun/3D_Models/production_parts/modules/wireless/photon/WM-N-BM-14/step/WM-N-BM-14.STEP

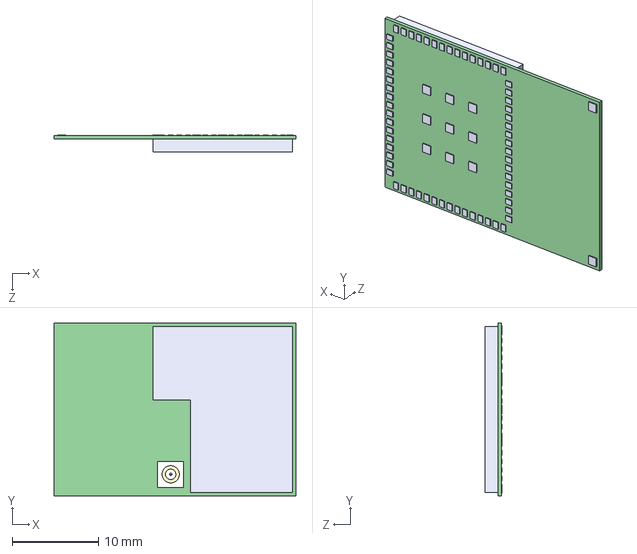
[picture p294: CAD file, 2015-08-26]
production_parts/modules/wireless/photon/WM-N-BM-14/step/WM-N-BM-14.STEP
28.0 x 20.0 x 2.00 mm
