sparkfun/3D_Models/production_parts/opto/FN-6/source_solidworks/FN-6.SLDPRT

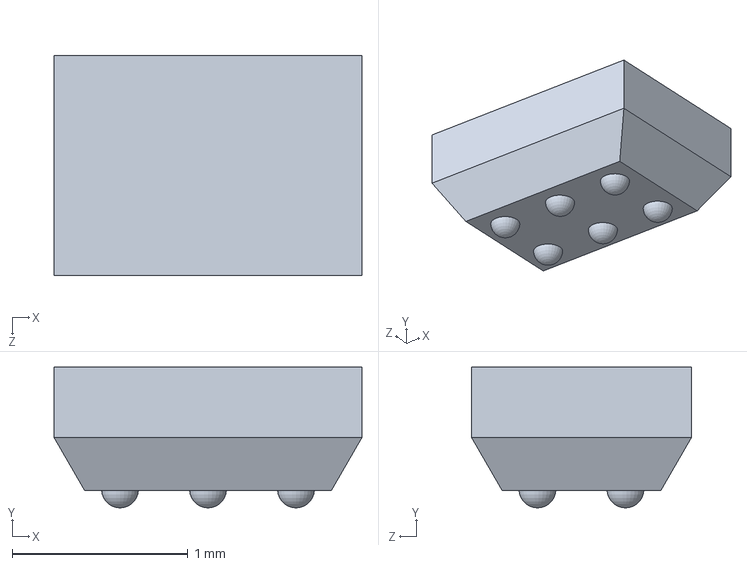
[picture p295: CAD file, 2015-02-02]
production_parts/opto/FN-6/source_solidworks/FN-6.SLDPRT
1.75 x 0.8 x 1.25 mm
