sparkfun/3D_Models/production_parts/opto/LED5MM/LED5MM.SLDPRT

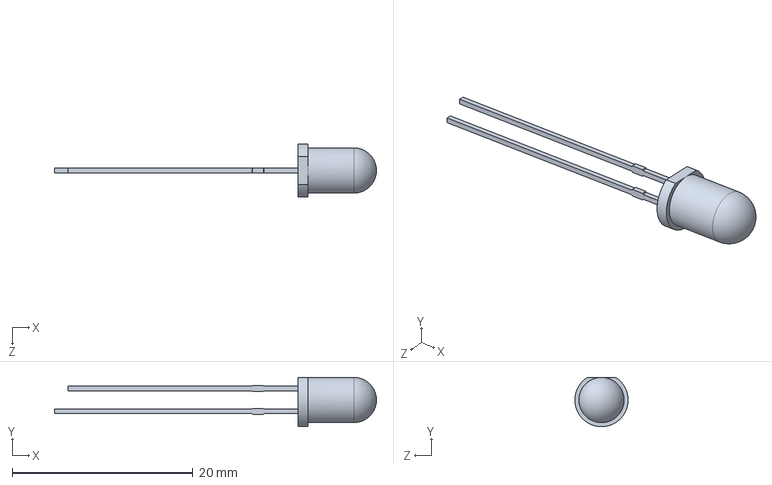
[picture p296: CAD file, 2016-09-15]
production_parts/opto/LED5MM/LED5MM.SLDPRT
35.6 x 5.45 x 5.90 mm
