sparkfun/3D_Models/production_parts/opto/LED_0603/0603-LED-ALT1.stl

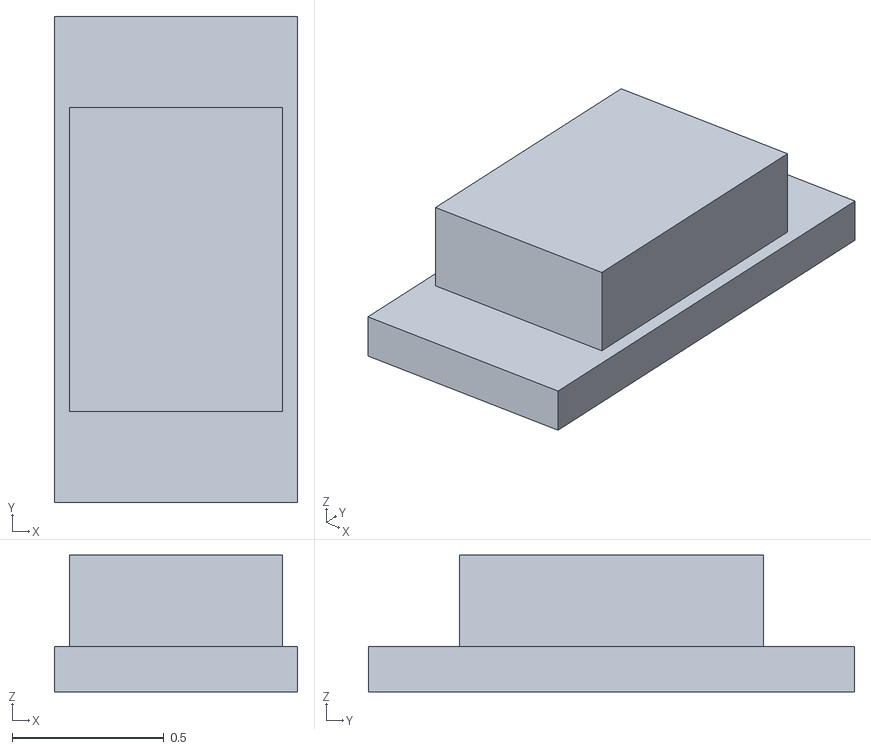
[picture p297: CAD file, 2017-06-15]
production_parts/opto/LED_0603/0603-LED-ALT1.stl
0.8 x 1.60 x 0.45
