sparkfun/3D_Models/production_parts/opto/LED_1206/LED-1206-BOTTOM.stl

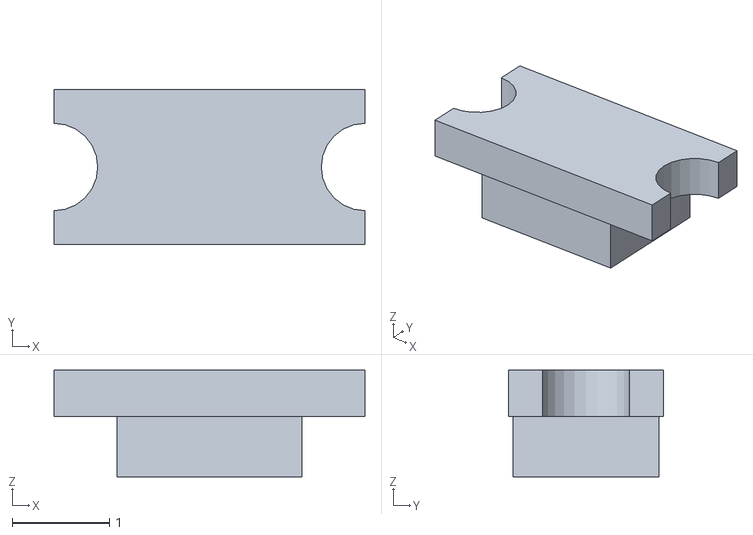
[picture p298: CAD file, 2017-06-15]
production_parts/opto/LED_1206/LED-1206-BOTTOM.stl
3.20 x 1.60 x 1.10
