sparkfun/3D_Models/production_parts/opto/LED_BAR_SMD/geometry_edit_blender/LED_BAR_SMD.SLDPRT

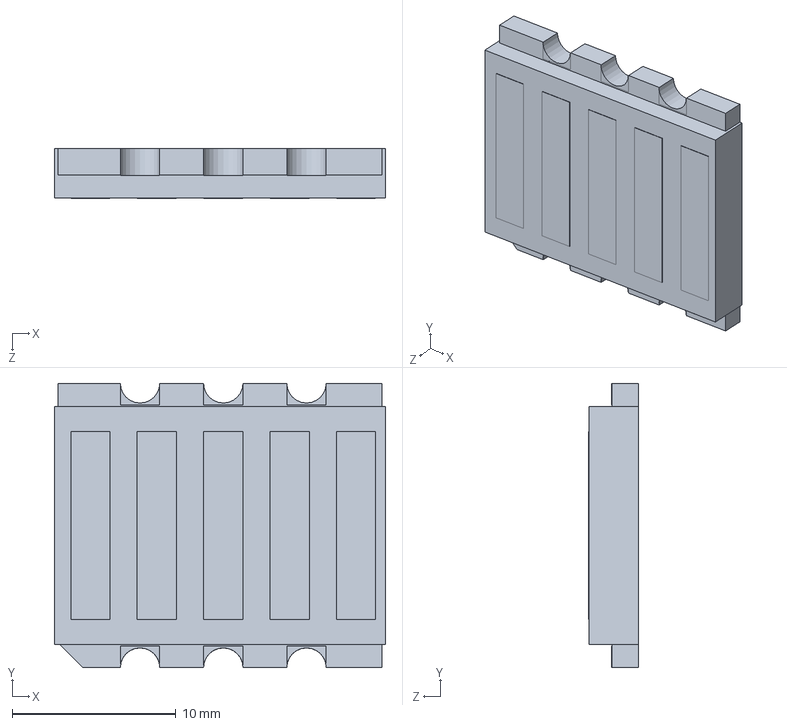
[picture p299: CAD file, 2016-08-24]
production_parts/opto/LED_BAR_SMD/geometry_edit_blender/LED_BAR_SMD.SLDPRT
20.2 x 17.3 x 3.03 mm
