sparkfun/3D_Models/production_parts/opto/LED_tricolor/LED-TRICOLOR-5050-IC.stl

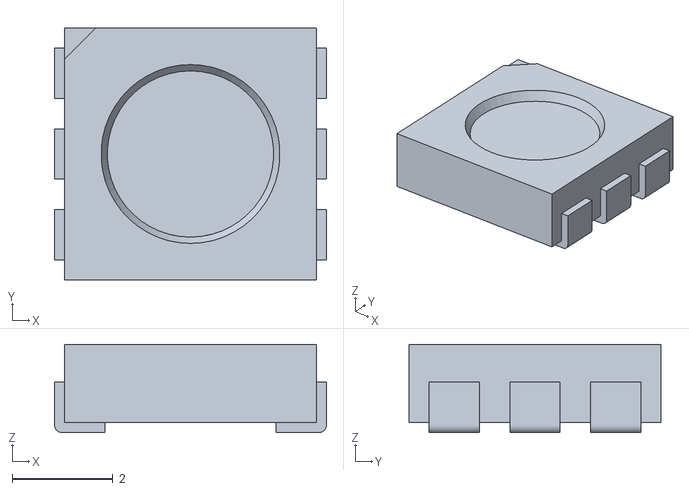
[picture p300: CAD file, 2017-06-15]
production_parts/opto/LED_tricolor/LED-TRICOLOR-5050-IC.stl
5.40 x 5.00 x 1.75
