sparkfun/3D_Models/production_parts/opto/LTST-C195KGJRKT/LTST-C195KGJRKT.SLDPRT

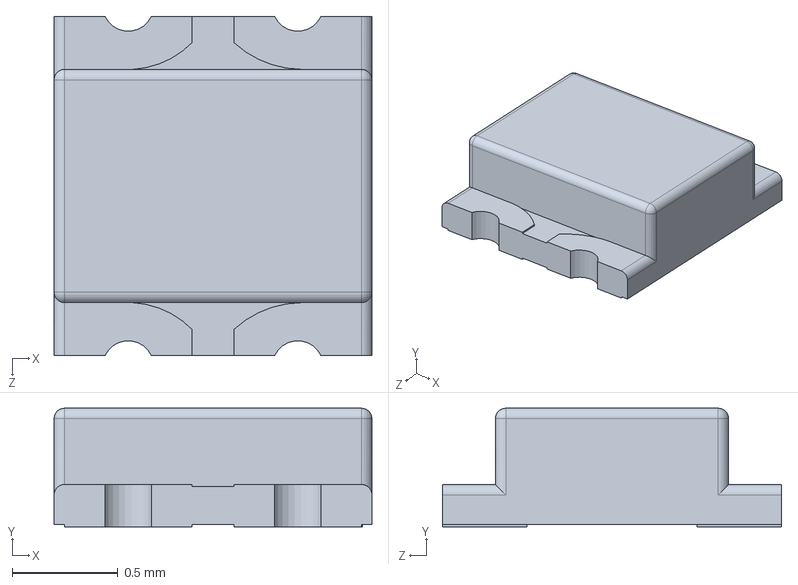
[picture p301: CAD file, 2016-06-01]
production_parts/opto/LTST-C195KGJRKT/LTST-C195KGJRKT.SLDPRT
1.50 x 0.56 x 1.60 mm
