sparkfun/3D_Models/production_parts/opto/PLCC-6-LED/step/PLCC-6-LED.STEP

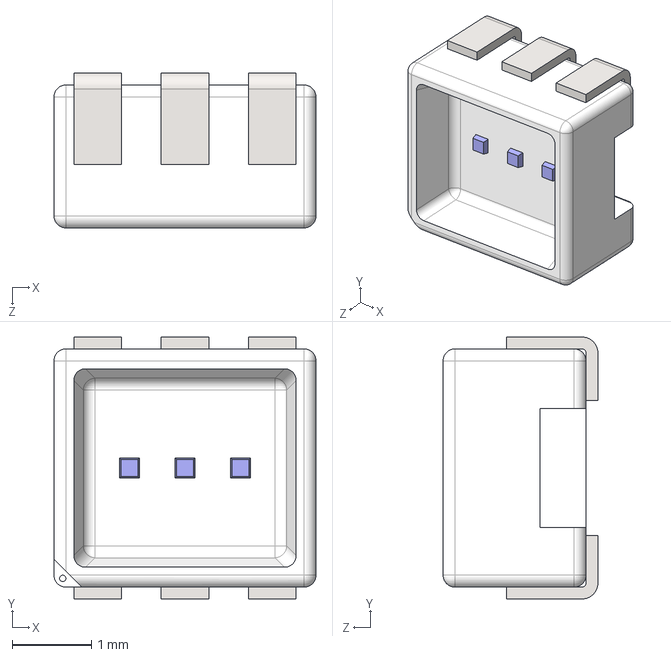
[picture p302: CAD file, 2015-08-26]
production_parts/opto/PLCC-6-LED/step/PLCC-6-LED.STEP
3.30 x 3.30 x 1.95 mm
