sparkfun/3D_Models/production_parts/opto/PT17-21C-L41-TR8/PT17-21C-L41-TR8.SLDPRT

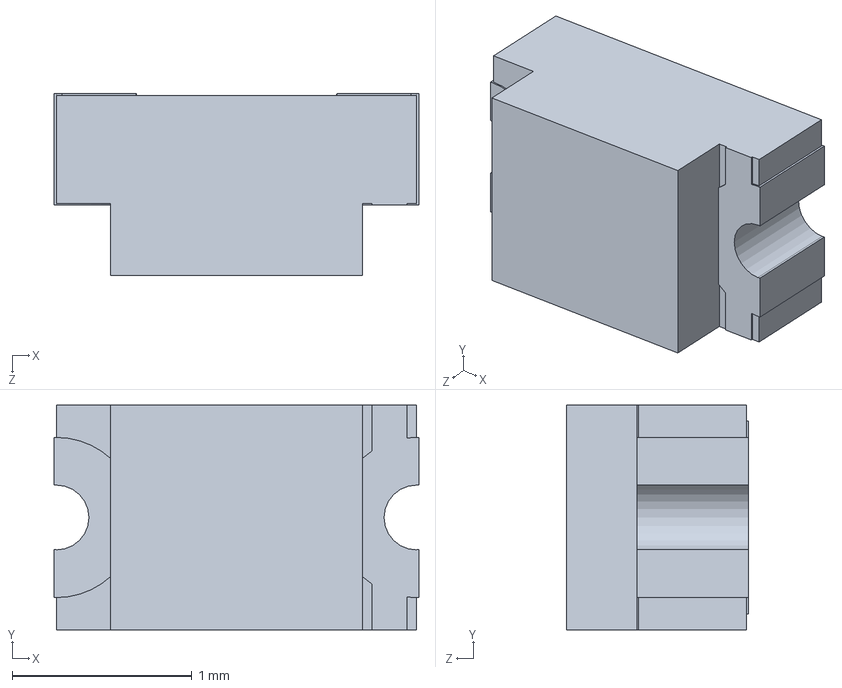
[picture p303: CAD file, 2016-06-01]
production_parts/opto/PT17-21C-L41-TR8/PT17-21C-L41-TR8.SLDPRT
2.03 x 1.25 x 1.01 mm
