sparkfun/3D_Models/production_parts/opto/PTH-LED/redled.stl

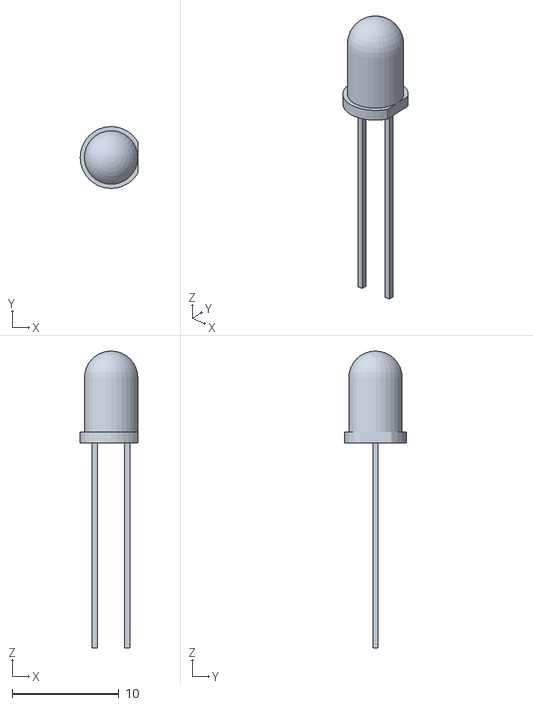
[picture p304: CAD file, 2017-06-15]
production_parts/opto/PTH-LED/redled.stl
5.40 x 5.80 x 27.8
