sparkfun/3D_Models/production_parts/opto/WS2812B/WS2812B.SLDPRT

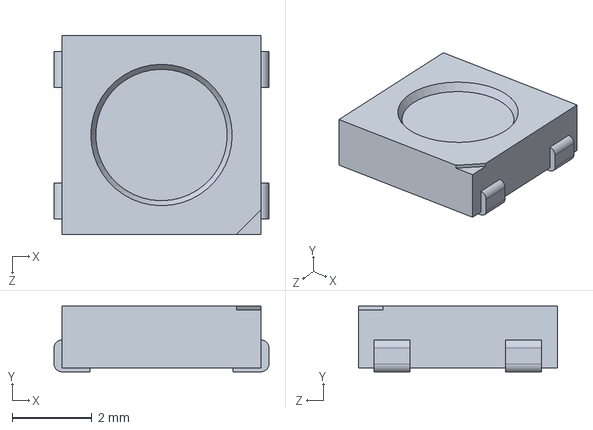
[picture p305: CAD file, 2016-03-30]
production_parts/opto/WS2812B/WS2812B.SLDPRT
5.40 x 1.65 x 5.00 mm
