sparkfun/3D_Models/production_parts/passive/ceramic_smd/0402/0402-CAP.stl

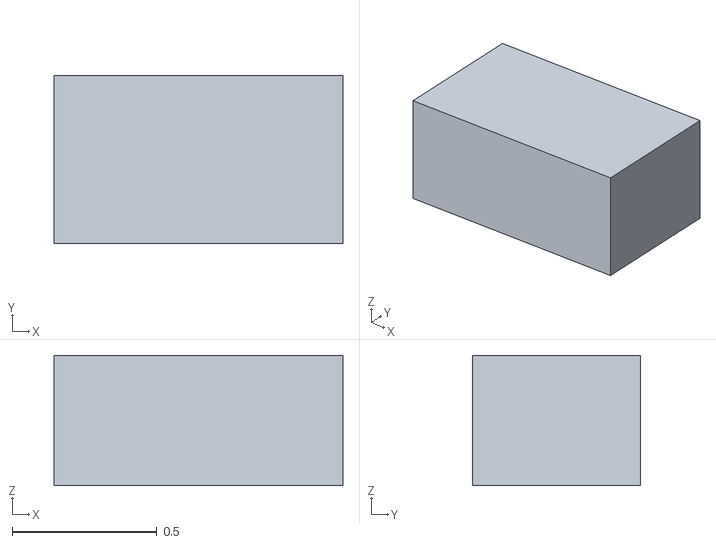
[picture p306: CAD file, 2017-06-15]
production_parts/passive/ceramic_smd/0402/0402-CAP.stl
1.00 x 0.58 x 0.45
