sparkfun/3D_Models/production_parts/passive/ceramic_smd/0603/0603.stl

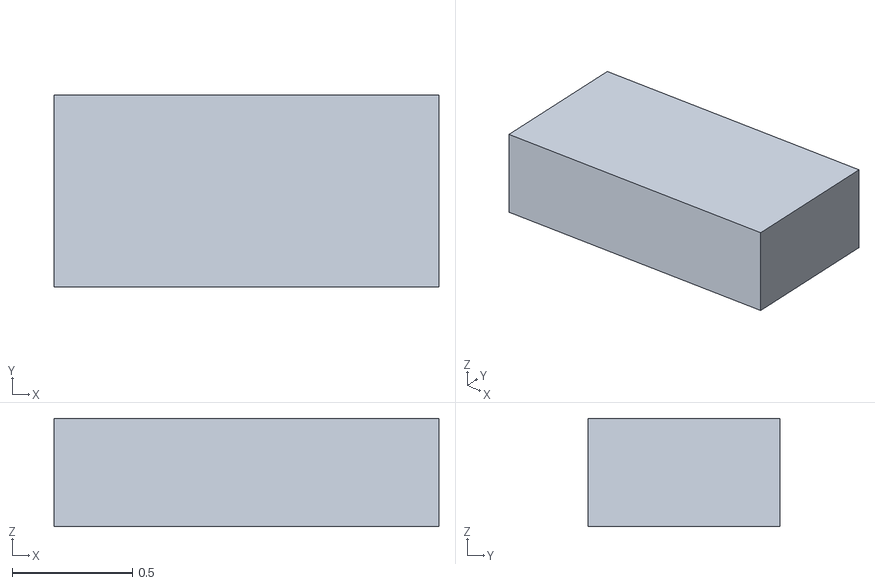
[picture p307: CAD file, 2017-06-15]
production_parts/passive/ceramic_smd/0603/0603.stl
1.60 x 0.8 x 0.45
