sparkfun/3D_Models/production_parts/passive/ceramic_smd/0805/0805.stl

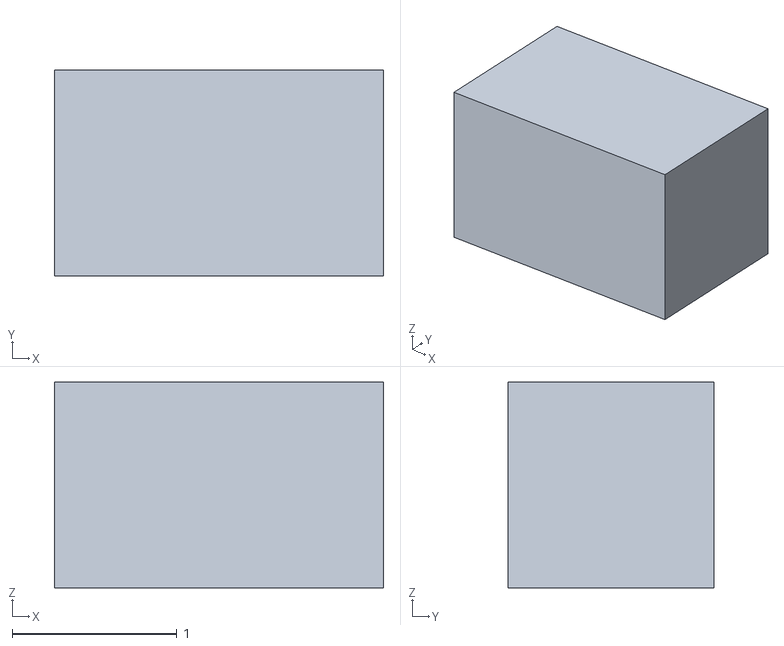
[picture p308: CAD file, 2017-06-15]
production_parts/passive/ceramic_smd/0805/0805.stl
2.00 x 1.25 x 1.25
