sparkfun/3D_Models/production_parts/passive/ceramic_smd/1206/1206.stl

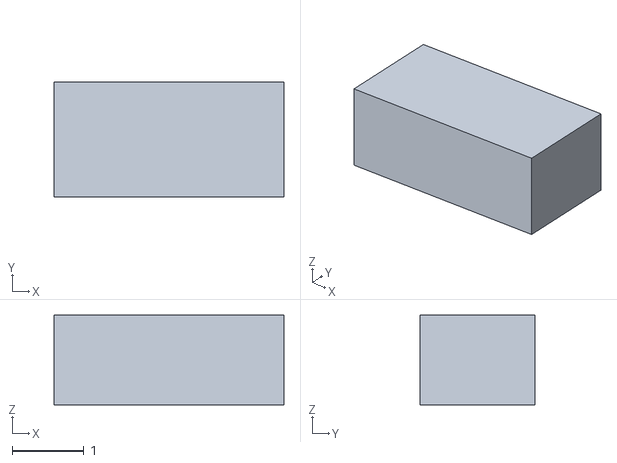
[picture p309: CAD file, 2017-06-15]
production_parts/passive/ceramic_smd/1206/1206.stl
3.20 x 1.60 x 1.25
