sparkfun/3D_Models/production_parts/passive/ceramic_smd/1210/1210.stl

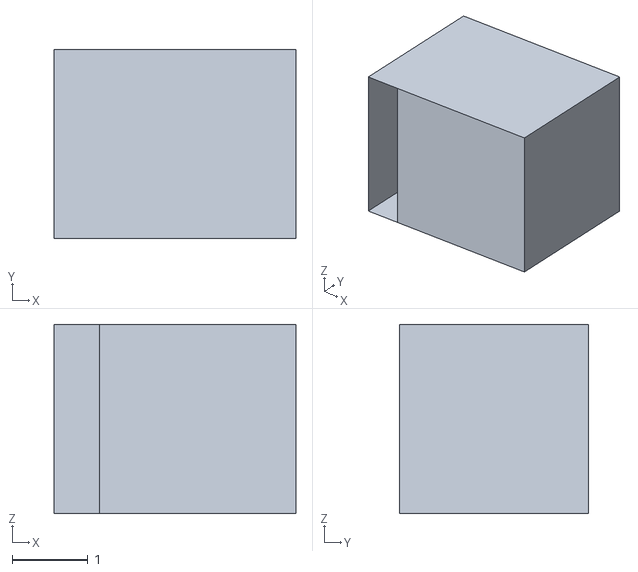
[picture p310: CAD file, 2017-06-15]
production_parts/passive/ceramic_smd/1210/1210.stl
3.20 x 2.50 x 2.50
