sparkfun/3D_Models/production_parts/passive/electrolytic_smd/panasonic_d/source_solidworks/panasonic_d.SLDPRT

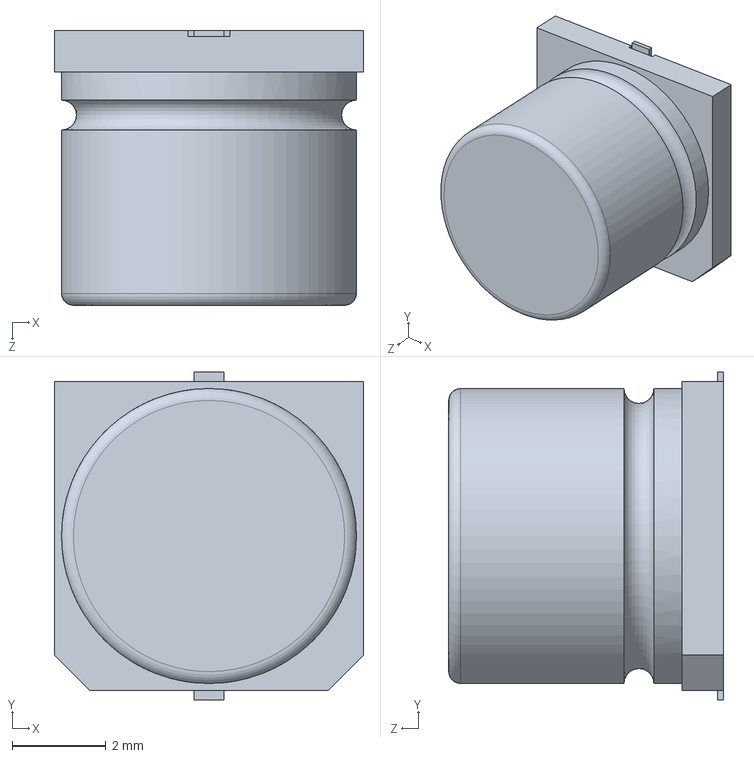
[picture p311: CAD file, 2015-01-19]
production_parts/passive/electrolytic_smd/panasonic_d/source_solidworks/panasonic_d.SLDPRT
6.60 x 7.00 x 5.87 mm
