sparkfun/3D_Models/production_parts/passive/inductors/CR54/step/CR54.STEP

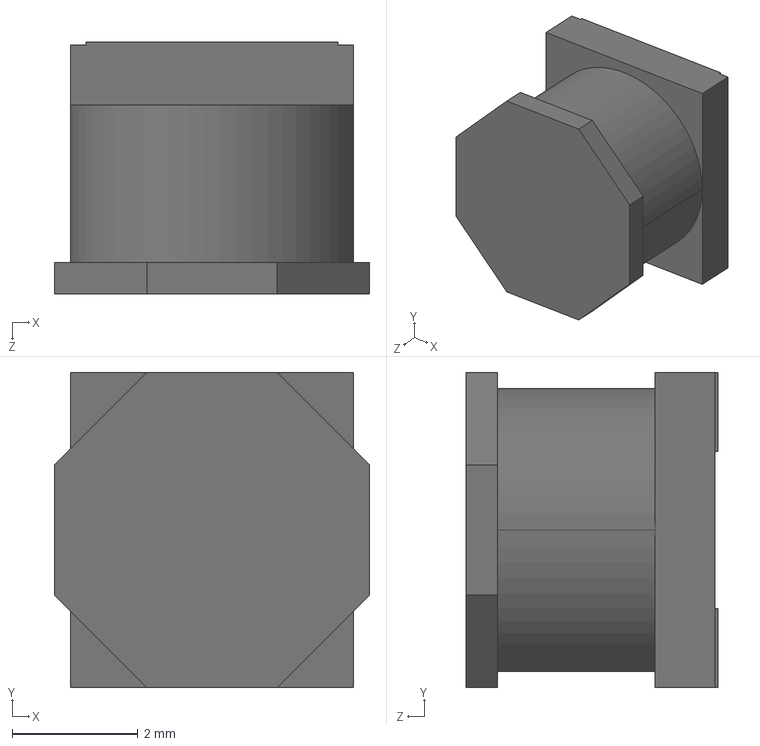
[picture p312: CAD file, 2015-03-31]
production_parts/passive/inductors/CR54/step/CR54.STEP
5.00 x 5.00 x 4.00 mm
