sparkfun/3D_Models/production_parts/passive/polyfuse/ptc-1206/source_solidworks/PTC-1206b.SLDPRT

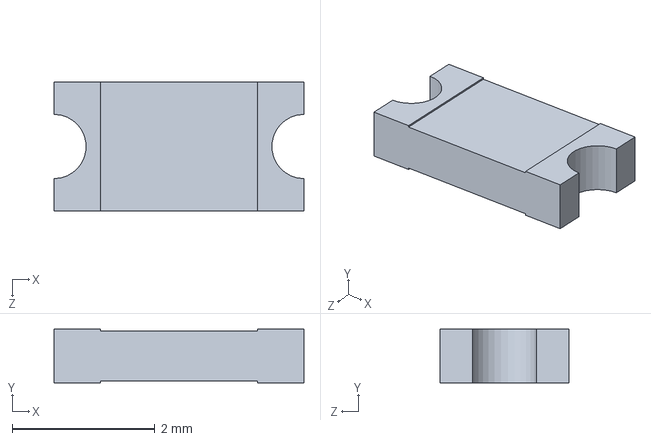
[picture p313: CAD file, 2015-02-02]
production_parts/passive/polyfuse/ptc-1206/source_solidworks/PTC-1206b.SLDPRT
3.50 x 0.75 x 1.80 mm
