sparkfun/3D_Models/production_parts/passive/resistors/2010/R2010.stl

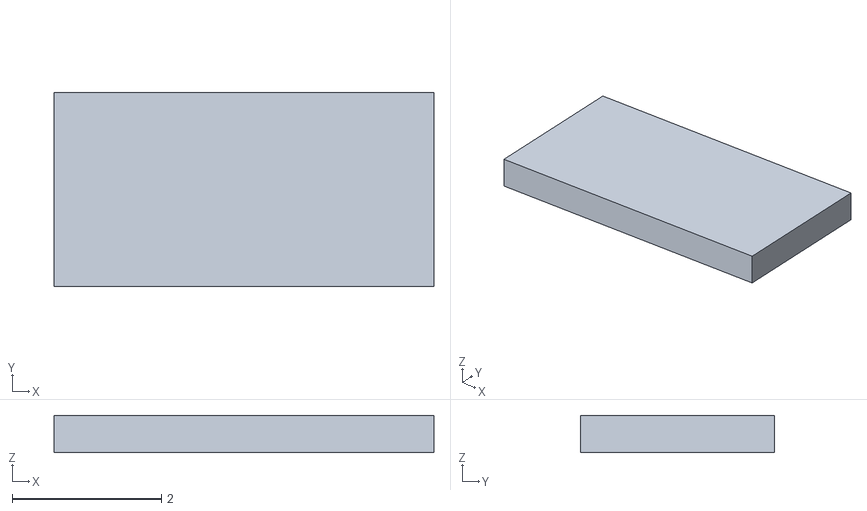
[picture p315: CAD file, 2017-06-15]
production_parts/passive/resistors/2010/R2010.stl
5.10 x 2.60 x 0.5
