sparkfun/3D_Models/production_parts/passive/resistors/ALPS_POT/ALPS_POT.stl

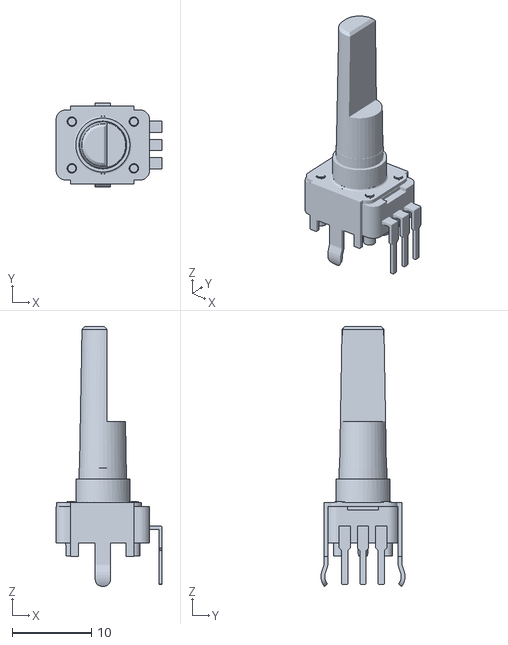
[picture p316: CAD file, 2017-06-15]
production_parts/passive/resistors/ALPS_POT/ALPS_POT.stl
13.4 x 10.6 x 32.9
