sparkfun/3D_Models/production_parts/passive/resistors/TRIMPOT-3MM/TRIMPOT-3MM.stl

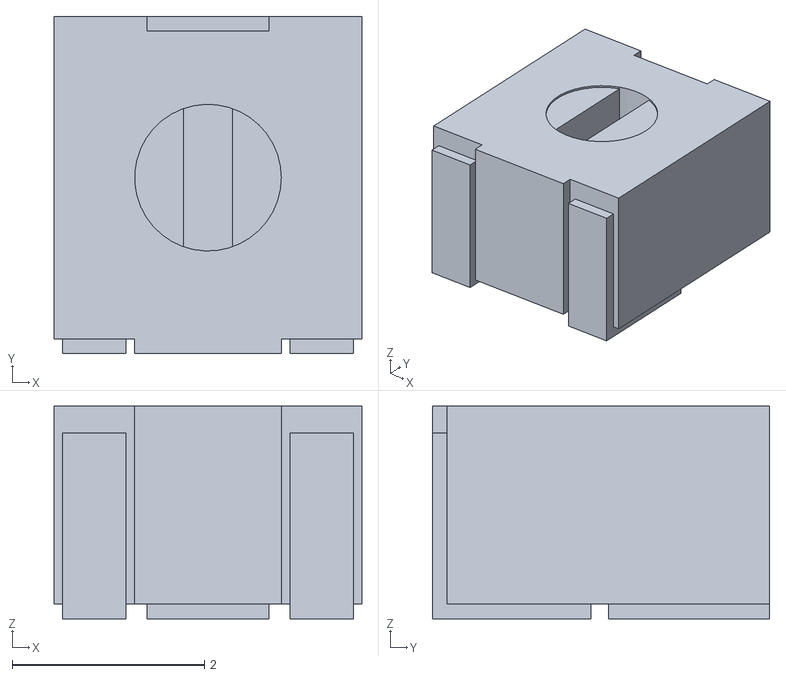
[picture p317: CAD file, 2017-06-15]
production_parts/passive/resistors/TRIMPOT-3MM/TRIMPOT-3MM.stl
3.20 x 3.51 x 2.21
