sparkfun/3D_Models/production_parts/passive/resistors/trimpots/TRIMPOT-3MM/step/TRIMPOT-3MM.STEP

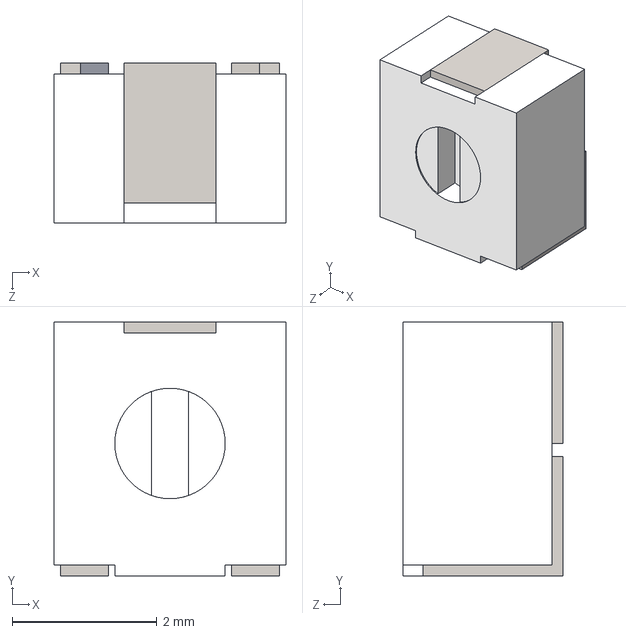
[picture p318: CAD file, 2016-02-01]
production_parts/passive/resistors/trimpots/TRIMPOT-3MM/step/TRIMPOT-3MM.STEP
3.20 x 3.51 x 2.21 mm
