sparkfun/3D_Models/production_parts/passive/resistors/trimpots/trimpot_5mm/step/TRIMPOT_5MM.STEP

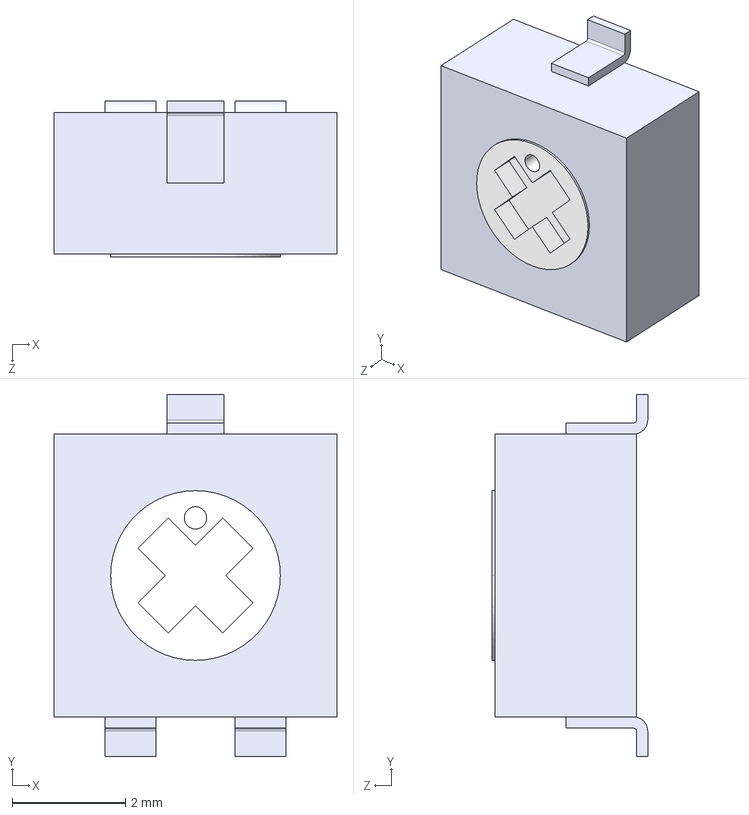
[picture p319: CAD file, 2015-03-31]
production_parts/passive/resistors/trimpots/trimpot_5mm/step/TRIMPOT_5MM.STEP
5.00 x 6.40 x 2.75 mm
