sparkfun/3D_Models/production_parts/passive/resonator/CRYSTAL-32KHZ-SMD/step/CRYSTAL-32KHZ-SMD.STEP

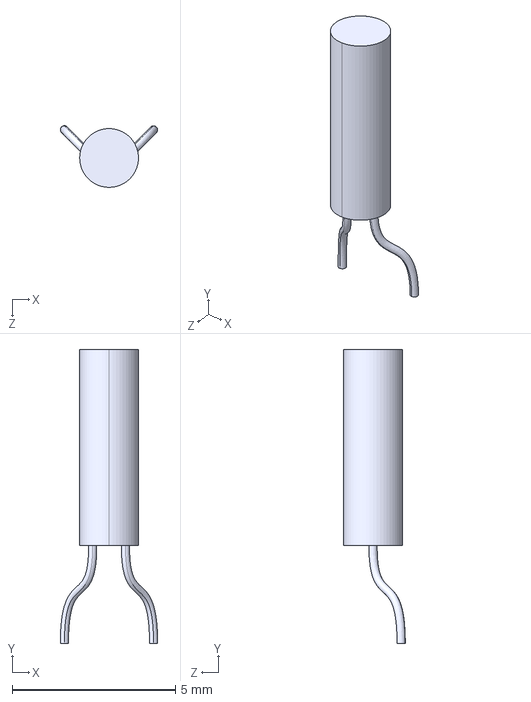
[picture p320: CAD file, 2015-08-19]
production_parts/passive/resonator/CRYSTAL-32KHZ-SMD/step/CRYSTAL-32KHZ-SMD.STEP
2.98 x 9.00 x 1.89 mm
