sparkfun/3D_Models/production_parts/passive/resonator/CRYSTAL-OSC-SMD-5X3_2/source_solidworks/CRYSTAL-OSC-SMD-5X3_2.SLDPRT

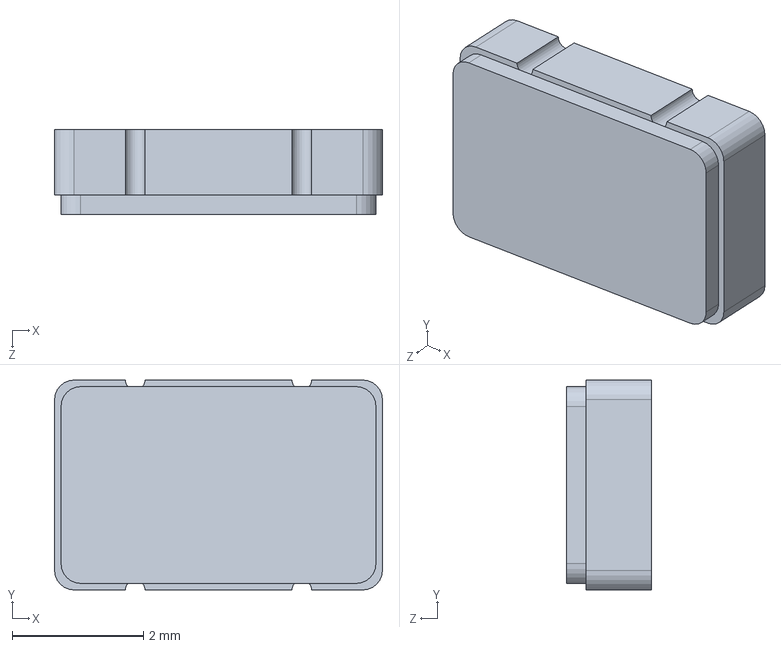
[picture p321: CAD file, 2015-04-03]
production_parts/passive/resonator/CRYSTAL-OSC-SMD-5X3_2/source_solidworks/CRYSTAL-OSC-SMD-5X3_2.SLDPRT
5.00 x 3.20 x 1.30 mm
