sparkfun/3D_Models/production_parts/passive/resonator/CRYSTAL-SMD-2_0X1_6MM/source_solidworks/CRYSTAL-SMD-2_0X1_6MM.SLDPRT

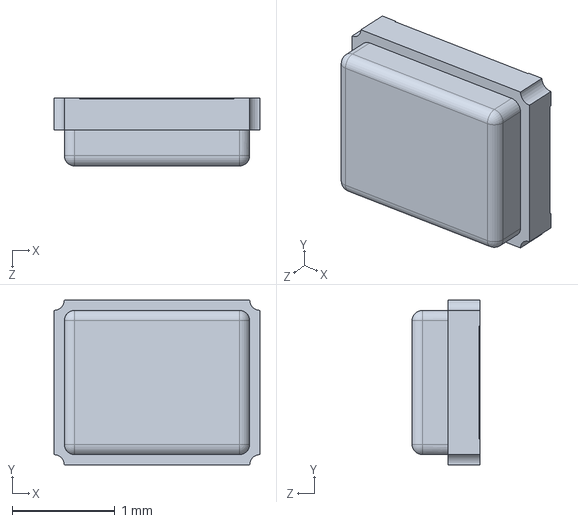
[picture p322: CAD file, 2016-11-22]
production_parts/passive/resonator/CRYSTAL-SMD-2_0X1_6MM/source_solidworks/CRYSTAL-SMD-2_0X1_6MM.SLDPRT
2.00 x 1.60 x 0.66 mm
