sparkfun/3D_Models/production_parts/passive/resonator/CRYSTAL-SMD-3_2X1_5MM/step/CRYSTAL-SMD-3_2X1_5MM.STEP

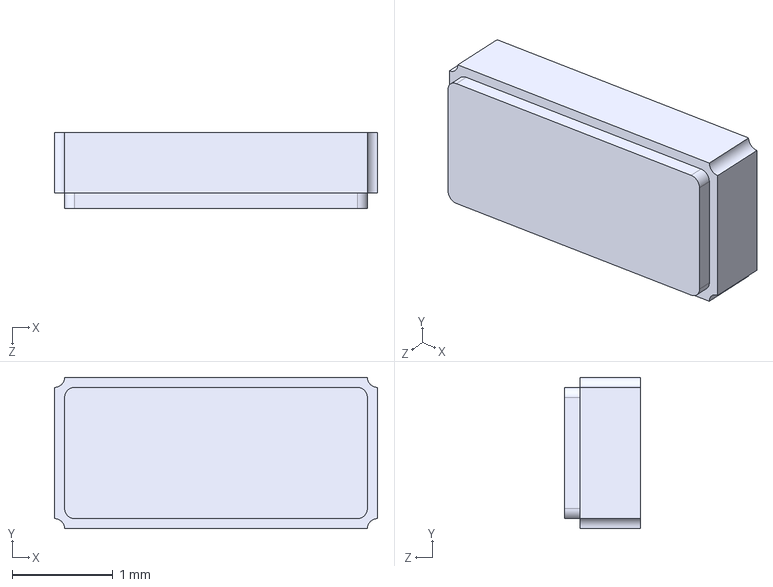
[picture p323: CAD file, 2016-01-20]
production_parts/passive/resonator/CRYSTAL-SMD-3_2X1_5MM/step/CRYSTAL-SMD-3_2X1_5MM.STEP
3.20 x 1.50 x 0.75 mm
