sparkfun/3D_Models/production_parts/passive/resonator/CRYSTAL-SMD-3_2X2_5/step/CRYSTAL-SMD-3_2X2_5.STEP

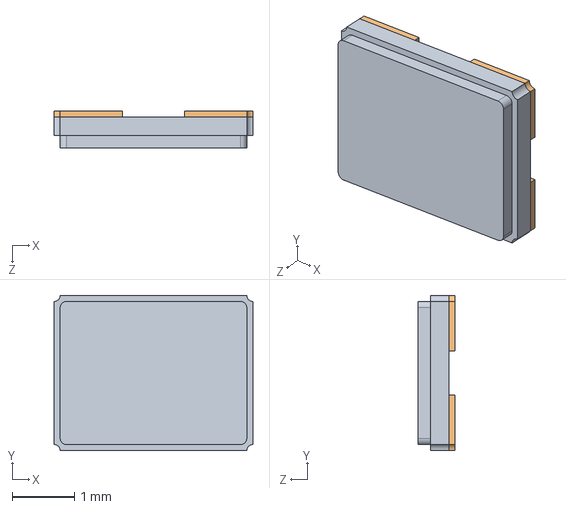
[picture p324: CAD file, 2016-01-20]
production_parts/passive/resonator/CRYSTAL-SMD-3_2X2_5/step/CRYSTAL-SMD-3_2X2_5.STEP
3.20 x 2.50 x 0.6 mm
