sparkfun/3D_Models/production_parts/passive/resonator/CRYSTAL-SMD-5X3.stl

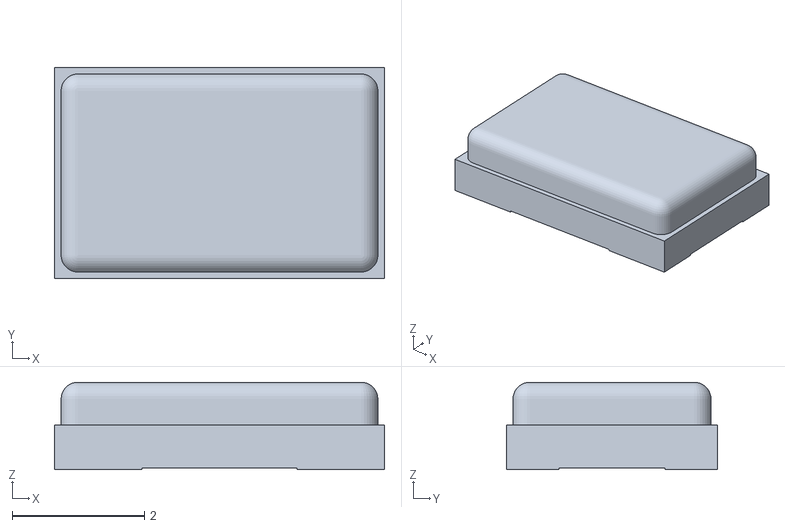
[picture p325: CAD file, 2017-06-15]
production_parts/passive/resonator/CRYSTAL-SMD-5X3.stl
5.00 x 3.20 x 1.33
