sparkfun/3D_Models/production_parts/passive/resonator/RESONATOR-SMD/source_solidworks/RESONATOR_SMD.SLDPRT

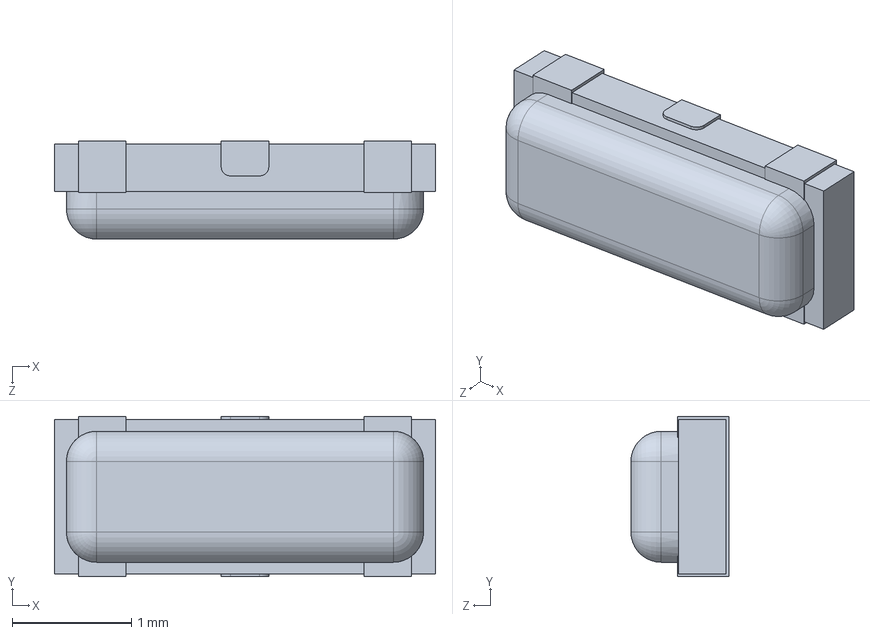
[picture p326: CAD file, 2015-01-21]
production_parts/passive/resonator/RESONATOR-SMD/source_solidworks/RESONATOR_SMD.SLDPRT
3.20 x 1.35 x 0.825 mm
