sparkfun/3D_Models/(list of files, cad)

Other CAD files:
production_parts/semiconductors/IC_SMD/WSON/WSON-8/source_solidworks/WSON-8-PAD.sldasm
products/13024/stl/Intel_Edison_(assembly)_-_Intel_Edison_(assembled_antenna_connector)-1_Intel_Edison_(antenna_connector_3)-1.STL
products/13024/stl/Intel_Edison_(assembly)_-_Intel_Edison_(assembled_antenna_connector)-1_Intel_Edison_(antenna_connector_4)-1.STL
products/13024/stl/Intel_Edison_(assembly)_-_Intel_Edison_(assembled_hirose_connector)-1_Intel_Edison_(Hirose_connector)-1.STL
production_parts/connectors/coin_cell/BATTCON_20MM_4LEGS/iges/BATTCON_20MM_4LEGS.IGS
production_parts/connectors/headers/1X08_PTH/step/1X08_PTH.STEP
production_parts/connectors/headers/1X10_PTH/step/1X10_PTH.STEP
production_parts/connectors/headers/ID-12_SMD/1X08_PTH/step/1X08_PTH.STEP
production_parts/connectors/headers/ID-12_SMD/1X10_PTH/step/1X10_PTH.STEP
production_parts/connectors/micro_sd/MICRO-SD-SOCKET-PP.stl
production_parts/connectors/Power_Jack/stl/POWER_JACK_PTH_LOCK.stl
production_parts/connectors/RJ11/stl/RJ11.stl
production_parts/connectors/sim/SIMHOLDER/stl/SIMHOLDER2.stl
production_parts/modules/ELECTRIC_IMP_IMP002/ELECTRIC_IMP_IMP002.SLDPRT
production_parts/opto/LED_BAR_SMD/iges/LED_BAR_SMD.IGS
production_parts/passive/polyfuse/ptc-1206/stl/PTC-1206-WIDE.stl
production_parts/passive/resistors/0402/C0402.stl
production_parts/passive/resistors/ALPS_POT/ALPS_POT/ALPS_POT.SLDPRT
production_parts/passive/resistors/trimpots/trimpot_nice/step/TRIMPOT-3MM-2.STEP
production_parts/passive/resistors/trimpots/trimpot_nice/trimpot_nice/step/TRIMPOT-3MM-2.STEP
Products/Dev Tools/pcDuino - DEV-11712/pcDuino - DEV-11712.stl
production_parts/antennas/ANTENNA-CHIP5/skp/ANTENNA-CHIP5.skp
production_parts/antennas/ANTENNA-CHIP5/stl/ANTENNA-CHIP5.STL
production_parts/audio/BUZZER-CCV.skp
production_parts/audio/MIC-9_7MM.skp
production_parts/audio/MIC-9_7MM.stl
production_parts/audio/MIC_ELECTRET_SMD.skp
production_parts/audio/MIC_ELECTRET_SMD.stl
production_parts/connectors/DB9/skp/DB9.skp
production_parts/connectors/ID-12_SMD/stl/ID-12_1X05.stl
production_parts/connectors/ID-12_SMD/stl/ID-12_SMD.stl
production_parts/connectors/JST/JST-2-SMD/MICRO-SD-SOCKET-PP.skp
production_parts/connectors/JST/JST-2-SMD/MICROSD_1_1.skp
production_parts/connectors/JST/JST-2-SMD/MICROSD_1_1.stl
production_parts/connectors/JST/JST_2/JST-2-PTH/skp/JST-2-PTH.skp
production_parts/connectors/JST/JST_2/JST-2-PTH/stl/JST-2-PTH.STL
production_parts/connectors/JST/JST_2/JST-2-SMD/skp/JST-2-SMD.skp
production_parts/connectors/JST/JST_2/JST-2-SMD/skp/S2B-PH.skp
production_parts/connectors/JST/JST_2/JST-2-SMD/stl/JST-2-SMD.STL
production_parts/connectors/JST/JST_3/JST-3-PTH-VERT/iges/JST-3-PTH-VERT.IGS
production_parts/connectors/JST/JST_3/JST-3-PTH-VERT/skp/JST-3-PTH-VERT.skp
production_parts/connectors/JST/JST_3/JST-3-PTH-VERT/stl/JST-3-PTH-VERT.STL
production_parts/connectors/JST/JST_4/JST-4-PTH-VERT/iges/JST-4-PTH-VERT.IGS
production_parts/connectors/JST/JST_4/JST-4-PTH-VERT/skp/JST-4-PTH-VERT.skp
production_parts/connectors/JST/JST_4/JST-4-PTH-VERT/stl/JST-4-PTH-VERT.STL
production_parts/connectors/Power_Jack/POWER_JACK_SMD.stl
production_parts/connectors/Power_Jack/POWER_JACK_SMD_OVERPASTE_REDBOARD_0603.skp
production_parts/connectors/Power_Jack/POWER_JACK_SMD_OVERPASTE_REDBOARD_0603.stl
production_parts/connectors/Power_Jack/POWER_JACK_SMD_OVERPASTE_TOE.skp
production_parts/connectors/Power_Jack/iges/POWER_JACK_PTH.IGS
production_parts/connectors/Power_Jack/skp/POWER-BARRELJACK-PTH-LOCK-FIXED.skp
production_parts/connectors/Power_Jack/skp/POWER_JACK_PTH.skp
production_parts/connectors/Power_Jack/source_solidworks/POWER_JACK_PTH.SLDPRT
production_parts/connectors/Power_Jack/stl/POWER-BARRELJACK-PTH-LOCK-FIXED.stl
production_parts/connectors/Power_Jack/stl/POWER_JACK_PTH.STL
production_parts/connectors/RJ11/iges/RJ11-6.IGS
production_parts/connectors/RJ11/skp/RJ11.skp
production_parts/connectors/RJ11/source_solidworks/RJ11-6.SLDPRT
production_parts/connectors/RJ11/stl/RJ11-6.STL
production_parts/connectors/audio/AUDIO-JACK-_25-INCH-HORIZ-PTH/iges/AUDIO-JACK-_25-INCH-HORIZ-PTH.IGS
production_parts/connectors/audio/AUDIO-JACK-_25-INCH-HORIZ-PTH/skp/AUDIO-JACK-_25-INCH-HORIZ-PTH.skp
production_parts/connectors/audio/AUDIO-JACK-_25-INCH-HORIZ-PTH/source_solidworks/AUDIO-JACK-_25-INCH-HORIZ-PTH.SLDPRT
production_parts/connectors/audio/AUDIO-JACK-_25-INCH-HORIZ-PTH/stl/AUDIO-JACK-_25-INCH-HORIZ-PTH.STL
production_parts/connectors/audio/AUDIO_JACK_3_5MM_TRRS_SMD_RA/skp/AUDIO-JACK.skp
production_parts/connectors/audio/AUDIO_JACK_3_5MM_TRRS_SMD_RA/skp/AUDIO_JACK_3_5MM_TRRS_SMD_RA.skp
production_parts/connectors/audio/AUDIO_JACK_3_5MM_TRRS_SMD_RA/stl/AUDIO_JACK_3_5MM_TRRS_SMD_RA.STL
production_parts/connectors/coin_cell/BATTCON_12MM/geometry_edit_blender/BATTCON_12MM.blend
production_parts/connectors/coin_cell/BATTCON_12MM/iges/BATTCON_12MM.IGS
production_parts/connectors/coin_cell/BATTCON_12MM/skp/BATTCON_12MM_PTH.skp
production_parts/connectors/coin_cell/BATTCON_12MM/source_solidworks/BATTCON_12MM.SLDPRT
production_parts/connectors/coin_cell/BATTCON_12MM/stl/BATTCON_12MM.STL
production_parts/connectors/coin_cell/BATTCON_20MM_4LEGS/skp/BATTCON_20MM_4LEGS.skp
production_parts/connectors/coin_cell/BATTCON_20MM_4LEGS/stl/BATTCON_20MM_4LEGS.STL
production_parts/connectors/headers/1X05_2_54MM.SLDPRT
production_parts/connectors/headers/1X05_SMD.skp
production_parts/connectors/headers/1X06/1X06_SMD_STRAIGHT_COMBO.skp
production_parts/connectors/headers/1X06_PTH/iges/1X06-SIP_LOCK.IGS
production_parts/connectors/headers/1X06_PTH/skp/1X06-SIP_LOCK.skp
production_parts/connectors/headers/1X06_PTH/source_solidworks/1X06-SIP_LOCK.SLDPRT
production_parts/connectors/headers/1X06_PTH/stl/1X06-SIP_LOCK.STL
production_parts/connectors/headers/1X07_2_54MM.SLDPRT
production_parts/connectors/headers/1X07_SMD.skp
production_parts/connectors/headers/1X08/1X08_SMD_COMBINED.skp
production_parts/connectors/headers/1X08_PTH/iges/1X08_PTH.IGS
production_parts/connectors/headers/1X08_PTH/skp/1X08_LOCK.skp
production_parts/connectors/headers/1X08_PTH/source_solidworks/1X08_PTH.SLDPRT
production_parts/connectors/headers/1X08_PTH/stl/1X08_PTH.STL
production_parts/connectors/headers/1X10_PTH/iges/1X10_PTH.IGS
production_parts/connectors/headers/1X10_PTH/skp/1X10_LOCK.skp
production_parts/connectors/headers/1X10_PTH/source_solidworks/1X10_PTH.SLDPRT
production_parts/connectors/headers/1X10_PTH/stl/1X10_PTH.STL
production_parts/connectors/headers/1X10_SMD_COMBINED/1X10_SMD_COMBINED.skp
production_parts/connectors/headers/1X10_SMD_COMBINED/source_solidworks/11544.SLDPRT
production_parts/connectors/headers/1X12_PTH/iges/SPARK_PHOTON_TEMPLATE_WIDE_LOCKING.IGS
production_parts/connectors/headers/1X12_PTH/skp/SPARK_PHOTON_TEMPLATE_WIDE_LOCKING.skp
production_parts/connectors/headers/1X12_PTH/source_solidworks/SPARK_PHOTON_TEMPLATE_WIDE_LOCKING.SLDPRT
production_parts/connectors/headers/1X12_PTH/stl/SPARK_PHOTON_TEMPLATE_WIDE_LOCKING.STL
production_parts/connectors/headers/1X12_SMD_COMBINED/iges/13344.IGS
production_parts/connectors/headers/1X12_SMD_COMBINED/skp/1X12_SMD_COMBINED.skp
production_parts/connectors/headers/1X12_SMD_COMBINED/source_solidworks/13344.SLDPRT
production_parts/connectors/headers/1X12_SMD_COMBINED/step/13344.STEP
production_parts/connectors/headers/1X12_STACKABLE/iges/1X12_STACKABLE.IGS
production_parts/connectors/headers/1X12_STACKABLE/skp/1X12_STACKABLE.skp
production_parts/connectors/headers/1X12_STACKABLE/source_solidworks/1X12_STACKABLE.SLDPRT
production_parts/connectors/headers/1X12_STACKABLE/stl/1X12_STACKABLE.STL
production_parts/connectors/headers/1X6/1x6.STL
production_parts/connectors/headers/2X06_PTH/iges/2X06_PTH.IGS
production_parts/connectors/headers/2X06_PTH/skp/2X6.skp
production_parts/connectors/headers/2X06_PTH/source_solidworks/2X06_PTH.SLDPRT
production_parts/connectors/headers/2X06_PTH/stl/2X06_PTH.STL
production_parts/connectors/headers/2X3/2X3_SMT_POSTS/2X3_SMT_POSTS.SKP
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
