sparkfun/3D_Models/products/12125/images/assembled.jpg

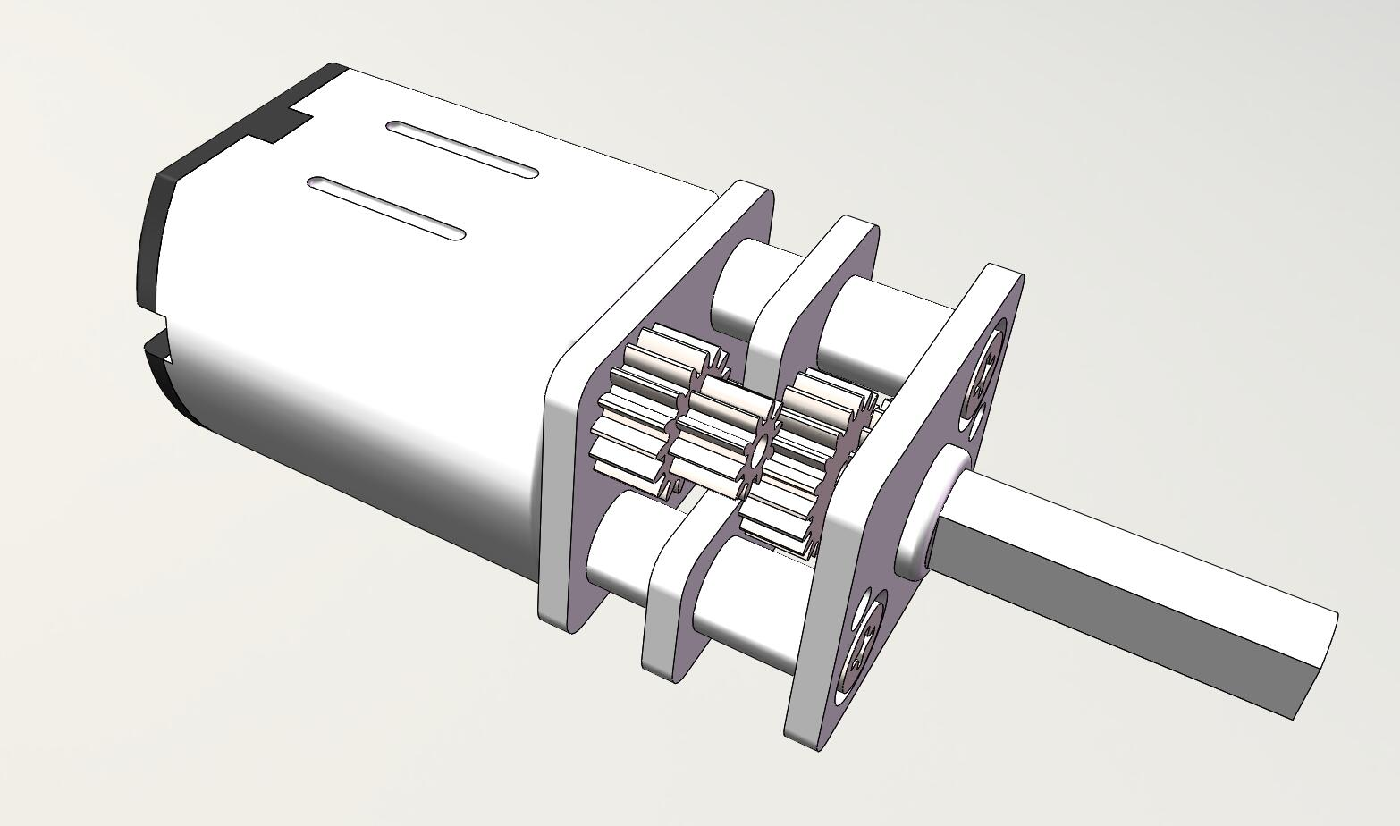
products/12125/images/assembled.jpg
