sparkfun/3D_Models/products/12702/display/solderable_breadboard_mini_bottom_board.png

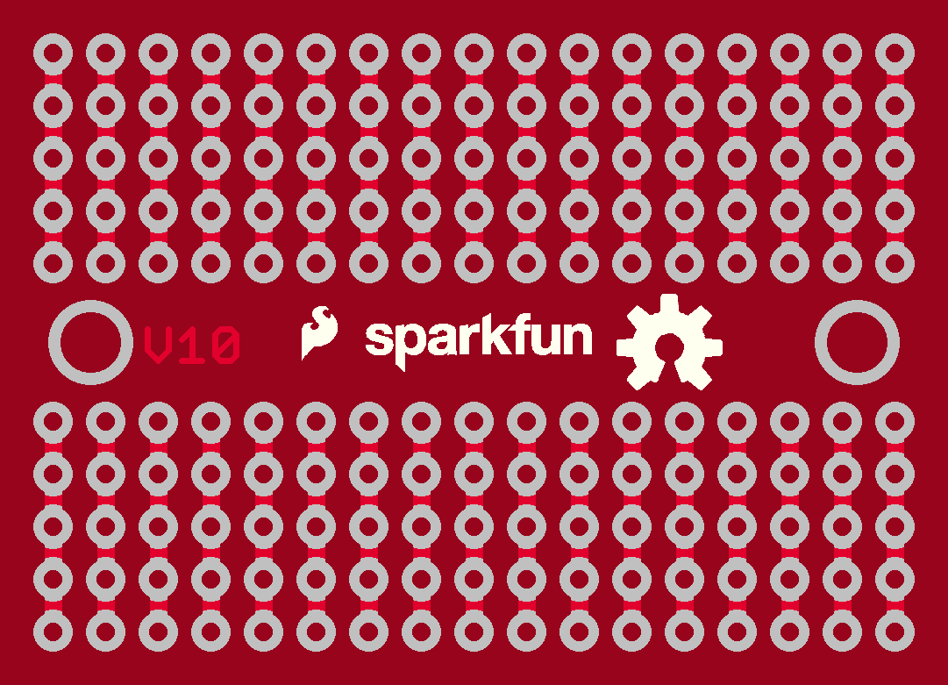
products/12702/display/solderable_breadboard_mini_bottom_board.png
