sparkfun/3D_Models/(threads)

Thread 147 (2016-04-26):

Sketchup is only accepting the files with extension ".skp" and NOT ".SKP"

vineeshvs, 2016-04-26:
I think there is an issue as mentioned in the title. Please rename all ".SKP" extensions with ".skp" if that's the case.

The models are excellent. Really helped us

ToniCorinne, 2016-04-26:
Sorry to hear you're having issues with the models! We'll take a look and see what's going on.

elizabethsrobert, 2016-05-11:
Thank you for the heads up. All files that were initially ".SKP" are now ".skp." If you have any further issues just let me know. 😄

Closed 2016-05-11.

Thread 178 (2016-11-01):

Request for export of TQFP32-08 model files

follower, 2016-11-01:
The `TQFP32-08` variant (used by e.g. the RedStick) doesn't have exported models in the repository--only the source file [`TQFP32-08.skp`](https://github.com/sparkfun/3D_Models/blob/master/production_parts/semiconductors/IC_SMD/TQFP/TQFP32-08.skp) is present.

Could someone please export the models and add them to the repository (like the [`TQFP-48`]( https://github.com/sparkfun/3D_Models/tree/master/production_parts/semiconductors/IC_SMD/TQFP/TQFP-48) part has). My specific interest is in the `.stl` format.

Thanks.

follower, 2016-11-01:
FWIW it seems this model is possibly equivalent: https://github.com/sparkfun/3D_Models/blob/master/products/9261/stl/9261.STL ([via](https://www.sparkfun.com/products/retired/9261))

follower, 2016-11-02:
Further investigation into the repository content suggests that there are multiple models that are only present in form of the SketchUp file. Are there any plans to export a consistent set of formats for each model?

elizabethsrobert, 2016-11-03:
Thank you so much for your message! All of our models in the `Products` folder will typically have a consistent set of formats. A good example would be this:

[Product 9393](https://github.com/sparkfun/3D_Models/tree/master/products/9393)

Individual components used to build up those products are housed in the `Production_Parts` folder and will normally only have a .SKP file. Where I'd say 95% of our product models are made from scratch, through a combination of Solidworks, SketchUp, and Blender, there are some cases where we use preexisting models. That tends to be more of the case in regards to the `Production_Parts` folder since it is a collection of individual components solely used to populate our larger models found in the `Products` folder. When populating our 3D models for our SparkFun specific boards, the only requirement is to have the .SKP file which is why you'll rarely find other formats in that folder unless they've been made from scratch.

That being said, I can definitely talk to some people here at SparkFun to see if they would be on board with supplying other formats within our `Production_Parts` folder. In the meantime though, I'll be more than happy to add the `TQFP32-08.stl` format for you. I'll comment back when it is complete.

elizabethsrobert, 2016-11-09:
The `TQFP32-08.stl` you requested can now be located in the following folder: [TQFP32-08](https://github.com/sparkfun/3D_Models/tree/master/production_parts/semiconductors/IC_SMD/TQFP/TQFP32-08).

It seems, at this time, we will not be adding other formats to our `Production_Parts` folder as it is purely utilized to aide in building our 3D models for the storefront. That being said, we will always supply multiple formats to our `Products` folder, and any requests we get to supply additional formats for components in the `Production_Parts` folder we will have no problem fulfilling.

If you have any further questions please let me know. Thank you for your inquiry!

follower, 2017-01-19:
Thanks for your detailed reply and exporting the TQFP part for me, I appreciate you taking the time to do so (even though it's taken a long time to get back to you!).

For a client project (https://github.com/Omniblox/Eagle-Loader) I wrote a script to automate generation of  `.stl` files from the SparkFun SketchUp models: <https://github.com/Omniblox/pcb-component-models/blob/master/tools/generate_missing_stl.rb>

These generated models are currently in my fork of the `3D_Models` repo here: <https://github.com/follower/3D_Models/tree/batch-stl-export>. (And in a standalone model "library" used by `Eagle-Loader` here: <https://github.com/Omniblox/pcb-component-models>.)

Would SparkFun be interested in a PR with the additional exported models?

Thanks again for your assistance and providing the models.

zinefer, 2017-01-19:
We'd be happy to accept your PR.

Closed 2016-11-09.

Thread 257 (2017-10-13):

.STL build error

cmfrancis, 2017-10-13:
Customer reports the .STL had a build error. Can someone check on this and repair if needed?

ToniCorinne, 2017-10-16:
@cmfrancis What .stl? We need more information to actually verify this is an issue.

cmfrancis, 2017-10-18:
Sorry about that Toni. It's for product 12959.

https://github.com/sparkfun/3D_Models/blob/master/products/12959/stl/SparkFun_MOSFET_Power_Control_Kit.stl

santaimpersonator, 2019-03-06:
The file seems fine now. Closing Issue.

Closed 2019-03-06.

Thread 259 (2020-01-10):

Product #246 not found

ghost, 2020-01-10:
Product #246 isn't found - I was just wandering and found the fact that the product had a 3d model.

santaimpersonator, 2020-10-08:
I don't understand the issue you are trying to specify. Could you rephrase it?

bboyho, 2023-10-26:
It looks like Elizabeth made changes to [13656](https://github.com/sparkfun/3D_Models/tree/master/products/13656) and pushed it to the main repo. That is a stepper motor.

I'm not sure if the customer was confused on the branch name or maybe they were looking for something else? I tried looking for a model for [product "246"](https://www.sparkfun.com/products/246) and that appears to be a PTH component (specifically the "Optical Detector / Phototransistor - QRD1114"). The product page had the 3D model icon was turned on but there wasn't one available in this repo. I turned it back off. I also accidentally typed 258 and which also had the 3D model icon turned on for the  "Basic 20x4 Character LCD - Black on Green 5V". However, this repo also did not have a model available for the part so I turned it off.

Since the GitHub user account appears to deleted, I'm going to close this issue. ¯\_(ツ)_/¯

Closed 2023-10-26.

Thread 261 (2020-11-10):

How to work with eagleUp.json files

geauser, 2020-11-10:
I want to retrieve the 3D model for the [Sunny Buddy](https://www.sparkfun.com/products/12885) I recently bought but in the corresponding [directory](https://github.com/sparkfun/3D_Models/tree/master/products/12885) there is only `eagleUp.json`.

I've looked up EagleUp but I can't make out how to use this `eagleUp.json` file. Trying to load the `.brd` file into Fusion 360 and generating a 3D model of the board also gives me weird results:

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

Am I missing something?
