sparkfun/3D_Models/(commit log)

2013-03-30 Added two models!
    COM-11621 and COM-11620
    [Slide Pot - Medium (10k Linear Taper) COM-11621.skp, Slide Pot - Small (10k Linear Taper) COM-11620.skp]
2013-03-30 Another Model Added
    PRT-11662
    [Breadboard - Mini Modular (Black) PRT-11662.skp]
2013-03-30 More Models
    PRT-08483 and PRT-08484
    [Polymer Lithium Ion Battery - 6Ah PRT-08484.skp]
2013-03-30 Moar Models
    COM-10931
    [7-Segment Display - 4-Digit (White) COM-10931.skp]
2013-03-30 New Battery Model
    PRT-08483
    [Polymer Lithium Ion Battery - 2000mAh PRT-08483.skp]
2013-04-10 Testing .stl viewer
    Model of COM-11621 exported using sketchup-stl plugin. Testing new stl
    view feature.
    [Slide Pot - Medium (10k Linear Taper) COM-11621.stl]
2013-04-10 Testing .stl viewer again
    Looks like it matters whether the inside of the model is painted.
    [Slide Pot - Medium (10k Linear Taper) COM-11621untitled.stl]
2013-04-10 Cleaning up the repo
    I used this as my working directory and introduced a bunch of working
    files. Getting rid of those. STL viewer looks freakin' rad.
    [Slide Pot - Medium (10k Linear Taper) COM-11621.stl]
2013-04-10 Paul's STL file for pcDuino
    Let's see how that looks in the viewer...
    [pcduino_resized.stl]
2013-04-10 Adding OpenSegment Serial Display - 20mm COM11644
    [OpenSegment Serial Display (20mm) COM-11644-ascii.stl]
2013-04-10 Updated scale, updated name
    [OpenSegment Serial Display (20mm) COM-11644-ascii.stl, pcDuino - DEV-11712.stl]
2013-04-12 Added new models.
    Breadboard, Project Case, Arduino/Breadboard Holder
    [Arduino and Breadboard Holder - DEV-11235.stl, Breadboard - Translucent Self-Adhesive - PRT-09567.stl, SparkFun Project Case - Bottom - WIG-08601.stl, SparkFun Project Case - Insert - WIG-08601.stl, SparkFun Project Case - Top - WIG-08601.stl]
2013-04-15 2 breakout boards and the redboard
    [9 Degrees of Freedom - MPU-9150 Breakout-SKU-11486.stl, MPL115A1 Barometric Pressure Sensor Breakout-SKU-09721.stl, RedBoard - Programmed with Arduino-SKU-11575.stl]
2013-04-17 Add Venus GPS and antenna.
    [GPS-00177.SLDPRT, GPS-00177.stl, GPS-10921.SLDPRT, GPS-10921.stl]
2013-04-17 Corrected file names on GPS models.
    [Antenna GPS Embedded SMA GPS-00177.SLDPRT, Antenna GPS Embedded SMA GPS-00177.stl, Venus GPS with SMA Connector GPS-10921.SLDPRT, Venus GPS with SMA Connector GPS-10921.stl]
2013-04-18 Added subfolders for items. Better organization.
    [7-Segment Display - 4-Digit (White) COM-10931.skp, 9 Degrees of Freedom - MPU-9150 Breakout-SKU-11486.stl, Antenna GPS Embedded SMA GPS-00177.SLDPRT, Antenna GPS Embedded SMA GPS-00177.stl, Arduino and Breadboard Holder - DEV-11235.stl, Breadboard - Mini Modular (Black) PRT-11662.skp, Breadboard - Translucent Self-Adhesive - PRT-09567.stl, MPL115A1 Barometric Pressure Sensor Breakout-SKU-09721.stl]
2013-04-18 Adding file types
    [pcDuino-DEV11712.stp]
2013-04-19 Verified, updated scale
    [7-Segment Display - LED (Blue) COM-09191.stl]
2013-04-19 makey makey
    [Makey Makey - WIG-11511.igs, Makey Makey - WIG-11511.stl, Makey Makey - WIG-11511.stp]
2013-04-19 Initial set of eagleUp models
    This is an initial (and very incomplete) set of eagleUp-compatible
    models for Sparkfun's standard footprint names. Note that for the moment
    both 0402 parts and 0603 parts are actually 0603 size.
    [0402-CAP.skp, 0402-RES.skp, 0603-CAP.skp, 0603-RES.skp, 0805.skp, SOT23-5.skp, TQFP32-08.skp]
2013-04-20 Added SMD Button and USB Mini-B Connector
    + COM-08720 (Mini Push Button Switch - SMD) to category "Components"
    + PRT-00587 (USB Mini-B SMD Connector) to category "Prototyping"
    There is a ton of detail in the button, but the USB Connector is very
    basic.
    [Mini Push Button Switch - SMD COM-08720.skp, USB Mini-B SMD Connector PRT-00587.skp]
2013-04-21 7 Segment 4 Digit Display from Adafruit part no. 1266
    [7-Segment Display - 4-Digit-Adafruit-1266.skp]
2013-04-21 Added JST Connector and 603 LED
    + PRT-08612 (JST Right Angle Connector - White)
    + 603 LED to new folder, "Created Models" in folder "Bare Components"
    [603 LED.skp, JST Right Angle Connector - White.skp]
2013-04-21 Fixed Height Of USB Connector
    I had mentioned in my pull request that the USB Connector had the wrong
    height, this is the updated one.
    [USB Mini-B SMD Connector PRT-00587.skp]
2013-04-21 Added several .5mm QFP footprints, a 1206 LED, and a .5mm QFN footprint.
    [HVQFN32-05.skp, LED-1206.skp, LQFP48-05.skp, LQFP64-05.skp, LQFP80-05.skp]
2013-04-22 Adding IOIO, Increased resolution of pcDuino
    [IOIO-OTG - DEV-11343.igs, IOIO-OTG - DEV-11343.stl, IOIO-OTG - DEV-11343.stp]
2013-04-22 added COM-11151
    [Stomp Switch - DPDT - COM-11151.igs, Stomp Switch - DPDT - COM-11151.stl, Stomp Switch - DPDT - COM-11151.stp]
2013-04-22 added COM-10438
    [Thermal Printer - COM-10438.igs, Thermal Printer - COM-10438.stl, Thermal Printer - COM-10438.stp]
2013-04-22 added prt-00552
    [Battery Holder - 4xAA Square - PRT-00552.igs]
2013-04-22 Added BOB-09966 & PRT-10401
    + LiPo Charger Basic - Mini-USB PRT-10401 to category "Prototyping"
    + Breakout Board for USB Mini-B BOB-09966 to category "Breakout Boards"
    [Breakout Board for USB Mini-B BOB-09966.skp, LiPo Charger Basic - Mini-USB PRT-10401.skp]
2013-04-22 Adding lower res STL files
    High res wont open in github viewer.
    [_Battery Holder - 4xAA Square - PRT-00552 - LowRes - GitHubViewer.stl, _IOIO-OTG - DEV-11343 - LowRes - GitHubViewer.stl, _pcDuino-DEV11712 - LowRes - GitHubViewer.stl]
2013-04-22 Addition of Xbee Series 2 Chip, PCB, U.FL and Wire Antennae.
    [XBee 2mW Chip Antenna - Series 2 WRL-10415.skp, XBee 2mW PCB Antenna - Series 2 WRL-11217.skp, XBee 2mW U.FL Connection - Series 2 WRL-10417.skp, XBee 2mW Wire Antenna - Series 2 WRL-10414.skp]
2013-04-23 adding sen-08501
    [Ultrasonic Range Finder - Maxbotix LV-EZ3 - SEN-08501 - LowRes - GitHubViewer.stl, Ultrasonic Range Finder - Maxbotix LV-EZ3 - SEN-08501.igs, Ultrasonic Range Finder - Maxbotix LV-EZ3 - SEN-08501.stl, Ultrasonic Range Finder - Maxbotix LV-EZ3 - SEN-08501.stp]
2013-04-23 adding WRL-10268
    [Bluetooth Modem - BlueSMiRF Gold - WRL-10268 - LowRes - GitHubViewer.stl, Bluetooth Modem - BlueSMiRF Gold - WRL-10268.igs, Bluetooth Modem - BlueSMiRF Gold - WRL-10268.stl, Bluetooth Modem - BlueSMiRF Gold - WRL-10268.stp]
2013-04-23 Accelerometer, Gyroscope, and Rocker Switch
    + Rocker Switch - Medium COM-10727 to category "Components"
    + Triple Axis Accelerometer Breakout - ADXL335 SEN-09269 to category
    "Sensors"
    + Triple-Axis Digital-Output Gyro ITG-3200 Breakout SEN-09801 to
    category "Sensors"
    Rocker Switch, Tryroscope, and Triccelerometer. What could go wrong?
    [Rocker Switch - Medium COM-10727.skp, Triple Axis Accelerometer Breakout - ADXL335 SEN-09269.skp, Triple-Axis Digital-Output Gyro ITG-3200 Breakout SEN-09801.skp]
2013-04-24 Re-Scaled COM-11621 to 1000x
    Also, made it a solid part, hopefully this solves the GitHub viewer
    weirdness.
    [Slide Pot - Medium (10k Linear Taper) COM-11621.skp, Slide Pot - Medium (10k Linear Taper) COM-11621.stl, Slide Pot - Medium (10k Linear Taper) COM-11621untitled.stl]
2013-04-24 COM-00094, DEV-11113, EIA3216 Cap
    + EIA3216 Capacitor to category "Created Models" in "Bare Components"
    + Crystal SMD 16MHz COM-00094 to category "Components"
    + Arduino Pro Mini 328 - 5V:16MHz DEV-11113 to category "Dev Tools"
    Made the capacitor for the Pro Mini, as well as the Oscillator, but
    found out the Pro Mini doesn't use that OSC, so put in a rect for the
    Resonator. The parts on the Pro Mini were put on in the locations that
    were specified in the EAGLE Files. It should be acurate to a 100th of
    a millimeter.
    [Arduino Pro Mini 328 - 5V:16MHz DEV-11113.skp, Crystal SMD 16MHz COM-00094.skp, EIA3216 Capacitor.skp]
2013-04-25 PDIP-8 Package
    + PDIP-8 to Bare Components/Created Models
    Drop in for any PDIP-8 on a PCB.
    [PDIP-8.skp]
2013-04-25 PDIP-14 Package + color fix on PDIP-8
    + PDIP-14 Package to Bare Components/Created Models
    Found out while making the 14-pin that I had missed a spot of color on
    the 8-pin. That has been fixed.
    [PDIP-14.skp, PDIP-8.skp]
2013-04-25 PDIP-20, PDIP-14 length fix
    + PDIP-20 to Bare Components/Created Models
    Found a wrong length in PDIP=14. Fixed.
    [PDIP-14.skp, PDIP-20.skp]
2013-04-25 PDIP-24 Package
    + PDIP-24 to Bare Components/Created Models.
    [PDIP-24.skp]
2013-04-25 Pulling back PDIPs. Size issues.
    Currently working to figure out why the datasheet is telling me that
    the pins are not on a .1" spacing. ;)
    [PDIP-14.skp, PDIP-20.skp, PDIP-24.skp, PDIP-8.skp]
2013-04-25 Fixed sizes for PDIPs, and added PDIP-28.
    These are in inches. Millimeters coming right up.
    [PDIP-14-Inches.skp, PDIP-20-Inches.skp, PDIP-24-Inches.skp, PDIP-28-Inches.skp, PDIP-8-Inches.skp]
2013-04-25 Trying a new stl export tool for SketchUp
    Current plug-in makes HUGE stl files. Need to simplify for the GitHub
    viewer.
    [Slide Pot - Medium (10k Linear Taper) COM-11621.stl]
2013-04-25 Millimeter versions.
    [PDIP-14.skp, PDIP-20.skp, PDIP-24.skp, PDIP-28.skp, PDIP-8.skp]
2013-04-25 Scaled COM-10931 to 1000x
    [7-Segment Display - 4-Digit (White) COM-10931.skp, 7-Segment Display - 4-Digit (White) COM-10931.stl]
2013-04-25 Rescaling Breadboard
    It came to my attention while making the "Virtual Breadboarding" image
    that the Breadboard in "Prototyping" (Mini Modular (Black) PRT-11662
    was still at 100x. I have increased the scale by 10x.
    [Breadboard - Mini Modular (Black) PRT-11662.skp, Breadboard - Mini Modular (Black) PRT-11662~.skp]
2013-04-25 Re-scaling models to 1000x
    COM-11620 & PRT-11662
    [Breadboard - Mini Modular (Black) PRT-11662.skp, Breadboard - Mini Modular (Black) PRT-11662.stl, Slide Pot - Small (10k Linear Taper) COM-11620.skp, Slide Pot - Small (10k Linear Taper) COM-11620.stl]
2013-04-25 Re-scaling models to 1000x
    PRT-08483 & PRT-08484
    [Polymer Lithium Ion Battery - 2000mAh PRT-08483.skp, Polymer Lithium Ion Battery - 2000mAh PRT-08483.stl, Polymer Lithium Ion Battery - 6Ah PRT-08484.skp, Polymer Lithium Ion Battery - 6Ah PRT-08484.stl]
2013-04-26 Smoothing STLs to SKPs
    Adding SketchUp versions of STL submissions
    [9 Degrees of Freedom - MPU-9150 Breakout-SKU-11486.skp, MPL115A1 Barometric Pressure Sensor Breakout-SKU-09721.skp]
2013-04-26 Fixing COM-10727 and PRT-00587.
    [Rocker Switch - Medium COM-10727.skp, USB Mini-B SMD Connector PRT-00587.skp]
2013-04-26 Goofy file structure stuff to resolve a merge err
    [9 Degrees of Freedom - MPU-9150 Breakout-SKU-11486.skp, 9 Degrees of Freedom - MPU-9150 Breakout-SKU-11486.stl, MPL115A1 Barometric Pressure Sensor Breakout-SKU-09721.skp, MPL115A1 Barometric Pressure Sensor Breakout-SKU-09721.stl]
2013-04-26 new models
    [9 Degrees of Freedom - MPU-9150 Breakout-SKU-11486.skp, 9 Degrees of Freedom - MPU-9150 Breakout-SKU-11486.stl, Arduino Fio DEV-10116.stl, Arduino Leonardo with Headers DEV-11286.stl, Arduino Mega 2560 R3 DEV-11061.stl, Arduino Pro 328 - 5V:16MHz DEV-10915.stl, Arduino Pro Mini 328 - DEV-11113.stl, Arduino UNO R3-SKU-11021.stl]
2013-04-26 Fixed those.
    [Breakout Board for USB Mini-B BOB-09966.skp, LiPo Charger Basic - Mini-USB PRT-10401.skp]
2013-04-27 Raspberry Pi GPIO Header 2x13
    [Raspberry Pi - GPIO Shrouded Header (2x13)-11490.skp]
2013-04-27 Resized part to x1000
    [Raspberry Pi - GPIO Shrouded Header (2x13)-11490.skp]
2013-04-28 Fixed missing color on bottom pins
    [Raspberry Pi - GPIO Shrouded Header (2x13)-11490.skp]
2013-05-06 Changing File Names
    Nick P thinks file names are screwing something up on PC.
    [Power Cell - LiPo Charger Booster PRT-11231.stl]
2013-05-06 File Name Stuff Again
    Forward Slashes may be a no-no
    [DC Barrel Power Jack Connector PRT-00119.stl]
2013-05-06 name changes
    [Arduino Pro 328 - 5V 16MHz DEV-10915.stl]
2013-05-06 New Battery Models
    Shoop De Whooooooooooooooooooooooooooooooo
    [Polymer Lithium Ion Battery - 1000mAh PRT-00339.skp, Polymer Lithium Ion Battery - 110mAh PRT-00731.skp, Polymer Lithium Ion Battery - 400mAh PRT-10718.skp, Polymer Lithium Ion Battery - 850mAh PRT-00341.skp]
2013-05-07 Adding Model
    7-Segment Display - LED (Red) COM-08546
    [7-Segment Display - LED (Red) COM-08546.skp]
2013-05-07 New Models
    Added 7-Segment Display - 20mm COM-11409 STL and SKP
    Added OpenSegment SKP
    [7-Segment Display - 20mm COM-11409.skp, 7-Segment Display - 20mm COM-11409.stl, OpenSegment Serial Display (20mm) COM-11644.stl, OpenSegment Serial Display - 20mm COM-11644.skp]
2013-05-07 Added Model
    Added 7-Segment Serial Display STL and SKP
    [7-Segment Serial Display COM-11441.skp, 7-Segment Serial Display COM-11441.stl]
2013-05-07 Added Model
    Basic 16x2 Character LCD
    [Basic 16x2 Character LCD 5V LCD-00255.skp, Basic 16x2 Character LCD 5V LCD-00255.stl]
2013-05-07 Added Model
    Basic 20x4 Character LCD 5V STL and SKP
    [Basic 20x4 Character LCD 5V LCD-00256.skp, Basic 20x4 Character LCD 5V LCD-00256.stl]
2013-05-09 Removing already created components
    [JST Right Angle Connector - White.skp, USB Mini-B SMD Connector PRT-00587.skp]
2013-05-09 Missed deleting Pro Mini
    [Arduino Pro Mini 328 - 5V:16MHz DEV-11113.skp]
2013-05-09 BJT Transistor
    + BJT Transistor to Bare Components/Created Models
    [BJT Transistor.skp]
2013-05-10 Screw for Screw Terminal that was also modeled
    + Subcategory "Hardware" in "Prototyping" that Screw used in Screw
    Terminal is in.
    + Screw Terminals 5mm Pitch (2-Pin)
    PRT-08432 to category "Prototyping"
    Will make screw terminals with more pins.
    [Screw Terminals 5mm Pitch (2-Pin) PRT-08432.skp, Screw in 3.5mm Screw Terminals.skp]
2013-05-10 Named Screw Terminal Wrong
    Actually made 3.5mm variant.
    [Screw Terminals 3.5mm Pitch (2-Pin) PRT-08084.skp, Screw Terminals 5mm Pitch (2-Pin) PRT-08432.skp]
2013-05-10 3-Pin Screw Terminal + added locking tabs to 2-Pin
    + Screw Terminals 3.5mm Pitch (3-Pin) PRT-08235 to category
    "Prototyping"
    * Locking tabs on Screw Terminals 3.5mm Pitch (2-Pin) PRT-08084
    [Screw Terminals 3.5mm Pitch (2-Pin) PRT-08084.skp, Screw Terminals 3.5mm Pitch (3-Pin) PRT-08235.skp]
2013-05-10 Added LED and "LEDs" subcategory in "Components"
    + LED - Basic Green 5mm COM-09592 to category "LEDs" which is also new.
    [LED - Basic Green 5mm COM-09592.skp]
2013-05-10 Added 3 other colors of LED
    + LED - Basic Blue 5mm COM-11372
    + LED - Basic Red 5mm COM-09590
    + LED - Basic Yellow 5mm COM-09594
    [LED - Basic Blue 5mm COM-11372.skp, LED - Basic Red 5mm COM-09590.skp, LED - Basic Yellow 5mm COM-09594.skp]
2013-05-10 3mm Versions of LEDs
    + LED - Basic Green 3mm COM-09650
    + LED - Basic Red 3mm COM-00533
    + LED - Basic Yellow 3mm COM-00532
    [LED - Basic Green 3mm COM-09650.skp, LED - Basic Red 3mm COM-00533.skp, LED - Basic Yellow 3mm COM-00532.skp]
2013-05-10 LED Tactile Buttons
    + LED Tactile Button - Orange COM-10441
    + LED Tactile Button - Green COM-10440
    + LED Tactile Button - Red COM-10442
    + LED Tactile Button - Blue/White COM-10443/10439
    All in category "Components"
    [LED Tactile Button - Blue:White COM-10443:10439.skp, LED Tactile Button - Green COM-10440.skp, LED Tactile Button - Orange COM-10441.skp, LED Tactile Button - Red COM-10442.skp]
2013-05-11 Added Subcategories
    Note that I have only the models I made and the models before I forked.
    Please help with reorganizing!
    [7-Segment Display - 4-Digit (White) COM-10931.skp, 7-Segment Display - LED (Blue) COM-09191.stl, Antenna GPS Embedded SMA GPS-00177.SLDPRT, Antenna GPS Embedded SMA GPS-00177.stl, Arduino and Breadboard Holder - DEV-11235.stl, Breadboard - Mini Modular (Black) PRT-11662.skp, Breadboard - Mini Modular (Black) PRT-11662~.skp, Breadboard - Translucent Self-Adhesive - PRT-09567.stl]
2013-05-14 Smoothing STLs to SKPs
    Smoothed and Painted Breakout Board STLs for SketchUp
    [LiPo Charger Basic - Micro-USB PRT-10217.skp, LiPo Charger Basic - Mini-USB PRT-10401.skp, Power Cell - LiPo Charger Booster PRT-11231.skp]
2013-05-14 Folder Cleanup
    "Hook Up" isn't a top-level catalog directory, moving RPi header to
    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
    [Raspberry Pi - GPIO Shrouded Header (2x13)-11490.skp]
2013-05-23 Fixed accidental replacement of nicbingham's LiPo charger
    I kept mine in, it has all of the components, but less detail on the
    connectors.
    [LiPo+Charger+Basic+-+Mini-USB+PRT-10401.stl]
2013-05-24 Robotic Claw - MKII - ROB-11524
    [Robotic Claw - MKII - ROB-11524.stp]
2013-07-18 Added 1000x scale STL and 1x scale SolidWorks, IGES, and STEP models of the Small Stepper Motor (ROB-10551)
    [Small Stepper Motor - ROB-10551.igs, Small Stepper Motor - ROB-10551.sldprt, Small Stepper Motor - ROB-10551.stl, Small Stepper Motor - ROB-10551.stp]
2013-08-16 Rename files for NTFS compatibility
    [LED Tactile Button - Blue_White COM-10443_10439.skp, LED Tactile Button - Green COM-10440.skp, LED Tactile Button - Orange COM-10441.skp, LED Tactile Button - Red COM-10442.skp, Mini Push Button Switch - SMD COM-08720.skp, Rocker Switch - Medium COM-10727.skp]
2013-08-28 new stuff
    [Arcade-Joystick-COM-09136.stl, Standoff-Swage-0.218-PRT-08985.stl, Standoff-Swage-0.3125-PRT-08984.stl, XBee-Shield-WRL-10854.stl]
2013-09-05 Added Pan/Tilt Bracket Model
    Based on dimensional drawings from the site
    [Pan:Tilt Bracket - ROB-10335.skp, Pan:Tilt Bracket - ROB-10335.stl]
2013-09-12 Added new LCD model
    First commit! First time to ever use Sketchup!
    [Basic 8x2 Character 3.3V LCD-11708.skp]
2013-09-17 saved in v8
    Orig was saved in Sketchup 2013 so I resaved it as Sketchup v8
    [Basic 8x2 Character 3.3V LCD-11708.skp]
2013-09-23 mp3 trigger
    [MP3-Trigger-WIG-11029.stl]
2013-10-06 Created stepper motor driver model for use in Big Easy Driver model.
    [QFN-28-Inches.skp]
2013-10-06 Created female headers and SMD Electrolytic Capacitor models for use in Big Easy Driver Model.
    [Female Headers PRT-00115.skp, SMD-ElectrolyticCap-Inches.skp]
2013-10-06 Created model for Big Easy Driver.
    [Big Easy Driver - ROB-11699.skp, Big Easy Driver - ROB-11699~.skp]
2013-11-18 Renamed Pan_Tilt Bracket
    [Pan_Tilt Bracket - ROB-10335.skp, Pan_Tilt Bracket - ROB-10335.stl]
2013-11-18 Added Sketchup File for SMD RGB COM-10866
    [LED-TRICOLOR-5050.skp]
2013-11-21 Added Inventor file for AVR 8 Pin 20MHz 8K 4AD - ATtiny85
    Added an Autodesk inventor file and stl file of the AVR 8 Pin 20MHz 8K
    4AD - ATtiny85, the only difference in the name that I had to remove is
    the "4AD" is actually "4A/D"
    [AVR 8 Pin 20MHz 8K 4AD - ATtiny85.ipt, AVR 8 Pin 20MHz 8K 4AD - ATtiny85.stl]
2013-11-21 Adding SKU to ATtiny85
    [AVR 8 Pin 20MHz 8K 4AD - ATtiny85 COM-09378.ipt, AVR 8 Pin 20MHz 8K 4AD - ATtiny85 COM-09378.stl]
2013-11-23 Correct sketchup file (single component)
    [LED-TRICOLOR-5050.skp]
2013-12-05 Adding Graphic 84x48 LCD-10168
    [Graphic-LCD-84x48-Nokia-5110.stl]
2014-01-01 Added Rotary Pot Comm-09939
    Autodesk Inventor and STEP files. This part is physically identical to
    rotary potentiometers COMM-09940 and COMM-09941.
    [COM-09939 - Rotary Potentiometer.0008.iam, COM-09939 - Rotary Potentiometer.iam, COM-09939 - Rotary Potentiometer.stp, Component10.ipt, Component11.ipt, Component3.ipt, Component5.ipt, Component7.ipt]
2014-01-07 Added STL file for Rotary Pot COM-09939
    [Rotary Potentiometer - COM-09939.stl]
2014-01-16 Adding SFE SKU numbers and supplier part numbers
    [Aluminum Beam - 1.54 inch ROB-12327 (SPN 585404).skp, Aluminum Beam - 2.31 inch ROB-12374 (SPN 585406).skp, Aluminum Beam - 3.08inch ROB-12424 (SPN 585408).skp, Aluminum Beam - 3.85 inch ROB-12481 (SPN 585410).skp, Aluminum Beam - 4.62 inch ROB-12171 (SPN 585412).skp, Aluminum Beam - 6.16 inch ROB-12198 (SPN 585416).skp, Aluminum Beam - 7.70 inch ROB-12558 (SPN 585420).skp, Aluminum Channel - 1.5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]
2014-01-22 lcd upload
    [Graphic-LCD-84x48-Nokia-5110.stl]
2014-01-22 taking out corrupted files
    [Graphic-LCD-84x48-Nokia-5110.stl]
2014-02-24 created 7-segment LED Displays (red and blue)
    [7-Segment Display - LED (Blue).skp, 7-Segment Display - LED (Red).skp]
2014-08-08 Added full file set for Universal Mounting Hub (ROB-10006). Folder includes license information, renderings, and 3D files for 1x and 1000x part sizes.
    [Universal Mounting Hub - ROB-10006.dxf, Universal Mounting Hub - ROB-10006.fcstd, Universal Mounting Hub - ROB-10006.iges, Universal Mounting Hub - ROB-10006.scad, Universal Mounting Hub - ROB-10006.step, Universal Mounting Hub - ROB-10006.stl]
2014-08-08 Added one more detailed rendering to the Universal Mounting Hub.
2014-08-08 Renamed rendering files for Universal Mounting Hub
2014-08-30 Added 1x scale model of battery.
    [CR2032.fcstd]
2014-08-30 Renamed CR2032 file to proper SparkFun name.
    [Coin Cell Battery - 20mm (CR2032) - PRT-00338.fcstd]
2014-08-30 Added exported files for 1x size of the CR2032.
    [Coin Cell Battery - 20mm (CR2032) - PRT-00338.dxf, Coin Cell Battery - 20mm (CR2032) - PRT-00338.iges, Coin Cell Battery - 20mm (CR2032) - PRT-00338.step, Coin Cell Battery - 20mm (CR2032) - PRT-00338.stl]
2014-08-30 Added 1000x base FreeCAD file.
    [Coin Cell Battery - 20mm (CR2032) - PRT-00338.fcstd]
2014-08-31 Added other 1000x files.
    [Coin Cell Battery - 20mm (CR2032) - PRT-00338.step]
2014-11-13 actobotics products rework repo structure
    [7-Segment Display - 20mm COM-11409.skp, 7-Segment Display - 20mm COM-11409.stl, 7-Segment Display - 4-Digit (White) COM-10931.skp, 7-Segment Display - 4-Digit (White) COM-10931.stl, 7-Segment Display - 4-Digit-Adafruit-1266.skp, 7-Segment Display - LED (Blue) COM-09191.stl, 7-Segment Display - LED (Red) COM-08546.skp, 7-Segment Serial Display COM-11441.skp]
2014-11-14 some more structure rework and readme
    [0402-CAP.skp, 0402-RES.skp, 0603-CAP.skp, 0603-RES.skp, 0805.skp, 603 LED.skp, 7-Segment Display - LED (Blue).skp, 7-Segment Display - LED (Red).skp]
2014-12-08 Pull in Evan Spitlers work
    [BOB_09056.IGS, BOB_09056.SLDPRT, BOB_09056.STEP, BOB_09056.STL, ROB-12100.IGS, ROB-12100.SLDPRT, ROB-12100.STEP, ROB-12100.STL]
2014-12-11 clean up and texture xbee model product #10419
    [WRL_10419.STL, model.blend]
2014-12-11 tweak material settings for xbee product #10419
    [model.blend]
2014-12-12 adds a xbee logo texture to the display model
    [model.blend]
2014-12-12 fix color output by prevent blender from doing gamma
    [model.blend]
2014-12-19 list of common materials in readme minor display improvements
    [9056.blend, BOB_09056.STL]
2014-12-30 #9269 ADXl335 Breakout geometry from eagleUp glamour display
    [9269.blend, ADXL335_Breakout.stl]
2014-12-30 #11189 Sparkfun Transceiver Breakout MAX3232
    [11189.blend, MAX3232_Breakout_v01.stl]
2014-12-30 #11821 LED - SMD RGB (WS2812)
    [11821.SLDPRT, 11821.STL, 11821.blend]
2014-12-30 blender template
    [startup.blend]
2014-12-31 BOB-11820 SparkFun RGB LED Breakout - WS2812
    [11820.blend, ws2811-Breakout.stl]
2014-12-31 BOB-10680 Shift Register Breakout - 74HC595
    [10680.blend, 74HC595ShiftRegBreakout-v11.stl]
2014-12-31 color/UV tweak
    [11820.blend]
2015-01-01 BOB-12009 Logic Level Converter - Bi-Directional
    [12009.blend, Logic_Level_Bidirectional.stl]
2015-01-01 #12009 texture fix
    [12009.blend]
2015-01-01 SEN-12787 RGB and Gesture Sensor - APDS-9960 whew. that one was fun.
    [12787.blend, APDS-9960.SLDPRT, APDS-9960.STL, APDS-9960_RGB_and_Gesture_Sensor-v10.stl, apds-9960.blend]
2015-01-01 WIG-08601 Project Case
    [WIG-08601_assy.SLDASM, WIG-08601_assy.STEP, WIG-08601_bottom.SLDPRT, WIG-08601_bottom.STEP, WIG-08601_bottom.STL, WIG-08601_insert.IGS, WIG-08601_insert.SLDPRT, WIG-08601_insert.STEP]
2015-01-02 COM-00299 - 16 Channel Multiplexer
    [299.SLDPRT, 299.STL, 299.blend]
2015-01-02 pull in product #299
    [9056.blend]
2015-01-02 BOB-09118 - Opto-isolator Breakout
    [9118.blend, Optoisolator-v12.stl]
2015-01-05 small tweak
    [299.SLDPRT]
2015-01-05 tweak IC placement
    [9056.blend]
2015-01-05 BOB-13098 - Rotary Switch Breakout
    [13098.blend, 13098.stl]
2015-01-05 DEV-13067 - MiP Proto-Pack
    [13067.blend, MiP_Proto-Pack_v10.stl]
2015-01-05 DEV-13066 - MiP Proto-Back
    [13066.blend]
2015-01-05 BOB-13005 - TRS Jack Breakout - 1/4" Stereo
    [13005.blend, TRS_Jack_Breakout.stl]
2015-01-05 SEN-13030 - RFID Reader Breakout
    [13030.blend, RFID_Breakout_v2.stl]
2015-01-05 PRT-12702 - Solder-able Breadboard - Mini
    [12702.blend, solderable_breadboard_mini.stl]
2015-01-05 PRT-12699 - Solder-able Breadboard - Large
    [12699.blend, solderable_breadboard_large.stl]
2015-01-05 PRT-12070 - SparkFun Solder-able Breadboard
    [12070.blend]
2015-01-05 BOB-09110 - Breakout Board for Thumb Joystick
    [9110.blend, joystick-breakout-v12.stl]
2015-01-06 BOB-11722 - Rotary Encoder Breakout - Illuminated (RG/RGB)
    [11722.blend, rg-rgb-Encoder-v10.stl]
2015-01-06 BOB-09540 - Breakout Board for L298N Full-Bridge Motor Driver
    [9540.blend, l298breakout11.stl]
2015-01-06 BOB-10467 - LED Tactile Button Breakout
    [10467.blend, button-led-breakout-v11.stl]
2015-01-06 BOB-10495 - Coin Cell Battery Holder Breakout - 24.5mm
    [10495.blend, 24.5mm-coin-cell-breakout-v11.stl]
2015-01-06 PRT-09109 - USB Female Type B Vertical Breakout Board
    [9109.blend, usb_b_vertical_breakout-v11.stl]
2015-01-06 File was somehow corrupted - revert
    [299.SLDPRT]
2015-01-06 PRT-12690 - Header - 10-pin Female (SMD, 0.1")
    [12690.SLDPRT, 12690.blend, 12690.stl]
2015-01-06 BOB-00494 - SOIC to DIP Adapter 8-Pin
    [494.blend, sparkfun_soic8-dip-adapter-v10.stl]
2015-01-06 BOB-00716 - RJ45 Breakout
    [716.blend, sparkfun_rj45_breakout_v11.stl]
2015-01-06 BOB-00500 - SSOP to DIP Adapter 28-Pin
    [500.blend, sparkfun_ssop28-dip-adapter-v12.stl]
2015-01-06 BOB-00495 - SOIC to DIP Adapter 20-Pin
    [495.blend, sparkfun_soic20_adapter_v10.stl]
2015-01-06 BOB-00496 - SOIC to DIP Adapter 28-Pin
    [496.blend, sparkfun_soic28-dip-adapter-v10.stl]
2015-01-06 BOB-00497 - SSOP to DIP Adapter - 8-Pin
    [497.blend, sparkfun_adapter-ssop8-v10.stl]
2015-01-06 BOB-00498 - SSOP to DIP Adapter - 16-Pin
    [498.blend, sparkfun_ssop16_breakout_v10.stl]
2015-01-06 PRT-11544 - Header - 8-pin Female (SMD, 0.1")
    [11544.SLDPRT, 11544.blend, 11544.stl]
2015-01-06 PRT-11543 - 8-pin Female (SMD, 0.1")
    [11543.SLDPRT, 11543.blend, 11543.stl]
2015-01-08 smd headers
    [11543.SLDPRT, 11543.blend, 11544.blend, 12590.SLDPRT, 12590.STL, 12590.blend, 12690.SLDPRT, 12690.blend]
2015-01-08 PRT-12748 - DC Barrel Power Jack/Connector (SMD)
    [12748.SLDPRT, 12748.blend, 12748.stl]
2015-01-08 PRT-00587 - USB Mini-B SMD Connector
    [587.blend, 587.stl]
2015-01-08 missed solidworks
    [43798.SLDASM, 43798_01.SLDPRT, 43798_02.SLDPRT, 43798_03.SLDPRT, 43798_04.SLDPRT, 43798_05.SLDPRT, 43798_06.SLDPRT, 43798_07.SLDPRT]
2015-01-08 COM-00650 - USB to UART Bridge - FT232RL also ftl231xs
    [650.SLDPRT, 650.STL, 650.blend, ft231xs.STL, ft231xs.blend]
2015-01-08 COM-08720 - Mini Pushbutton Switch - SMD
    [8720.STL, 8720.blend, 8720b.SLDPRT]
2015-01-08 COM-09261 - ATMega328 - TQFP
    [9261.SLDPRT, 9261.STL, 9261.blend]
2015-01-08 COM-00094 - Crystal SMD 16MHz
    [94.SLDPRT, 94.STL, 94.blend]
2015-01-08 DEV-12757 - SparkFun RedBoard
    [12757.blend, redboard-v21.stl]
2015-01-09 DEV-11113 & DEV-11114 Arduino Pro Mini
    [11113.blend, 11114.blend, arduino-pro-mini.stl]
2015-01-09 include populated stl
    [arduino-pro-mini-board.stl, arduino-pro-mini-populated.stl]
2015-01-10 ROB-09238: Stepper Motor with Cable added
    [9238.blend, 9238.sldprt, 9238.stl]
2015-01-14 Udated UI to expand sidebar and added python console
    [startup.blend]
2015-01-19 some packages
    [0402-CAP.skp, 0402-RES.SKP, 0603-CAP.skp, 0603-LED-ALT1.SKP, 0603-RES.skp, EIA3216.skp, RESONATOR-SMD-11.skp, RESONATOR-SMD-1_1.skp]
2015-01-19 Added 6, 8, and 10-pin femal SMD connectors and 47uF electrolytic CAP
    [11544.SLDPRT, 1X06_SMD_STRAIGHT_COMBO.skp, 1X08_SMD_COMBINED.skp, 1X10_SMD_COMBINED.skp, PANASONIC_D.skp, panasonic_d.SLDPRT, panasonic_d.STL]
2015-01-21 Moved CR2032 files into their general location.
    [Coin Cell Battery - 20mm (CR2032) - PRT-00338.dxf, Coin Cell Battery - 20mm (CR2032) - PRT-00338.fcstd, Coin Cell Battery - 20mm (CR2032) - PRT-00338.iges, Coin Cell Battery - 20mm (CR2032) - PRT-00338.step, Coin Cell Battery - 20mm (CR2032) - PRT-00338.stl]
2015-01-21 Source files and product geometry files added for part number 338 (CR2032).
    [338.dxf, 338.fcstd, 338.iges, 338.step, 338.stl, Coin Cell Battery - 20mm (CR2032) - PRT-00338.fcstd, Coin Cell Battery - 20mm (CR2032) - PRT-00338.step]
2015-01-21 Added SMD Resonator SDW, STL, SKP
    [RESONATOR_SMD.SLDPRT, RESONATOR_SMD.STL, RESONATOR_SMD.skp]
2015-01-26 Added Micro USB connector in Products and Production parts
    [12034.blend, USB-AB-MICRO-SMD-V03-IN&OUT.STL]
2015-01-28 lots of production parts
    [0603-LED-ALT1.SKP, 2X3_SMT_POSTS.SKP, 2X3_SMT_POSTS.SLDPRT, 2X3_SMT_POSTS.STL, 2X3_SMT_POSTSb.SLDPRT, APDS-9960.SLDPRT, APDS-9960.STL, APDS-9960.skp]
2015-01-28 remove aluminum texture from components
    [0603-LED-ALT1.SKP, 0603-RES.skp, EIA3216.SKP, EIA3216.skp, LED-0603.SKP, RESONATOR-SMD-1_1.SKP, RESONATOR-SMD-1_1.skp]
2015-01-28 #11113 & 11114 - Arduino Pro Mini eagleUp build
    [11113.blend, 11114.blend, Arduino-Pro-Mini.blend, Arduino-Pro-Mini.skp, Arduino-Pro-Mini.stl, arduino-pro-mini-board.stl, arduino-pro-mini-populated.stl, boardpost.blend]
2015-01-28 #13190 - 7 Segment Shield eagleUp Build
    [Serial-7-Segment-Shield.blend, Serial-7-Segment-Shield.skp, Serial-7-Segment-Shield.stl, boardpost.blend]
2015-01-28 #12935 FTDI SmartBasic eagleUp build
    [FTDI_SmartBasic.blend, FTDI_SmartBasic.skp, FTDI_SmartBasic.stl, boardpost.blend]
2015-01-28 skp and production part for #11821 SMD Tricolor led
    [11821.skp, LED-TRICOLOR-5050-IC.skp]
2015-01-29 #11820 - Tri Color LED Breakout
    [11820.blend, boardpost.blend, ws2811-Breakout.stl, ws2812-Breakout.blend, ws2812-Breakout.skp, ws2812-Breakout.stl]
2015-01-29 #500 - SSOP28 DIP Adapter
    [500.blend, SparkFun_SSOP28-DIP-Adapter-v12.blend, SparkFun_SSOP28-DIP-Adapter-v12.skp, SparkFun_SSOP28-DIP-Adapter-v12.stl, boardpost.blend, sparkfun_ssop28-dip-adapter-v12.stl]
2015-01-29 tri color led production part
    [LED-TRICOLOR-5050-IC.skp]
2015-01-29 smd DPDT production part
    [AYZ0202.SLDPRT, AYZ0202.STL, AYZ0202.skp, POWER_JACK_SMD.skp, SOT223.SKP]
2015-01-29 edison connector production part
    [DF40C-70DP-0_4_51_.skp, DF40C-70DP-0_4_51_.stp]
2015-01-29 3.5mm smd audio jack production part
    [AUDIO-JACK-3_5MM-SMD.SLDPRT, AUDIO-JACK-3_5MM-SMD.STL, AUDIO-JACK-3_5MM-SMD.skp]
2015-01-30 fix 3.5mm audio jack
    [AUDIO-JACK-3_5MM-SMD.SLDPRT, AUDIO-JACK-3_5MM-SMD.STL, AUDIO-JACK-3_5MM-SMD.skp]
2015-01-30 audiojack missing material
    [AUDIO-JACK-3_5MM-SMD.skp]
2015-01-30 more missing mats on the 3.5mm audio jack
    [AUDIO-JACK-3_5MM-SMD.skp]
2015-01-30 #11568 - Papilo Audio Wing
    [Papilio-Audio_Wing.blend, Papilio-Audio_Wing.skp, Papilio-Audio_Wing.stl, boardpost.blend]
2015-01-30 #12070 - Solderable BreadBoard
    [12070.blend, SIK-DIP-board.blend, SIK-DIP-board.skp, SIK-DIP-board.stl, boardpost.blend]
2015-01-30 #12009 - Logic Level Converter
    [12009.blend, Logic_Level_Bidirectional.blend, Logic_Level_Bidirectional.skp, Logic_Level_Bidirectional.stl, boardpost.blend]
2015-01-30 #8552 - Serial DB9 Breakout
    [SparkFun_Serial_DB9-Breakout-v13.blend, SparkFun_Serial_DB9-Breakout-v13.skp, SparkFun_Serial_DB9-Breakout-v13.stl, boardpost.blend]
2015-01-30 #10934 - Breadboard power supply
    [BreadboardPowerSupplyStick1_8V-v10ass.blend, BreadboardPowerSupplyStick1_8V-v10ass.skp, BreadboardPowerSupplyStick1_8V-v10ass.stl, boardpost.blend]
2015-01-30 #11509 - Papilio Button LED Wing
    [Papilio-Button_LED_Wing.blend, Papilio-Button_LED_Wing.skp, Papilio-Button_LED_Wing.stl, boardpost.blend]
2015-01-30 #12702 - Solderable breadboard mini
    [12702.blend, boardpost.blend, solderable_breadboard_mini.blend, solderable_breadboard_mini.skp, solderable_breadboard_mini.stl]
2015-01-30 #9530 - OpenLog
    [OpenLog.blend, OpenLog.skp, OpenLog.stl, boardpost.blend]
2015-01-30 #13066 - MiP Proto Back
    [13066.blend, MiP_Proto-Back.blend, MiP_Proto-Back.skp, MiP_Proto-Back.stl, boardpost.blend]
2015-01-30 #13067 - MiP Proto Pack
    [13067.blend, MiP_Proto-Pack.blend, MiP_Proto-Pack.skp, MiP_Proto-Pack.stl, MiP_Proto-Pack_v10.stl, boardpost.blend]
2015-01-30 SOD-323 production part
    [SOD-323.SLDPRT, SOD-323.STL, SOD-323.skp]
2015-01-30 TSSOP20 production part
    [TSSOP20.STL, TSSOP20.skp]
2015-01-30 #12082 - AD5330 Breakout
    [AD5330_Breakout.blend, AD5330_Breakout.skp, AD5330_Breakout.stl, boardpost.blend]
2015-01-30 FN-6 production part datasheet for part doesn't look like photos ...
    [FN-6.SLDPRT, FN-6.STL, FN-6.skp]
2015-01-30 #12055 - Luminosity Sensor BOB
    [TSL2561_Luminosity_Sensor_BOB.blend, TSL2561_Luminosity_Sensor_BOB.skp, TSL2561_Luminosity_Sensor_BOB.stl, boardpost.blend]
2015-01-30 SOT563-2 production part
    [SOT563-2.SLDPRT, SOT563-2.STL, SOT563-2.skp]
2015-01-30 #11931 - Temperature Sensor BOB
    [Digital_Temperature_Sensor_Breakout_-_TMP102.blend, Digital_Temperature_Sensor_Breakout_-_TMP102.skp, Digital_Temperature_Sensor_Breakout_-_TMP102.stl, boardpost.blend]
2015-01-30 Added production part RN41 bluetooth module
    [RN41.SLDPRT, RN41.STL, RN41.skp]
2015-01-30 #9570 - Infrared Thermometer MLX90614
    [9570.IGS, 9570.SLDPRT, 9570.STEP, 9570.STL, 9570.blend]
2015-01-31 #10804 - Breadboard Power Supply
    [Breadboard_Power_Supply_-_SMD_v13.blend, Breadboard_Power_Supply_-_SMD_v13.skp, Breadboard_Power_Supply_-_SMD_v13.stl]
2015-01-31 usbmicro production part
    [USB-MICROB.SKP]
2015-01-31 #11736 - FT231X Breakout
    [ft231x-breakout.blend, ft231x-breakout.skp, ft231x-breakout.stl]
2015-01-31 #11378 - Bluetooth Mate
    [BT_Mate_MaKey.blend, BT_Mate_MaKey.skp, BT_Mate_MaKey.stl]
2015-01-31 SOT23-6-MCP4755 as SOT23-6
    [SOT23-6-MCP4725.skp]
2015-01-31 #12918 - MCP4725 Breakout
    [MCP4725_Breakout.blend, MCP4725_Breakout.skp, MCP4725_Breakout.stl]
2015-01-31 #12577 - BlueSMiRF
    [BlueSMiRF-ChipAnt.blend, BlueSMiRF-ChipAnt.skp, BlueSMiRF-ChipAnt.stl]
2015-01-31 #12576 - Bluetooth Module
    [BluetoothMate.blend, BluetoothMate.skp, BluetoothMate.stl]
2015-01-31 QFN-24-NP production part
    [QFN-24-NP.SLDPRT, QFN-24-NP.STL, QFN-24-NP.skp]
2015-01-31 #11486 - MPU-9150 Breakout
    [mpu-9150_breakout.blend, mpu-9150_breakout.skp, mpu-9150_breakout.stl]
2015-01-31 BMP180 production part
    [BMP180.SLDPRT, BMP180.STL, BMP180.skp]
2015-01-31 #11824 - BMP180 breakout
    [BMP180_breakout.blend, BMP180_breakout.skp, BMP180_breakout.stl]
2015-01-31 QFN-24 production part copy
    [QFN-24_ITG3200_1_1.skp]
2015-01-31 #11977 - Triple Axis Gyro
    [Triple_axis_digital_-_output_gyro_ITG-3200_Breakout.blend, Triple_axis_digital_-_output_gyro_ITG-3200_Breakout.skp, Triple_axis_digital_-_output_gyro_ITG-3200_Breakout.stl]
2015-01-31 #12582 - Blutooth module
    [BlueSMiRF-ChipAnt.blend, BlueSMiRF-ChipAnt.skp, BlueSMiRF-ChipAnt.stl]
2015-01-31 QFN-20 production part
    [QFN-20-0_4MM-V2.skp, QFN-20.SLDPRT, QFN-20.STL]
2015-01-31 #9695 - MPR121-Breakout
    [MPR121-Breakout-v13.blend, MPR121-Breakout-v13.skp, MPR121-Breakout-v13.stl]
2015-01-31 #12759 - Bluetooth module
    [RN41-v14.blend, RN41-v14.skp, RN41-v14.stl]
2015-02-01 PTC-1206-WIDE production part
    [PTC-1206-WIDE.skp]
2015-02-01 5X3 Crystal production part
    [CRYSTAL-SMD-5X3.skp]
2015-02-01 small fix
    [RESONATOR-SMD-11.skp]
2015-02-01 SO014 production part should probably be SO14
    [SO014.skp]
2015-02-01 SO20L production part
    [SO20L.SLDPRT, SO20L.STL, SO20L.skp]
2015-02-01 2X5 Shrouded SMD production part
    [2X5-SHROUDED_SMD.SLDPRT, 2X5-SHROUDED_SMD.STL, 2X5-SHROUDED_SMD.skp]
2015-02-01 #9825 - AVR Pocket Programmer
    [AVR-Pocket-Programmer.blend, AVR-Pocket-Programmer.skp, AVR-Pocket-Programmer.stl]
2015-02-01 QFN-44 production part
    [QFN-24-NP.SLDPRT, QFN-24-NP.STL, QFN-44-NOPAD_1_1-OUTFAKES.skp, QFN-44-NOPAD_1_1.skp]
2015-02-01 #11117 - ATMEGA32U4 Breakout
    [32U4_Breakout.blend, 32U4_Breakout.skp, 32U4_Breakout.stl]
2015-02-01 #11028 - Accelerometer Breakout
    [Triple_Axis_Accelerometer_-_Gyro_Breakout_-_MPU-6050.blend, Triple_Axis_Accelerometer_-_Gyro_Breakout_-_MPU-6050.skp, Triple_Axis_Accelerometer_-_Gyro_Breakout_-_MPU-6050.stl]
2015-02-01 SO16 production part
    [SO16.skp]
2015-02-01 #11733 - Shift Register Breakout
    [SN74HC165_Shift-In_Breakout-v12.blend, SN74HC165_Shift-In_Breakout-v12.skp, SN74HC165_Shift-In_Breakout-v12.stl]
2015-02-01 LGA14 production part
    [LGA14.SLDPRT, LGA14.STL, LGA14.skp]
2015-02-01 #12021 - 6DOF Breakout
    [IMU_Digital_Combo_Board_-_6_Degrees_of_Freedom_-_ITG3200_-_ADXL345.blend, IMU_Digital_Combo_Board_-_6_Degrees_of_Freedom_-_ITG3200_-_ADXL345.skp, IMU_Digital_Combo_Board_-_6_Degrees_of_Freedom_-_ITG3200_-_ADXL345.stl]
2015-02-01 LGA14 production part copy
    [LGA14_1_1_PATRICK.skp]
2015-02-01 SO08 production part
    [SO08.skp]
2015-02-01 #9836 - ADXL345 Breakout
    [ADXL345_Breakout.blend, ADXL345_Breakout.skp, ADXL345_Breakout.stl]
2015-02-01 USB-MINIB and LED-TRICOLOR production part copies
    [LED-TRICOLOR-SMD.skp, USB-MINIB-NOSTOP.SKP]
2015-02-01 buzzer production part
    [BUZZER-CCV.skp]
2015-02-01 TEMT6000 production part
    [TEMT6000-SEN.skp]
2015-02-01 #10889 - ProtoSnap
    [ProtoSnap-v14a.blend, ProtoSnap-v14a.skp]
2015-02-01 edison production part updates
    [DF40C-70DP-0_4_51_.skp, DF40C-70DP-0_4_51_.stp, DF40C-70DP.STL, DF40C-70DP.stp, DF40HC(3.0)-70DS.stp, EDISON_DAUGHTER.skp]
2015-02-01 LED-1206-BOTTOM production part i just flipped the 1206-LED
    [LED-1206-BOTTOM.skp]
2015-02-01 JST-2-SMD production part
    [JST-2-SMD.SLDPRT, JST-2-SMD.STL, JST-2-SMD.skp]
2015-02-01 #12711 - USB LiPoly Charger
    [SparkFun_USB_LiPolyCharger_SingleCell.blend, SparkFun_USB_LiPolyCharger_SingleCell.skp, SparkFun_USB_LiPolyCharger_SingleCell.stl]
2015-02-02 TACTILE-PTH-12MM production part
    [TACTILE-PTH-12MM.SLDPRT, TACTILE-PTH-12MM.STL, TACTILE-PTH-12MM.skp]
2015-02-02 #12080 - VKeyVoltageKeypad
    [VKeyVoltageKeypad.blend, VKeyVoltageKeypad.skp, VKeyVoltageKeypad.stl]
2015-02-02 #12080 update
    [VKeyVoltageKeypad.skp]
2015-02-02 microb production part copy
    [USB-AB-MICRO-SMD-V03-IN_OUT.SKP]
2015-02-02 #12640 - ProMicro
    [Pro_Micro.blend, Pro_Micro.skp, Pro_Micro.stl]
2015-02-02 #12587 - ProMicro
    [Pro_Micro.blend, Pro_Micro.skp, Pro_Micro.stl]
2015-02-02 SOT23 & SO14 - production part
    [SO14.skp, SOT23.skp]
2015-02-02 #9544 - BusPirate
    [BusPirate-v36.blend, BusPirate-v36.skp]
2015-02-02 MIC_ELECTRET_SMD production part SO-28W production part
    [MIC_ELECTRET_SMD.skp, SO-28W.skp]
2015-02-02 #10653 - ISD1932 Breakout
    [ISD1932_Breakout-v21.blend, ISD1932_Breakout-v21.skp, ISD1932_Breakout-v21.stl]
2015-02-02 edison rename curse you, windows filesystem
    [DF40HC_3.0_-70DS.stp]
2015-02-02 remove space from filepath derp
    [PTC-1206b.SLDPRT, ptc-1206.SLDPRT]
2015-02-05 #12787 - APDS-9960 RGB and Gesture sensor
    [12787.blend, APDS-9960_RGB_and_Gesture_Sensor-v10.stl, SparkFun_APDS-9960_RGB_and_Gesture_Sensor.blend, SparkFun_APDS-9960_RGB_and_Gesture_Sensor.skp, SparkFun_APDS-9960_RGB_and_Gesture_Sensor.stl]
2015-02-05 #8619 - Wombat
    [SparkFun_Protoboard-PTH-v14.blend]
2015-02-05 #8467 - Lilypad TriColor
    [SparkFun_LilyPad_Tricolor-LED.blend, SparkFun_LilyPad_Tricolor-LED.skp, SparkFun_LilyPad_Tricolor-LED.stl]
2015-02-05 EIA3528 production part
    [EIA3528.SKP]
2015-02-05 SO08 production part copy
    [SO08-EIAJ.skp]
2015-02-05 #10899 - LilyTiny
    [LilyTiny.blend, LilyTiny.skp, LilyTiny.stl]
2015-02-05 #11893 - Lilypad SimplePower
    [LilyPad_SimplePower.blend, LilyPad_SimplePower.skp, LilyPad_SimplePower.stl]
2015-02-05 #11891 - LilyPixel
    [LilyPixel.blend, LilyPixel.skp, LilyPixel.stl]
2015-02-05 #9238 - fix a couple missing mats
    [9238.blend]
2015-02-05 #11364 - LilyTwinkle
    [LilyTiny.blend, LilyTiny.skp, LilyTiny.stl]
2015-02-06 #8776 - Lilypad Button
    [SparkFun_LilyPad-Button.blend, SparkFun_LilyPad-Button.skp, SparkFun_LilyPad-Button.stl]
2015-02-13 Updated packages for big easy. Relocated diodes to semiconductors.
    Updated Packages:
    SO-214/SMA-DIODE
    QFN-28
    SOT-89 Copy
    3mm Trimpot
    2010 resistor fuse
    [DO-214AC.IGS, DO-214AC.SLDPRT, DO-214AC.STEP, DO-214AC.STL, DO-214AC.blend, DO-214AC.skp, QFN-28-5MM_ALT1.IGS, QFN-28-5MM_ALT1.SLDPRT]
2015-02-13 12859 Big Easy Driver revision
    [BigEasyDriver.blend, BigEasyDriver.skp, BigEasyDriver.stl]
2015-02-14 VL6180 Component package
    [User Library-ARJ11B.SLDPRT, VL6180.IGS, VL6180.SLDPRT, VL6180.STEP, VL6180.STL, VL6180.skp]
2015-02-14 Time of Flight Range Finder Breakout 12784
    [VL6180_Breakout.blend, VL6180_Breakout.skp, VL6180_Breakout.stl]
2015-02-14 Time of Flight Range Finder Sensor 12785
    [VL6180_Sensor.blend, VL6180_Sensor.skp, VL6180_Sensor.stl]
2015-02-16 rebuild promicro boards to fix bottom texture
    [Pro_Micro.blend, Pro_Micro.skp, Pro_Micro.stl]
2015-02-16 strip space in filename
    [User_Library-ARJ11B.SLDPRT]
2015-02-17 #10030 XBEE Header
    [1X10_2MM_SMD.SLDPRT, 1X10_2MM_SMD.STL, 1X10_2MM_SMD.blend, 1X10_2MM_SMD.skp]
2015-02-17 xbee-smd production part
    [XBEE-SMD.skp]
2015-02-17 fix usbmini b holes
    [USB-MINIB.SKP]
2015-02-17 fix pads D pad to C pad
    [1X10_2MM_SMD.SLDPRT, 1X10_2MM_SMD.STL, 1X10_2MM_SMD.blend, 1X10_2MM_SMD.skp]
2015-02-17 fix header D pad to C pad
    [XBEE-SMD.skp]
2015-02-17 update MICRO-B connector
    [32U4_Breakout.blend, 32U4_Breakout.skp, 32U4_Breakout.stl, AVR-Pocket-Programmer.blend, AVR-Pocket-Programmer.skp, BusPirate-v36.blend, BusPirate-v36.skp, ProtoSnap-v14a.blend]
2015-02-17 MagJack Component. Replaced bad model with scratchbuilt
    [MAGJACK.IGS, MAGJACK.SLDPRT, MAGJACK.STEP, MAGJACK.STL, MAGJACK.blend, MAGJACK.skp, User Library-ARJ11B.SLDPRT]
2015-02-17 MagJack Breakout 13021
    [MagJack_Breakout.blend, MagJack_Breakout.skp, MagJack_Breakout.stl]
2015-02-17 MagJack RJ-45 Connector 8354
    [8534.IGS, 8534.SLDPRT, 8534.STEP, 8534.STL, 8534.blend, 8534.skp]
2015-02-18 Removed bad connector
    [User_Library-ARJ11B.SLDPRT]
2015-02-18 #11520 - Arduino Fio
    [Arduino-Fio.blend, Arduino-Fio.skp, Arduino-Fio.stl]
2015-02-18 #11373 - XBee Explorer
    [XBee-Regulated.blend, XBee-Regulated.skp, XBee-Regulated.stl]
2015-02-18 #11812 - XBee Explorer
    [XBee-Explorer.blend, XBee-Explorer.skp, XBee-Explorer.stl]
2015-02-18 #9565 - MPR121 Breakout
    [MPR121-Breakout-v13.blend, MPR121-Breakout-v13.skp, MPR121-Breakout-v13.stl]
2015-02-18 #12731 - FT232R Breakout
    [FT232R-Breakout.blend, FT232R-Breakout.skp, FT232R-Breakout.stl]
2015-02-19 #9966 - USB Mini B
    [SparkFun_miniUSB_Breakout_v13.blend, SparkFun_miniUSB_Breakout_v13.skp, SparkFun_miniUSB_Breakout_v13.stl]
2015-02-24 #10401 - SparkFun Lipo Charger
    [SparkFun_LiPo-Charger-Basic-MiniUSB.blend, SparkFun_LiPo-Charger-Basic-MiniUSB.skp, SparkFun_LiPo-Charger-Basic-MiniUSB.stl]
2015-02-25 magjack updates
    [8534.IGS, 8534.SLDPRT, 8534.STEP, 8534.STL, 8534.blend, 8534.skp, MAGJACK.IGS, MAGJACK.SLDPRT]
2015-03-31 Updated Passives, Connectors, and Switches
    [0603.skp, 0805.skp, 1210.skp, CR54.IGS, CR54.SLDPRT, CR54.STEP, CR54.STL, CR54.skp]
2015-03-31 Updated SMD IC Packages
    [MSOP8.IGS, MSOP8.SLDPRT, MSOP8.STEP, MSOP8.STL, MSOP8.blend, MSOP8.skp, PIC24FXXX_TQFP64.SLDPRT, PIC24FXXX_TQFP64.STEP]
2015-03-31 12633 IOIO OTG
    [IOIO-OTG.blend, IOIO-OTG.skp]
2015-03-31 12779 Easy Driver
    [EasyDriver_v45.blend, EasyDriver_v45.skp, EasyDriver_v45.stl]
2015-03-31 13032 Breadboard Power Supply 5V/3.3V
    [SparkFun_Breadboard_Power_Supply-5v_3V_SMD.blend, SparkFun_Breadboard_Power_Supply-5v_3V_SMD.skp, SparkFun_Breadboard_Power_Supply-5v_3V_SMD.stl]
2015-03-31 13058 MiP Pro Mini
    [Sparkfun_MiP_ProMini-Pack.blend, Sparkfun_MiP_ProMini-Pack.skp, Sparkfun_MiP_ProMini-Pack.stl]
2015-03-31 13116 Spectrum Shield
    [Spectrum_Shield.blend, Spectrum_Shield.skp, Spectrum_Shield.stl]
2015-03-31 13157 Breadboard Power Supply 3.3V/1.8V
    [SparkFun_Breadboard_Power_Supply-3_3-1_8SMD.blend, SparkFun_Breadboard_Power_Supply-3_3-1_8SMD.skp, SparkFun_Breadboard_Power_Supply-3_3-1_8SMD.stl]
2015-04-02 Connectors - Added SIMHOLDER, BATTCON_12mm, and headers for ID-12 connection
    [1X05.SLDPRT, 1X05.STL, 1X05_2_54MM.SLDPRT, 1X05_SMD.skp, 1X07.SLDPRT, 1X07.STL, 1X07_2_54MM.SLDPRT, 1X07_SMD.skp]
2015-04-02 Added MG2639
    [MG2639.IGS, MG2639.SLDPRT, MG2639.STEP, MG2639.STL, MG2639.skp]
2015-04-02 5x3.2mm Crystal Oscillator
    [CRYSTAL-OSC-SMD-5X3_2.SLDPRT, CRYSTAL-OSC-SMD-5X3_2.STL, CRYSTAL-OSC-SMD-5X3_2.skp]
2015-04-02 PTH Components for Kits
    [AXIAL-0_3.SLDPRT, AXIAL-0_3.STL, AXIAL-0_3.skp, SCREWTERMINAL-3_5MM-2.IGS, SCREWTERMINAL-3_5MM-2.SLDPRT, SCREWTERMINAL-3_5MM-2.STEP, SCREWTERMINAL-3_5MM-2.STL, SCREWTERMINAL-3_5MM-2.skp]
2015-04-02 Added IC Pkgs: SOT353, TO263, TSSOP28
    [Q5-DD_SPX29300.IGS, Q5-DD_SPX29300.SLDPRT, Q5-DD_SPX29300.STEP, Q5-DD_SPX29300.STL, Q5-DD_SPX29300.skp, SOT353.SLDPRT, SOT353.STL, SOT353.skp]
2015-04-03 10213 TO220 N-Channel MOSFET
    [10213.IGS, 10213.SLDPRT, 10213.STEP, 10213.STL, 10213.blend, 10213.skp]
2015-04-03 10592 Coin Cell Battery Holder - 12mm SMD
    [BATTCON_12MM.IGS, BATTCON_12MM.SLDPRT, BATTCON_12MM.STEP, BATTCON_12MM.STL, BATTCON_12MM.blend, BATTCON_12MM.skp]
2015-04-03 12959 MOSFET Power Control Kit
    [SparkFun_MOSFET_Power_Control_Kit.blend, SparkFun_MOSFET_Power_Control_Kit.skp, SparkFun_MOSFET_Power_Control_Kit.stl]
2015-04-03 13118 Servo Trigger
    [SparkFun_Servo_Trigger.blend, SparkFun_Servo_Trigger.json, SparkFun_Servo_Trigger.skp, SparkFun_Servo_Trigger.stl]
2015-04-03 13120 MG2639 Cellular Shield
    [MG2639_Cellular_Shield.blend, MG2639_Cellular_Shield.skp]
2015-04-03 13183 Cryptoshield
    [cryptoshield.blend, cryptoshield.skp]
2015-04-03 12320 HX711 Load Cell Amplifier
    [SparkFun_HX711_Load_Cell.blend, SparkFun_HX711_Load_Cell.skp, SparkFun_HX711_Load_Cell.stl]
2015-04-03 00548 Sim Socket
    [SIMHOLDER.IGS, SIMHOLDER.SLDPRT, SIMHOLDER.STEP, SIMHOLDER.STL, SIMHOLDER.blend, SIMHOLDER.skp]
2015-04-03 08084 2-terminal Screw Terminal
    [8084.blend, SCREWTERMINAL-3_5MM-2.IGS, SCREWTERMINAL-3_5MM-2.SLDPRT, SCREWTERMINAL-3_5MM-2.STEP, SCREWTERMINAL-3_5MM-2.STL, SCREWTERMINAL-3_5MM-2.skp]
2015-04-03 08235 3-terminal Screw Terminal
    [8235.blend, SCREWTERMINAL-3_5MM-3.IGS, SCREWTERMINAL-3_5MM-3.SLDPRT, SCREWTERMINAL-3_5MM-3.STEP, SCREWTERMINAL-3_5MM-3.STL, SCREWTERMINAL-3_5MM-3.skp]
2015-04-09 RN-52 Bluetooth Module
    [11678.blend, RN-52.IGS, RN-52.SLDPRT, RN-52.STEP, RN-52.STL, RN-52.skp]
2015-04-09 11678 - RN-52 Bluetooth Module
    [11678.IGS, 11678.SLDPRT, 11678.STEP, 11678.STL, 11678.blend, 11678.skp]
2015-04-09 12849 - RN-52 Breakout board
    [RN-52_20Breakout.blend, RN-52_20Breakout.skp, RN-52_20Breakout.stl]
2015-04-10 minor folder housekeeping
    [APDS-9960.STL, ML8511_Breakout.stl, RN-52.STL, apds-9960.blend, sim_card_reader.SLDPRT]
2015-04-10 ML8511 UV sensor
    [ML8511.IGS, ML8511.SLDPRT, ML8511.STEP, ML8511.STL, ML8511.skp]
2015-04-10 12705 UV breakout board
    [ML8511_Breakout.blend, ML8511_Breakout.skp]
2015-04-29 Five 5mm LEDs
    + Added COM-9590 (LED - Basic Red 5mm)
    + Added COM-9592 (LED - Basic Green 5mm)
    + Added COM-9594 (LED - Basic Yellow 5mm)
    + Added COM-11372 (LED - Basic Blue 5mm)
    + Added COM-12704 (LED - Violet 5mm)
    I had made these before, but I redid them with Blender (they were SKPs
    before).
    [LED - Basic Blue 5mm.blend, LED - Basic Blue 5mm.stl, LED - Basic Green 5mm.blend, LED - Basic Green 5mm.stl, LED - Basic Red 5mm.blend, LED - Basic Red 5mm.stl, LED - Basic Yellow 5mm.blend, LED - Basic Yellow 5mm.stl]
2015-04-29 Optical Detectors
    + Added SEN-00241 (Infrared Emitters and Detectors) NOTE: the .blend
    has the two parts separate, but the .stl and .json have them together.
    + Added SEN-00246 (Optical Detector / Phototransistor - QRD1114)
    + Added SEN-09088 (Mini Photocell)
    + Added SEN-09299 (Photo Interrupter - GP1A57HRJ00F)
    + Added SEN-10266 (IR Receiver Diode - TSOP38238)
    + Added SEN-12566 (ALS-PT19 Light Sensor)+ Added COM-9590 (LED - Basic
    Red 5mm)
    Found as many of the optical detectors as I could, and modeled them.
    [ALS-PT19 Light Sensor.blend, ALS-PT19 Light Sensor.stl, IR Receiver Diode - TSOP38238.blend, IR Receiver Diode - TSOP38238.stl, Infrared Emitters and Detectors.blend, Infrared Emitters and Detectors.stl, Mini Photocell.blend, Mini Photocell.stl]
2015-04-30 Change component sizes
    Everything is now the proper size. The blue 5mm LED was already the
    proper size.
    [IR Receiver Diode - TSOP38238.blend, IR Receiver Diode - TSOP38238.stl, Infrared Emitters and Detectors.blend, Infrared Emitters and Detectors.stl, LED - Basic Blue 5mm.blend, LED - Basic Green 5mm.blend, LED - Basic Green 5mm.stl, LED - Basic Red 5mm.blend]
2015-04-30 More size changes
    The last size change, for the ALS-PT19 Light Sensor.
    [ALS-PT19 Light Sensor.blend, ALS-PT19 Light Sensor.stl]
2015-05-06 11015 Small solenoid
    [11015.IGS, 11015.SLDPRT, 11015.STEP, 11015.STL, 11015.blend]
2015-05-20 Bluetooth BLE mate2
    [SparkFun_BLEMate2.blend, SparkFun_BLEMate2.skp, SparkFun_BLEMate2.stl]
2015-05-20 10551 Small Stepper Motor
    [10551.IGS, 10551.SLDPRT, 10551.STEP, 10551.STL, 10551.blend]
2015-05-20 11840 LED Holder - 5mm
    [11840.IGS, 11840.SLDPRT, 11840.STEP, 11840.STL, 11840.blend]
2015-05-20 8084 Screw Terminals (file cleanup)
2015-05-20 8235 Screw Terminal (file cleanup)
2015-05-20 13169 Blackberry Trackballer
    [SparkFun_Blackberry_Trackballer_Breakout.brd]
2015-05-20 9032 Thumb Joystick
    [9032.IGS, 9032.SLDPRT, 9032.STEP, 9032.STL, 9032.blend]
2015-06-05 Update to production parts: connectors, switches, ICs
    [1X06-SIP_LOCK.IGS, 1X06-SIP_LOCK.SLDPRT, 1X06-SIP_LOCK.STEP, 1X06-SIP_LOCK.STL, 1X06-SIP_LOCK.skp, 1X08_LOCK.skp, 1X08_PTH.IGS, 1X08_PTH.SLDPRT]
2015-06-05 429 - DB9 connector, Female
    [429.STL, 429.blend, 429.skp]
2015-06-05 449 - RS232 Shifter
    [Sparkfun_RS232.blend, Sparkfun_RS232.skp, Sparkfun_RS232.stl]
2015-06-05 11895 - Header 1x8 Female PTH
    [11895.IGS, 11895.SLDPRT, 11895.STEP, 11895.STL, 11895.blend, 11895.skp]
2015-06-05 11896 - 1x10 Header Female, PTH
    [11896.IGS, 11896.SLDPRT, 11896.STEP, 11896.STL, 11896.blend, 11896.skp]
2015-06-05 119 - DC Power Barrel Jack
    [119.IGS, 119.SLDPRT, 119.STEP, 119.STL, 119.blend, 119.skp]
2015-06-05 12807 - 2x3 Header Male, PTH
    [12807.IGS, 12807.SLDPRT, 12807.STEP, 12807.STL, 12807.blend, 12807.skp]
2015-06-05 13099 - Rotary Switch Pot Breakout
    [Rotary_Switch_Potentiometer.blend, Rotary_Switch_Potentiometer.skp, Rotary_Switch_Potentiometer.stl]
2015-06-05 13229 - FreeSoC Dev Board
2015-06-05 102 - SPDT Slide Switch
    [102.IGS, 102.STEP, 102.STL, 102.blend, 102.skp, EG1218 Actuator.sldprt, EG1218 Housing.sldprt, EG1218A Terminals.sldprt]
2015-08-19 Production Parts - Connectors
    [1X12_STACKABLE.IGS, 1X12_STACKABLE.SLDPRT, 1X12_STACKABLE.STEP, 1X12_STACKABLE.STL, 1X12_STACKABLE.skp, AUDIO-JACK-_25-INCH-HORIZ-PTH.IGS, AUDIO-JACK-_25-INCH-HORIZ-PTH.SLDPRT, AUDIO-JACK-_25-INCH-HORIZ-PTH.STEP]
2015-08-19 13655 needs fix
    [SparkFun_SOIC8-DIP-Adapter.blend, SparkFun_SOIC8-DIP-Adapter.skp, SparkFun_SOIC8-DIP-Adapter.stl]
2015-08-19 Production Parts OLED display
    [OLED-0_66-64X48.IGS, OLED-0_66-64X48.SLDPRT, OLED-0_66-64X48.STEP, OLED-0_66-64X48.STL, OLED-0_66-64X48.skp]
2015-08-19 Production Parts - Passives
    [0805-CAP.skp, 1206-CAP.skp, CRYSTAL-32KHZ-SMD.IGS, CRYSTAL-32KHZ-SMD.SLDPRT, CRYSTAL-32KHZ-SMD.STEP, CRYSTAL-32KHZ-SMD.STL, CRYSTAL-32KHZ-SMD.skp]
2015-08-19 Production Parts - ICs: 16LPCC LGA14L LGA24 SI470X SOIC8 - SO08 alternate
    [16LPCC.IGS, 16LPCC.SLDPRT, 16LPCC.STEP, 16LPCC.STL, 16LPCC.skp, LGA14L_DOT_INDICATOR.IGS, LGA14L_DOT_INDICATOR.SLDPRT, LGA14L_DOT_INDICATOR.STEP]
2015-08-19 Production Parts - Stomp Switches
    [STOMP-SWITCH-3PDT.IGS, STOMP-SWITCH-3PDT.SLDPRT, STOMP-SWITCH-3PDT.STEP, STOMP-SWITCH-3PDT.STL, STOMP-SWITCH-3PDT.skp, STOMP-SWITCH-DPDT(REAL).skp, STOMP-SWITCH-DPDT.IGS, STOMP-SWITCH-DPDT.SLDPRT]
2015-08-19 10736 - 9DOF Razor
    [9DOF-Razor-v23.blend, 9DOF-Razor-v23.skp, 9DOF-Razor-v23.stl]
2015-08-19 11366 - Big Red Box (WIP)
    [11366_enclosure.SLDPRT, 11366_lid.SLDPRT]
2015-08-19 12938 - Si4703 Eval
    [Si4703_Eval.blend, Si4703_Eval.skp, Si4703_Eval.stl]
2015-08-19 13044 - Edison Raspberry Pi Block (needs fix)
    [Pi_Block.blend]
2015-08-19 13268 - Snappable Proto Board (Needs Fix)
    [SparkFun_Snappable_P-Board.blend, SparkFun_Snappable_P-Board.skp, SparkFun_Snappable_P-Board.stl]
2015-08-19 13284 LSM9DS1
    [SparkFun-LSM9DS1-Breakout.blend, SparkFun-LSM9DS1-Breakout.skp, SparkFun-LSM9DS1-Breakout.stl]
2015-08-19 13339 - LSM6DS3
    [LSM6DS3_Breakout.blend, LSM6DS3_Breakout.skp, LSM6DS3_Breakout.stl]
2015-08-19 13628 - Photon Micro OLED Shield
    [Photon_Micro_OLED_Shield.blend, Photon_Micro_OLED_Shield.skp, Photon_Micro_OLED_Shield.stl, Photon_Micro_OLED_Shield_w_headers.skp, Photon_Micro_OLED_Shield_w_headers.stl]
2015-08-19 9238 - Stepper motor (artifact)
    [9238.IGS, 9238.STEP, 9238.sldprt, 9238.stl]
2015-08-26 8449 vibration motor
    [8449.IGS, 8449.SLDPRT, 8449.STEP, 8449.STL, 8449.blend, Vibration Motor 8449 almost done needs wires.SLDPRT, Vibration Motor 8449.SLDPRT]
2015-08-26 731 110mAh lipo battery
    [731.IGS, 731.SLDPRT, 731.STEP, 731.STL, 731.blend]
2015-08-26 Cleanup - 246
    [Optical Detector : Phototransistor - QRD1114.blend, Optical Detector : Phototransistor - QRD1114.stl]
2015-08-26 1x12 SMD Connector for photon system
    [SPARK_PHOTON_TEMPLATE_WIDE_LOCKING.IGS, SPARK_PHOTON_TEMPLATE_WIDE_LOCKING.SLDPRT, SPARK_PHOTON_TEMPLATE_WIDE_LOCKING.STEP, SPARK_PHOTON_TEMPLATE_WIDE_LOCKING.STL, SPARK_PHOTON_TEMPLATE_WIDE_LOCKING.skp]
2015-08-26 PTH connector for Photon redboard
    [ARDUINO_R3_NOISP_LOCKING.skp]
2015-08-26 corrected reference data on connectors
    [DF40C-70DP-0_4_51_.skp, EDISON_DAUGHTER.skp]
2015-08-26 6mm PTH pushbutton
    [97.blend, TACTILE-PTH.IGS, TACTILE-PTH.SLDPRT, TACTILE-PTH.STEP, TACTILE-PTH.STL, TACTILE-PTH.skp]
2015-08-26 RGB LED PLCC-6
    [PLCC-6-LED.SLDPRT, PLCC-6-LED.STEP, PLCC-6-LED.STL, PLCC-6-LED.skp]
2015-08-26 IC packages
    [PLCC-6-LED.IGS, UFDFN-20.SLDPRT, UFDFN-20.STEP, UFDFN-20.STL]
2015-08-26 connector set for photon system
    [SPARK_PHOTON_TEMPLATE_WIDE.skp]
2015-08-26 RJ11 connector, 6-pin
    [RJ11-6.IGS, RJ11-6.SLDPRT, RJ11-6.STEP, RJ11-6.STL, RJ11-6.skp]
2015-08-26 Photon wireless module for redboard
    [WM-N-BM-14.IGS, WM-N-BM-14.SLDPRT, WM-N-BM-14.STEP, WM-N-BM-14.STL, WM-N-BM-14.skp]
2015-08-26 ICs for production assemblies
    [HTU21D.IGS, HTU21D.SLDPRT, HTU21D.STEP, HTU21D.STL, HTU21D.skp, LGA8.IGS, LGA8.SLDPRT, LGA8.STEP]
2015-08-26 97 - 6mm PTH pushbutton
    [97.IGS, 97.SLDPRT, 97.STEP, 97.STL, 97.blend, 97.skp]
2015-08-26 12757 rebuild
    [12757.blend, redboard-v21.stl]
2015-08-26 13038 - Edison GPIO block
    [GPIO_Block.blend, GPIO_Block.skp]
2015-08-26 13044 - Edison Raspberry Pi Block
2015-08-26 132 - RJ11 6-pin connector
    [132.IGS, 132.SLDPRT, 132.STEP, 132.STL, 132.blend, 132.skp]
2015-08-26 13321 - Photon Redboard
    [sparkfun-photon_p1.blend, sparkfun-photon_p1.skp]
2015-08-26 13328 - Photon Wearable Shield
    [SparkFun_Photon_Wearable_Shield.blend, SparkFun_Photon_Wearable_Shield.skp, SparkFun_Photon_Wearable_Shield.stl]
2015-08-26 13344 - Header, Female, 12-pin, SMD
    [13344.IGS, 13344.SLDPRT, 13344.STEP, 13344.STL, 13344.blend, 13344.skp]
2015-08-26 13598 - Photon Proto Shield
    [Photon_Proto_Shield.blend, Photon_Proto_Shield.skp, Photon_Proto_Shield.stl]
2015-08-26 13626 - Photon Battery Shield
    [Photon_20Battery_20Shield.blend, Photon_20Battery_20Shield.skp, Photon_20Battery_20Shield.stl]
2015-08-26 13629 - Photon IMU Shield
    [Photon-IMU-Shield.blend, Photon-IMU-Shield.skp, Photon-IMU-Shield.stl]
2015-08-26 13630 - Photon Weather Shield
    [SparkFun_Photon_Weather_Shield.blend, SparkFun_Photon_Weather_Shield.skp, SparkFun_Photon_Weather_Shield.stl]
2015-09-24 Production parts. SHT1X, QFN-28 variant
    [1X02_LONGPADS.skp, QFN-28.skp, SHT1X.IGS, SHT1X.SLDPRT, SHT1X.STEP, SHT1X.STL, SHT1X.skp]
2015-09-24 11351 Aluminum enclosure updates
    [11351_assembly.IGS, 11351_assembly.SLDASM, 11351_assembly.STEP, 11351_assembly.STL, 11351_body.SLDPRT, 11351_lid.SLDPRT]
2015-09-24 11366 Big Red Box changes and updates
    [11366_combined.SLDASM, 11366_enclosure.SLDPRT, 11366_lid.SLDPRT]
2015-09-24 13601 Sx1509 breakout
    [SparkFun-SX1509-Breakout.blend, SparkFun-SX1509-Breakout.skp, SparkFun-SX1509-Breakout.stl]
2015-09-24 13683 SHT15 Humidity/Temperature Sensor Breakout
    [SHT1x-Breakout.blend, SHT1x-Breakout.skp, SHT1x-Breakout.stl]
2015-09-24 Proto Petal (development)
    [Proto_Pedal_test.SLDPRT, Proto_Pedal_test_2.SLDPRT, stomp_box.SLDPRT, stomp_box.stl]
2016-01-20 Production Parts Reed Switch, Tactile Switch, Right Angle Switch
    [REED_SWITCH_PLASTIC.STEP, SWITCH-SPST-SMD-A.skp, TACTILE_SWITCH_SMD_4_6X2_8MM.IGS, TACTILE_SWITCH_SMD_4_6X2_8MM.SLDPRT, TACTILE_SWITCH_SMD_4_6X2_8MM.STEP, TACTILE_SWITCH_SMD_4_6X2_8MM.STL, TACTILE_SWITCH_SMD_4_6X2_8MM.skp]
2016-01-20 Production Parts
    [1206.skp, CRYSTAL-SMD-3_2X1_5MM.IGS, CRYSTAL-SMD-3_2X1_5MM.SLDPRT, CRYSTAL-SMD-3_2X1_5MM.STEP, CRYSTAL-SMD-3_2X1_5MM.STL, CRYSTAL-SMD-3_2X1_5MM.skp, CRYSTAL-SMD-3_2X2_5.IGS, CRYSTAL-SMD-3_2X2_5.SLDPRT]
2016-01-20 11366 basic, and with hole patterns
    [11366.skp, 11366_base-holes.SLDPRT, 11366_base-holes.stl, 11366_base-holes_bin.stl, 11366_base.STL, 11366_base.skp, 11366_combined.SLDASM, 11366_enclosure.IGS]
2016-01-20 Updates to 12481 and 12558
    [12481.SLDPRT, 12558.SLDPRT]
2016-01-21 Production Parts: Audio Jack mod, SOIC28, SSOP24
    [AUDIO-JACK.skp, SOIC28.IGS, SOIC28.SLDPRT, SOIC28.STEP, SOIC28.STL, SOIC28.skp, SSOP24.IGS, SSOP24.SLDPRT]
2016-01-21 13720 - incomplete, wrong .brd file
    [mp3-trigger-v23.blend, mp3-trigger-v23.skp, mp3-trigger-v23.stl]
2016-01-21 9065 sub micro servo
    [9065.IGS, 9065.SLDPRT, 9065.STEP, 9065.STL, 9065.blend]
2016-02-01 9816 OpAmp Breakout
    [SparkFun_OpAmp_Breakout-LMV358.blend, SparkFun_OpAmp_Breakout-LMV358.skp, SparkFun_OpAmp_Breakout-LMV358.stl]
2016-02-01 Production Parts Additions
    C0402
    TRIMPOT-3MM Name Clone from TRIMPOT-3MM-2
    [C0402.SKP, TRIMPOT-3MM.IGS, TRIMPOT-3MM.SLDPRT, TRIMPOT-3MM.STEP, TRIMPOT-3MM.STL, TRIMPOT-3MM.skp]
2016-02-03 additions to production_parts and products
    [BC127_Breakout.blend, BC127_Breakout.skp, BC127_Breakout.stl, BC127_XTRA_PASTE.IGS, BC127_XTRA_PASTE.SLDPRT, BC127_XTRA_PASTE.STEP, BC127_XTRA_PASTE.STL, MICRO-SD-SOCKET-PP.skp]
2016-02-03 Product and Production_Part Addition
    BC127 IC and Breakout Complete
    [BC127_Breakout.blend, BC127_Breakout.skp, BC127_Breakout.stl, BC127_XTRA_PASTE.SLDPRT, BC127_XTRA_PASTE.blend, BC127_XTRA_PASTE.skp]
2016-02-09 production_parts additions and revisions
    [BC127_XTRA_PASTE.skp, LQFP-48.SLDPRT, LQFP-48.STL, LQFP-48.skp, MICROSD_1_1.skp, NAV_SWITCH.IGS, NAV_SWITCH.SLDPRT, NAV_SWITCH.STEP]
2016-02-09 11927 BC127 Breakout
    Board Addition
    [BC127_Breakout.blend, BC127_Breakout.skp, BC127_Breakout.stl]
2016-02-10 13720 MP3 Trigger
    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
    [mp3-trigger-v23.blend, mp3-trigger-v23.skp, mp3-trigger-v23.stl, mp3-trigger.blend, mp3-trigger.skp]
2016-02-10 13033 9DOF and LGA-24 Additions
    [9dof_block.blend, 9dof_block.skp, LGA-24.SLDPRT, LGA-24.STL, LGA-24.skp]
2016-02-11 10524 Atmega328 Optiboot Uno
    [ATmega328_Optiboot_Uno.IGS, ATmega328_Optiboot_Uno.SLDPRT, ATmega328_Optiboot_Uno.STEP, ATmega328_Optiboot_Uno.STL, ATmega328_Optiboot_Uno.blend, ATmega328_Optiboot_Uno.skp]
2016-02-17 13037 Block for Intel Edison
    [Battery_Block.SLDPRT, Battery_Block.blend, Battery_Block.skp]
2016-02-17 10217 LiPo Charger Basic
    [SparkFun_Lipo_Charger_Basic-microUSB.blend, SparkFun_Lipo_Charger_Basic-microUSB.skp, SparkFun_Lipo_Charger_Basic-microUSB.stl, USB-AB-MICRO-SMD_V03.SKP]
2016-02-22 13175 Gripper Kit B
    [Gripper_Kit_B_SM.IGS, Gripper_Kit_B_SM.SLDPRT, Gripper_Kit_B_SM.STEP, Gripper_Kit_B_SM.STL, Gripper_Kit_B_SM.blend, Gripper_Kit_B_SM.skp]
2016-02-24 10168 Graphic LCD Nokia 5110
    [Graphic LCD Nokia 5110.SLDPRT, Graphic LCD Nokia 5110.STL, Graphic LCD Nokia 5110.blend, Graphic LCD Nokia 5110.skp]
2016-02-24 10124 RS485 Breakout Board
    [RS485_Breakout.blend, RS485_Breakout.skp, RS485_Breakout.stl]
2016-02-29 10975 Surface Transducer Large
    [Surface_Transducer_Large.IGS, Surface_Transducer_Large.SLDPRT, Surface_Transducer_Large.STEP, Surface_Transducer_Large.STL, Surface_Transducer_Large.blend, Surface_Transducer_Large.skp]
2016-03-01 Production Parts Additions
    [5-PIN-DIN-RA-PCB-NEW.SLDASM, 5-PIN-DIN-RA-PCB-NEW.SLDPRT, 5-PIN-DIN-RA-PCB-NEW.STL, 5-PIN-DIN-RA-PCB-NEW.skp, 8-SMD.IGS, 8-SMD.SLDPRT, 8-SMD.STEP, 8-SMD.STL]
2016-03-01 12898 MIDI Shield
    [SparkFun_MIDI_Shield.blend, SparkFun_MIDI_Shield.skp]
2016-03-03 13174 Standard Gripper Kit A
    [Standard_Gripper_Kit_A.IGS, Standard_Gripper_Kit_A.SLDPRT, Standard_Gripper_Kit_A.STEP, Standard_Gripper_Kit_A.STL, Standard_Gripper_Kit_A.blend, Standard_Gripper_Kit_A.skp]
2016-03-03 Minor Updates: Two Deleted Files and README Mod
    [Vibration Motor 8449 almost done needs wires.SLDPRT, Vibration Motor 8449.SLDPRT]
2016-03-07 13024 Intel Edison
    [Intel_Edison.SLDPRT, Intel_Edison.STL, Intel_Edison.blend, Intel_Edison.skp, Intel_Edison_(assembly) - Intel_Edison_(CI_board)-1.STL, Intel_Edison_(assembly) - Intel_Edison_(antenna)-1.STL, Intel_Edison_(assembly) - Intel_Edison_(assembled_antenna_connector)-1 Intel_Edison_(antenna_connector_1)-1.STL, Intel_Edison_(assembly) - Intel_Edison_(assembled_antenna_connector)-1 Intel_Edison_(antenna_con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]
2016-03-07 8184 Surface Mount Navigation Switch
    [NAV_SWITCH.IGS, NAV_SWITCH.SLDPRT, NAV_SWITCH.STEP, NAV_SWITCH.STL, NAV_SWITCH.blend, NAV_SWITCH.skp]
2016-03-09 11969 Metal Pushbutton Yellow Momentary
    [Metal_Pushbutton_Yellow.IGS, Metal_Pushbutton_Yellow.SLDPRT, Metal_Pushbutton_Yellow.STEP, Metal_Pushbutton_Yellow.STL, Metal_Pushbutton_Yellow.blend, Metal_Pushbutton_Yellow.skp]
2016-03-09 11974 Metal Pushbutton Yellow Latching
    [Metal_Pushbutton_Yellow.IGS, Metal_Pushbutton_Yellow.SLDPRT, Metal_Pushbutton_Yellow.STEP, Metal_Pushbutton_Yellow.STL, Metal_Pushbutton_Yellow.blend, Metal_Pushbutton_Yellow.skp]
2016-03-09 11966 Metal Pushbutton Red Momentary
    [Metal_Pushbutton_Red.IGS, Metal_Pushbutton_Red.SLDPRT, Metal_Pushbutton_Red.STEP, Metal_Pushbutton_Red.STL, Metal_Pushbutton_Red.blend, Metal_Pushbutton_Red.skp]
2016-03-09 11971 Metal Pushbutton Red Latching
    [Metal_Pushbutton_Red.IGS, Metal_Pushbutton_Red.SLDPRT, Metal_Pushbutton_Red.STEP, Metal_Pushbutton_Red.STL, Metal_Pushbutton_Red.blend, Metal_Pushbutton_Red.skp]
2016-03-09 11973 Metal Pushbutton Green Latching
    [Metal_Pushbutton_Green.IGS, Metal_Pushbutton_Green.SLDPRT, Metal_Pushbutton_Green.STEP, Metal_Pushbutton_Green.STL, Metal_Pushbutton_Green.blend, Metal_Pushbutton_Green.skp]
2016-03-09 11968 Metal Pushbutton Green Momentary
    [Metal_Pushbutton_Green.IGS, Metal_Pushbutton_Green.SLDPRT, Metal_Pushbutton_Green.STEP, Metal_Pushbutton_Green.STL, Metal_Pushbutton_Green.blend, Metal_Pushbutton_Green.skp]
2016-03-09 11972 Metal Pushbutton Blue Latching
    [Metal_Pushbutton_Blue.IGS, Metal_Pushbutton_Blue.SLDPRT, Metal_Pushbutton_Blue.STEP, Metal_Pushbutton_Blue.STL, Metal_Pushbutton_Blue.blend, Metal_Pushbutton_Blue.skp]
2016-03-09 11967 Metal Pushbutton Blue Momentary
    [Metal_Pushbutton_Blue.IGS, Metal_Pushbutton_Blue.SLDPRT, Metal_Pushbutton_Blue.STEP, Metal_Pushbutton_Blue.STL, Metal_Pushbutton_Blue.blend, Metal_Pushbutton_Blue.skp]
2016-03-09 11975 Metal Pushbutton White Latching
    [Metal_Pushbutton_Blue.blend, Metal_Pushbutton_White.IGS, Metal_Pushbutton_White.SLDPRT, Metal_Pushbutton_White.STEP, Metal_Pushbutton_White.STL, Metal_Pushbutton_White.blend, Metal_Pushbutton_White.skp]
2016-03-09 11970 Metal Pushbutton White Momentary
    [Metal_Pushbutton_White.IGS, Metal_Pushbutton_White.SLDPRT, Metal_Pushbutton_White.STEP, Metal_Pushbutton_White.STL, Metal_Pushbutton_White.blend, Metal_Pushbutton_White.skp]
2016-03-09 Adding Files to 11967
    [Metal_Pushbutton_Blue.blend]
2016-03-09 552 Battery Holder 4xAA
    [Battery_Holder_4xAA.SLDPRT, Battery_Holder_4xAA.STEP, Battery_Holder_4xAA.STL]
2016-03-10 9378 AVR 8 Pin ATtiny85
    [ATtiny85.IGS, ATtiny85.SLDPRT, ATtiny85.STEP, ATtiny85.STL, ATtiny85.blend, ATtiny85.skp]
2016-03-10 9378 STL Update
    [ATtiny85.STL]
2016-03-14 11441 7 Segment Display Product and Part
    [7-SEGMENT-4DIGIT-YOUNGSUN.IGS, 7-SEGMENT-4DIGIT-YOUNGSUN.SLDPRT, 7-SEGMENT-4DIGIT-YOUNGSUN.STEP, 7-SEGMENT-4DIGIT-YOUNGSUN.STL, 7-SEGMENT-4DIGIT-YOUNGSUN.skp, Serial-7-Segment-Display.blend, Serial-7-Segment-Display.skp, Serial-7-Segment-Display.stl]
2016-03-14 11442 7 Segment Display Blue
    [Serial-7-Segment-Display.blend, Serial-7-Segment-Display.skp, Serial-7-Segment-Display.stl]
2016-03-14 11443 7 Segment Display Yellow
    [Serial-7-Segment-Display.blend, Serial-7-Segment-Display.skp, Serial-7-Segment-Display.stl]
2016-03-14 11440 7 Segment Display Kelly Green
    [Serial-7-Segment-Display.blend, Serial-7-Segment-Display.skp, Serial-7-Segment-Display.stl]
2016-03-14 11629 7 Segment Display White
    [Serial-7-Segment-Display.blend, Serial-7-Segment-Display.skp, Serial-7-Segment-Display.stl]
2016-03-16 Repo Filename Clean Up
    [infrared_emitters_and_detectors.blend, infrared_emitters_and_detectors.stl, screwterminal_3_5mm_2.IGS, screwterminal_3_5mm_2.SLDPRT, screwterminal_3_5mm_2.STEP, screwterminal_3_5mm_2.STL, screwterminal_3_5mm_2.skp, screwterminal_3_5mm_3.IGS]
2016-03-16 Removal of Spaces from File Names
    [10168.SLDPRT, 10168.STL, 10168.blend, 10168.skp, 10168_2.blend, 102.sldprt, 10266.blend, 10266.stl]
2016-03-16 Repo Clean Up Deleting Duplicates with Spaces
    [ALS-PT19 Light Sensor.blend, ALS-PT19 Light Sensor.stl, EG1218 Actuator.sldprt, EG1218 Housing.sldprt, EG1218A Terminals.sldprt, Graphic LCD Nokia 5110.SLDPRT, Graphic LCD Nokia 5110.STL, Graphic LCD Nokia 5110.blend]
2016-03-16 Repo Clean Up of File Names
    [EG1218A_Terminals.sldprt, EG1218_Actuator.sldprt, EG1218_Housing.sldprt, Intel_Edison_(assembly) - Intel_Edison_(CI_board)-1.STL, Intel_Edison_(assembly) - Intel_Edison_(antenna)-1.STL, Intel_Edison_(assembly) - Intel_Edison_(assembled_antenna_connector)-1 Intel_Edison_(antenna_connector_1)-1.STL, Intel_Edison_(assembly) - Intel_Edison_(assembled_antenna_connector)-1 Intel_Edison_(antenna_connect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]
2016-03-24 Repo Cleanup of Duplicates and Spaces
    [32U4_Breakout.blend, 32U4_Breakout.skp, 32U4_Breakout.stl, 94.blend, 9DOF-Razor-v23.blend, 9DOF-Razor-v23.skp, 9DOF-Razor-v23.stl, 9dof_block.blend]
2016-03-24 Production_parts Cleanup of Files
    [0402-CAP.skp, 0402-RES.SKP, 0603-CAP.skp, 0603-LED-ALT1.SKP, 0603-RES.skp, 0603.skp, 0805-CAP.skp, 0805.skp]
2016-03-24 Repo Cleanup
    [32U4_Breakout.blend, 32U4_Breakout.skp, 32U4_Breakout.stl, 9DOF-Razor-v23.blend, 9DOF-Razor-v23.skp, 9DOF-Razor-v23.stl, 9dof_block.blend, 9dof_block.skp]
2016-03-24 Temporary Removal of 10121
    [IMU_Digital_Combo_Board_-_6_Degrees_of_Freedom_-_ITG3200_-_ADXL345.blend, IMU_Digital_Combo_Board_-_6_Degrees_of_Freedom_-_ITG3200_-_ADXL345.brd, IMU_Digital_Combo_Board_-_6_Degrees_of_Freedom_-_ITG3200_-_ADXL345.skp, IMU_Digital_Combo_Board_-_6_Degrees_of_Freedom_-_ITG3200_-_ADXL345.stl, IMU_Digital_Combo_Board_20_-_6_Degrees_of_Freedom_-_ITG3200_-_ADXL345.blend, IMU_Digital_Combo_Board_20_-_6_D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]
2016-03-24 Production Parts Updates
    [11544.SLDPRT, 13344.IGS, 13344.SLDPRT, 13344.STEP, 1X05_2_54MM.SLDPRT, 1X05_SMD.skp, 1X06-SIP_LOCK.IGS, 1X06-SIP_LOCK.SLDPRT]
2016-03-24 Fixes to Display Models
    [338.SLDPRT, 338.blend, 338.skp, 338.stl, 94.STL, 94.skp, 9570.skp, 9590.skp]
2016-03-30 13794 Blynk Board and Production_Parts additions
    [0603-RES_1.skp, 0805-CAP.skp, JST-2-PTH.SLDPRT, JST-2-PTH.STL, JST-2-PTH.skp, JST-2-SMD.SLDPRT, JST-2-SMD.STL, JST-2-SMD.skp]
2016-03-30 Display Changes 2
    [RN41.skp]
2016-03-30 Display Change and Additions
    [11351.blend, 11351_body.STL, 11351_lid.STL, 11351_top.blend, 11840.blend, SCHMALZHAUS_SOT89.skp, SO014.skp, SO08-EIAJ.skp]
2016-03-30 Production Parts Changes
    [8-SMD.IGS, 8-SMD.SLDPRT, 8-SMD.STEP, 8-SMD.STL, 8-SMD.skp, LGA-24.SLDPRT, LGA-24.STL, LGA-24.skp]
2016-03-30 Production Part Organization
    [97.blend, EG1218A_Terminals.sldprt, EG1218_Actuator.sldprt, EG1218_Housing.sldprt, KPS-1290.IGS, KPS-1290.SLDPRT, KPS-1290.STEP, KPS-1290.STL]
2016-03-30 Production Parts Organizing
    [0603-LED-ALT1.SKP, LED-0603.SKP, LED-1206-BOTTOM.skp, LED-1206-NO_SILK.skp, LED-1206.skp, LED-TRICOLOR-5050-IC.skp, LED-TRICOLOR-SMD.skp]
2016-03-30 Product changes
    [9088.stl, MICRO-SD-SOCKET-PP.skp, OpenLog.blend, OpenLog.skp, OpenLog.stl, boardpost.blend]
2016-03-30 Display File Clean Up
    [10168_2.blend, 10266.stl, 11189.blend, 9DOF-Razor-v23.blend, 9DOF-Razor-v23.skp, 9DOF-Razor-v23.stl, AVR-Pocket-Programmer.blend, AVR-Pocket-Programmer.skp]
2016-04-01 Display Revisions
    [12100.blend, 12101.blend, 12102.blend, ROB-12100.STL, ROB-12101.STL, noValue.brd]
2016-04-01 Color Changes to Display Files
    [12103.blend, 12104.blend, 12107.blend, 12108.blend, 12109.blend, ROB-12107.STL, model.stl]
2016-04-05 Display color changes to products
    [12110.blend, 12111.blend, 12112.blend, 12113.blend, 12114.blend, 12115.blend, 12117.blend, 12118.blend]
2016-04-05 12122 Display Changes
    [12122.blend, model.stl]
2016-04-05 8483 Product Addition Li-ion 2000mAh
    [8483.IGS, 8483.SLDPRT, 8483.STL, 8483.blend, 8483.skp, 8483.stl]
2016-04-06 Product Display Changes
    [12123.blend, 12124.blend, 12126.blend, 12127.blend, 8483.STL, ROB-12123.STL, ROB-12126.STL, model.stl]
2016-04-06 Display Changes
    [12128.blend, 12129.blend, 8483.stl, model.stl]
2016-04-07 Display changes and updates
    [12131.blend, 12133.blend, 12134.blend, 8483.stl, ROB-12131.STL, ROB-12134.STL, ROB-12134.obj, model.stl]
2016-04-12 Product 12171 Display Changes
    [12171.blend, model.stl]
2016-04-25 Product 339 Li-ion 1000mAh
    [339.IGS, 339.SLDPRT, 339.STL, 339.blend, 339.skp]
2016-04-25 Product 13813 Li-ion 1000mAh
    [13813.IGS, 13813.SLDPRT, 13813.STL, 13813.blend, 13813.skp]
2016-04-27 11288 Heating Pad 5x10 cm
    [11288.IGS, 11288.SLDPRT, 11288.STL, 11288.blend, 11288.skp]
2016-04-27 12923 SparkFun MicroView
    [12923.IGS, 12923.SLDPRT, 12923.STEP, 12923.STL, Sparkfun display.x_t]
2016-04-28 quick change
    [Sparkfun_display.x_t]
2016-05-02 Product 13733 Display Addition
    [13733_display.blend, 13733_display.skp]
2016-05-02 Product 13733 Display Addition and Mod
    [13733_display.skp, 13733_display.stl]
2016-05-03 Product 12291 change and display repo change
    [12291.blend, Serial-7-Segment-Display.blend, Serial-7-Segment-Display.skp, Serial-7-Segment-Display.stl, model.stl]
2016-05-03 Repo Display Changes
    [12292.blend, 12293.blend, 12294.blend, 12295.blend, 12296.blend, 12297.blend, 12298.blend, 12299.blend]
2016-05-06 Display Changes for Repo
    [0402-RES.SKP, 12301.blend, 12302.blend, 12303.blend, 12304.blend, 12305.blend, 12306.blend, 12307.blend]
2016-05-11 Repo Issue Fix .SKP to .skp
    [0402-RES.skp, 0603-LED-ALT1.skp, C0402.skp, EIA3216.skp, EIA3528.skp, EIA7343.skp, LED-0603.skp, POWER_JACK_SMD_OVERPASTE_REDBOARD_0603.skp]
2016-05-12 Products 13345 13764 13773
    To close out bug 12826
    [13345.SLDASM, 13345.SLDPRT, 13345.STL, 13345.blend, 13345.skp, 13764.SLDASM, 13764.SLDPRT, 13764.STL]
2016-05-12 13774 STL Orientation Change
2016-05-12 13345 and 13764 STL Orientation Change
2016-05-16 Display and File Name Changes
    [10168.blend, 11288.SLDPRT, 11288.blend, 11351.blend, 11351_top.blend, 12100.blend, 12101.blend, 12102.blend]
2016-05-19 Product 11792
    [11792.SLDPRT, 11792.STL, 11792.blend, 11792.skp]
2016-05-19 11792 STL orientation change
    [11792.STL]
2016-05-28 Repo Display Color Changes
    [12361.blend, 12362.blend, 12363.blend, 12364.blend, 12365.blend, 12366.blend, 12367.blend, 12368.blend]
2016-06-01 Product 12958 and Misc Components
    [CAPC0603.sldprt, ELECTRIC_IMP_IMP002.SLDPRT, ELECTRIC_IMP_IMP002.STL, ELECTRIC_IMP_IMP002.skp, Electric_Imp_imp002_Breakout.blend, LTST-C195KGJRKT.SLDPRT, LTST-C195KGJRKT.STL, LTST-C195KGJRKT.skp]
2016-07-11 Products 9067 9068 9066
    [1x6.SLDPRT, 1x6.STL, 9066.SLDPRT, 9066.STL, 9066.blend, 9066.skp, 9067.SLDPRT, 9067.STL]
2016-08-11 Product 13709 MyoWare Proto Shield
    [MyoWare_Proto_Shield.blend, MyoWare_Proto_Shield.skp, MyoWare_Proto_Shield.stl]
2016-08-11 Product 13687 MyoWare Cable Shield
    [MyoWare_Cable_Shield.blend, MyoWare_Cable_Shield.skp, MyoWare_Cable_Shield.stl]
2016-08-23 20 mm Coin Cell Battery Holder
    [BATTCON_20MM_4LEGS.IGS, BATTCON_20MM_4LEGS.SLDPRT, BATTCON_20MM_4LEGS.STL, BATTCON_20MM_4LEGS.skp]
2016-08-23 Product 13584 MyoWare Power Shield plus Coin Cell 20 mm Fix
    [BATTCON_20MM_4LEGS.skp, MyoWare_Power_Shield.blend, MyoWare_Power_Shield.skp, MyoWare_Power_Shield.stl]
2016-08-24 Product 13688 MyoWare LED Shield
    [LED_BAR_SMD.IGS, LED_BAR_SMD.SLDPRT, LED_BAR_SMD.STL, LED_BAR_SMD.skp, MyoWare_LED_Shield.skp, MyoWare_LED_Shield.stl, PLCC20S.skp, R0603.skp]
2016-09-15 LED5MM addition
    [LED5MM.SLDPRT, LED5MM.STL, LED5MM.skp]
2016-09-15 Spaces removed from files
    [RES0603.sldprt, UserLibrary_SDC08B.sldasm, UserLibrary_SDC08B_Fillet.sldprt, UserLibrary_SDC08B_Fusion.sldprt]
2016-09-26 Product 13723 Myoware Muscle Sensor
    [13723.SLDPRT, 13723.STL]
2016-09-26 Moved to Products Folder
    [13723.SLDPRT, 13723.STL]
2016-09-27 13723 Display Additions for MyoWare Muscle Sensor
    [13723.blend]
2016-09-28 Product 10976 10K Slide Pot
    [10976.SLDPRT, 10976.STL, 10976.blend]
2016-09-28 Product 11310 Toggle Switch with Cover
    [11310.blend, 11310.skp, 11310.stl]
2016-10-19 Product 11886
    [11886.IGS, 11886.SLDASM, 11886.SLDPRT, 11886.STL, 11886.blend, 11886.skp, 11886_bottom.SLDPRT, 11886_bottom.STL]
2016-10-25 Change of 9395 LCD
    [9395.SLDPRT]
2016-10-25 Product 9395 16x2 Serial Enabled LCD White on Black
    [9395..skp, 9395.SLDPRT, 9395.STL, 9395.blend, Serial_20LCD_20Backpack_20v28.blend, Serial_20LCD_20Backpack_20v28.skp, Serial_20LCD_20Backpack_20v28.stl]
2016-10-25 File changes made for storefront display
    [9395.SLDPRT]
2016-10-25 Product 9394 16x2 Serial LCD White on Black
    [9394.SLDPRT, 9394.STL, 9394.blend, 9394.skp, 9395..skp, 9395.SLDPRT, 9395.skp]
2016-10-25 Product 9393 16x2 LCD Black on Green and Changes
    [9393.SLDPRT, 9393.STL, 9393.blend, 9393.skp, 9394.SLDPRT, 9394.STL, 9394.blend, 9394.skp]
2016-11-09 Production_Part Folder Addition TQFO32-08.stl
    [TQFP32-08.skp, TQFP32-08.stl]
2016-11-17 Additions to Production Parts Folder
    QFN-48 and SC70
    [QFN-48.SLDPRT, QFN-48.STL, QFN-48.skp, QFN48-0_4MM.skp, SC70-6.skp]
2016-11-17 Product 13907 ESP32 Thing
    [esp32-thing.blend, esp32-thing.skp]
2016-11-17 Product 13678 WiFi Module ESP8266
    [13678.SLDPRT, 13678.STL, 13678.blend, 13678.skp]
2016-11-18 Products 13124 and 13967
    Protopedal and Case
    [13967.SLDPRT, 13967.STL, 13967.blend, 1X02_LONGPADS.skp, POWER-BARRELJACK-PTH-LOCK-FIXED.skp, STOMP-SWITCH-3PDT.SLDPRT, STOMP-SWITCH-3PDT.STL, STOMP-SWITCH-3PDT.skp]
2016-11-18 Product 13884 LED Driver Breakout
    [LED-TRICOLOR-5050.skp, LP55231_breakout.blend, LP55231_breakout.skp, LP55231_breakout.stl, WQFN-24.skp]
2016-11-22 Product 11231 LiPo Charger/Booster
    [PowerCell-v13.blend, PowerCell-v13.skp, PowerCell-v13.stl, QFN-10_PAD.skp]
2016-11-22 Product 13990 and some Production_Parts Additions
    [0402-RES.skp, 0402.skp, 0603-CAP.skp, 0603-RES_1.skp, 0603.skp, 0805-CAP.skp, 0805.skp, 1206-CAP.skp]
2016-11-22 Product 13911 Serial Controlled Motor Drive plus Production_Parts
    [QFN-40.skp, SOT-23-5-VREG.skp, Serial_20Controlled_20Motor_20Driver.blend, Serial_20Controlled_20Motor_20Driver.json, Serial_20Controlled_20Motor_20Driver.skp, Serial_20Controlled_20Motor_20Driver.stl, UserLibrary_SDC08B.sldasm, UserLibrary_SDC08B_Fillet.sldprt]
2016-11-22 Product 12639 Audio Jack 3.5mm
    [12639.SLDPRT, 12639.STL, 12639.blend, 12639.skp]
2016-11-23 Product 13944 9DoF Sensor Stick
    [SparkFun_9DoF_Sensor_Stick.blend, SparkFun_9DoF_Sensor_Stick.skp, SparkFun_9DoF_Sensor_Stick.stl]
2016-11-23 Prorduct 13879 Load Cell Amp and SSOP16L
    [SOP-16L.SLDPRT, SOP-16L.STL, SOP-16L.skp, SparkFun_HX711_Load_Cell.blend, SparkFun_HX711_Load_Cell.skp, SparkFun_HX711_Load_Cell.stl]
2016-11-23 Product 13878 Load Sensor Combinator
    [SparkFun_20Load_20Sensor_20Combinator.blend, SparkFun_20Load_20Sensor_20Combinator.skp, SparkFun_20Load_20Sensor_20Combinator.stl]
2016-11-23 Products 12758 Electret Mic Breakout and 8635 Electret Mic
    [8635.SLDPRT, 8635.STL, 8635.blend, 8635.skp, Electret_Microphone_Breakout.blend, Electret_Microphone_Breakout.skp, Electret_Microphone_Breakout.stl, MIC-9_7MM.skp]
2016-11-23 Product 13118 Servo Trigger and Product 13872 Cont Servo Trigger
    [SparkFun_Servo_Trigger.blend, SparkFun_Servo_Trigger.json, SparkFun_Servo_Trigger.skp, SparkFun_Servo_Trigger.stl]
2016-11-23 Product 13231 ESP8266 Thing
    [SparkFun_ESP8266_Thing.blend, SparkFun_ESP8266_Thing.skp, SparkFun_ESP8266_Thing.stl]
2016-11-29 Additions and Updates
    [SO014.skp, SO08-EIAJ.skp, SO08-TIGHT.skp, SO08.skp, SO14.skp, SOIC-28.IGS, SOIC-28.SLDPRT, SOIC-28.STEP]
2016-11-29 Product 13777 Battery Babysitter plus Production Parts created
    [DIPSWITCH-02-50MIL.SLDPRT, DIPSWITCH-02-50MIL.STL, DIPSWITCH-02-50MIL.skp, LED-0603.skp, PDSO-N12.SLDPRT, PDSO-N12.STL, PDSO-N12.skp, PVQFN-N16.skp]
2016-11-30 Product 13762 3D Model
    [QFN24_PAD.skp, SparkFun_MPU-9250_Breakout.blend, SparkFun_MPU-9250_Breakout.skp, SparkFun_MPU-9250_Breakout.stl]
2016-11-30 Product 13906 Multiplexer and Production_Part Addition
    [DHVQFN-16-2_5X3_5MM.SLDPRT, DHVQFN-16-2_5X3_5MM.STL, DHVQFN-16-2_5X3_5MM.skp, SparkFun-74HC4051-8-Channel-Mux-Breakout.blend, SparkFun-74HC4051-8-Channel-Mux-Breakout.skp, SparkFun-74HC4051-8-Channel-Mux-Breakout.stl]
2016-12-02 Product 13261 Open Scale and Production_Parts Additions
    [OpenScale.blend, SCREWTERMINAL-3_5MM-3_LOCK_007S.skp, SCREWTERMINAL-3_5MM-5.SLDPRT, SCREWTERMINAL-3_5MM-5.STL, SCREWTERMINAL-3_5MM-5.skp, TACTILE-SWITCH-1101NE.skp]
2016-12-02 Product 12231 OpenScale and Production Parts
    [CDRH2D09.SLDPRT, CDRH2D09.STL, CDRH2D09.skp, PowerCell-v13.blend, PowerCell-v13.brd, PowerCell-v13.sch, PowerCell-v13.skp, PowerCell-v13.stl]
2016-12-02 Product 11231 Power Cell LiPo and Production Parts
    [CDRH2D09.SLDPRT, CDRH2D09.STL, CDRH2D09.skp, PowerCell-v13.blend, PowerCell-v13.brd, PowerCell-v13.sch, PowerCell-v13.skp, PowerCell-v13.stl]
2016-12-02 Product 11231 PowerCell
    [PowerCell-v13.blend, PowerCell-v13.brd, PowerCell-v13.sch]
2016-12-07 Add seemingly successfully generated STL files previously missing.
    Generated via batch operation, verified sane-looking with Pleasant3D.
    [0402-CAP.stl, 0402-RES.stl, 0603-LED-ALT1.stl, 0603-RES.stl, 0603-RES_1.stl, 0603.stl, 0805-CAP.stl, 0805.stl]
2016-12-07 Add previously missing generated STL file. Possibly upside down.
    Generated via batch operation, appears upside down with Pleasant3D.
2016-12-07 Add more previously missing generated STL file. Faulty, missing faces.
    Generated via batch operation, Pleasant3D shows missing faces.
    Committing for completeness. Faulty probably due to face orientated incorrectly in SketchUp.
    Some have appropriate replacements, others need to be fixed and re-generated.
    [0402.stl, 0603-CAP.stl, 1210.stl, EIA3528.stl]
2016-12-07 Produt 13762 MPU 9250
    [13762.blend]
2016-12-12 Production Part Additions
    [0603.skp, 0603a.skp, LED-0603.skp, QFN24-3X3.skp]
2016-12-12 Product 14001 9DOF Razor
    [sparkfun-9dof-razor-imu.blend, sparkfun-9dof-razor-imu.skp]
2016-12-14 Product 14021 RJ11 Breakout
    [RJ11-Breakout.blend, RJ11-Breakout.skp, RJ11-Breakout.stl, RJ11.skp]
2016-12-14 Product 13926 Triple Axis MMA8452Q plus Production Part
    [QFN-16_0_5MM.SLDPRT, QFN-16_0_5MM.STL, QFN-16_0_5MM.skp, SparkFun_MMA8452Q-Breakout.blend, SparkFun_MMA8452Q-Breakout.skp, SparkFun_MMA8452Q-Breakout.stl]
2016-12-27 Product 258 Serial Enabled LCD Backpack
    [SO18_wide.skp, SO18_wide.stl, Serial_20LCD_20Backpack_20v28.blend, Serial_20LCD_20Backpack_20v28.skp, Serial_20LCD_20Backpack_20v28.stl]
2016-12-27 Product 13733 Raspberry Pi LCD Dimension Changes
    [13733_display.blend, 13733_display.skp, 13733_display.stl]
2016-12-27 Product 498 SSOP to DIP Adapter 16 Pin
    [498.blend, 498.stl, SparkFun_SSOP16_Breakout_v10.blend, SparkFun_SSOP16_Breakout_v10.skp, sparkfun_ssop16_breakout_v10.stl]
2016-12-27 Product 499 SparkFun SSOP to DIP Adapter 20 Pin
    [SparkFun_Adapter-SSOP20-v10.blend, SparkFun_Adapter-SSOP20-v10.skp, SparkFun_Adapter-SSOP20-v10.stl]
2016-12-27 Product 500 SSOP28 DIP Adapter
    [SparkFun_SSOP28-DIP-Adapter-v12.blend, SparkFun_SSOP28-DIP-Adapter-v12.skp, SparkFun_SSOP28-DIP-Adapter-v12.stl, boardpost.blend, sparkfun_ssop28_dip_adapter_v12.blend, sparkfun_ssop28_dip_adapter_v12.skp, sparkfun_ssop28_dip_adapter_v12.stl]
2016-12-27 Product 544 microSD Breakout
    [SparkFun_microSD_Breakout.blend, SparkFun_microSD_Breakout.skp, SparkFun_microSD_Breakout.stl]
2016-12-27 Product 527 Voltage Regulator Adjustable
    [527.SLDPRT, 527.STL, 527.blend, 527.skp]
2016-12-27 Product 573 SparkFun SIM Card Socket Breakout
    [SIMHOLDER2.skp, Sim_Breakout.blend, Sim_Breakout.skp, Sim_Breakout.stl]
2016-12-27 Product 691 SparkFun Transceiver Breakout - nRF24L01+
    [ANTENNA-CHIP5.SLDPRT, ANTENNA-CHIP5.STL, ANTENNA-CHIP5.skp, QFN20_ALT1.skp, SparkFun_Tranceiver_Breakout-nRF24L01.blend, SparkFun_Tranceiver_Breakout-nRF24L01.skp, SparkFun_Tranceiver_Breakout-nRF24L01.stl]
2016-12-29 Product 717 DIP Adapter
    [SparkFun_SOT23-DIP-Adapter-v10.blend, SparkFun_SOT23-DIP-Adapter-v10.skp, SparkFun_SOT23-DIP-Adapter-v10.stl]
2016-12-29 Product 762 USB Bit Whacker
    [USB_Bit_Whacker-18F2553.blend, USB_Bit_Whacker-18F2553.skp]
2016-12-29 Product 8033 Button Pad Breakout
    [Button_Pad_Breakout-v05.blend, Button_Pad_Breakout-v05.skp, Button_Pad_Breakout-v05.stl]
2016-12-29 Product 8276 SparkFun XBEE Breakout
    [SparkFun_XBee-Breakout.blend, SparkFun_XBee-Breakout.skp, SparkFun_XBee-Breakout.stl]
2016-12-29 Product 8688 TEMPT6000 Breakout
    [SparkFun_TEMT6000_Breakout-v12.blend, SparkFun_TEMT6000_Breakout-v12.skp, SparkFun_TEMT6000_Breakout-v12.stl]
2016-12-29 Product 8780 RS232
    [Sparkfun_RS232.blend, Sparkfun_RS232.skp, Sparkfun_RS232.stl]
2016-12-29 Product 8883 ACS712 Low Current Sensor Board
    [SparkFun_ACS712LowCurrentSensorBoard.blend, SparkFun_ACS712LowCurrentSensorBoard.skp, SparkFun_ACS712LowCurrentSensorBoard.stl]
2017-01-09 Product 11864 Deans Male and Female
    [Deans-Female.SLDPRT, Deans-Female.STEP, Deans-Female.STL, Deans-Female.blend, Deans-Female.skp, Deans-Male.SLDPRT, Deans-Male.STEP, Deans-Male.STL]
2017-01-09 Product 13963 LIS3DH Breakout
    [LGA-16-3X3.SLDPRT, LGA-16-3X3.STL, LGA-16-3X3.skp, LGA-16_3x3x1mm-L.stp, LGA-16_3x3x1mm-M.stp, LGA-16_3x3x1mm.SLDPRT, LGA-16_3x3x1mm.stp, SparkFun_LIS3DH-Breakout.blend]
2017-01-10 Product 8891 Gas Sensor Breakout
    [Gas_Sensor_Breakout-v12.blend, Gas_Sensor_Breakout-v12.skp, Gas_Sensor_Breakout-v12.stl]
2017-01-10 Product 9277 2x2Button Pad Breakout
    [2x2Button_Pad_Breakout-v01.blend, 2x2Button_Pad_Breakout-v01.skp, 2x2Button_Pad_Breakout-v01.stl]
2017-01-10 Product 9116 PhotoInterrupter Breakout
    [PhotoInterrupter-Breakout.blend, PhotoInterrupter-Breakout.skp, PhotoInterrupter-Breakout.stl]
2017-01-10 Product 9352 LCD Backpack
    [Graphic_20LCD_20Backpack.blend, Graphic_20LCD_20Backpack.skp, Graphic_20LCD_20Backpack.stl]
2017-01-10 Product 9419 MicroSD Sniffer
    [LGA-16-3X3.STL, SparkFun_MicroSD_Sniffer.blend, SparkFun_MicroSD_Sniffer.skp, SparkFun_MicroSD_Sniffer.stl]
2017-01-10 Product 9536 5 Pin Din Female
    [9536.SLDASM, 9536.SLDPRT, 9536.STL, 9536.blend, 9536.skp]
2017-01-11 Product 9713 UBW32
    [PTC-1206 - Copy.skp, PTC-1206-WIDE.skp, R1206.skp, S2B-PH.skp, TQFP100.skp]
2017-01-11 Product 9716 FTDI Basic 5V
    [FTDI_20Basic-5V.blend, FTDI_20Basic-5V.skp, FTDI_20Basic-5V.stl, LED-0603.skp]
2017-01-16 Product 790 16X2 LCD Display
    [1602_LCD.SLDASM, 1602_LCD.SLDPRT, 1602_LCD.STL, 1602_LCD.skp, 1602_LCD_metalcasing.SLDASM, 1602_lcd.blend, LCD.SLDPRT, LCD_PCB.SLDPRT]
2017-01-16 Product 12642 Sound Detector and SOD-523
    [SO014.skp, SOD-323.SLDPRT, SOD-323.STL, SOD-323.skp, SOD-523.SLDPRT, SOD-523.STL, SOD-523.skp, sound-detector.blend]
2017-01-16 Product 9457 SparkFun Motor Driver
    [SparkFun_Motor_Driver-TB6612FNG.blend, SparkFun_Motor_Driver-TB6612FNG.json, SparkFun_Motor_Driver-TB6612FNG.skp, SparkFun_Motor_Driver-TB6612FNG.stl]
2017-01-17 Product 12002 Breadboard White
    [12002.SLDASM, 12002.SLDPRT, 12002.blend, 12002.skp, BREADBOARD_350_POS_CENTER.sldprt, BREADBOARD_350_POS_SIDE.sldprt]
2017-01-17 Product 12062 5mm LEDs
    [12062.SLDPRT, 12062.STL, 12062.blend, 12062.skp, 12062_2.stl]
2017-01-17 Product 9264 LED RGB
    [9264.SLDPRT, 9264.blend, 9264.skp, 9264.stl]
2017-01-19 Add new batch of exported models.
    These have been verified as not being obviously wrong via Pleasant3D viewer.
    [0603.stl, PVQFN-N16.stl, QFN20_ALT1.stl, QFN24-3X3.stl, QFN24_PAD.stl, R1206.stl, RJ11.stl, S2B-PH.stl]
2017-01-19 Add another generated STL file. Faulty, missing a face.
    [0603a.stl]
2017-01-19 Dimension Issue Fix for Part QFN24-3X3
    [QFN24-3X3.SLDPRT, QFN24-3X3.STL, QFN24-3X3.skp, sparkfun-9dof-razor-imu.blend, sparkfun-9dof-razor-imu.skp]
2017-01-19 Product 13225 SparkFun XBee Serial Explorer
    [0603-CAP-2.skp, 0603.skp, LED-0603.skp, SparkFun_XBee_Serial_Explorer.blend, SparkFun_XBee_Serial_Explorer.skp, sparkfun-9dof-razor-imu.blend, sparkfun-9dof-razor-imu.skp]
2017-01-23 Hopefully completes previous merge. Case sensitivity issue.
    New file from merge had a capitalised `.STL` extension so it
    was missed on OS X.
    File in question: production_parts/semiconductors/IC_SMD/QFN/QFN-24/stl/QFN24-3X3.STL
    [QFN24-3X3.stl]
2017-01-23 Attempt to deal with case sensitivity issue.
    Deleting old file via GitHub web interface.
    [QFN24-3X3.stl]
2017-01-23 Add STL export for updated LED-0603 version which fixes missing face.
    [LED-0603.stl]
2017-01-23 Add new STL export for SF model update.
    [0603-CAP-2.stl]
2017-01-23 Remove obsolete model.
    [LED-0603.stl]
2017-01-24 Resistor Products
    11507 and 8377 - 300 Ohm Resistor
    11508 and 8374 - 10K Ohm Resistor
    [11507.SLDPRT, 11507.STL, 11507.blend, 11507.skp, 11507_large.blend, 11508.SLDPRT, 11508.STL, 11508.blend]
2017-02-21 Product 12757 and 13975 Added and Fixed
    [1X06_SMD_STRAIGHT_COMBO.skp, 1X08_SMD_COMBINED.skp, RedBoard.blend]
2017-02-22 Fixing Display of MicroView OLED 12923
    [12923.STL, 12923.blend]
2017-02-22 Product 12125 Micro Gearmotor
    [12125.SLDPRT, 12125.STL, 12125.blend, 12125.skp, 12125_resized.blend, motor.SLDPRT, n20 motor.SLDASM, n20_gearbox.SLDPRT]
2017-02-22 Product 533 Red LED 3mm
    [533.SLDPRT, 533.STL, 533.blend, 533.skp]
2017-05-08 Product 13656 Main Files
    [13656.IGS, 13656.SLDPRT, 13656.STL, 13656.blend, 13656.skp, 13656a.IGS, 13656a.SLDPRT, 13656a.STL]
2017-05-08 Changes to Display File
    [13656.STL, 13656.blend, 13656.skp, 13656a.STL]
2017-06-05 Product 9568 Serial Enabled 20x4 Display
    [9568.SLDPRT, 9568.STEP, 9568.STL, 9568.blend, 9568.skp, 9568_skp.stl]
2017-06-15 Spectacle Button Board
    [AUDIO-JACK.skp, AUDIO_JACK_3_5MM_TRRS_SMD_RA.SLDPRT, AUDIO_JACK_3_5MM_TRRS_SMD_RA.STL, AUDIO_JACK_3_5MM_TRRS_SMD_RA.skp, QFN-32.skp, Spectacle_Button_Board.blend, Spectacle_Button_Board.skp, Spectacle_Button_Board.stl]
2017-06-15 14052 Spectacle LED Control Board
    [Spectacle_LED_Control_Board.blend, Spectacle_LED_Control_Board.skp]
2017-06-15 13992 Spectacle Inertia Board
    [ADXL3451_1.skp, Spectacle_Accelerometer_Input_Board.blend, Spectacle_Accelerometer_Input_Board.skp, Spectacle_Accelerometer_Input_Board.stl]
2017-06-17 14034 Spectacle Audio Output Board
    [Spectacle_Audio_Output_Board.blend, Spectacle_Audio_Output_Board.skp]
2017-06-17 13912 Spectacle Director Board
    [Spectacle_Director_Board.blend, Spectacle_Director_Board.skp]
2017-06-17 13993 Spectacle Motion Board
    [Spectacle_Motion_Board.blend, Spectacle_Motion_Board.skp, USB-B-MICRO-SMD_V03_RED_PASTE.skp]
2017-08-07 Product 12035 Micro USB AB
    [Breakout_20Board_20for_20USB_20microB.blend, Breakout_20Board_20for_20USB_20microB.skp, Breakout_20Board_20for_20USB_20microB.stl]
2017-08-08 product 9347 servo motor
    [9347.SLDASM, 9347.SLDPRT, 9347.STL, 9347.blend, 9347.skp, Embout.SLDPRT, Embout.STL, Part1.STL]
2017-08-09 product 13288 kit teensy
    [BATTCON_12MM_PTH.skp, CPOL-RADIAL-10UF-25V.SLDPRT, CPOL-RADIAL-10UF-25V.STL, CPOL-RADIAL-10UF-25V.skp, TEENSY-3_1.skp, TO-220-ALT.skp, Teensy_3_1.stp]
