sparkfun/3D_Models/(notices)

Notices in the files:
parts and their libraries:
SparkFun-Passives: Licensing: CC v3.0 Share-Alike You are welcome to use this library for commercial purposes.
SparkFun-Aesthetics: Released under the Creative Commons Attribution Share-Alike 3.0 License
SparkFun-Aesthetics: http://creativecommons.org/licenses/by-sa/3.0
